baobuibk/SpaceLiinTech_BEE_DAL_OBC_HW/03_BOM/DAL_OBC_V11.xlsx

Line # | Name | Description | Designator | Quantity | Footprint | Manufacturer 1 | Manufacturer Part Number 1
_LED_REDLED_0603 | _LED_RED | LED RED CLEAR 0603 SMD | D3, D17, D25, DS6, D11, D12, DS4, D2, D10, D19, D20, DS5, DS1, DS2, DS3 | 15 | LED_0603 | Wurth Electronics | 150060YS75000 | 0
0RRES_C_1005x30_L | 0R | RES | R3, R4, R8, R32, R36, R263, R264, R265, R266, R267, R317, R413 | 12 | RES_C_1005x30_L | YAGEO | RC0402JR-070RL | RES 0 OHM JUMPER 1/16W 0402
0.1uF/10VCAP_C_0603x30 | 0.1uF/10V | CAP | C20, C21, C22, C23, C24, C25, C26, C27, C28, C29, C30, C31, C32, C33, C35, C36, C37, C38, C39, C40, C41, C42, C43, C44, C45, C46, C47, C48, C49, C52, C53, C54, C56, C58, C59, C60, C63, C66, C67, C68, C77, C78, C79, C80, C81, C82, C83, C84, C85, C86, C87, C88, C89, C90, C91, C92, C93, C94, C96, C97, C98, C99, C100, C101, C102, C103, C104, C105, C106, C107, C109, C110, C111, C112, C113, C114, C116, C117 | 78 | CAP_C_0603x30 | Murata Electronics | GRM033C71C104ME14D | CAP CER 0.1UF 16V X7S 0201
0.1uF/10VCAP_C_1005X50_L | 0.1uF/10V | CAP, CAP CHIP | C5, C6, C17, C18, C57, C69, C71, C72, C73, C74, C75, C119, C122, C123, C124, C125, C126, C127, C128, C129, C132, C133, C134, C135, C136, C138, C146, C147, C148, C149, C150, C151, C153, C154, C164, C165, C167, C168, C170, C171, C180, C213, C214, C215, C216, C217, C218, C219, C220, C221, C222, C224, C249, C250, C251, C252, C253, C254, C256, C257, C260, C261, C262, C281, C283, C284, C285, C287, C288, C289, C290, C292, C293, C294, C295, C296, C297, C298 | 78 | CAP_C_1005X50_L | Samsung Electro-Mechanics | CL05B104KA5NNNC | CAP CER 0.1UF 25V X7R 0402
1kRES_C_1005x30_L | 1k | RES | R5, R159, R160, R230, R231, R232, R244, R246, R247, R318, R320, R327, R356, R369, R381, R382, R404, R419, R423, R428, R431, R455, R518 | 23 | RES_C_1005x30_L | Panasonic | ERJ-2RKF1001X | RES SMD 1K OHM 1% 1/10W 0402
1M 1%RES_C_1005x30_L | 1M 1% | RES | R35 | 1 | RES_C_1005x30_L | YAGEO | RC0402FR-071ML | 1M 0402
1uF/20VCAP_C_1005X50_L | 1uF/20V | CAP CHIP, CAP | C141, C152, C156, C157, C158, C159, C160, C161, C175, C179, C181, C182, C183, C184, C185, C186, C199, C200, C201, C202, C203, C204, C205, C206, C255, C286, C291, C118, C137, C139, C140, C155, C192, C276, C142, C143, C144, C145, C228, C246, C270 | 41 | CAP_C_1005X50_L | Holy Stone Enterprise Co., Ltd. | C0402B105K025T | CAP CER 1UF 25V X5R 0402
1.6kRES_C_1005x30_L | 1.6k | RES | R304, R344, R438, R313, R446 | 5 | RES_C_1005x30_L | Panasonic | ERJ-2RKF1601X | RES SMD 1.6K OHM 1% 1/10W 0402
2.2nF/10VCAP_C_1005X50_L | 2.2nF/10V | CAP | C229, C230, C247, C248, C271, C272, C195, C196, C277, C278 | 10 | CAP_C_1005X50_L | Samsung Electro-Mechanics | CL05B222KB5NNNC | CAP CER 2200PF 50V X7R 0402
3.24kRES_C_1005x30_L | 3.24k | RES | R302, R309, R314, R451, R311, R326, R445 | 7 | RES_C_1005x30_L | Vishay Dale | CRCW04023K24FKED | RES 3.24K OHM 1% 1/16W 0402
4.02kRES_C_1005x30_L | 4.02k | RES | R28 | 1 | RES_C_1005x30_L | Panasonic Industry | ERA-2AEB4021X | RES SMD 4.02KOHM 0.1% 1/16W 0402
4.7kRES_C_1005x30_L | 4.7k | RES | R1, R2, R107, R124, R207, R208, R209, R210, R218, R219, R220, R221, R233, R234, R238, R239, R240, R241, R248, R249, R250, R251, R252, R253, R256, R257, R258, R261, R279, R280, R351, R352, R9, R157, R245, R388, R473, R474, R475, R476, R480, R481, R510, R511 | 44 | RES_C_1005x30_L | Vishay Dale | CRCW04024K70FKED | RES 4.7K OHM 1% 1/16W 0402
4.7nF/50VCAP_C_1608X80 | 4.7nF/50V | CAP | C166 | 1 | CAP_C_1608X80 | Samsung Electro-Mechanics | CL10B472KB8NNNC | CAP CER 4700PF 50V X7R 0603
4.7uF/10VCAP_C_1005X50_L | 4.7uF/10V | CAP | C1, C3, C4, C7, C9, C11, C14, C15, C16, C19, C34, C50, C51, C61, C64, C76, C95, C108, C115, C120, C121, C130, C131, C162, C163, C169, C173, C174, C187, C188, C197, C198, C207, C208, C211, C212, C13, C223, C263, C264, C265, C266 | 42 | CAP_C_1005X50_L | Murata Electronics | GRM155R61A475MEAAD | CAP CER 4.7UF 10V X5R 0402
10kRES_C_1005x30_L | 10k | RES | R6, R7, R10, R11, R14, R16, R20, R38, R60, R79, R80, R113, R114, R117, R134, R136, R144, R145, R153, R154, R155, R161, R162, R163, R164, R165, R166, R167, R168, R169, R170, R171, R172, R225, R226, R229, R254, R255, R290, R291, R310, R316, R319, R321, R337, R342, R345, R346, R347, R349, R350, R357, R406, R408, R409, R416, R417, R420, R424, R429, R432, R443, R452, R504, R505, R506, R507, R421, R425, R426, R464, R479, R484, R487, R488, R491, R494, R497, R500, R508, R509, R516 | 82 | RES_C_1005x30_L | Panasonic | ERJ-2RKF1002X | RES SMD 10K OHM 1% 1/10W 0402
16.9kRES_C_0603x30 | 16.9k | RES | R24, R27 | 2 | RES_C_0603x30 | Panasonic Electronic Components | ERJ-1GNF1692C | RES SMD 16.9K OHM 1% 1/20W 0201
 | 16.5k | RES | R216, R217, R283 | 3 | RES_C_1005x30_L | Panasonic Industry | ERJ-2RKF1652X | RES SMD 16.5K OHM 1% 1/10W 0402
18pF/10VCAP_C_1005X50_L | 18pF/10V | CAP | C55, C62, C65, C70, C238, C240, C242 | 7 | CAP_C_1005X50_L | KEMET | CBR04C180F5GAC | CAP CER 18PF 50V C0G/NP0 0402
20kRES_C_1005x30_L | 20k | RES | R25, R26 | 2 | RES_C_1005x30_L | YAGEO | RC0402FR-0720KL | RES 20K OHM 1% 1/16W 0402
22RRES_C_1005x30_L | 22R | RES | R37, R39, R40, R41, R42, R43, R44, R45, R46, R47, R48, R49, R50, R51, R52, R53, R55, R56, R58, R59, R61, R62, R63, R64, R65, R66, R67, R68, R69, R70, R71, R72, R73, R74, R75, R76, R77, R78, R82, R85, R86, R87, R92, R95, R96, R97, R98, R99, R100, R101, R102, R104, R106, R109, R110, R111, R112, R116, R118, R120, R121, R122, R125, R126, R127, R129, R130, R131, R132, R135, R137, R138, R139, R140, R141, R142, R143, R146, R147, R148, R149, R150, R151, R173, R174, R175, R176, R177, R178, R179, R180, R181, R182, R183, R184, R185, R186, R187, R188, R189, R190, R191, R192, R193, R194, R195, R196, R197, R198, R199, R200, R201, R202, R203, R204, R205, R206, R213, R214, R215, R223, R227, R243, R268, R269, R270, R271, R272, R273, R274, R275, R276, R284, R285, R286, R287, R292, R293, R294, R295, R296, R297, R315, R329, R330, R331, R332, R333, R334, R335, R336, R353, R354, R355, R362, R363, R364, R365, R370, R371, R372, R373, R374, R375, R376, R377, R378, R379, R380, R383, R386, R387, R389, R390, R391, R392, R393, R394, R395, R396, R397, R398, R399, R400, R402, R447, R448, R449, R450, R501, R502, R503, R517, R259, R262, R384, R385, R411, R412, R477, R478, R482, R483, R489, R490, R492, R493, R495, R496, R498, R499, R514, R515 | 213 | RES_C_1005x30_L | Panasonic | RG1005R-220-D-T10 | RES SMD 22 OHM 0.5% 1/16W 0402
22uF/10VCAP_C_1608X80 | 22uF/10V | CAP | C2, C8, C10, C12, C237, C239, C241, C258, C259, C231, C234, C299, C300 | 13 | CAP_C_1608X80 | Murata | GRT188R61A226ME13D | CAP CER 22UF 10V X5R 0603
36kRES_C_1005x30_L | 36k | RES | R301, R436 | 2 | RES_C_1005x30_L | YAGEO | RC0402JR-0736KL | RES 36K OHM 5% 1/16W 0402
47kRES_C_1005x30_L | 47k | RES | R299, R300, R340, R341, R343, R434, R435, R307, R308, R338, R358, R403, R407, R441, R442 | 15 | RES_C_1005x30_L | Panasonic Industry | ERA-2APB473X | RES SMD 47K OHM 0.1% 1/16W 0402
47uF/6.3VCAP_C_1608X80 | 47uF/6.3V | CAP | C172, C177, C178 | 3 | CAP_C_1608X80 | Murata Electronics | GRM188R60J476ME15D | CAP CER 47UF 6.3V X5R 0603
47uF/10VCAP_C_3225X80 | 47uF/10V | CAP CHIP High Value | C189, C190, C191, C273, C274, C275, C225, C226, C227, C232, C233, C235, C236, C267, C268, C269 | 16 | CAP_C_3225X80 | Cal-Chip Electronics, Inc. | GMC32X6S476K10NT | CAP1210 X6S 47UF 10% 10V
47uF/25VCAP_C_3225X80 | 47uF/25V | CAP High Value | C243, C244, C245 | 3 | CAP_C_3225X80 | Taiyo Yuden | TMK325ABJ476MM-T | CAP CER 47UF 25V X5R 1210
60RRES_C_1005x30_L | 60R | RES | R222, R224 | 2 | RES_C_1005x30_L | YAGEO | RC0402FR-0760R4L | RES 60.4 OHM 1% 1/16W 0402
100kRES_C_1005x30_L | 100k | RES | R84, R88, R91, R322, R325, R366, R367, R368, R401, R453 | 10 | RES_C_1005x30_L | Panasonic | ERJ-2RKF1003X | RES 100K OHM 1% 1/10W 0402
100RRES_C_1005x30_L | 100R | RES | R454 | 1 | RES_C_1005x30_L | Vishay Dale | CRCW0402100RFKEDHP | RES SMD 100 OHM 1% 1/5W 0402
100uF/6.3VCAP_C_2012X110 | 100uF/6.3V | CAP | C176, C193, C194, C209, C210 | 5 | CAP_C_2012X110 | Murata Electronics | GRM21BR60J107ME15K | CAP CER 100UF 6.3V X5R 0805
120RRES_C_1005x30_L | 120R | RES | R228 | 1 | RES_C_1005x30_L | Panasonic | ERA-2AEB121X | RES SMD 120 OHM 0.1% 1/16W 0402
120RRES_C_1005x30_L | 120R | RES | R418, R422, R427, R430 | 4 | RES_C_1005x30_L | Panasonic | ERA-2AEB121X | RES SMD 120 OHM 0.1% 1/16W 0402
133kRES_C_1005x30_L | 133k | RES | R303, R312, R437, R444 | 4 | RES_C_1005x30_L | Panasonic Industry | ERJ-U02F1333X | RES 133K OHM 1% 1/10W 0402
150kRES_C_1005x30_L | 150k | RES | R324 | 1 | RES_C_1005x30_L | TE Connectivity Passive Product | CPF0402B150KE1
187kRES_C_1005x30_L | 187k | RES | R323 | 1 | RES_C_1005x30_L | RMCF0402FT187K | RMCF0402FT187K | RES 187K OHM 1% 1/16W 0402
200RRES_C_0603X30 | 200R | RES | R19, R22, R23 | 3 | RES_C_0603X30 | Yageo Group | AC0201FR-07200RL | RES SMD 200 OHM 1% 1/20W 0201
240RRES_C_0603X30 | 240R | RES | R156, R158 | 2 | RES_C_0603X30 | Stackpole Electronics | RMCF0201FT240R | RES 240 OHM 1% 1/20W 0201
316kRES_C_1005x30_L | 316k | RES | R328 | 1 | RES_C_1005x30_L | RC0402FR-13316KL | RC0402FR-13316KL | RES 316K OHM 1% 1/16W 0402
402kRES_C_1005x30_L | 402k | RES | R242 | 1 | RES_C_1005x30_L | RC0402FR-07402KL | RC0402FR-07402KL | RES 402K OHM 1% 1/16W 0402
470kRES_C_1005x30_L | 470k | RES | R298, R306, R339, R433, R440 | 5 | RES_C_1005x30_L | TE Connectivity Passive Product | CRGCQ0402F470K | RES 470K OHM 1% 1/16W 0402
600 Ohms @ 100 MHzIND_C_1608X60 | 600 Ohms @ 100 MHz | FERRITE BEAD 600 OHM 0603 1LN | FB1 | 1 | IND_C_1608X60 | Murata Electronics | BLM18PG121SN1D | FERRITE BEAD 120 OHM 0603 1LN
3035BAT_3035 | 3035 | Battery Clip; THM; 20mm Cell; PhosBronze/Nickel | Keystone Electronics 3035 | BT1 | 1 | BAT_3035 | Keystone Electronics | 3035
047346000147346-0001_MOL | 0473460001 | No Description Available | J3 | 1 | 47346-0001_MOL | Molex | 0473460001
0532610471MOLEX_0532610471 | 0532610471 |  | J4, J10 | 2 | MOLEX_0532610471 | Molex | 0532610471
0532610671MOLEX_0532610671 | 0532610671 |  | J5, J6, J14, J15 | 4 | MOLEX_0532610671 | Molex | 0532610671
0532611171MOLEX_0532611171 | 0532611171 |  | J8, J12, J16, J17 | 4 | MOLEX_0532611171 | Molex | 0532611171
5040500891MOLEX_5040500891 | 5040500891 |  | J18 | 1 | MOLEX_5040500891 | Molex | 5040500891
5090500991MOLEX_5040500991 | 5090500991 |  | J7 | 1 | MOLEX_5040500991 | Molex | 5090500991
BME688IC_BME688 | BME688 | Gas sensor measuring relative humidity, barometric pressure, ambient temperature and gas (VOC) | U9 | 1 | IC_BME688 |  | BME688
BSS138NH6327XTSA2SOT-23-3 | BSS138NH6327XTSA2 | Transistor MOS | Q1 | 1 | SOT-23-3 | Infineon | BSS138NH6327XTSA2
CAT93C46BHU4I-GT3CAT93C46BHU4I-GT3 | CAT93C46BHU4I-GT3 | EEPROM Memory IC 1Kb (128 x 8, 64 x 16) SPI 4 MHz 8-UDFN-EP (2x3) | U17 | 1 | CAT93C46BHU4I-GT3 | CAT93C46BHU4I-GT3 | CAT93C46BHU4I-GT3
Crystal 2 PinsCRYSTAL_NX2012SA | Crystal 2 Pins | Crystal | Y1 | 1 | CRYSTAL_NX2012SA | NDK | NX2012SA-32.768K-STD-MUB-1
Crystal 4 PinsCRYSTAL_ABM8G | Crystal 4 Pins | Crystal | Y3 | 1 | CRYSTAL_ABM8G | Abracon | ABM8G-24.000MHZ-18-D2Y-T
DFE252012P-1R5M=P2IND_C_1008 | DFE252012P-1R5M=P2 | Inductor | L1, L2, L3, L4, L5, L6, L7 | 7 | IND_C_1008 | Murata | DFE252012P-1R5M=P2
DMG301NU-7SOT95P240X120-3N | DMG301NU-7 |  | Q2, Q3, Q4, Q5, Q8, Q9, Q10, Q11, Q12 | 9 | SOT95P240X120-3N | Diodes Incorporated | DMG301NU-7
ESQ-126-14-G-DSAMTEC_ESQ-126-14-G-D | ESQ-126-14-G-D | CONN SOCKET 52POS 0.1 GOLD PCB | H1, H2 | 2 | SAMTEC_ESQ-126-14-G-D | Samtec Inc. | ESQ-126-14-G-D
FSUSB74MPXQFN50P300X300X80-17N | FSUSB74MPX | USB Switch IC 1 Channel 16-MLP (3x3) | U32 | 1 | QFN50P300X300X80-17N | onsemi | FSUSB74MPX
IP4220CZ6SOT95P280X145-6N | IP4220CZ6 |  | U7, U8 | 2 | SOT95P280X145-6N | Nexperia | IP4220CZ6F
IS43TR16512BL-125KBLITWBGA96_ISI | IS43TR16512BL-125KBLI | DDR3L | U4 | 1 | TWBGA96_ISI | ISSI, Integrated Silicon Solution Inc | IS43TR16512BL-125KBLI
KRL1632E-M-R010-F-T5RES_C_1206_SHUNT | KRL1632E-M-R010-F-T5 | Shunt | R12, R15, R17, R18, R81, R83, R103, R105 | 8 | RES_C_1206_SHUNT | Susumu | KRL1632E-M-R010-F-T5
LM1117MP-3.3/NOPBVREG_LM1117MP-3.3/NOPB | LM1117MP-3.3/NOPB | 800-mA 15-V linear voltage regulator | VR1, VR2 | 2 | VREG_LM1117MP-3.3/NOPB | Texas Instruments | LM1117MP-3.3/NOPB
LTC2865HMSE#TRPBFMSOP-12_MSE_LIT | LTC2865HMSE#TRPBF | Â±60V Fault Protected 3V to 5.5V RS485/RS422 Transceivers | U23 | 1 | MSOP-12_MSE_LIT | Analog Devices Inc. | LTC2865HMSE#TRPBF
LTC3569EUDC#TRPBFQFN20_UDC_3X4_ADI | LTC3569EUDC#TRPBF | Triple Buck Regulator with 1.2A and Two 600mA Outputs and Individual Programmable References | IC1 | 1 | QFN20_UDC_3X4_ADI | Analog Devices Inc. | LTC3569EUDC#TRPBF
MAX3485CSA+T21-0041-3-M_90-0096-8L_MXM | MAX3485CSA+T | Low-Power, Slew-Rate-Limited RS-485/RS-422 Transceivers, IC TRANSCEIVER HALF 1/1 8SOIC | U28 | 1 | 21-0041-3-M_90-0096-8L_MXM | Analog Devices Inc./Maxim Integrated | MAX3485CSA+T
MCP16502 QFN-32QFN-32_5X5_EP3.7X3.7 | MCP16502 QFN-32 |  | U1 | 1 | QFN-32_5X5_EP3.7X3.7 | Microchip | MCP16502TAB-E/S8B
MIC2026-1YMSOIC127P602X173-8N | MIC2026-1YM | Power Switch/Driver 1:2 N-Channel 1.25A 8-SOIC | U10, U20, U40 | 3 | SOIC127P602X173-8N | Microchip Technology | MIC2026-1YM
MMBT2222ASOT95P240X120-3N | MMBT2222A |  | Q6, Q7 | 2 | SOT95P240X120-3N | Diotec Semiconductor | MMBT2222A
MMBT2907SOT95P240X120-3N | MMBT2907 |  | Q16 | 1 | SOT95P240X120-3N | Shenzhen Slkormicro Semicon Co., Ltd. | MMBT2907
Molex_1051620001Molex_1051620001 | Molex_1051620001 | 9 (8 + 1) Position Card Connector Secure Digital - microSDâ„¢ Surface Mount, Right Angle Gold | J1 | 1 | Molex_1051620001 | Molex | 1051620001
MTFC16GAKAEDQ-AIT TRBGA_100_C_100P_10X17_1400X1800X150 | MTFC16GAKAEDQ-AIT TR |  | U5 | 1 | BGA_100_C_100P_10X17_1400X1800X150 | Micron Technology Inc. | MTFC16GAKAEDQ-AIT TR
OPA2340UASOIC127P602X173-8N | OPA2340UA |  | U41, U42 | 2 | SOIC127P602X173-8N | Texas Instruments | OPA2340UA
PAC1934 UQFN-16UQFN-16_4X4_EP2.6X2.6 | PAC1934 UQFN-16 |  | U2, U6 | 2 | UQFN-16_4X4_EP2.6X2.6 | Microchip | PAC1934T-I/JQ
PCA9508DP,118TSOP8 | PCA9508DP,118 |  | U38, U39, U43 | 3 | TSOP8 | NXP USA Inc. | PCA9508DP,118
PI3WVR626XEBEXPI3WVR626XEBEX_DIO | PI3WVR626XEBEX | PI3WVR626XEBEX | U37 | 1 | PI3WVR626XEBEX_DIO | Diodes Incorporated | PI3WVR626XEBEX
RV-3129-C3-32.768KHZ-OPTION-A-TB-QAIC_RV-3129-C3-32.768KHZ-OPTION-A-TB-QA | RV-3129-C3-32.768KHZ-OPTION-A-TB-QA | Real-Time Clock Module with I2C-Bus | U15 | 1 | IC_RV-3129-C3-32.768KHZ-OPTION-A-TB-QA | Micro Crystal AG | RV-3129-C3-32.768KHZ-OPTION-A-TB-QA
S25FL128LAGMFI010SOIC8_S25FL_CYP | S25FL128LAGMFI010 | Description | U18 | 1 | SOIC8_S25FL_CYP | Infineon Technologies | S25FL128LAGMFI010
SAMA7G54TFBGA-343_14x14 - 2.5mm | SAMA7G54 | SAMA7G54 MPU 1000MHz Cortex-A7 TFBGA-343 | U3 | 1 | TFBGA-343_14x14 - 2.5mm | Microchip | SAMA7G54-V/4HB
SIT8924BA-11-33E-100.000000CRYSTAL_ABM8G | SIT8924BA-11-33E-100.000000 | Oscillator MEMS 100MHz ±20ppm (Stability) 15pF HCMOS/LVCMOS 55% 2.5V/2.8V/3V/3.3V Medical 4-Pin QFN SMD T/R | X1 | 1 | CRYSTAL_ABM8G | SiTime | SIT8924BA-11-33E-100.000000
SN65C3232PWRSOP65P640X120-16N | SN65C3232PWR | 2/2 Transceiver Full RS232 16-TSSOP 1GHz | U35 | 1 | SOP65P640X120-16N | Texas Instruments | SN65C3232PWR
SN65HVD230DRSOIC127P602X173-8N | SN65HVD230DR | 3.3 V CAN Transceiver with Standby Mode | U21, U22 | 2 | SOIC127P602X173-8N | Texas Instruments | SN65HVD230DR
SN74AXCH8T245PWRSOP65P640X120-24N | SN74AXCH8T245PWR | 8-Bit Dual-Supply Bus Transceiver | U26, U27, U31 | 3 | SOP65P640X120-24N | Texas Instruments | SN74AXCH8T245PWR
SN74LV4052APWRSOP65P640X120-16N | SN74LV4052APWR | 5-V, 4:1, 2-channel analog multiplexer | U19 | 1 | SOP65P640X120-16N | Texas Instruments | SN74LV4052APWR
SN3257QPWRQ1SOIC_PRQ1_TEX | SN3257QPWRQ1 | Automotive 5-V, 2:1 (SPDT), 4-channel switch with 1.8-V logic and powered-off protection 16-TSSOP -40 to 125 | U13, U14 | 2 | SOIC_PRQ1_TEX | Texas Instruments | SN3257QPWRQ1
SS54DO-214AC_SMA | SS54 | DIODE SCHOTTKY | D1, D9, D15, D16, D18 | 5 | DO-214AC_SMA | EVVO | SS54
TC1047AVNBTRSOT-23-3 | TC1047AVNBTR | SENSOR ANALOG -40C-125C SOT23-3 | U12 | 1 | SOT-23-3 | Microchip Technology | TC1047AVNBTR
TLV75518PDBVRSOT25 | TLV75518PDBVR |  | U44 | 1 | SOT25 | Texas Instruments | TLV75518PDBVR
TPL5010DDCRTPL5010DDCR | TPL5010DDCR | OSC PROG TIMER TSOT23-6 | U16 | 1 | TPL5010DDCR | Texas Instruments | TPL5010DDCR
TPS259470ARPWRVQFN-HR-10 | TPS259470ARPWR |  | U24, U25, U33 | 3 | VQFN-HR-10 | Texas Instruments | TPS259470ARPWR
TPS259470ARPWRVQFN-HR-10 | TPS259470ARPWR |  | U30, U34 | 2 | VQFN-HR-10 | Texas Instruments | TPS259470ARPWR
USBLC6-2SC6SOT95P280X145-6N | USBLC6-2SC6 | 17V Clamp 5A (8/20Âµs) Ipp Tvs Diode Surface Mount SOT-23-6 | D6, D7, D8, D13, D14 | 5 | SOT95P280X145-6N | Shenzhen Slkormicro Semicon Co., Ltd. | USBLC6-2SC6
XC7A35T-1FTG256CFTG256 | XC7A35T-1FTG256C | Artix-7 FPGA, 170 User I/Os, 0 GTP, 256-Ball BGA, Speed Grade 1, Commercial Grade, Pb-Free | U11 | 1 | FTG256 | AMD | XC7A35T-1FTG256C
DNP list | DNP list
DNP/0RRES_C_1608X60 | DNP/0R |  | JP6, JP13, JP14 | 3 | RES_C_1608X60
DNP/0RJUMPER_1-2_1608X60 | DNP/0R |  | JP7 | 1 | JUMPER_1-2_1608X60
DNP/0RJUMPER_1608 | DNP/0R |  | JP8, JP9, JP12 | 3 | JUMPER_1608
DNP/0RRES_C_1005x30_L | DNP/0R | RES | R30, R33, R34 | 3 | RES_C_1005x30_L
DNP/0RRES_C_1005x30_L | DNP/0R | RES | R288, R289, R414, R415 | 4 | RES_C_1005x30_L
DNP/0RRES_C_1005X40 | DNP/0R | RES | R485, R486 | 2 | RES_C_1005X40
DNP/1M 1%RES_C_1005x30_L | DNP/1M 1% | RES | R31 | 1 | RES_C_1005x30_L
DNP/4.7kRES_C_1005x30_L | DNP/4.7k | RES | R54, R57, R211, R212, R235, R260, R277, R278, R281, R282 | 10 | RES_C_1005x30_L
DNP/4.7kRES_C_1005x30_L | DNP/4.7k | RES | R359, R360, R361 | 3 | RES_C_1005x30_L
DNP/4.7kRES_C_1005X40 | DNP/4.7k | RES | R410, R512, R513 | 3 | RES_C_1005X40
DNP/10kRES_C_1005x30_L | DNP/10k | RES | R13, R21, R89, R90, R93, R94, R108, R115, R119, R123, R128, R133, R152, R305, R348, R405, R439, R456, R457, R458 | 20 | RES_C_1005x30_L
DNP/22RRES_C_1005x30_L | DNP/22R | RES | R29 | 1 | RES_C_1005x30_L
DNP/120RRES_C_1005x30_L | DNP/120R | RES | R236, R237 | 2 | RES_C_1005x30_L
DNP/AS3004204-0108X0PSAYSOIC127P790X216-8 | DNP/AS3004204-0108X0PSAY |  | U29 | 1 | SOIC127P790X216-8
DNP/DSC10xx DFN-4DFN-4_2.5x2 | DNP/DSC10xx DFN-4 |  | Y2 | 1 | DFN-4_2.5x2
DNP/DSC60xx DFN-4_LGA-4DFN-4_2x1.6 | DNP/DSC60xx DFN-4_LGA-4 |  | Y4 | 1 | DFN-4_2x1.6
JUMPER_1608 |  |  | JP1, JP2, JP3, JP4, JP5, JP10, JP11 | 7 | JUMPER_1608
Header 4x1Header_254P_4x1 | Header 4x1 |  | J9, J11, J20 | 3 | Header_254P_4x1
Header 8x1Header_254P_8x1 | Header 8x1 |  | J2 | 1 | Header_254P_8x1
Header 8x1PAD JTAG 1.27 | Header 8x1 |  | J13 | 1 | PAD JTAG 1.27
hole_spaceHEX-M3_NoVia | hole_space |  | Hole1, Hole2, Hole3, Hole4 | 4 | HEX-M3_NoVia
JUMPERJUMPER_1608 | JUMPER |  | SB1, SB2, SB3, SB4, SB6 | 5 | JUMPER_1608
