baobuibk/SpaceLiinTech_BEE_DAL_OBC_HW/02_Sche_PDF/DAL_OBC_V110.pdf

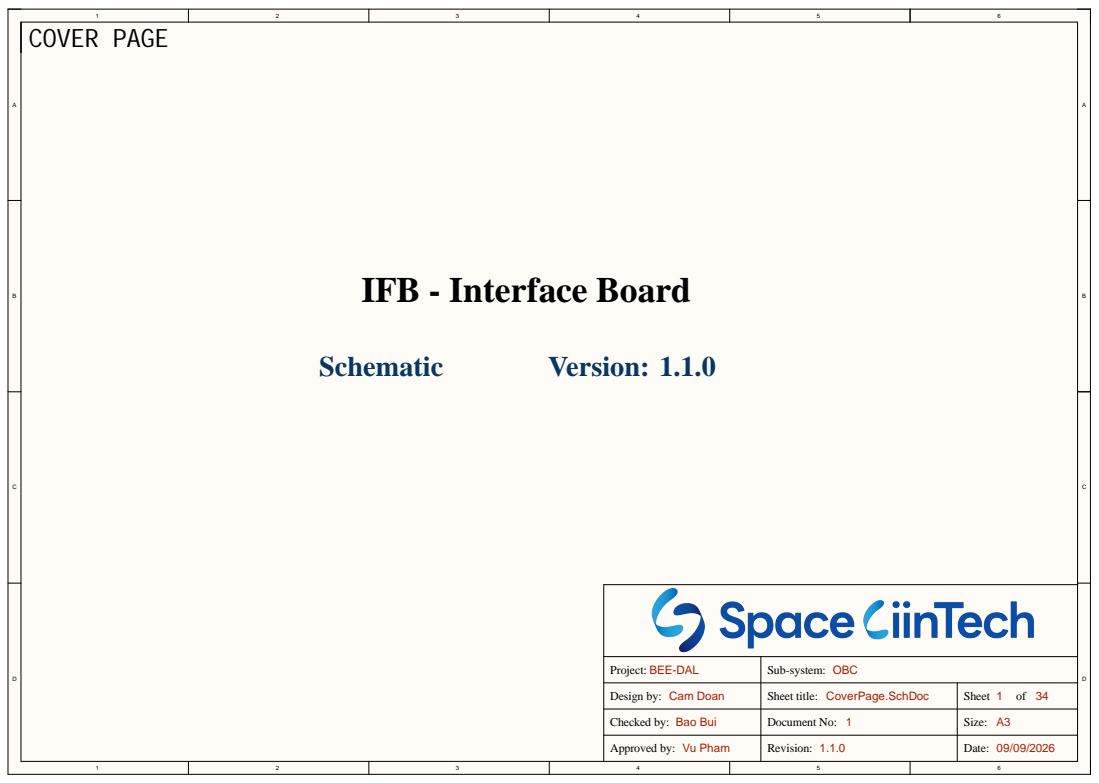
[picture p25: page 1]

Project: BEE-DAL | Sub-system: OBC

Design by: Cam Doan | Sheet title: CoverPage.SchDoc | Sheet 1 of 34

Checked by: Bao Bui | Document No: 1 | Size: A3

Approved by: Vu Pham | Revision: 1.1.0 | Date: 09/09/2026

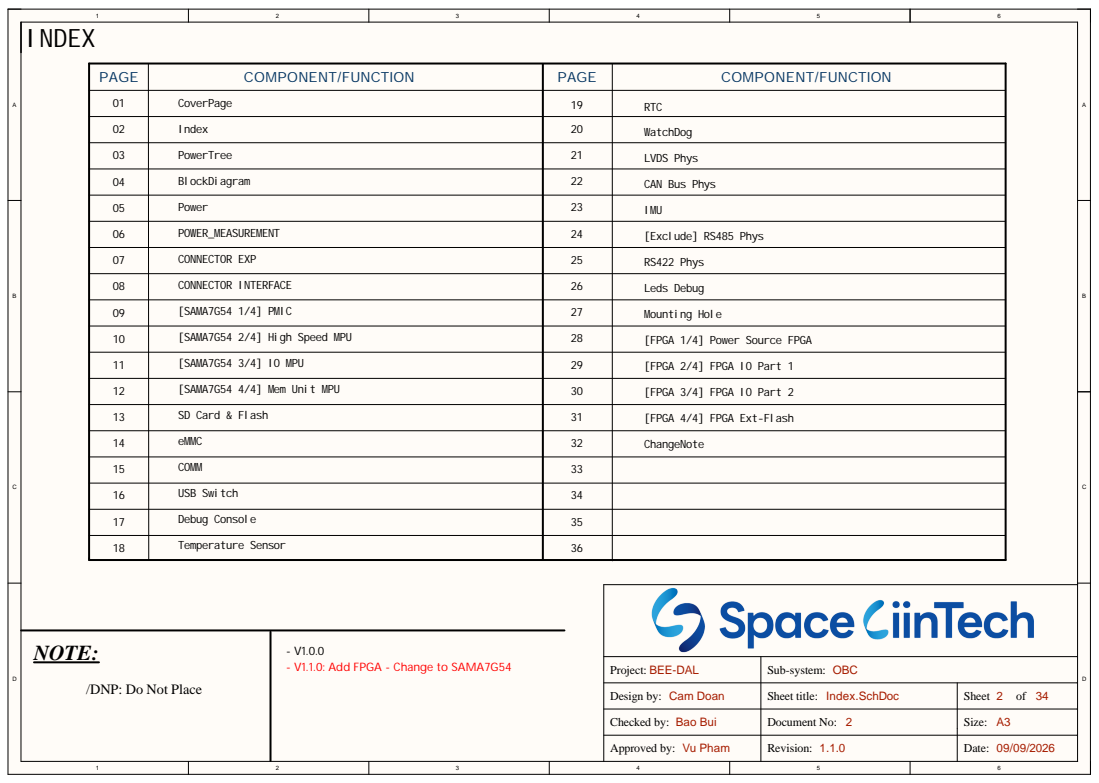
[picture p26: page 2]

PAGE | COMPONENT/FUNCTION | PAGE | COMPONENT/FUNCTION

01 | CoverPage | 19 | RTC

02 | Index | 20 | WatchDog

03 | PowerTree | 21 | LVDS Phys

04 | BlockDiagram | 22 | CAN Bus Phys

05 | Power | 23 | IMU

06 | POWER_MEASUREMENT | 24 | [Exclude] RS485 Phys

07 | CONNECTOR EXP | 25 | RS422 Phys

08 | CONNECTOR INTERFACE | 26 | Leds Debug

09 | [SAMA7G54 1/4] PMIC | 27 | Mounting Hole

10 | [SAMA7G54 2/4] High Speed MPU | 28 | [FPGA 1/4] Power Source FPGA

11 | [SAMA7G54 3/4] IO MPU | 29 | [FPGA 2/4] FPGA IO Part 1

12 | [SAMA7G54 4/4] Mem Unit MPU | 30 | [FPGA 3/4] FPGA IO Part 2

13 | SD Card & Flash | 31 | [FPGA 4/4] FPGA Ext-Flash

14 | eMMC | 32 | ChangeNote

15 | COMM | 33

16 | USB Switch | 34

17 | Debug Console | 35

18 | Temperature Sensor | 36

- V1.1.0: Add FPGA - Change to SAMA7G54

Project: BEE-DAL | Sub-system: OBC

/DNP: Do Not Place

Design by: Cam Doan | Sheet title: Index.SchDoc | Sheet 2 of 34

Checked by: Bao Bui | Document No: 2 | Size: A3

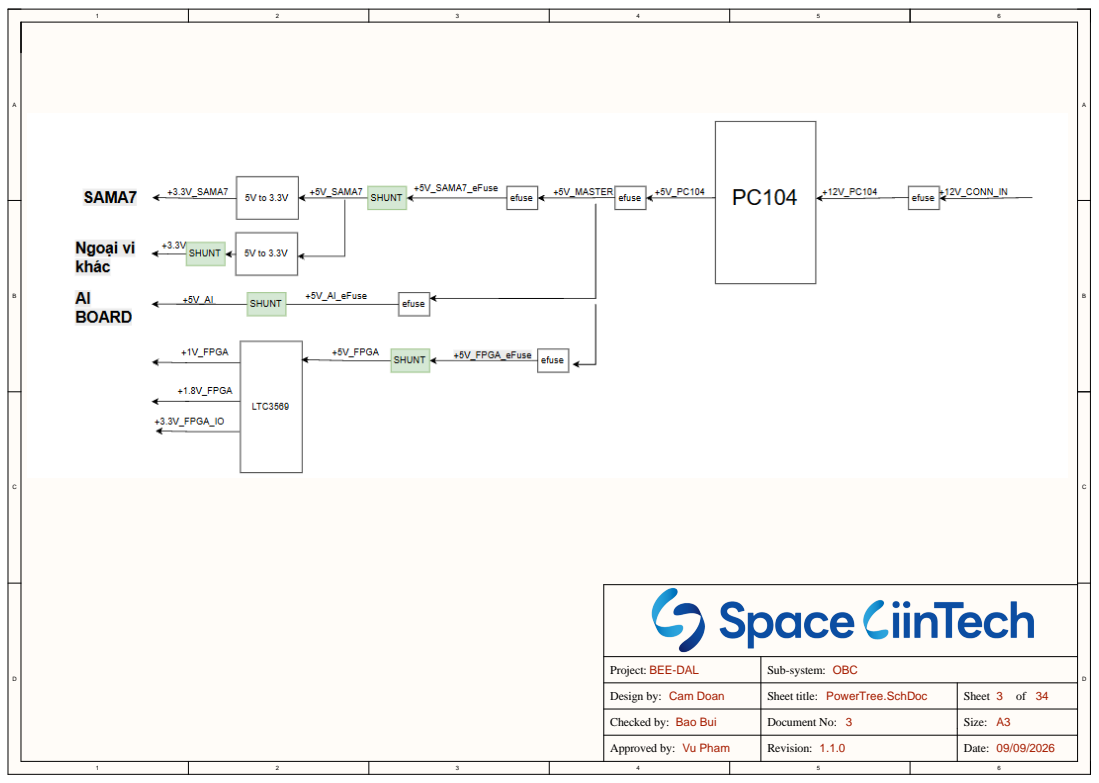
[picture p27: page 3]

Project: BEE-DAL | Sub-system: OBC

Design by: Cam Doan | Sheet title: PowerTree.SchDoc | Sheet 3 of 34

Checked by: Bao Bui | Document No: 3 | Size: A3

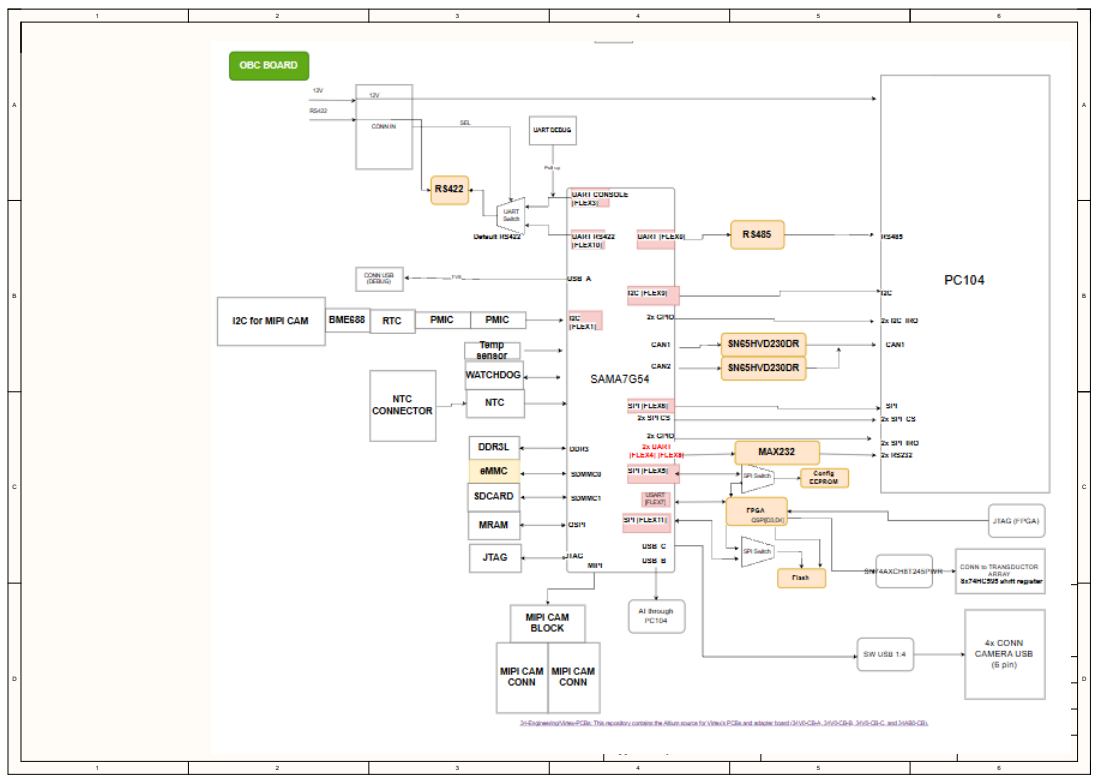
[picture p28: page 4]

Project: BEE-DAL | Sub-system: OBC

Design by: Cam Doan | Sheet title: BlockDiagram.SchDoc | Sheet 4 of 34

Checked by: Bao Bui | Document No: 4 | Size: A3

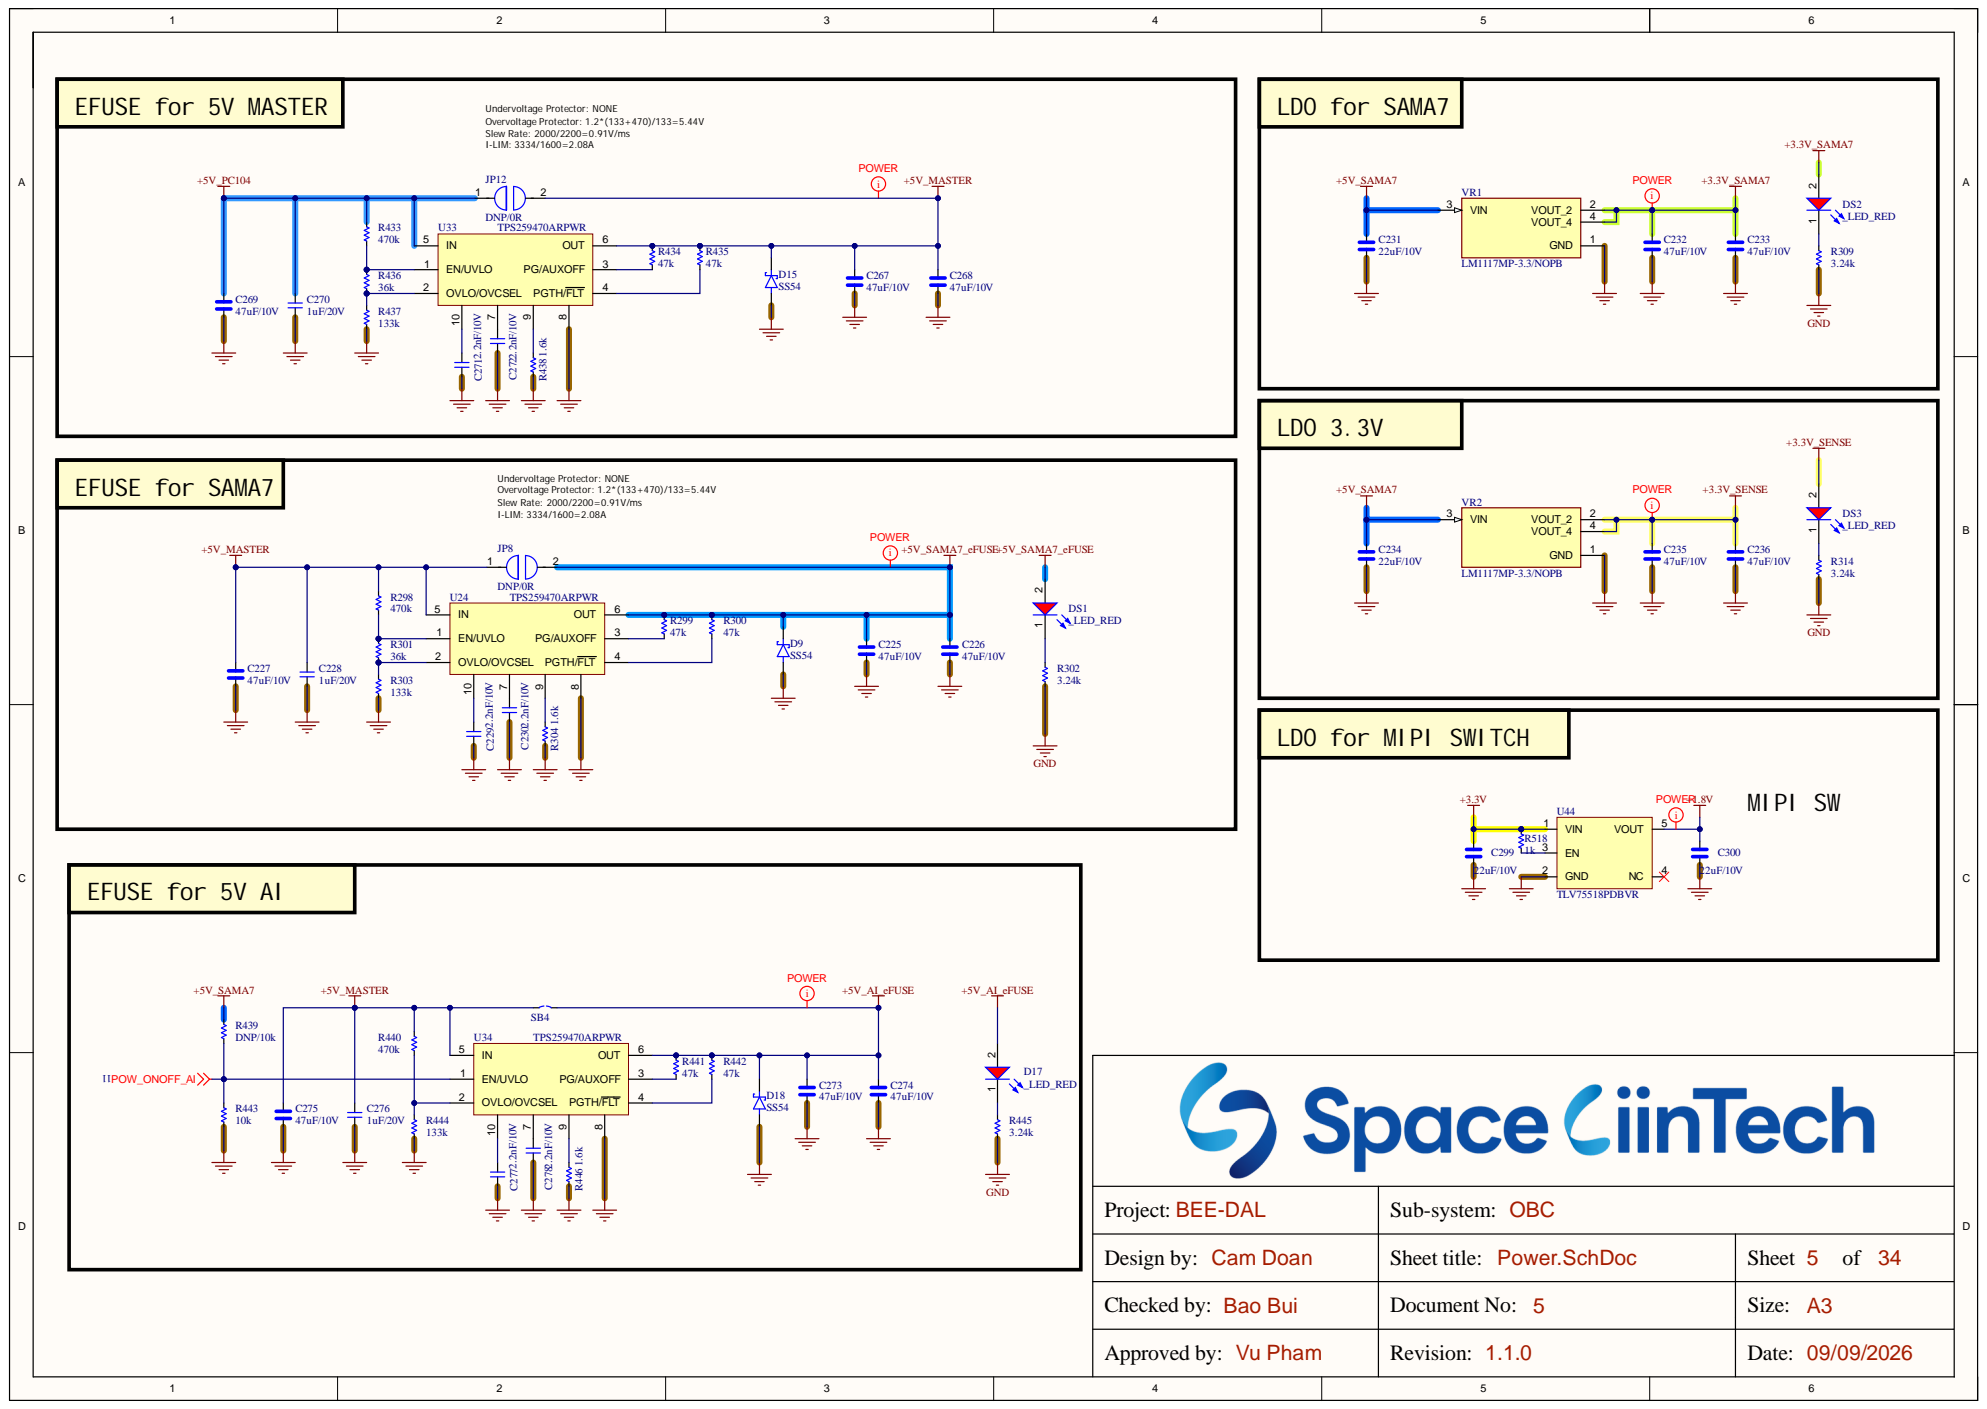
[picture p29: page 5]

LDO for MIPI SWITCH

Projec t : BEE-DAL | Sub-syste m : OBC

Design by: Cam Do a n | Sheet title: Powe r.Sc hDo c | Shee t 5 of 3 4

Checked by: Ba o Bu i | Document No: 5 | Size : A3

V u Ph a m | Revisio n : 1.1 . | Date : 9/0

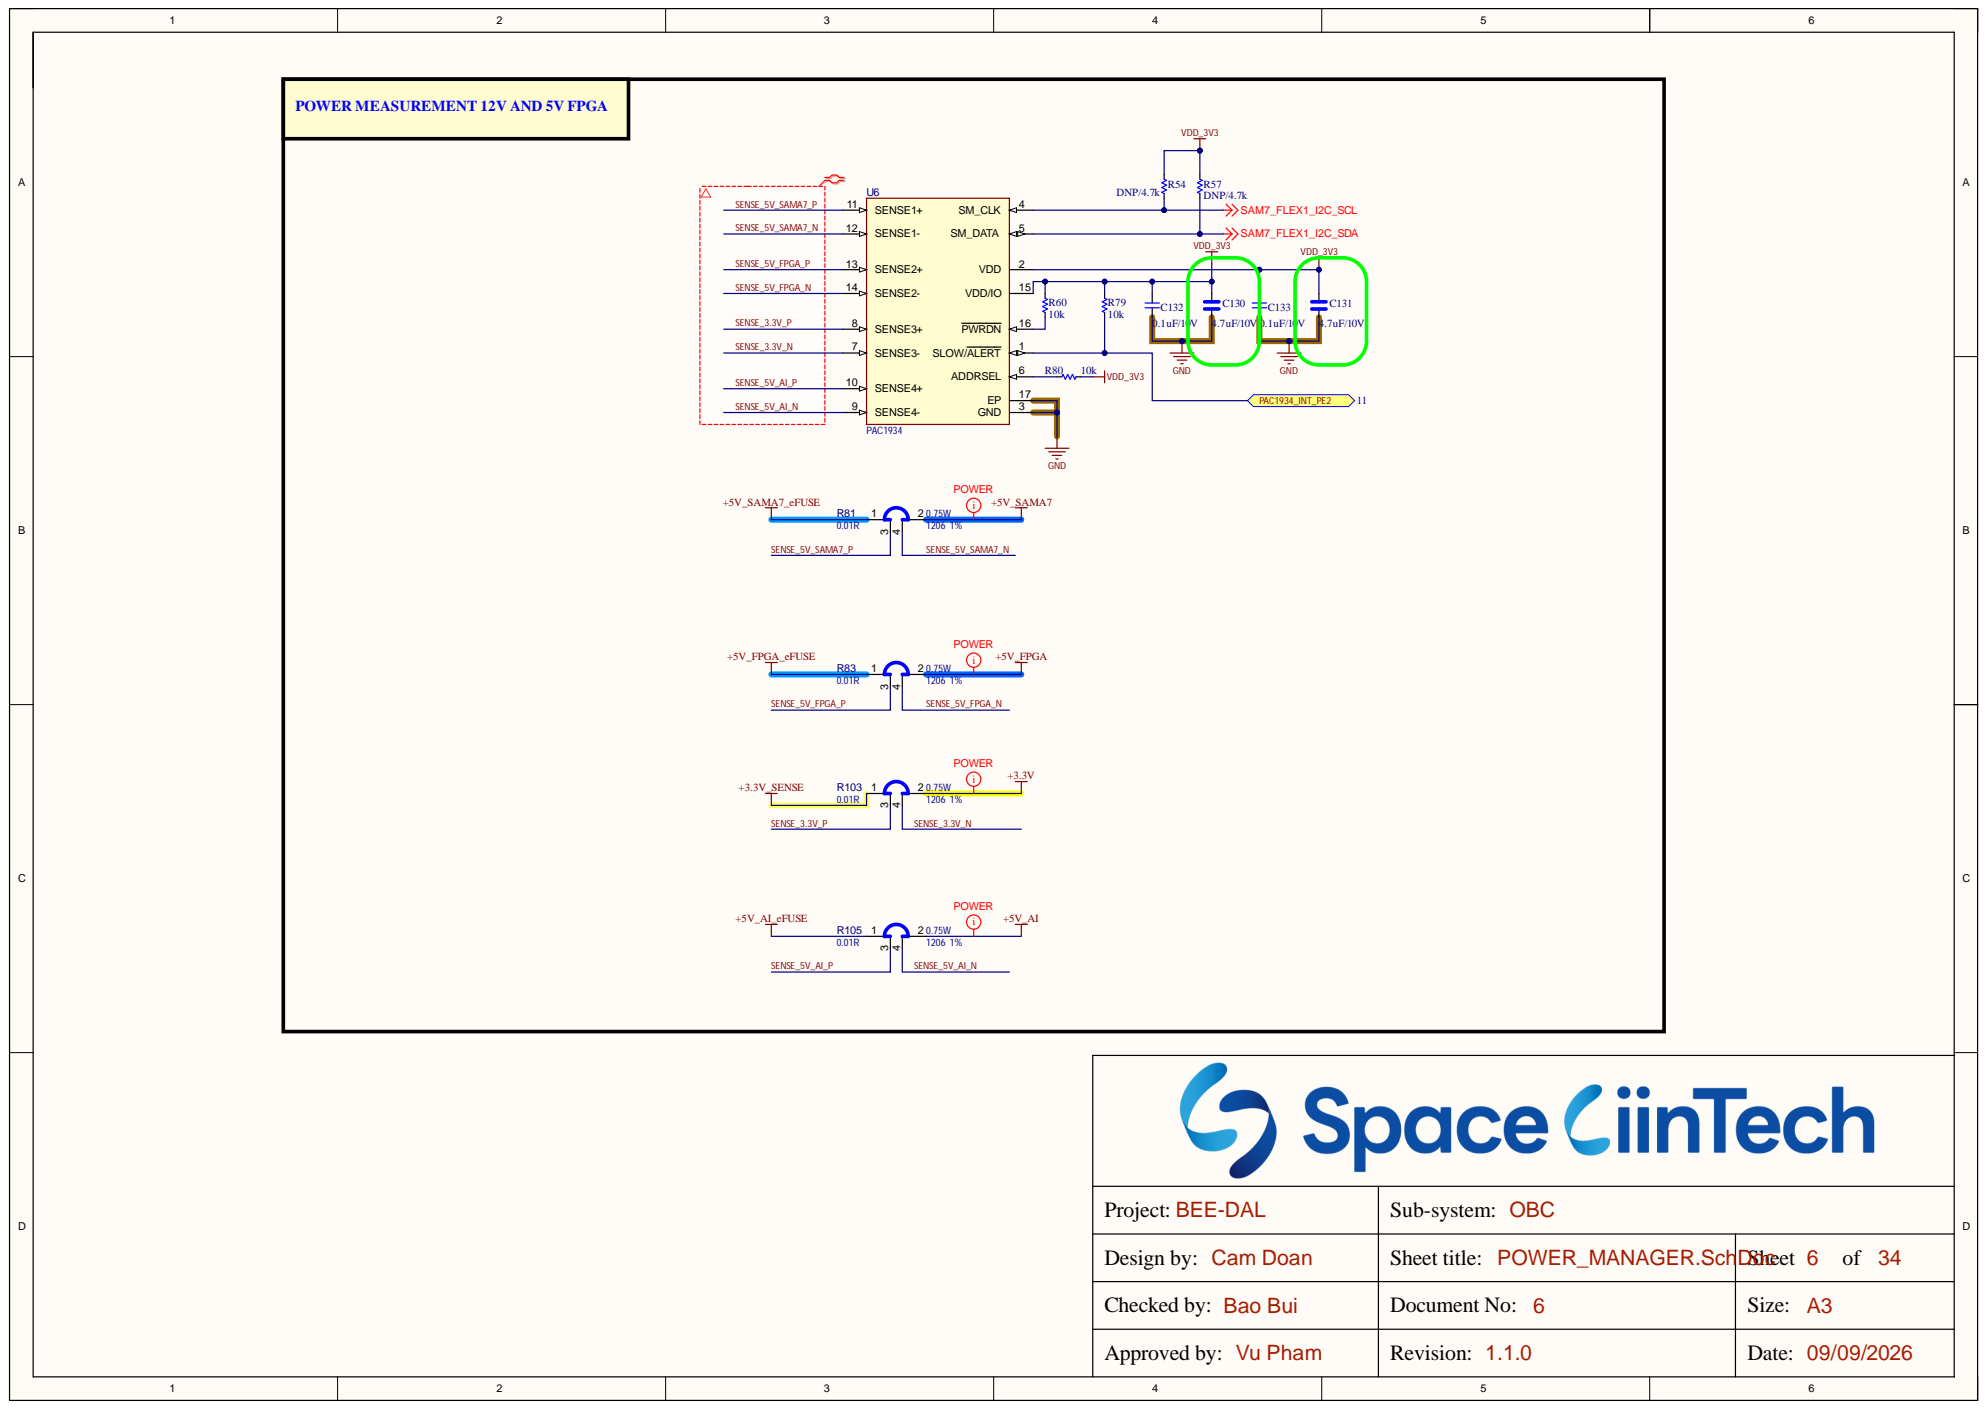
[picture p30: page 6]

POWER MEASUREMENT 12V AND 5V FPGA

SENSE_3.3V_P | SENSE_3.3V_N

Project: BEE-DAL | Sub-system: OBC

Design by: Cam Doan | Sheet title: POWER_MANAGER.SchDoc | Sheet 6 of 34

Checked by: Bao Bui | Document No: 6 | Size: A3

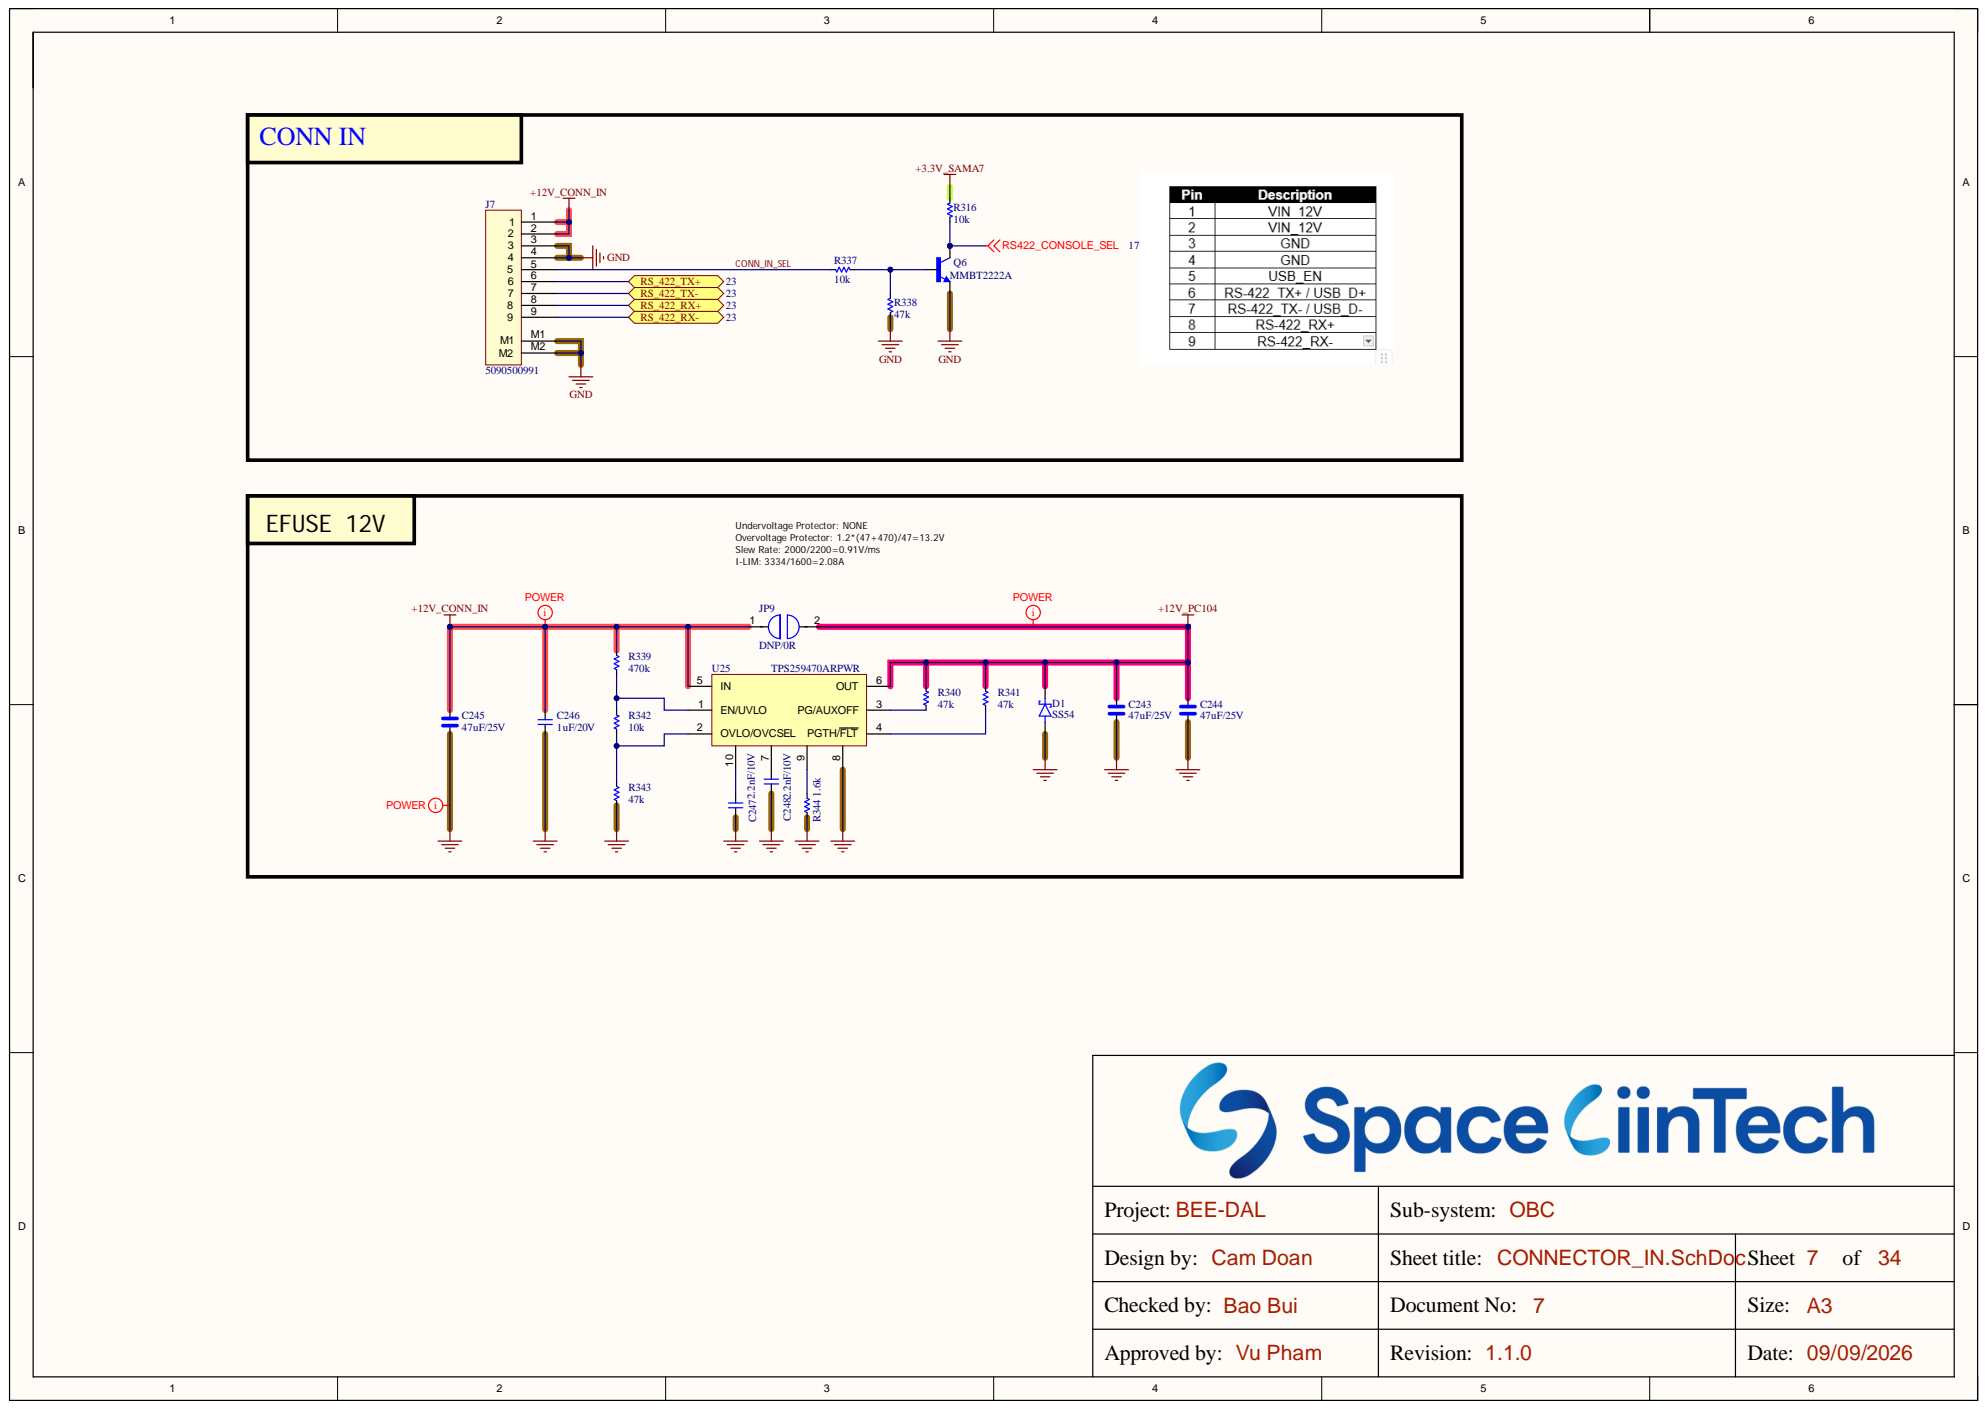
[picture p31: page 7]

Project: BEE-DAL | Sub-system: OBC

Design by: Cam Doan | Sheet title: CONNECTOR_IN.SchDoc | Sheet 7 of 34

Checked by: Bao Bui | Document No: 7 | Size: A3

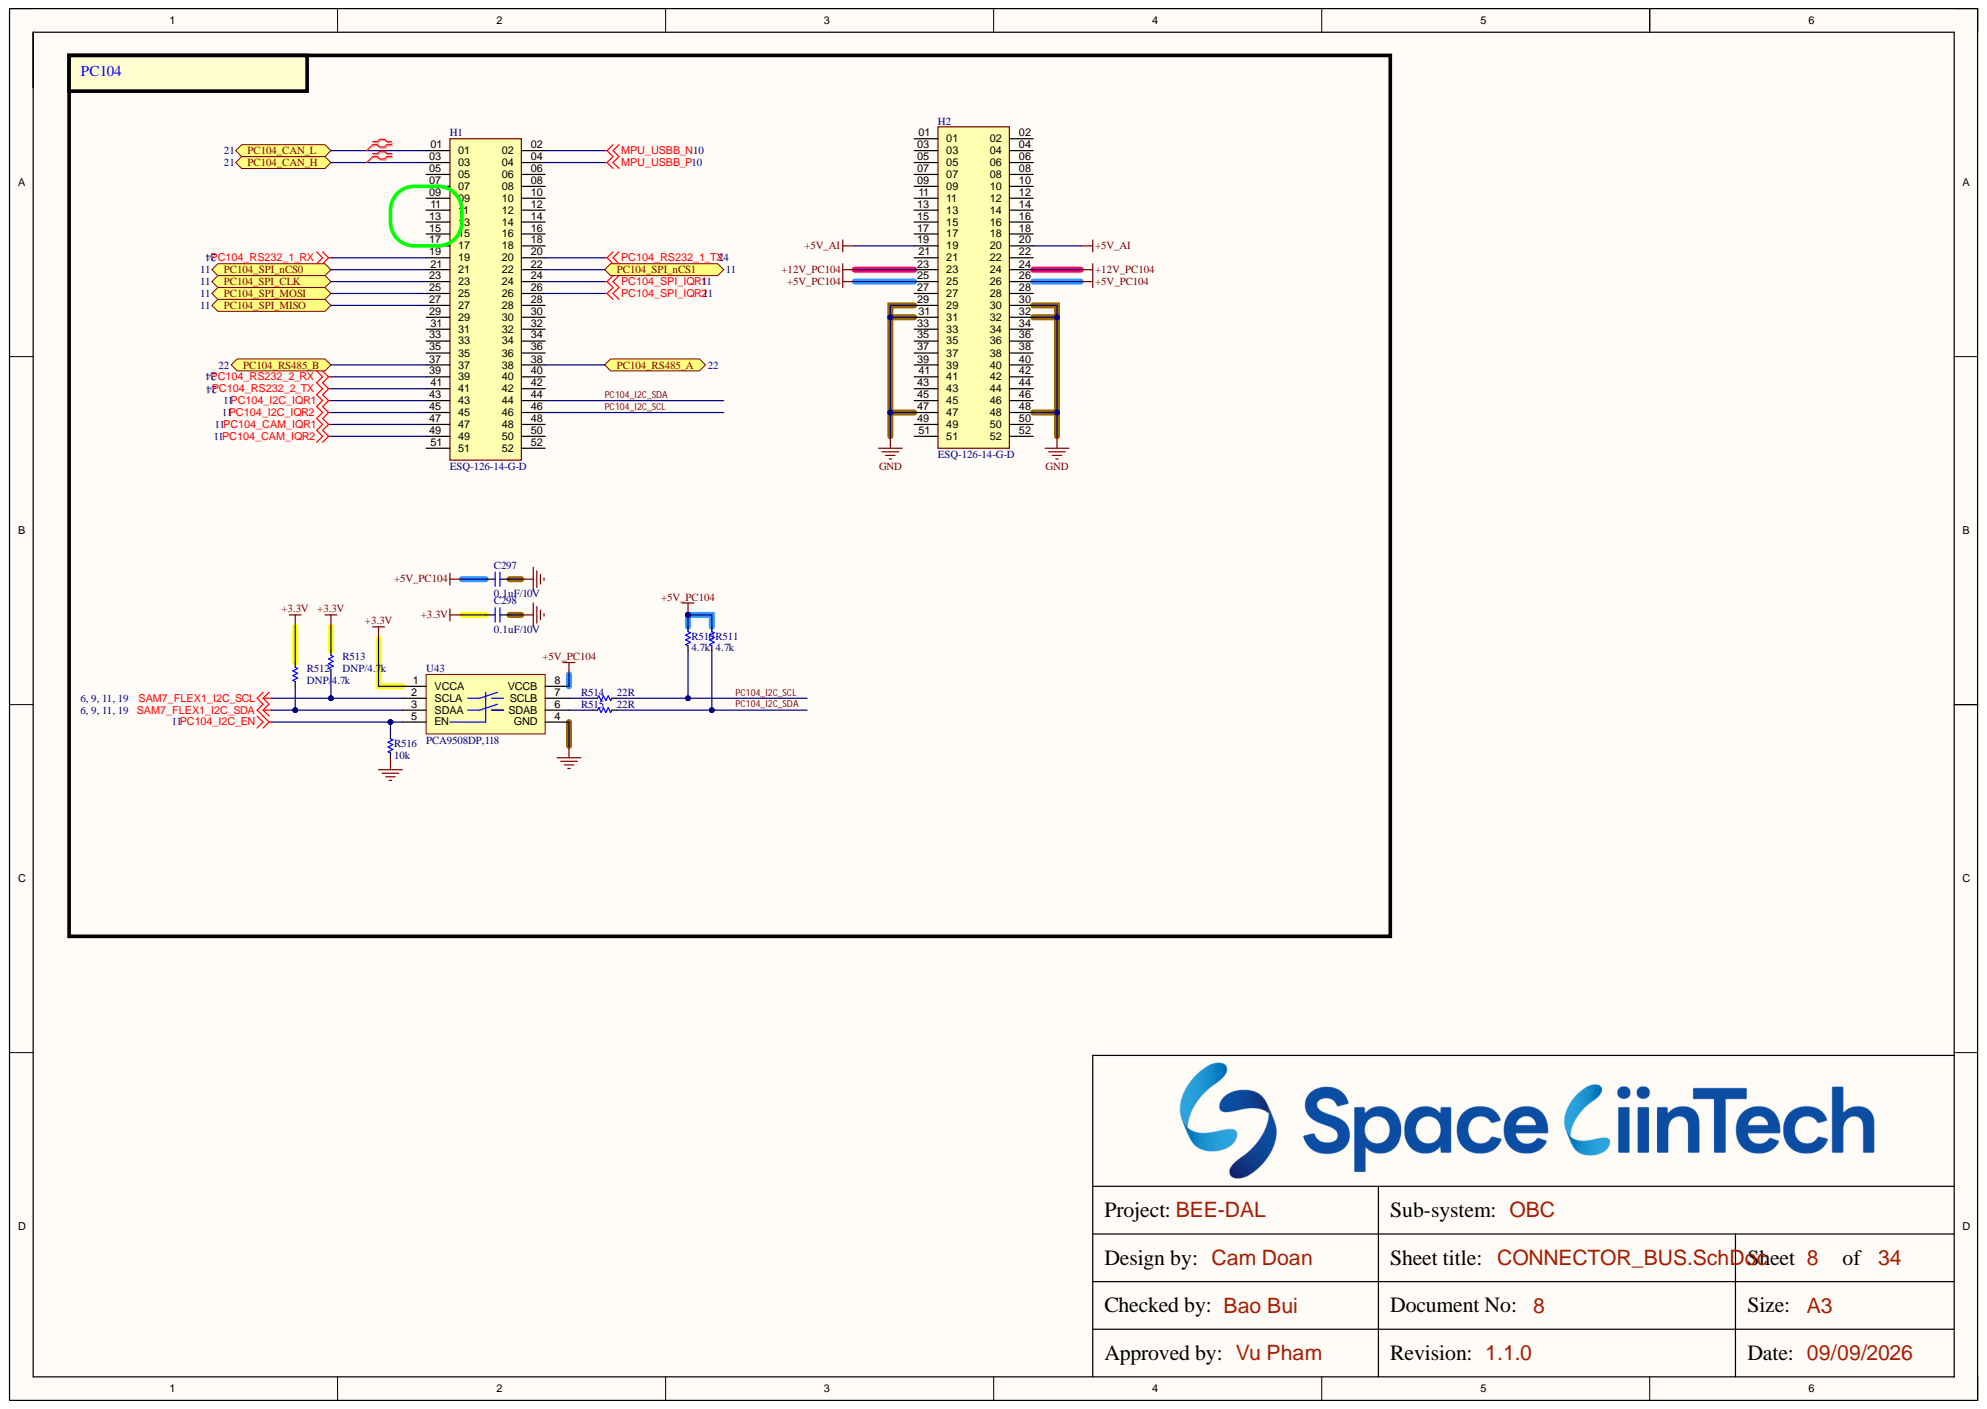
[picture p32: page 8]

Project: BEE-DAL | Sub-system: OBC

Design by: Cam Doan | Sheet title: CONNECTOR_BUS.SchDoc | Sheet 8 of 34

Checked by: Bao Bui | Document No: 8 | Size: A3

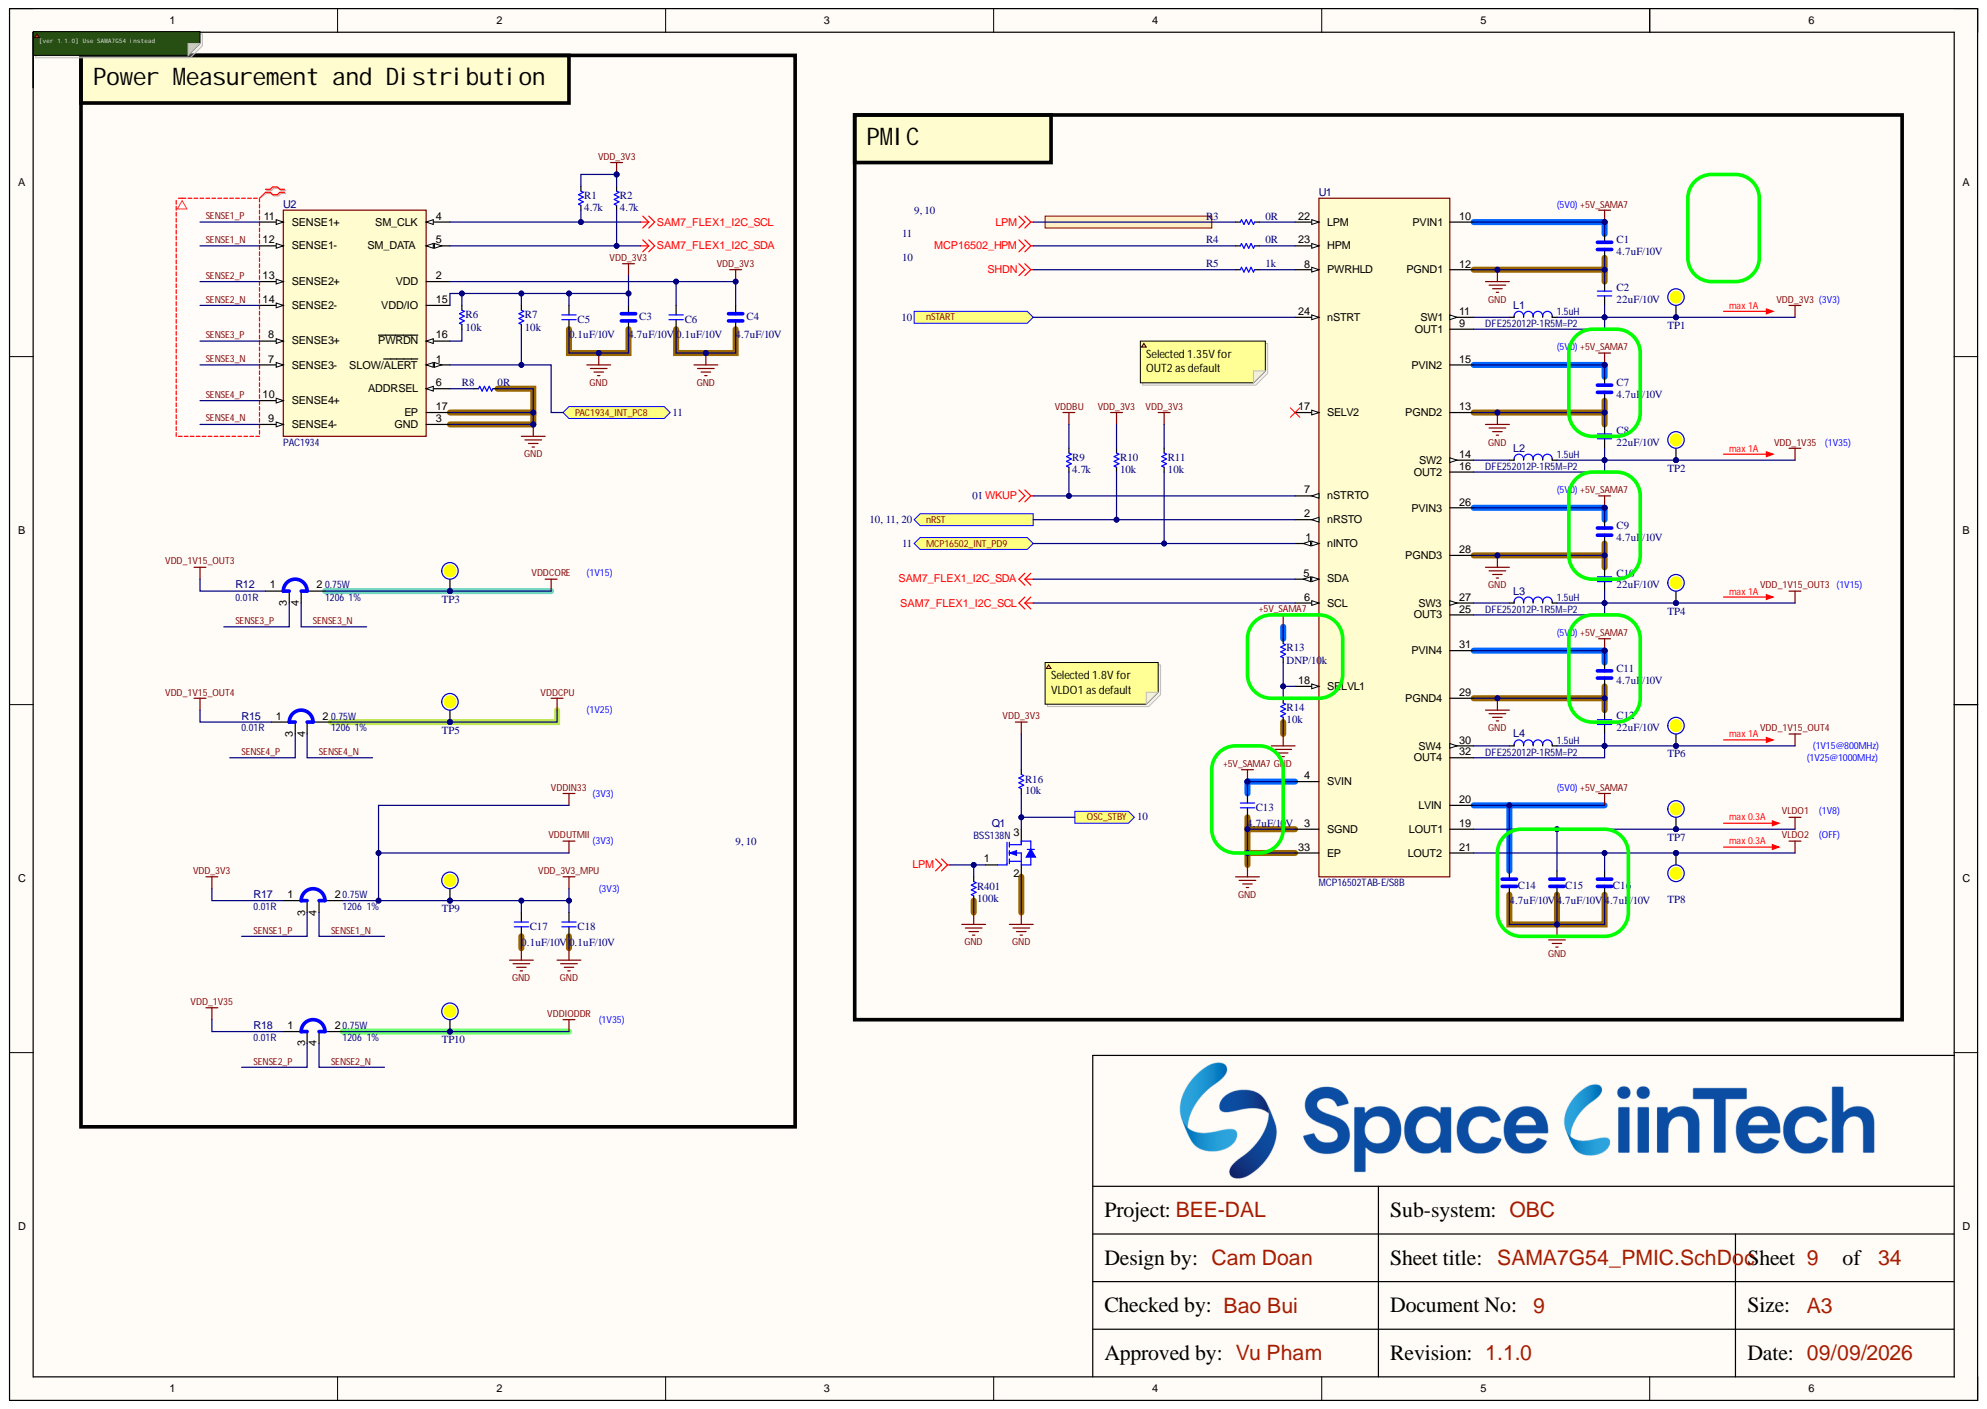
[picture p33: page 9]

Power Measurement and Distribution

max 1A max 1A max 1A max 0.3A max 0.3A max 1A

Projec t : BEE-DAL | Sub-syste m : OBC

Design by: Cam Do a n | Sheet title: SAMA7G5 4 _PMIC.Sc hDo | c Shee t 9 of 3 4

Checked by: Ba o Bu i | Document No: 9 | Size : A3

V u Ph a m | Revisio n : 1.1 . | Date : 9/0

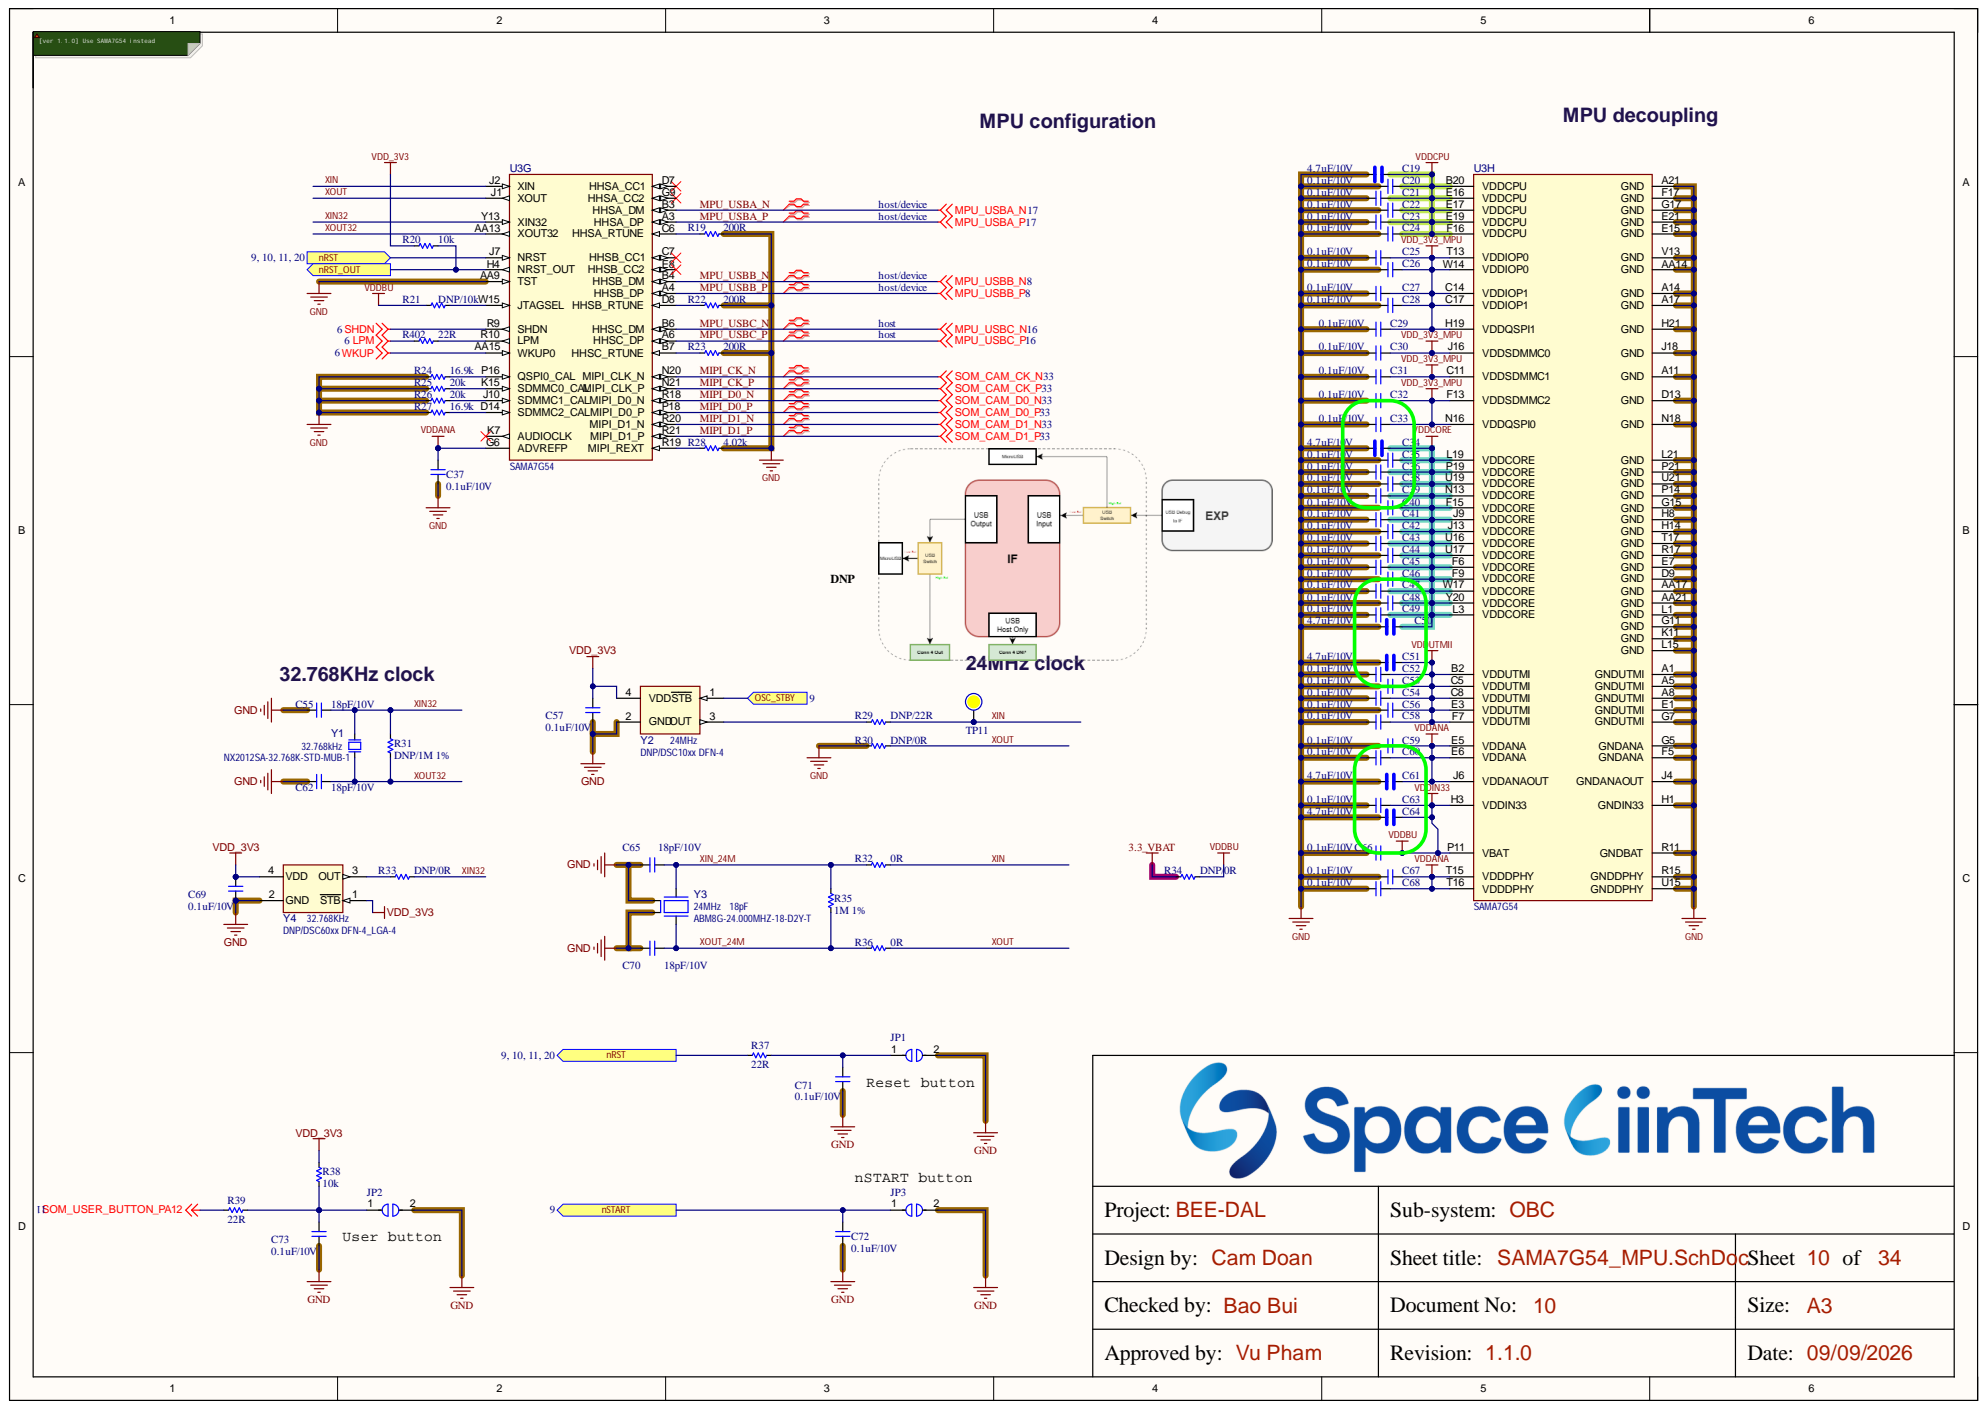
[picture p34: page 10]

0.1uF/ 1 0V | C38 | | 1
0.1uF/ 1 0V | C39 | | 4
0.1uF/ 1 0V | C40 | | 5
0.1uF/ 1 0V | C41 | | H 8
0.1uF/ 1 0V | C42 | | 4
0.1uF/ 1 0V | C43 | | T17 7 GND
0.1uF/ 1 0V | C44
0.1uF/ 1 0V | C45
0.1uF/ 1 0V | C46 | | D 9
0.1uF/ 1 0V | C47 | | 7
0.1uF/ 1 0V | C48 | | 1
0.1uF/ 1 0V | C49
4.7uF/ 1 0V | C50 | MII | 1

0.1uF/ 1 0V | C52
0.1uF/ 1 0V | C53 | C 5

Projec t : BEE-DAL | Sub-syste m : OBC

t o n | D GND | D GND

Design by: Cam Do a n | Sheet title: SAMA7G5 4 _MPU.Sc hDo | c Shee t 1 0 of 3 4

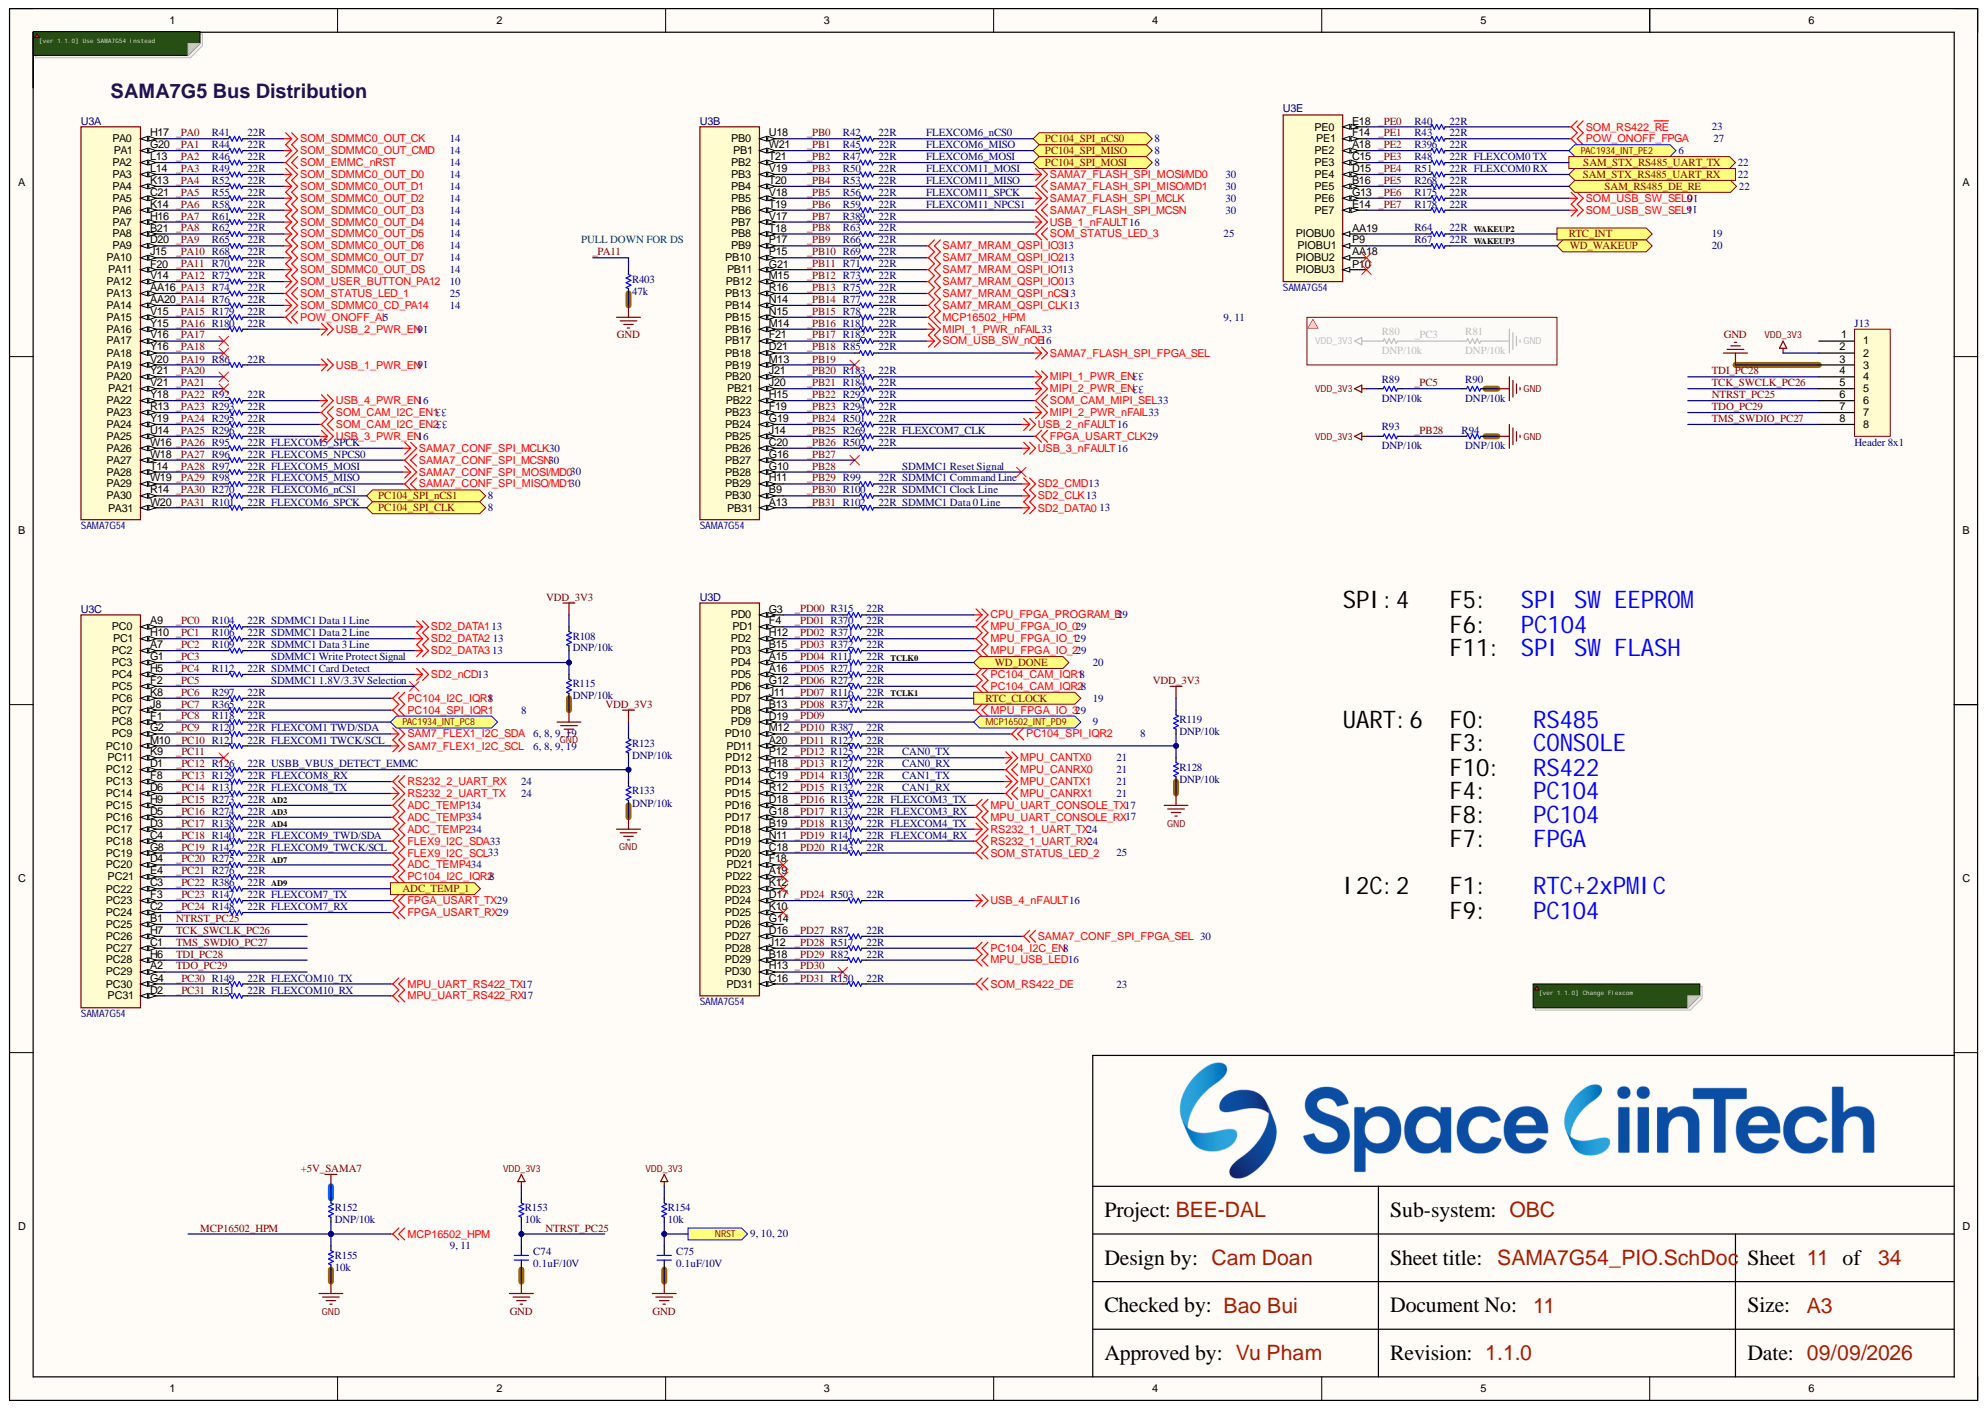
[picture p35: page 11]

PULL DOWN FOR DS

Projec t : BEE-DAL | Sub-syste m : OBC

Design by: Cam Do a n | Sheet title: SAMA7G5 4 _PIO.Sc hDo c | Shee t 1 1 of 3 4

Checked by: Ba o Bu i | Document No: 1 1 | Size : A3

V u Ph a m | Revisio n : 1.1 . | Date : 9/0

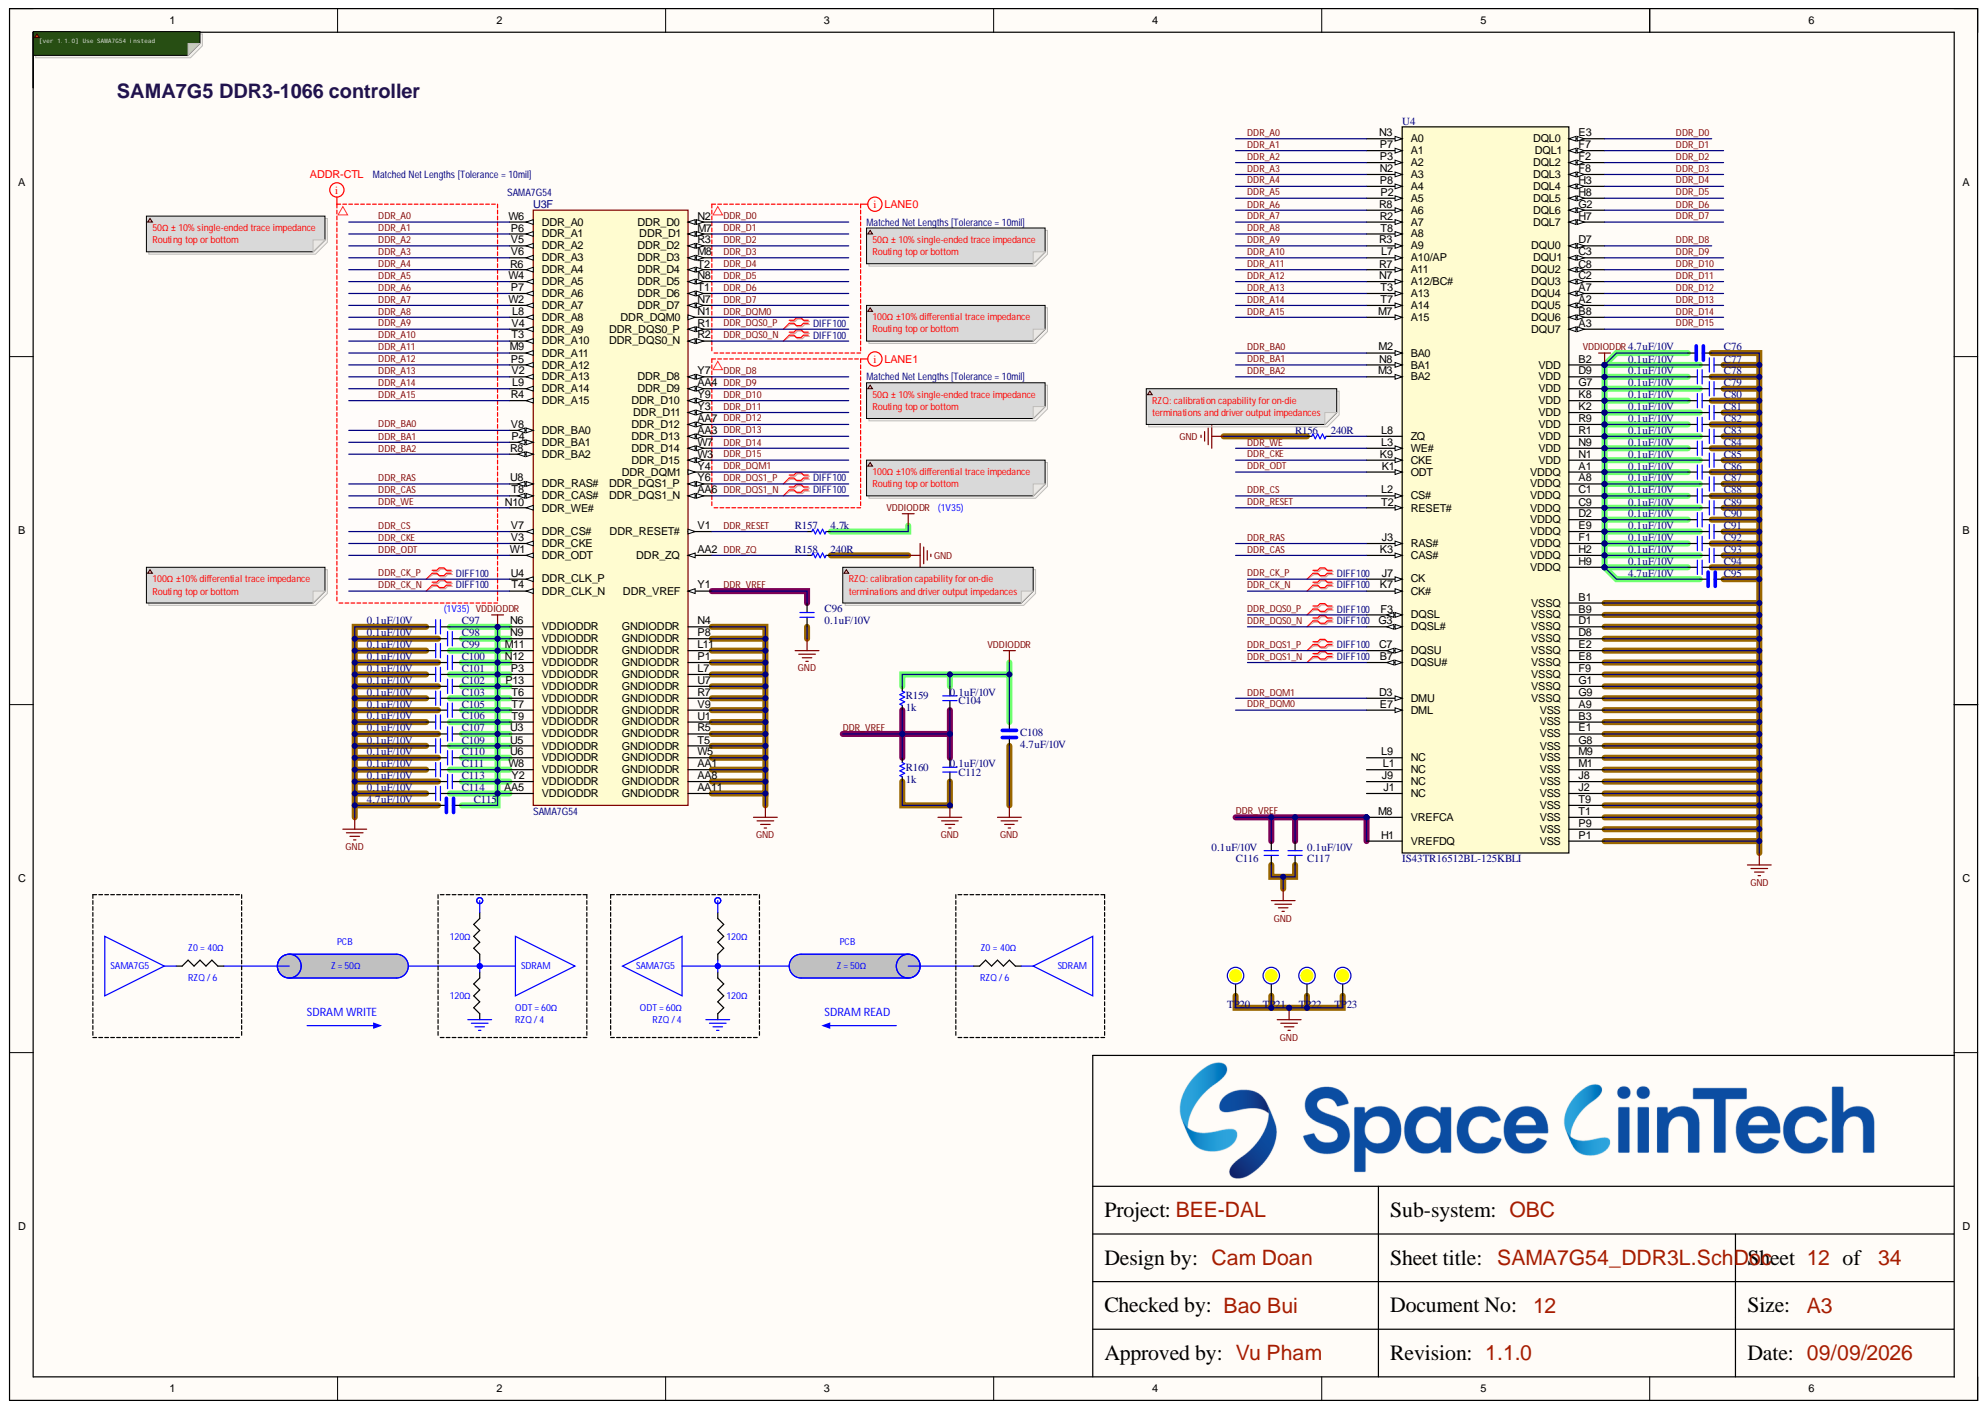
[picture p36: page 12]

Matched Net Lengths [Tolerance = 1

Projec t : BEE-DAL | Sub-syste m : OBC

Design by: Cam Do a n | Sheet title: SAMA7G5 4 _DDR3 L.Sc hDo | Shee c t 1 2 of 3 4

Checked by: Ba o Bu i | Document No: 1 2 | Size : A3

V u Ph a m | Revisio n : 1.1 . | Date : 9/0

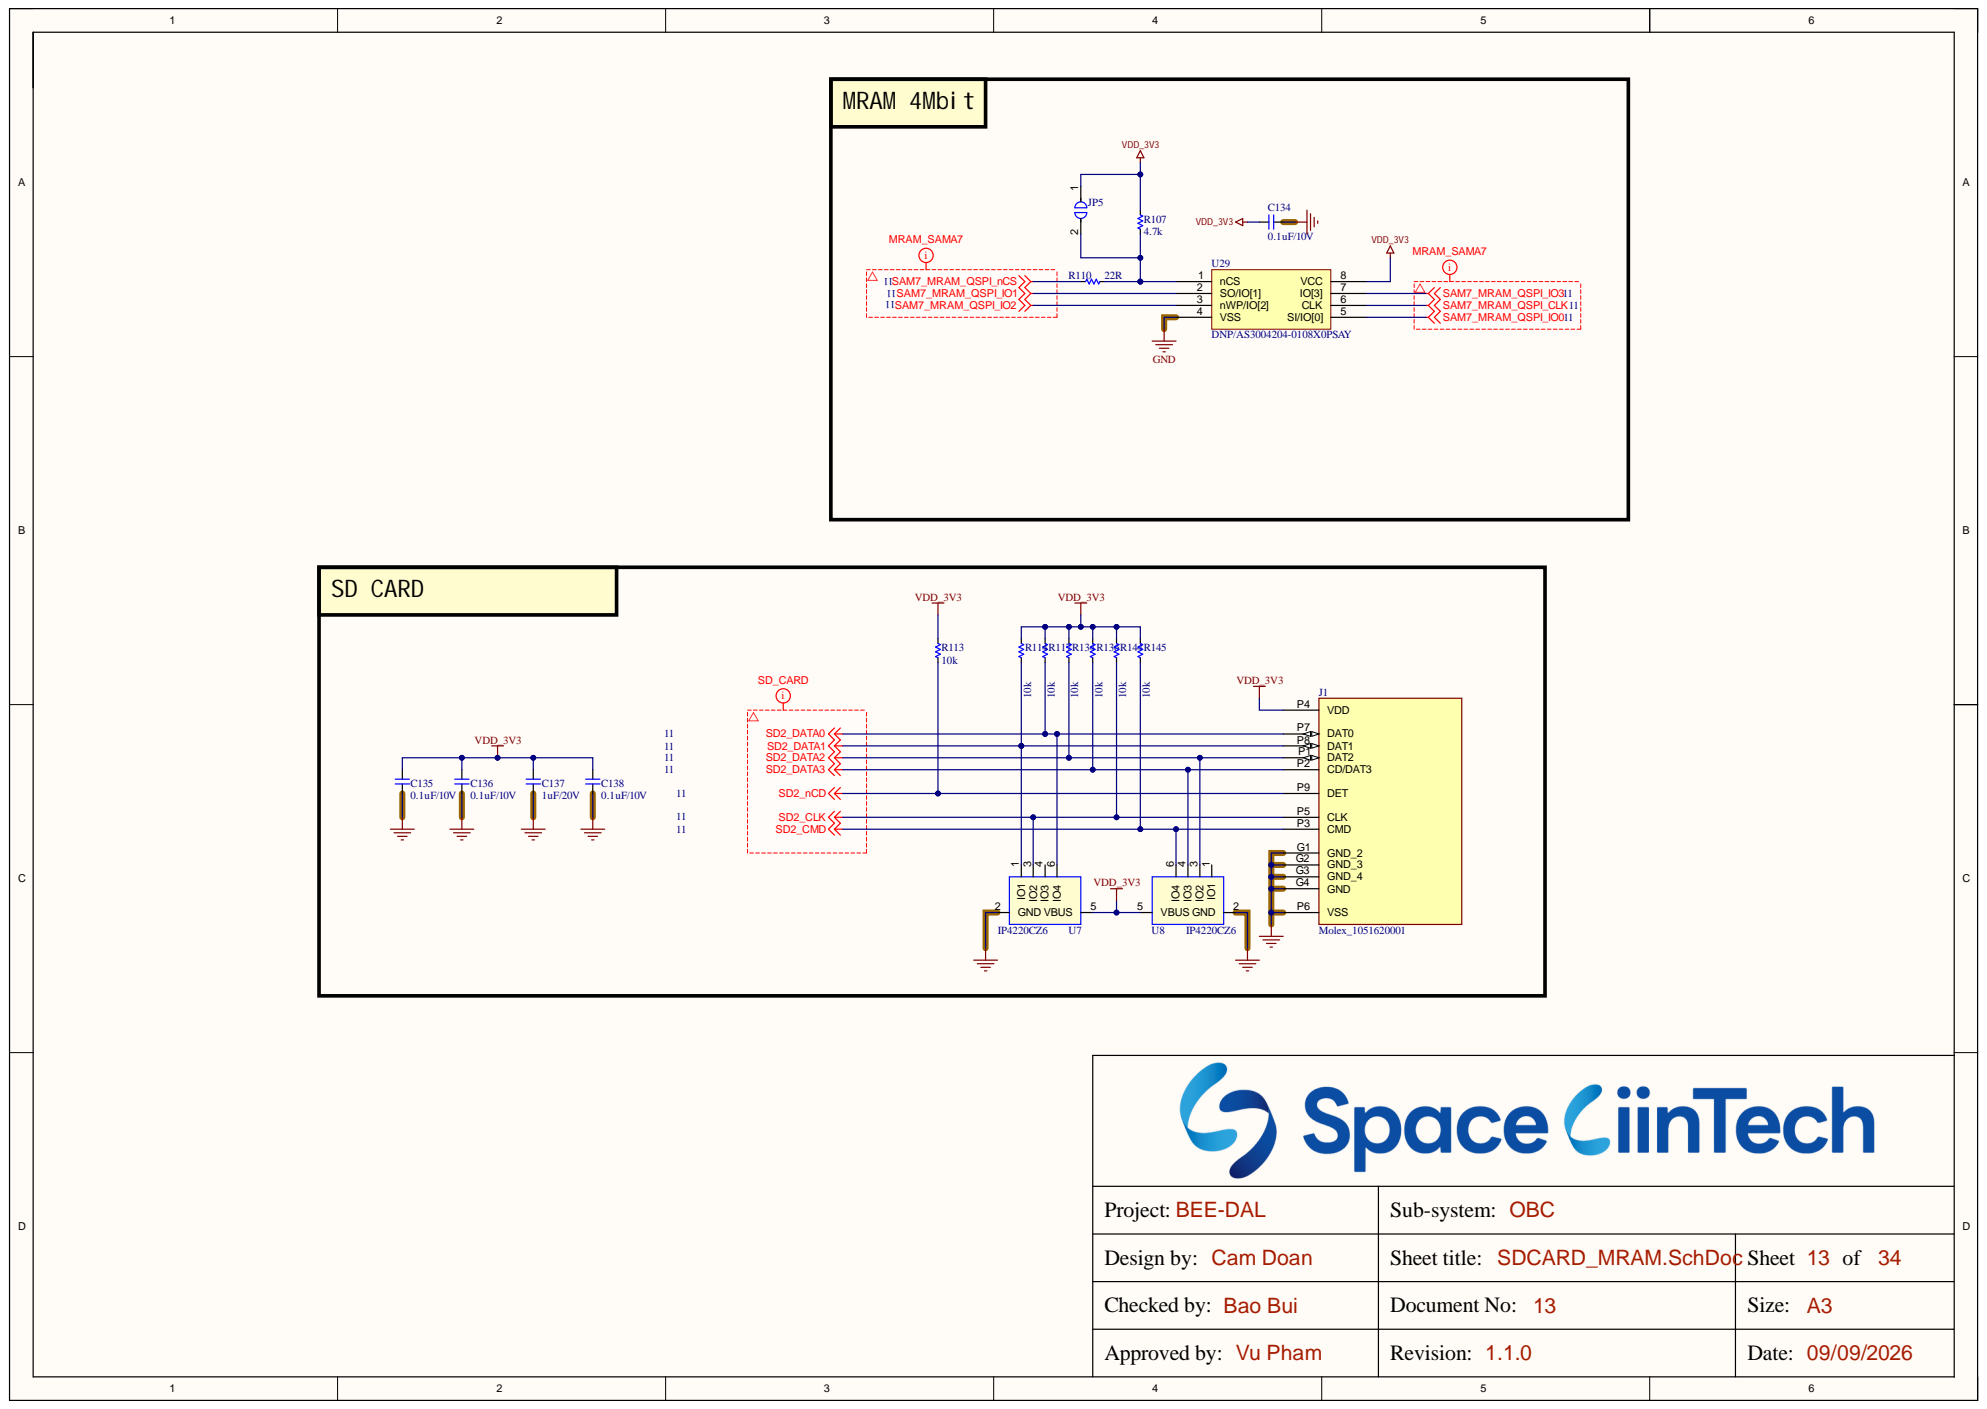
[picture p37: page 13]

DAT1 P8
DAT2 P1
CD/DAT3 P2

DET P9

CLK P5
CMD P3

GND_2 G1

Project: BEE-DAL | Sub-system: OBC

Design by: Cam Doan | Sheet title: SDCARD_MRAM.SchDoc | Sheet 13 of 34

Checked by: Bao Bui | Document No: 13 | Size: A3

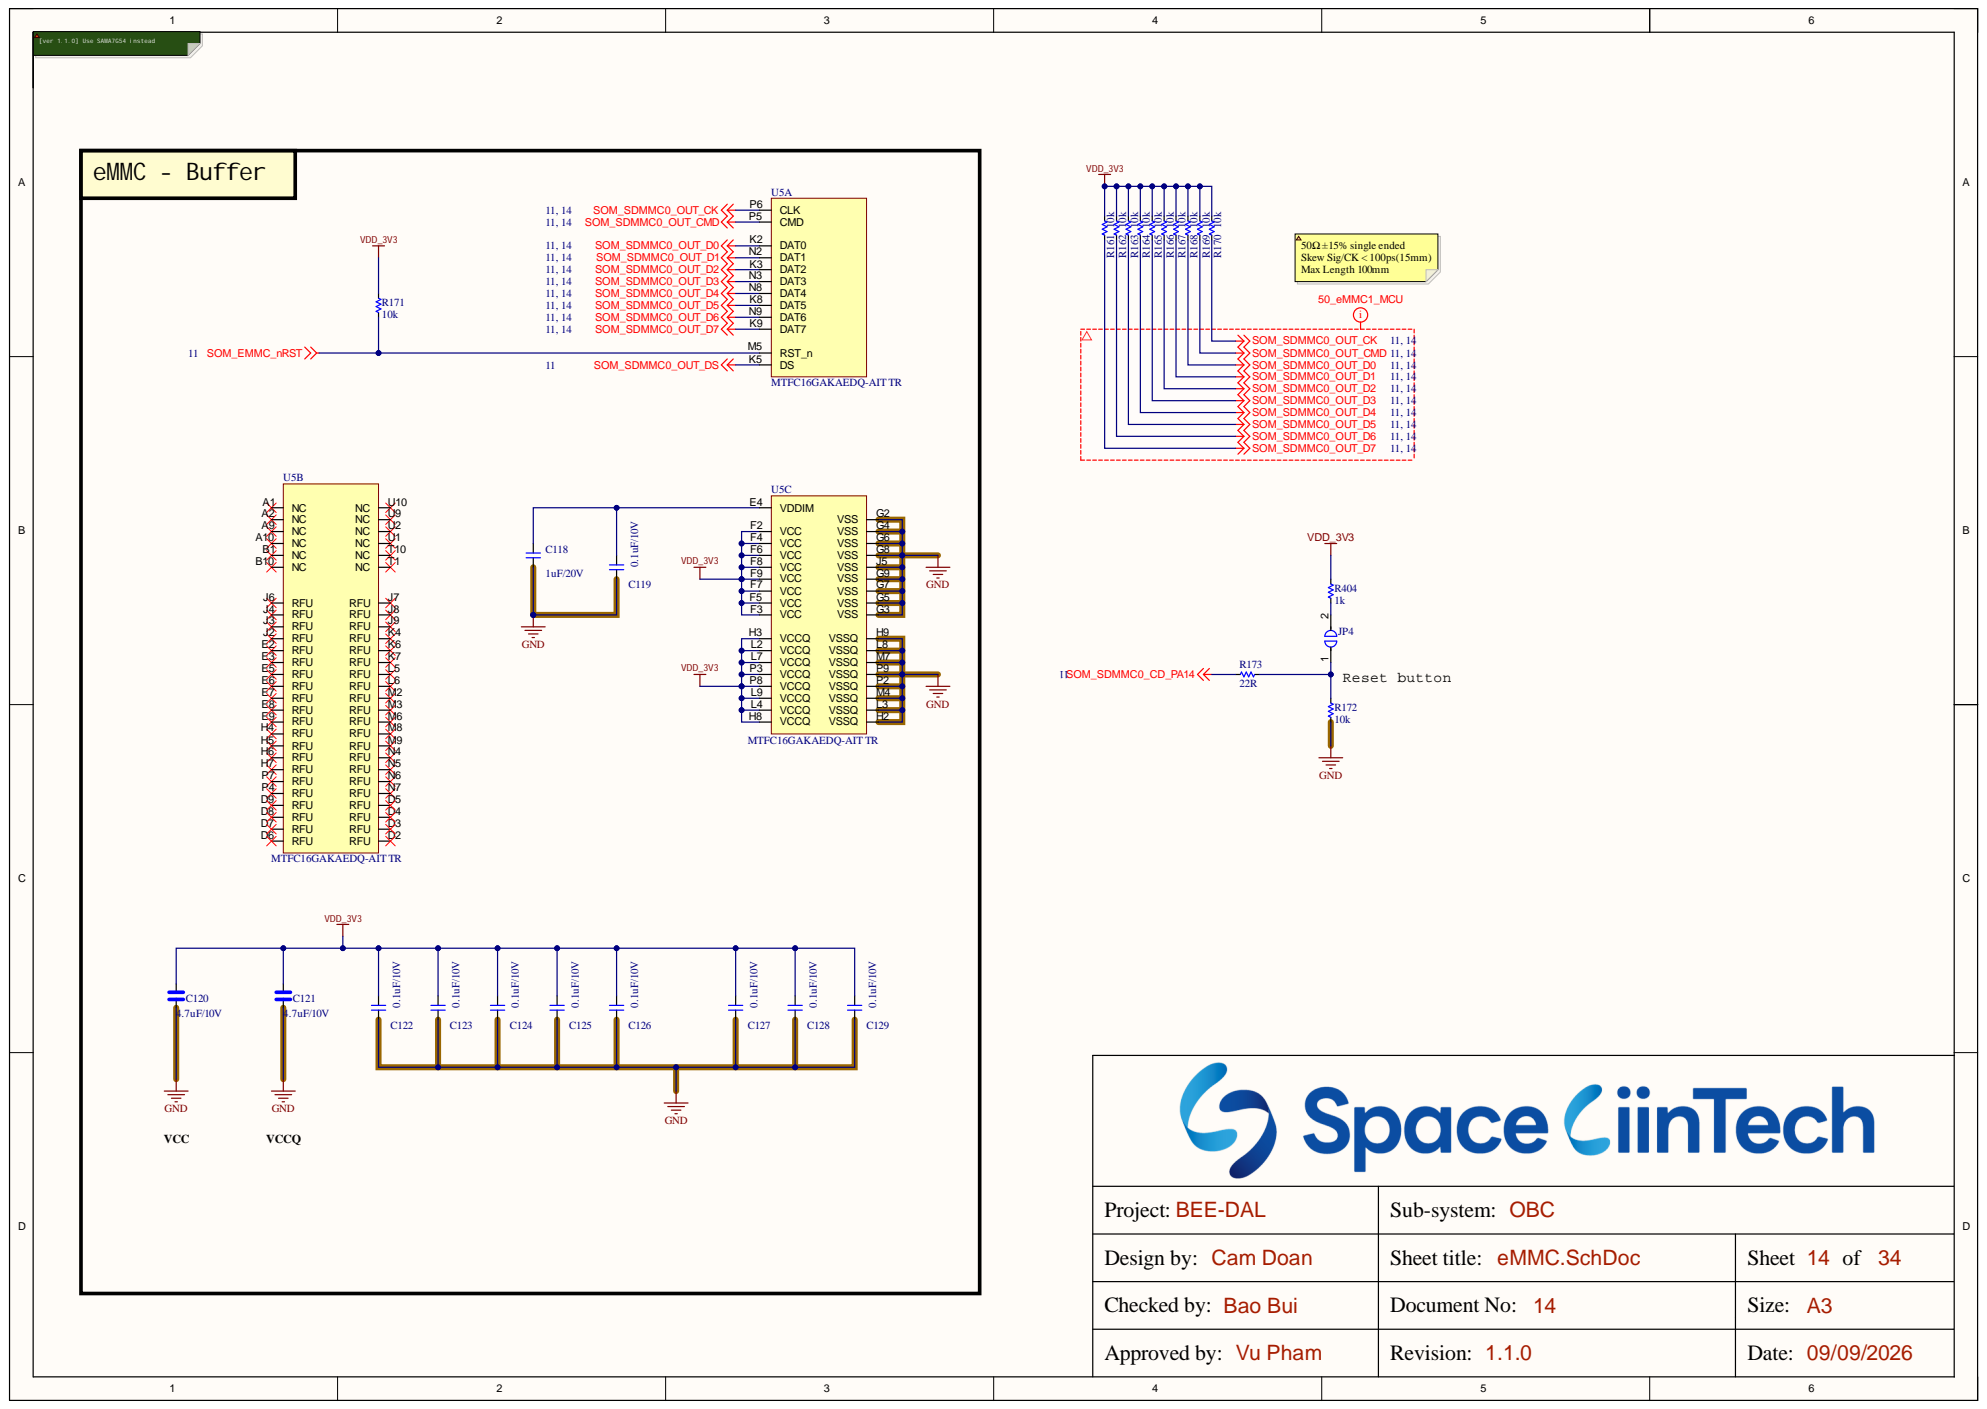
[picture p38: page 14]

Project: BEE-DAL | Sub-system: OBC

Design by: Cam Doan | Sheet title: eMMC.SchDoc | Sheet 14 of 34

Checked by: Bao Bui | Document No: 14 | Size: A3

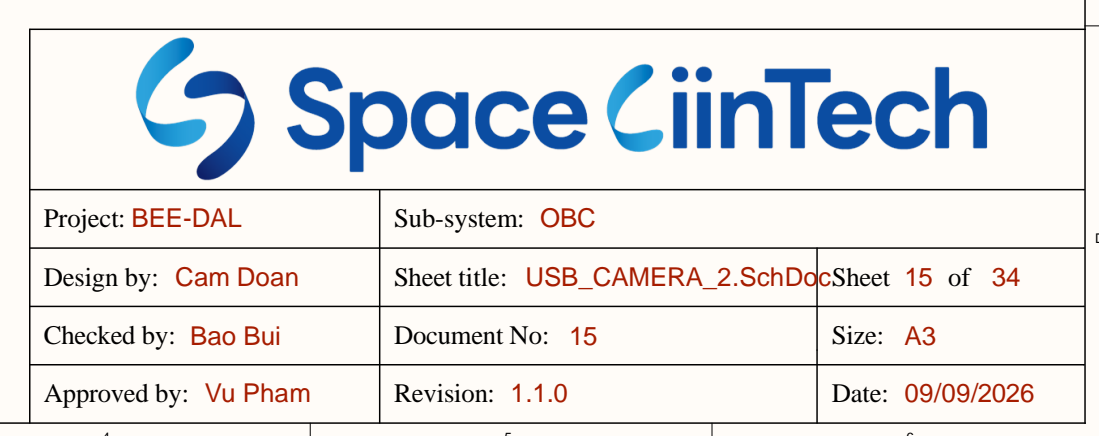
[picture p39: page 15]

Project: BEE-DAL | Sub-system: OBC

Design by: Cam Doan | Sheet title: USB_CAMERA_2.SchDoc | Sheet 15 of 34

Checked by: Bao Bui | Document No: 15 | Size: A3

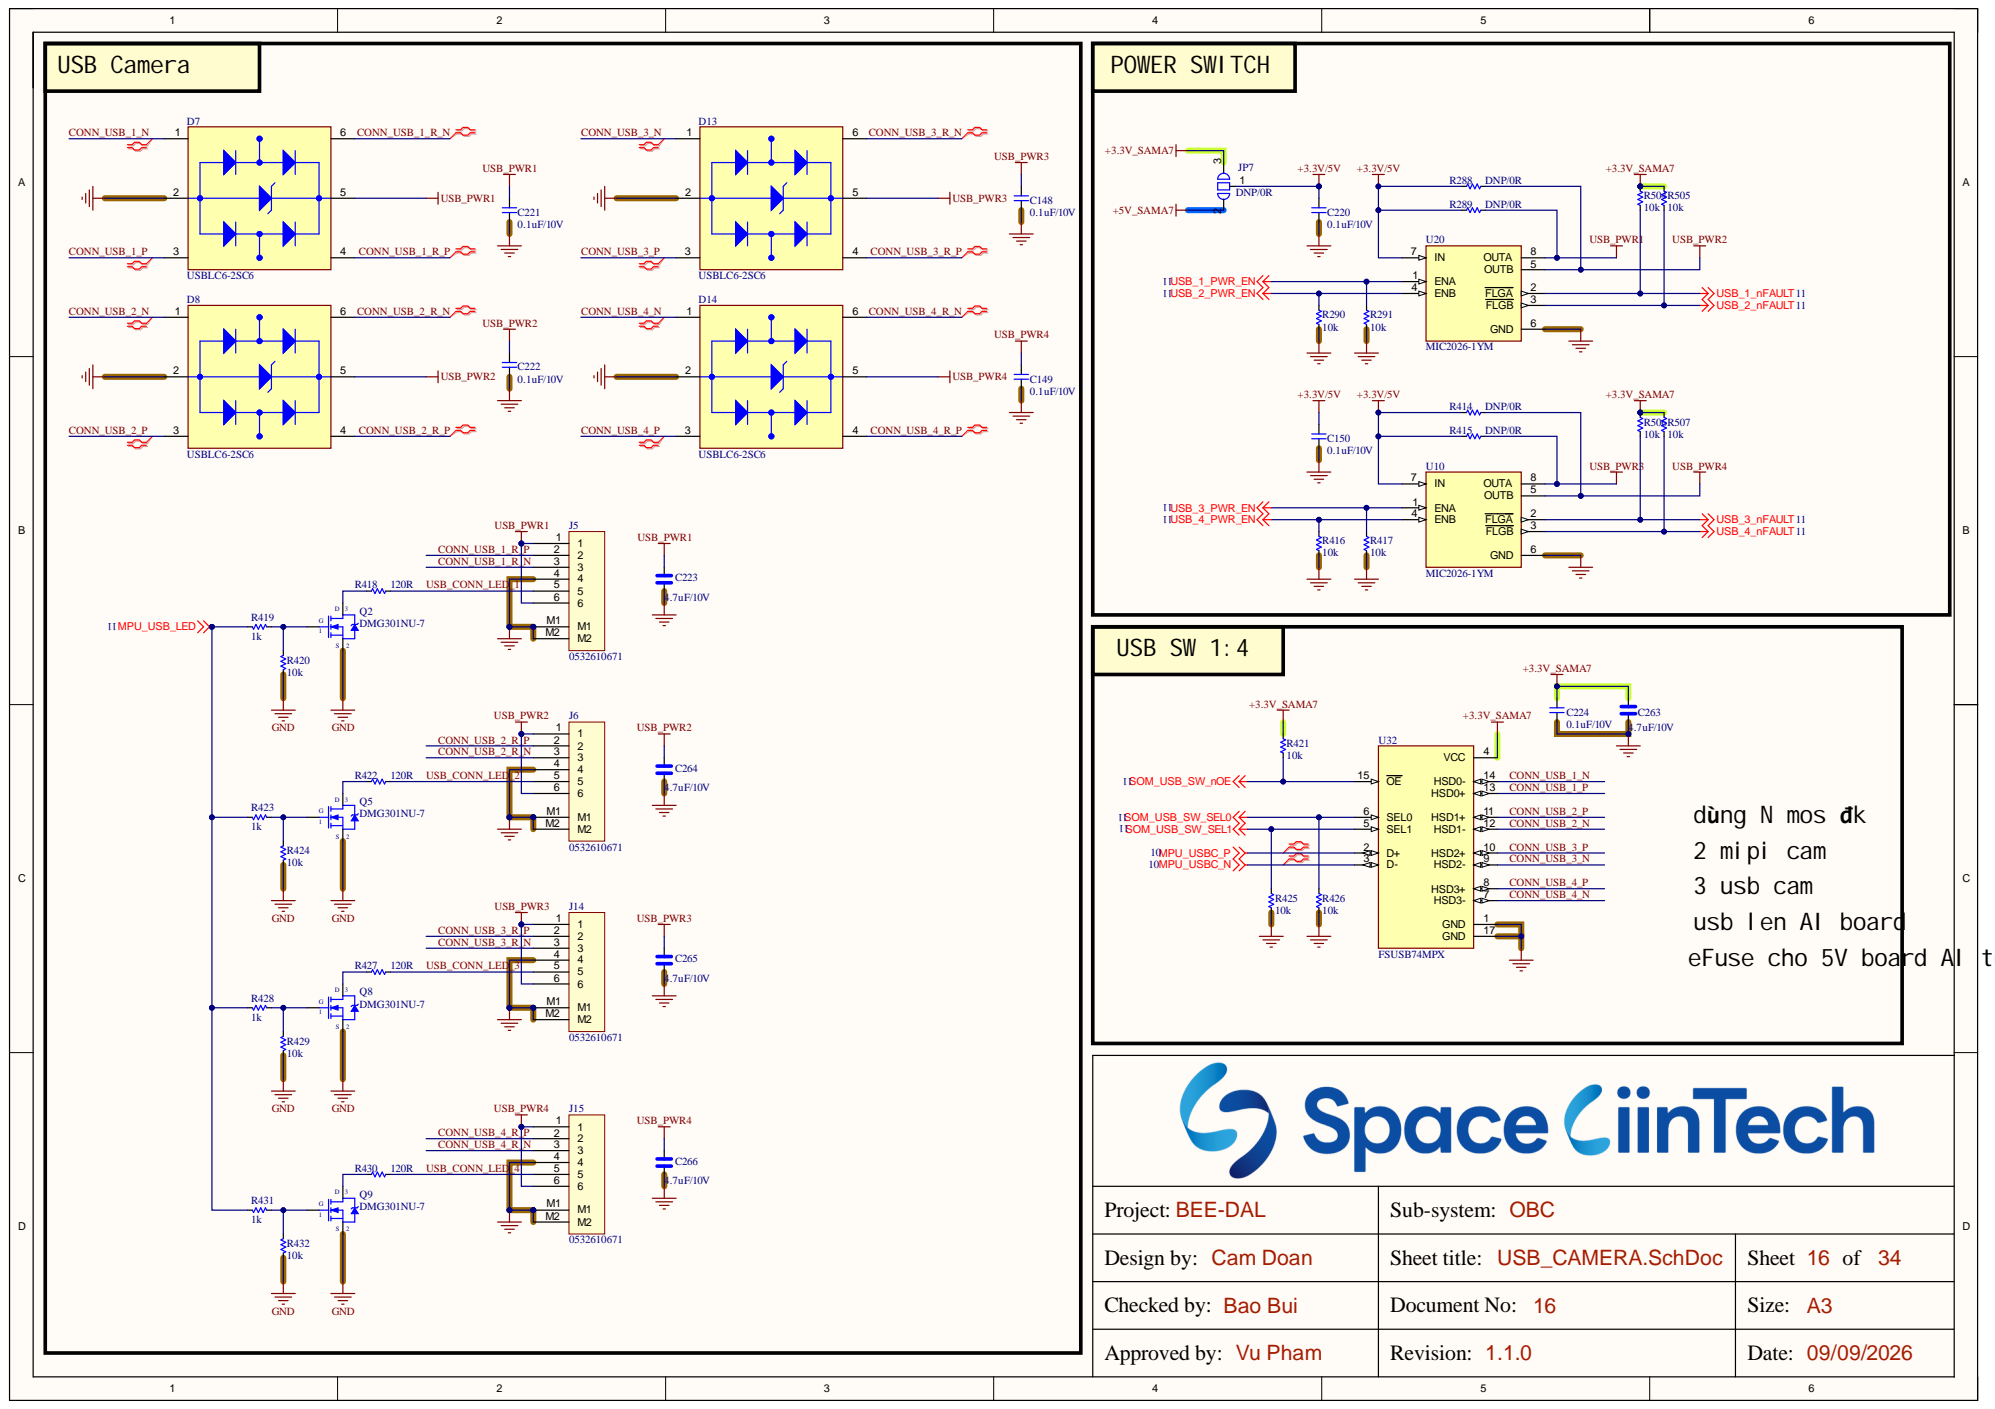
[picture p40: page 16]

3 usb cam
usb len AI board

Design by: Cam Do a n | Sheet title: USB_CAMERA.Sc hDo c | Shee t 1 6 of 3 4

Checked by: Ba o Bu i | Document No: 1 6 | Size : A3

V u Ph a m | Revisio n : 1.1 . | Date : 9/0

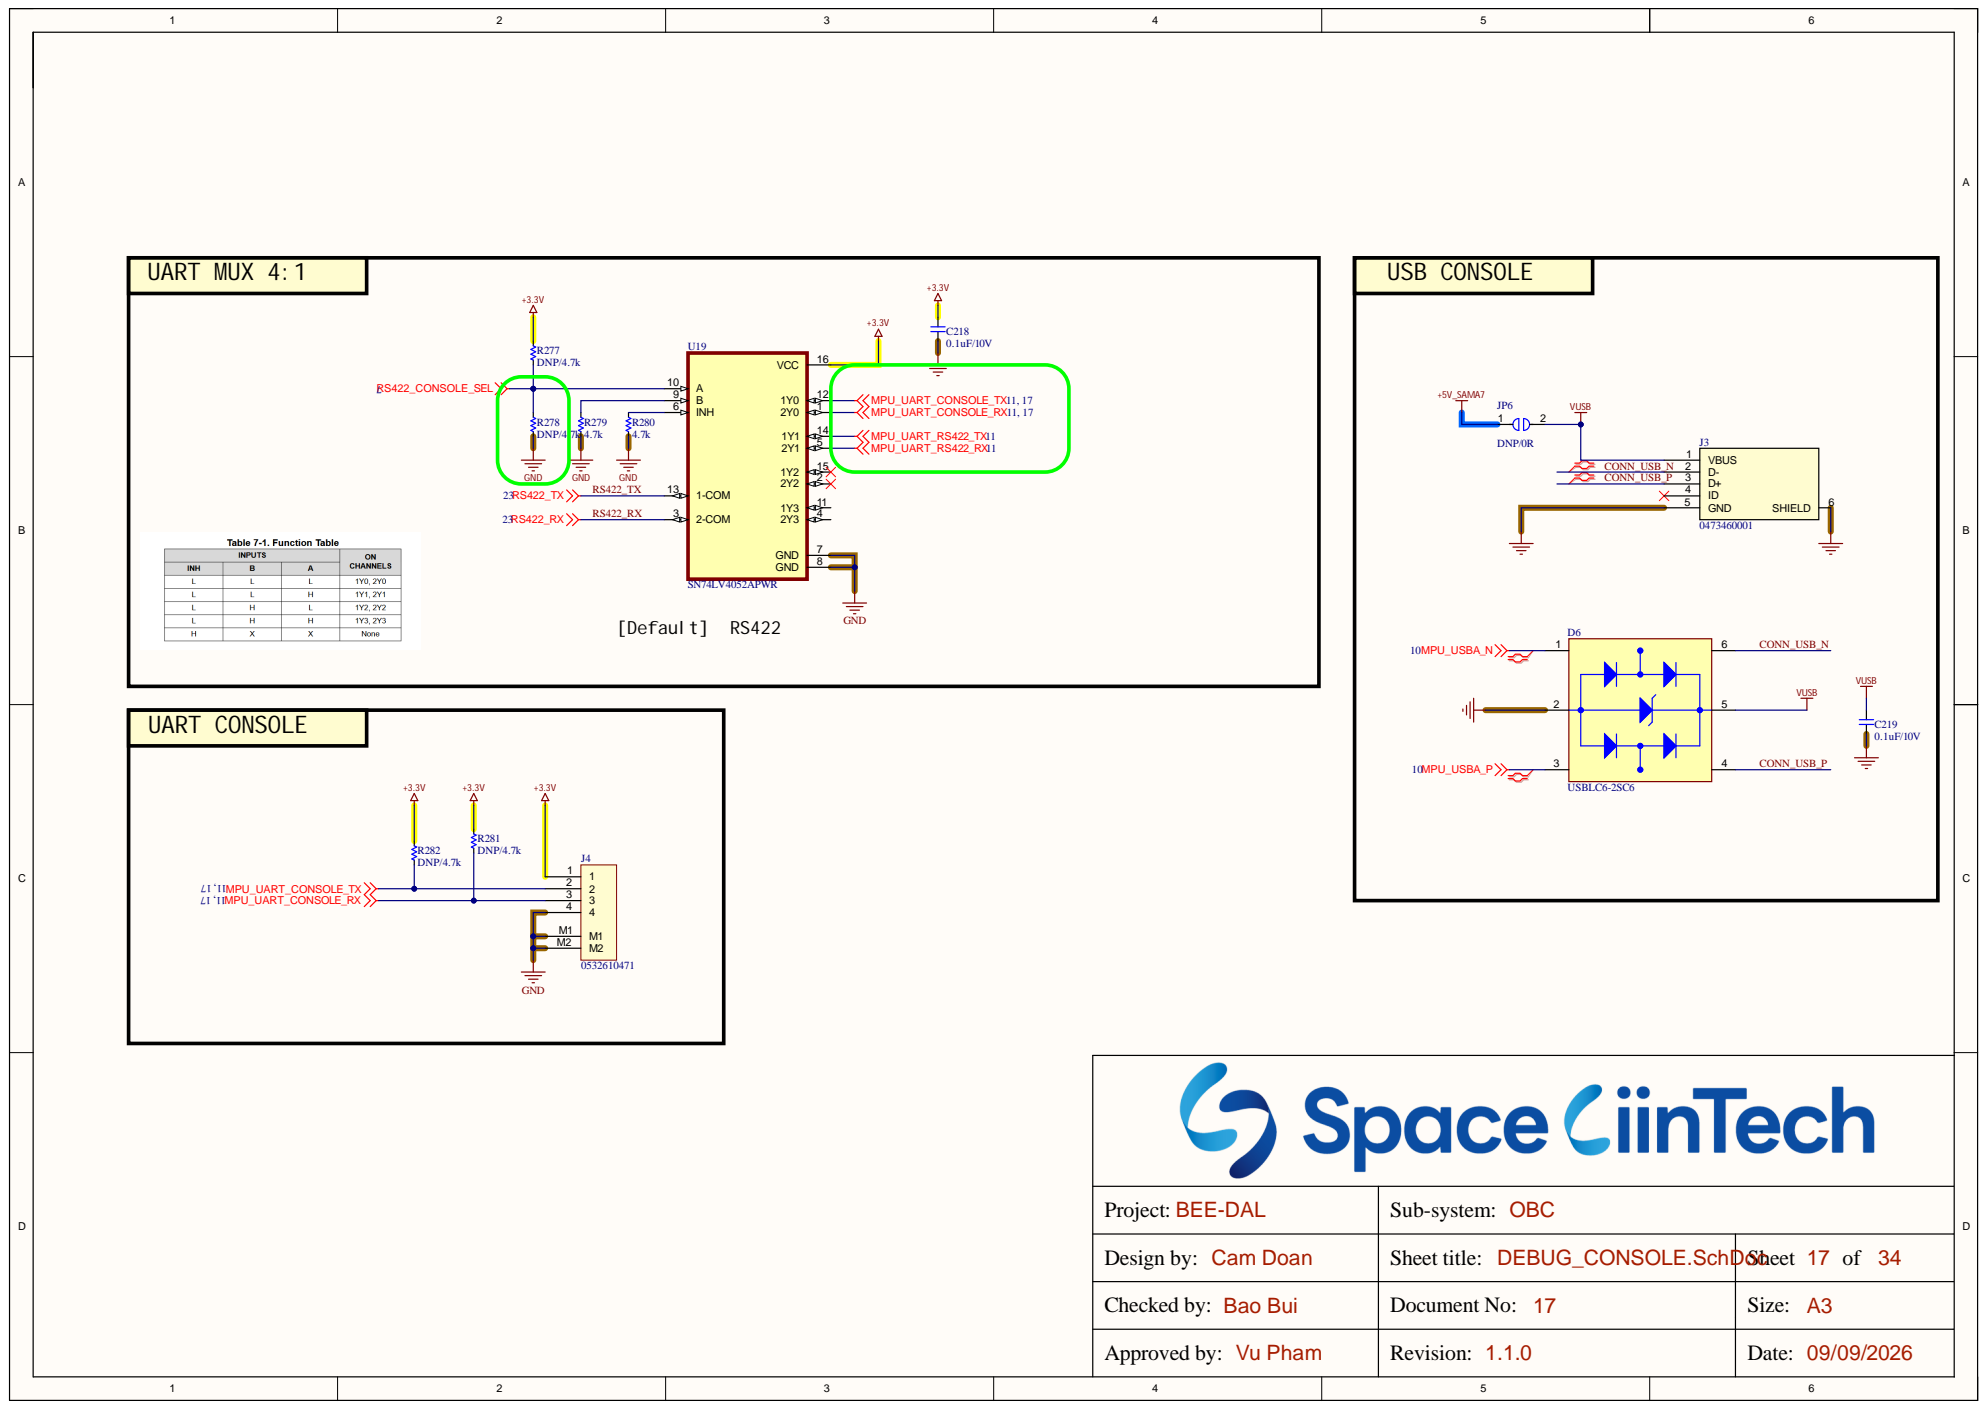
[picture p41: page 17]

M1 M1
M2 M2

Project: BEE-DAL | Sub-system: OBC

Design by: Cam Doan | Sheet title: DEBUG_CONSOLE.SchDoc | Sheet 17 of 34

Checked by: Bao Bui | Document No: 17 | Size: A3

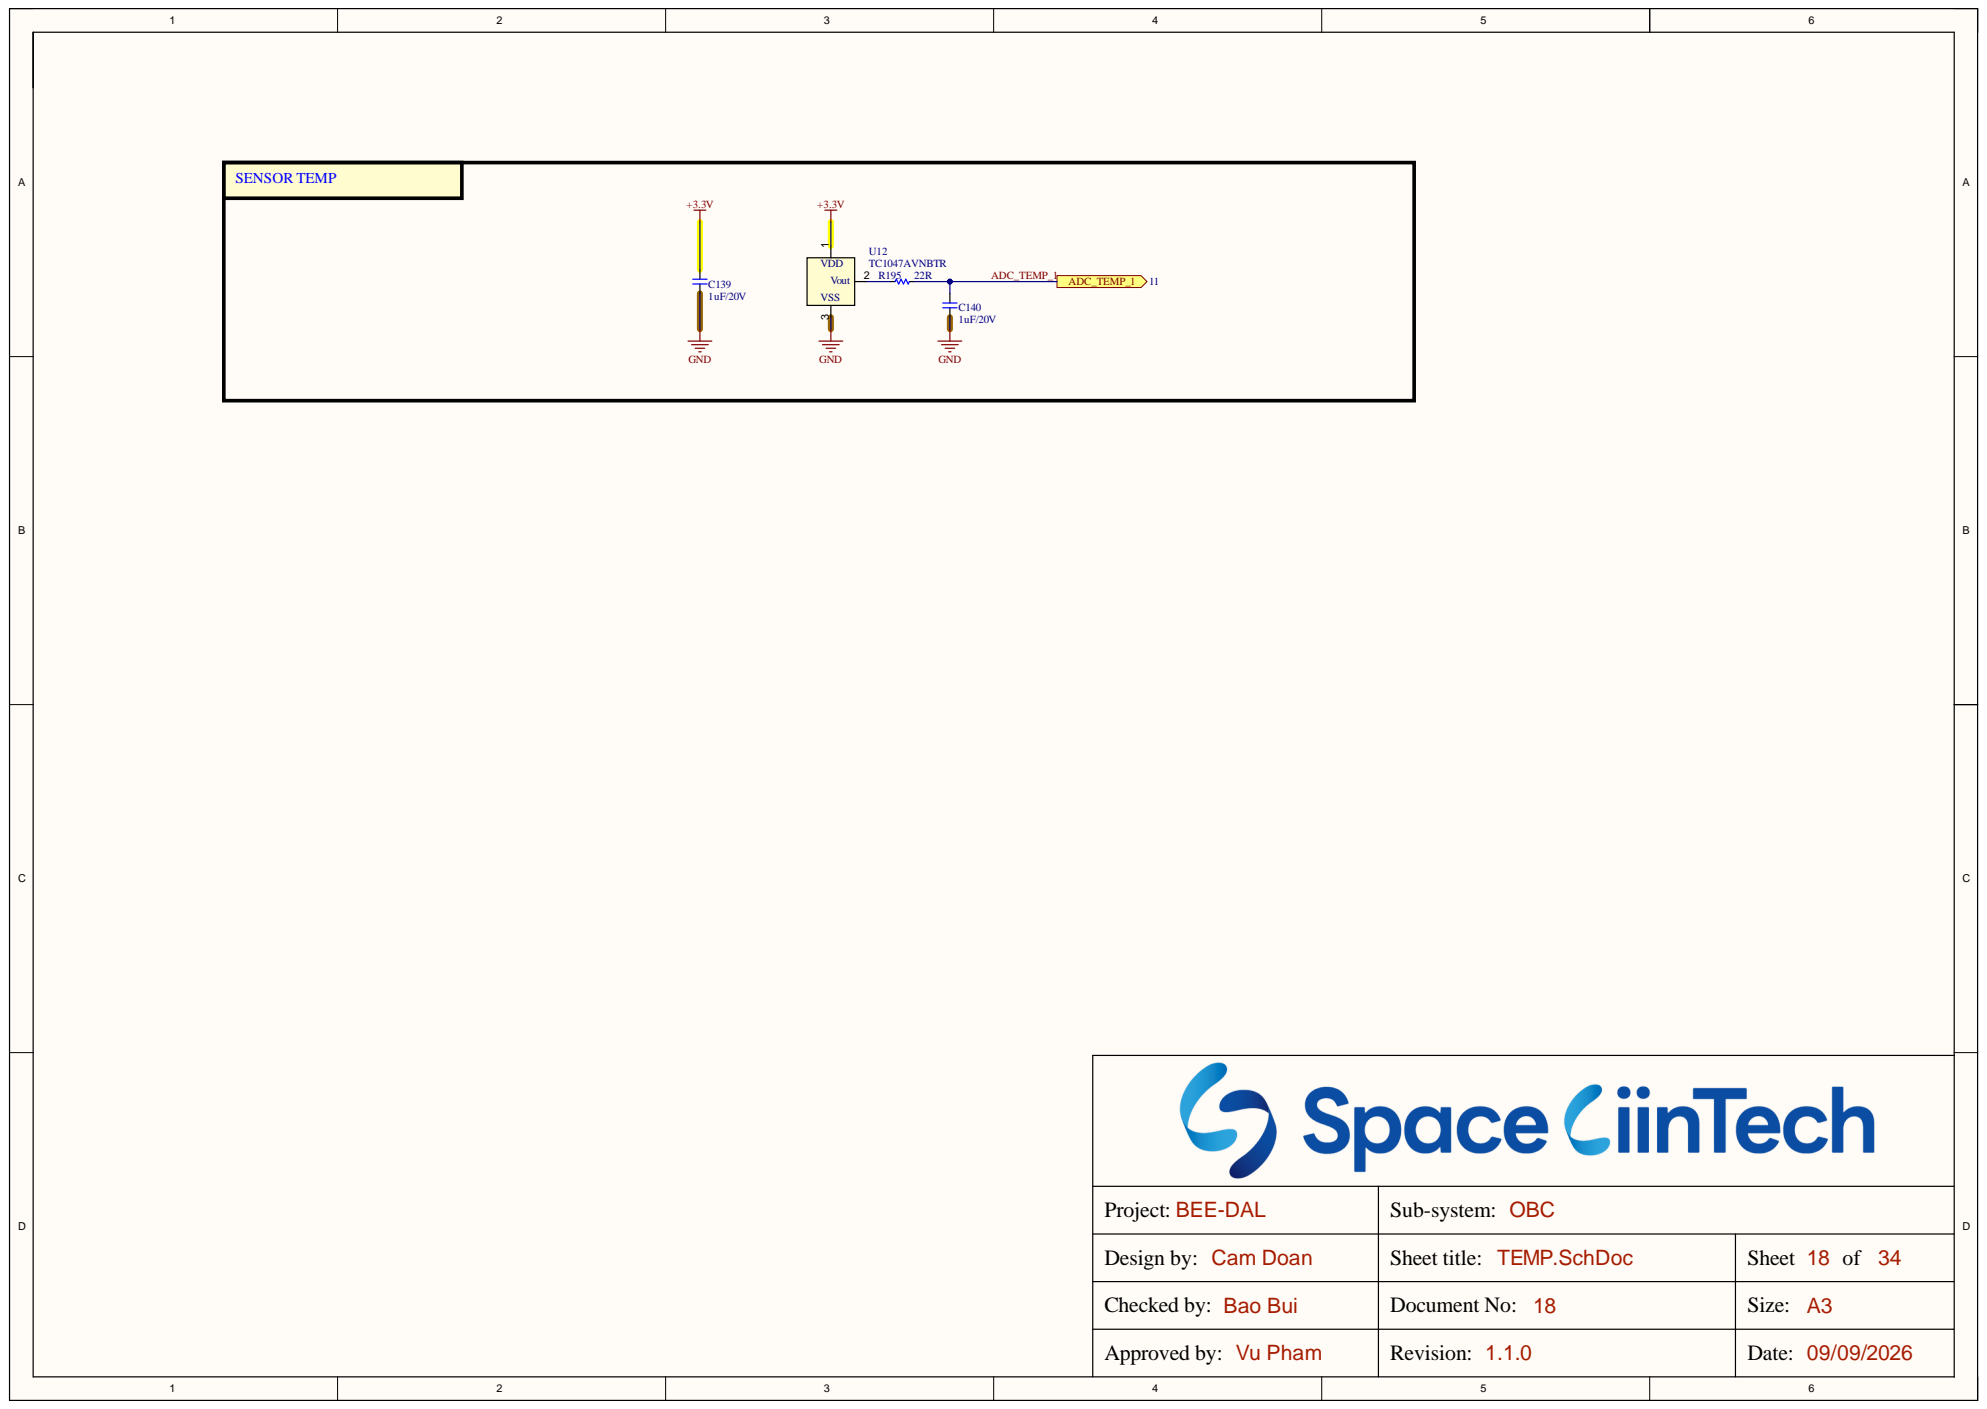
[picture p42: page 18]

Projec t : BEE-DAL | Sub-syste m : OBC

Design by: Cam Do a n | Sheet title: TEMP.Sc hDo c | Shee t 1 8 of 3 4

Checked by: Ba o Bu i | Document No: 1 8 | Size : A3

V u Ph a m | Revisio n : 1.1 . | Date : 9/0

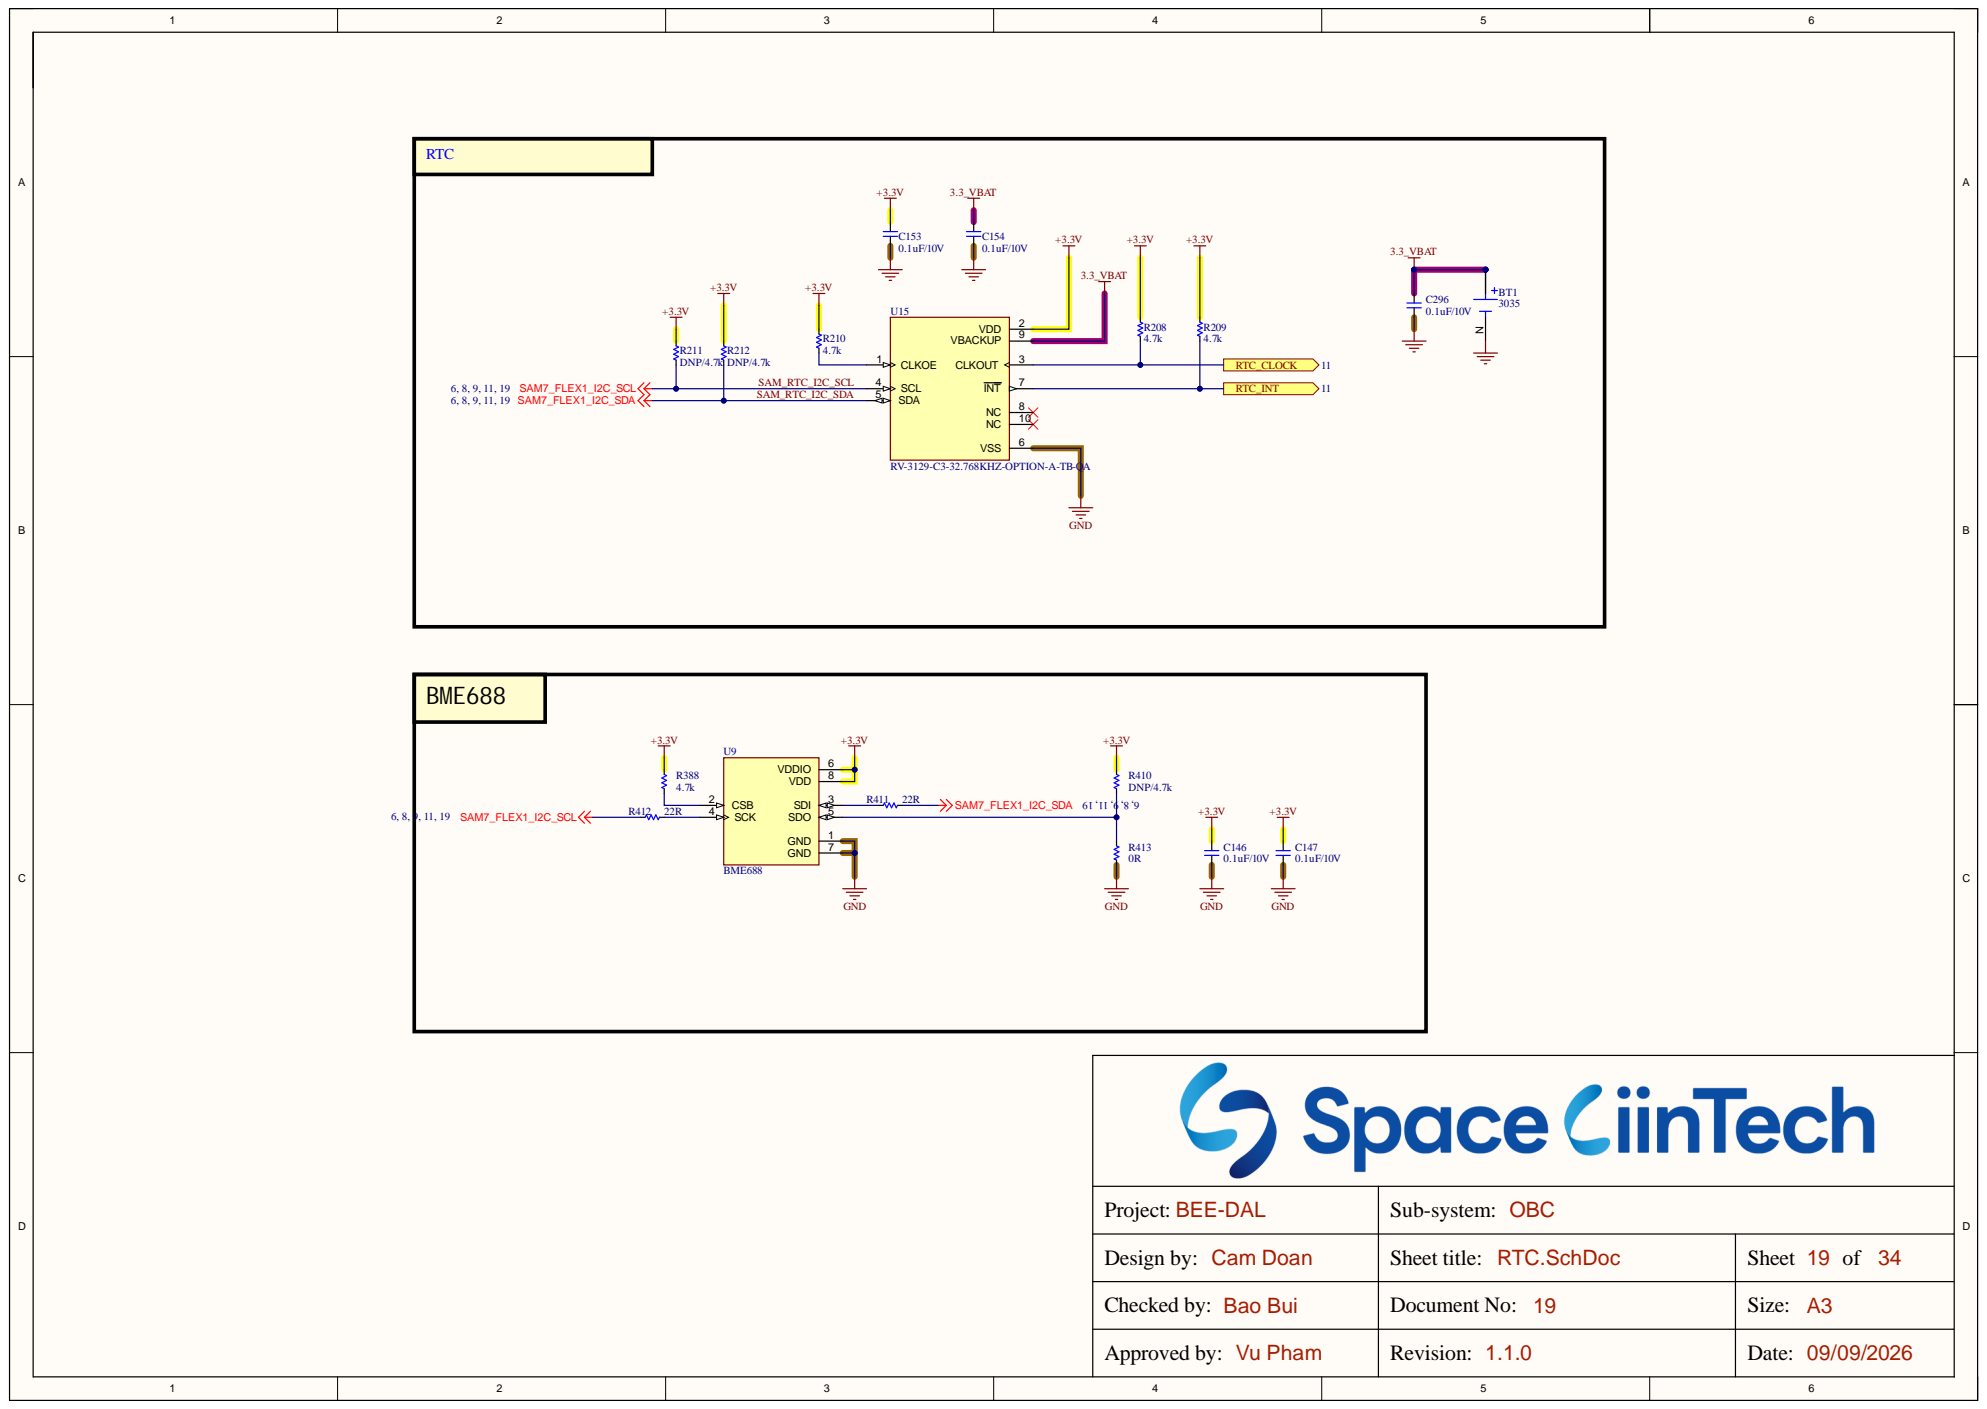
[picture p43: page 19]

RV-3129-C3-32.768KHZ-OPTION-A-TB-QA

Project: BEE-DAL | Sub-system: OBC

Design by: Cam Doan | Sheet title: RTC.SchDoc | Sheet 19 of 34

Checked by: Bao Bui | Document No: 19 | Size: A3

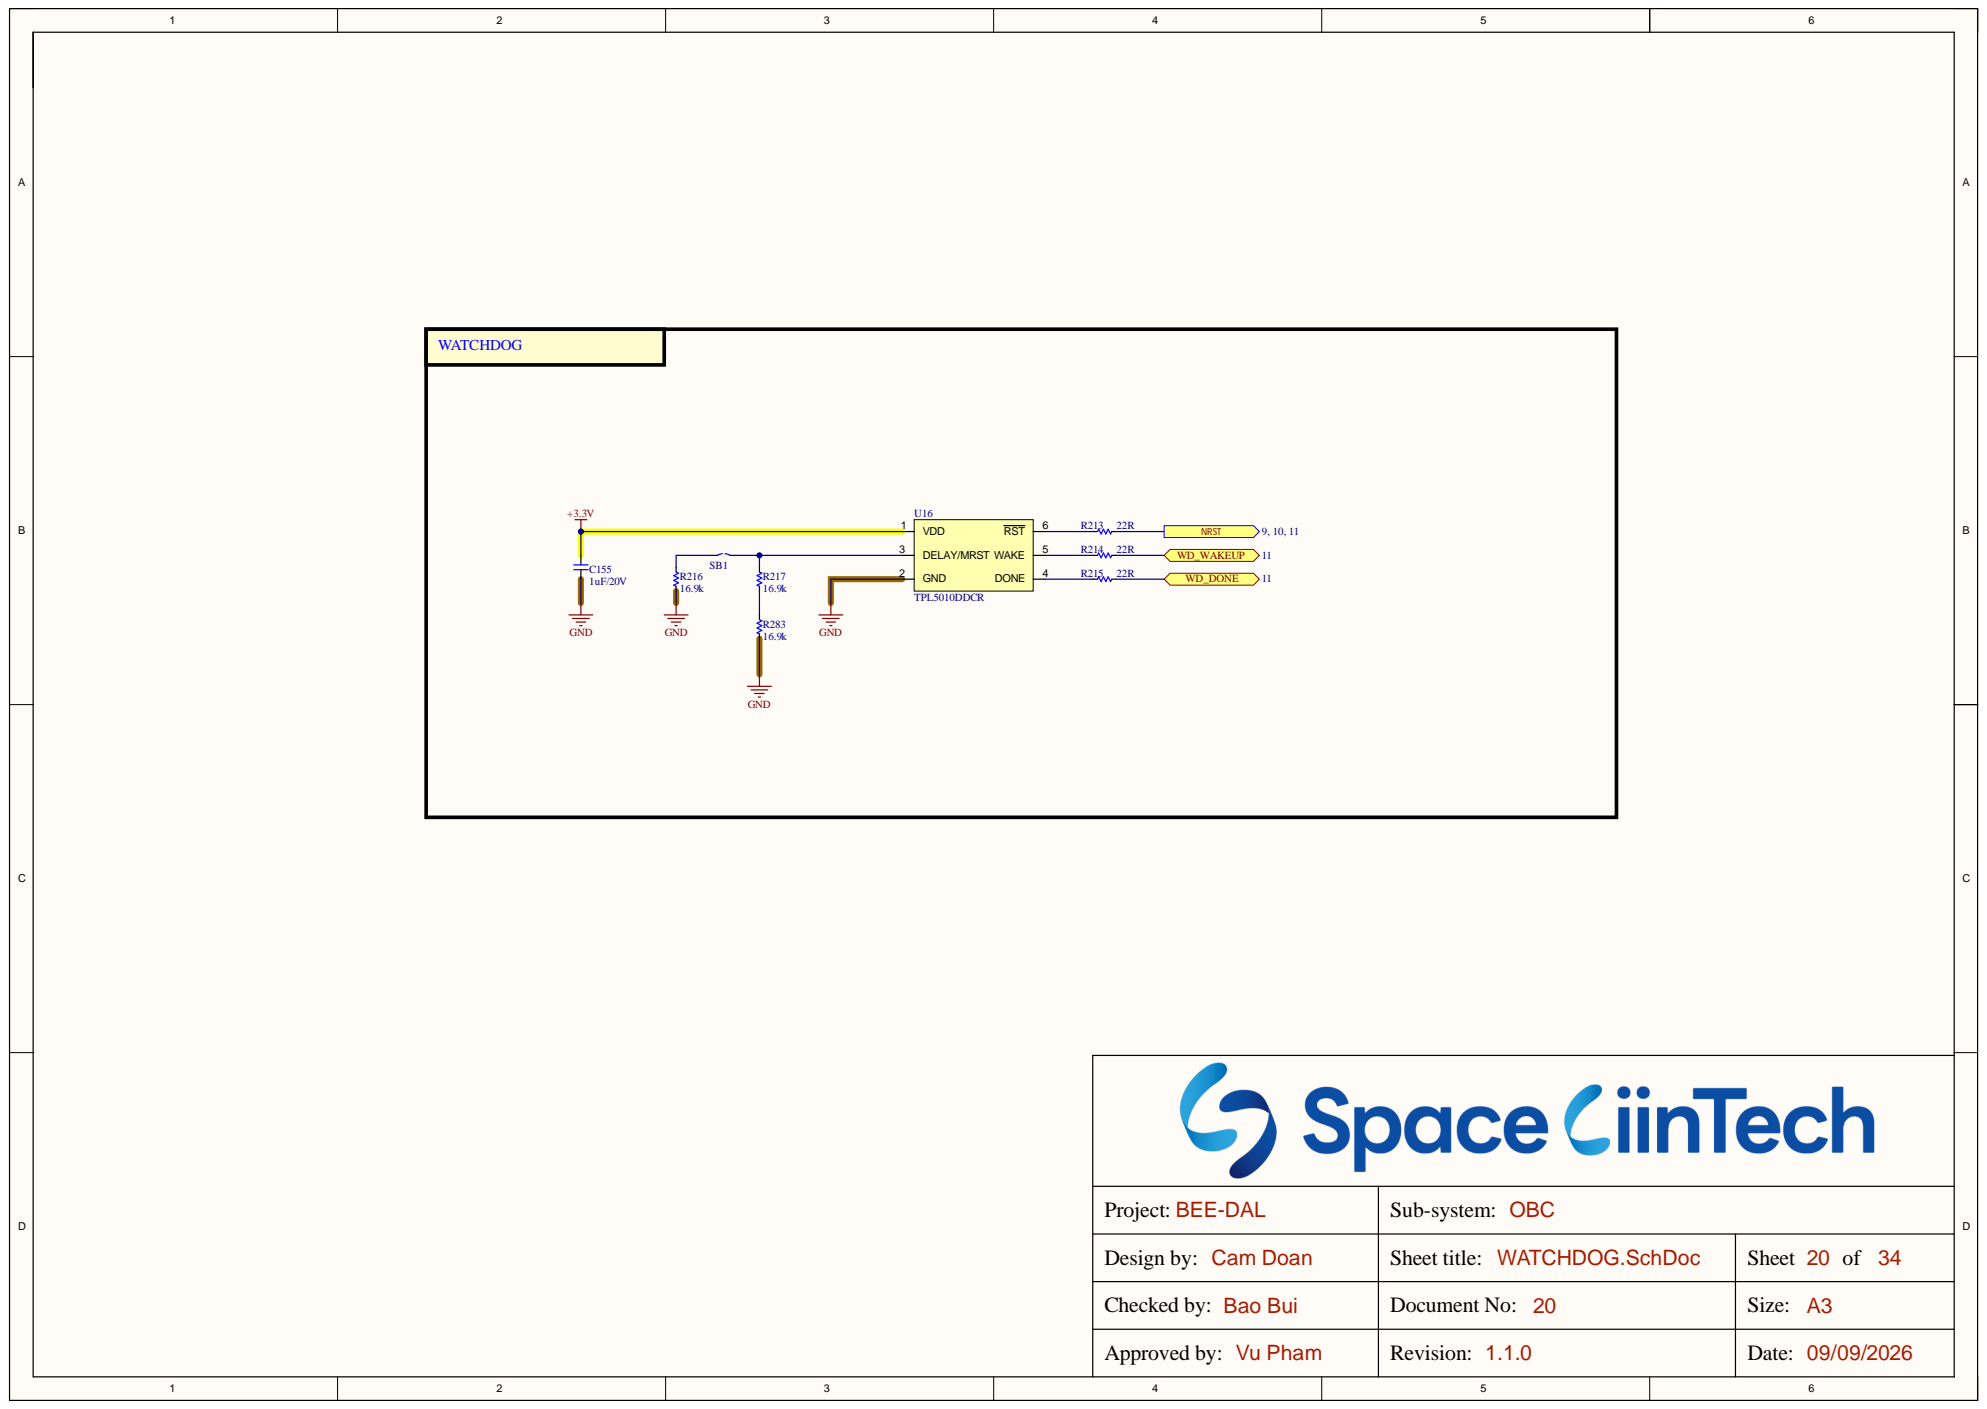
[picture p44: page 20]

Projec t : BEE-DAL | Sub-syste m : OBC

Design by: Cam Do a n | Sheet title: W ATCHDOG.Sc hDo c | Shee t 2 0 of 3 4

Checked by: Ba o Bu i | Document No: 2 0 | Size : A3

V u Ph a m | Revisio n : 1.1 . | Date : 9/0

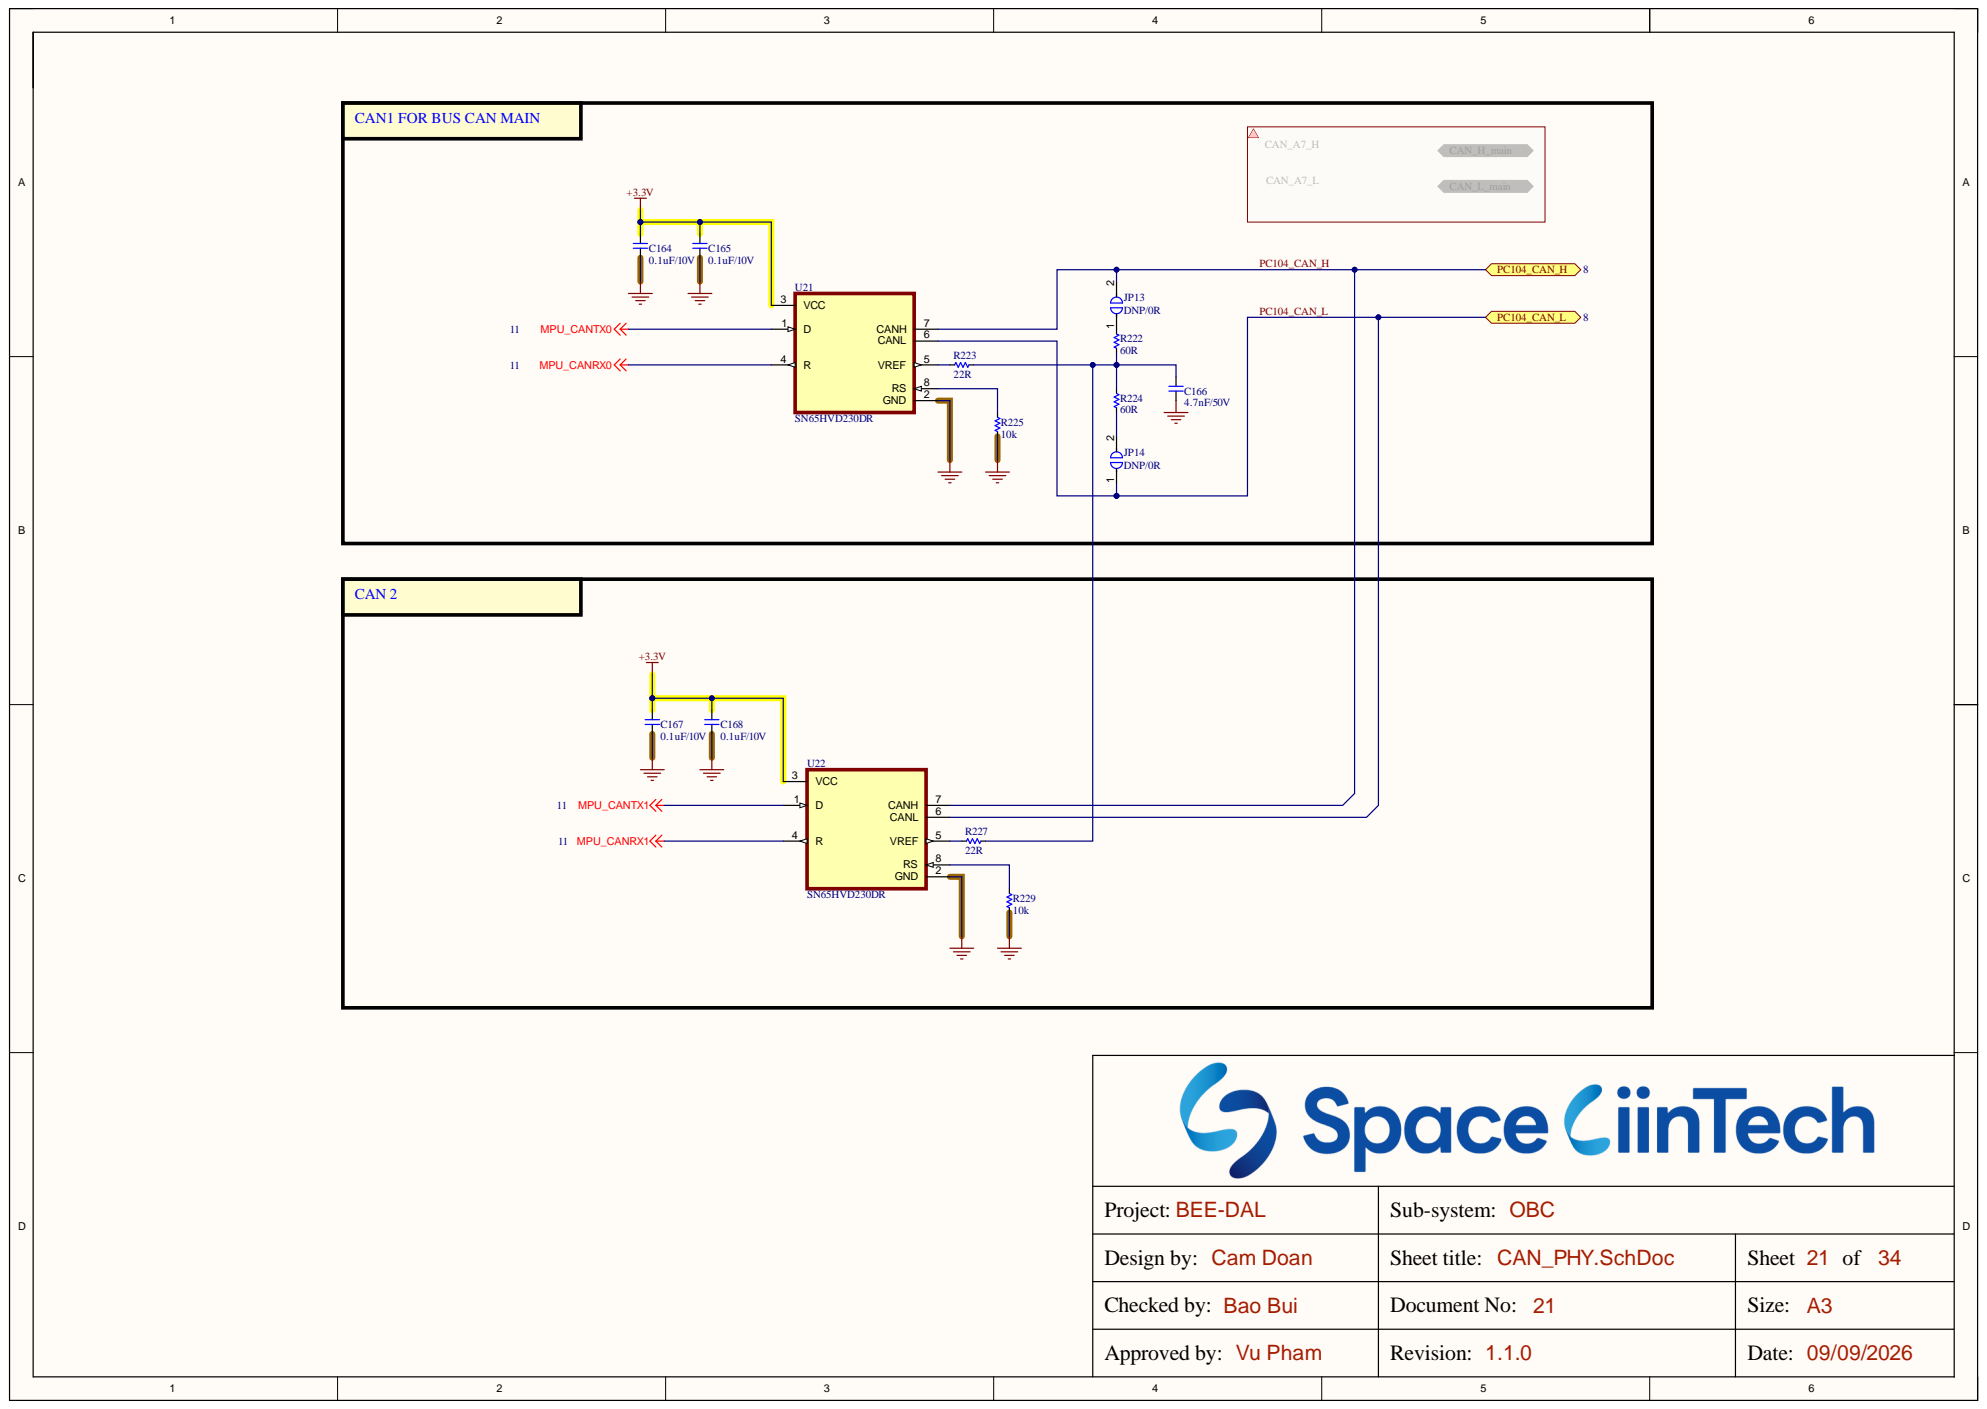
[picture p45: page 21]

CAN1 FOR BUS CAN MAIN

Project: BEE-DAL | Sub-system: OBC

Design by: Cam Doan | Sheet title: CAN_PHY.SchDoc | Sheet 21 of 34

Checked by: Bao Bui | Document No: 21 | Size: A3

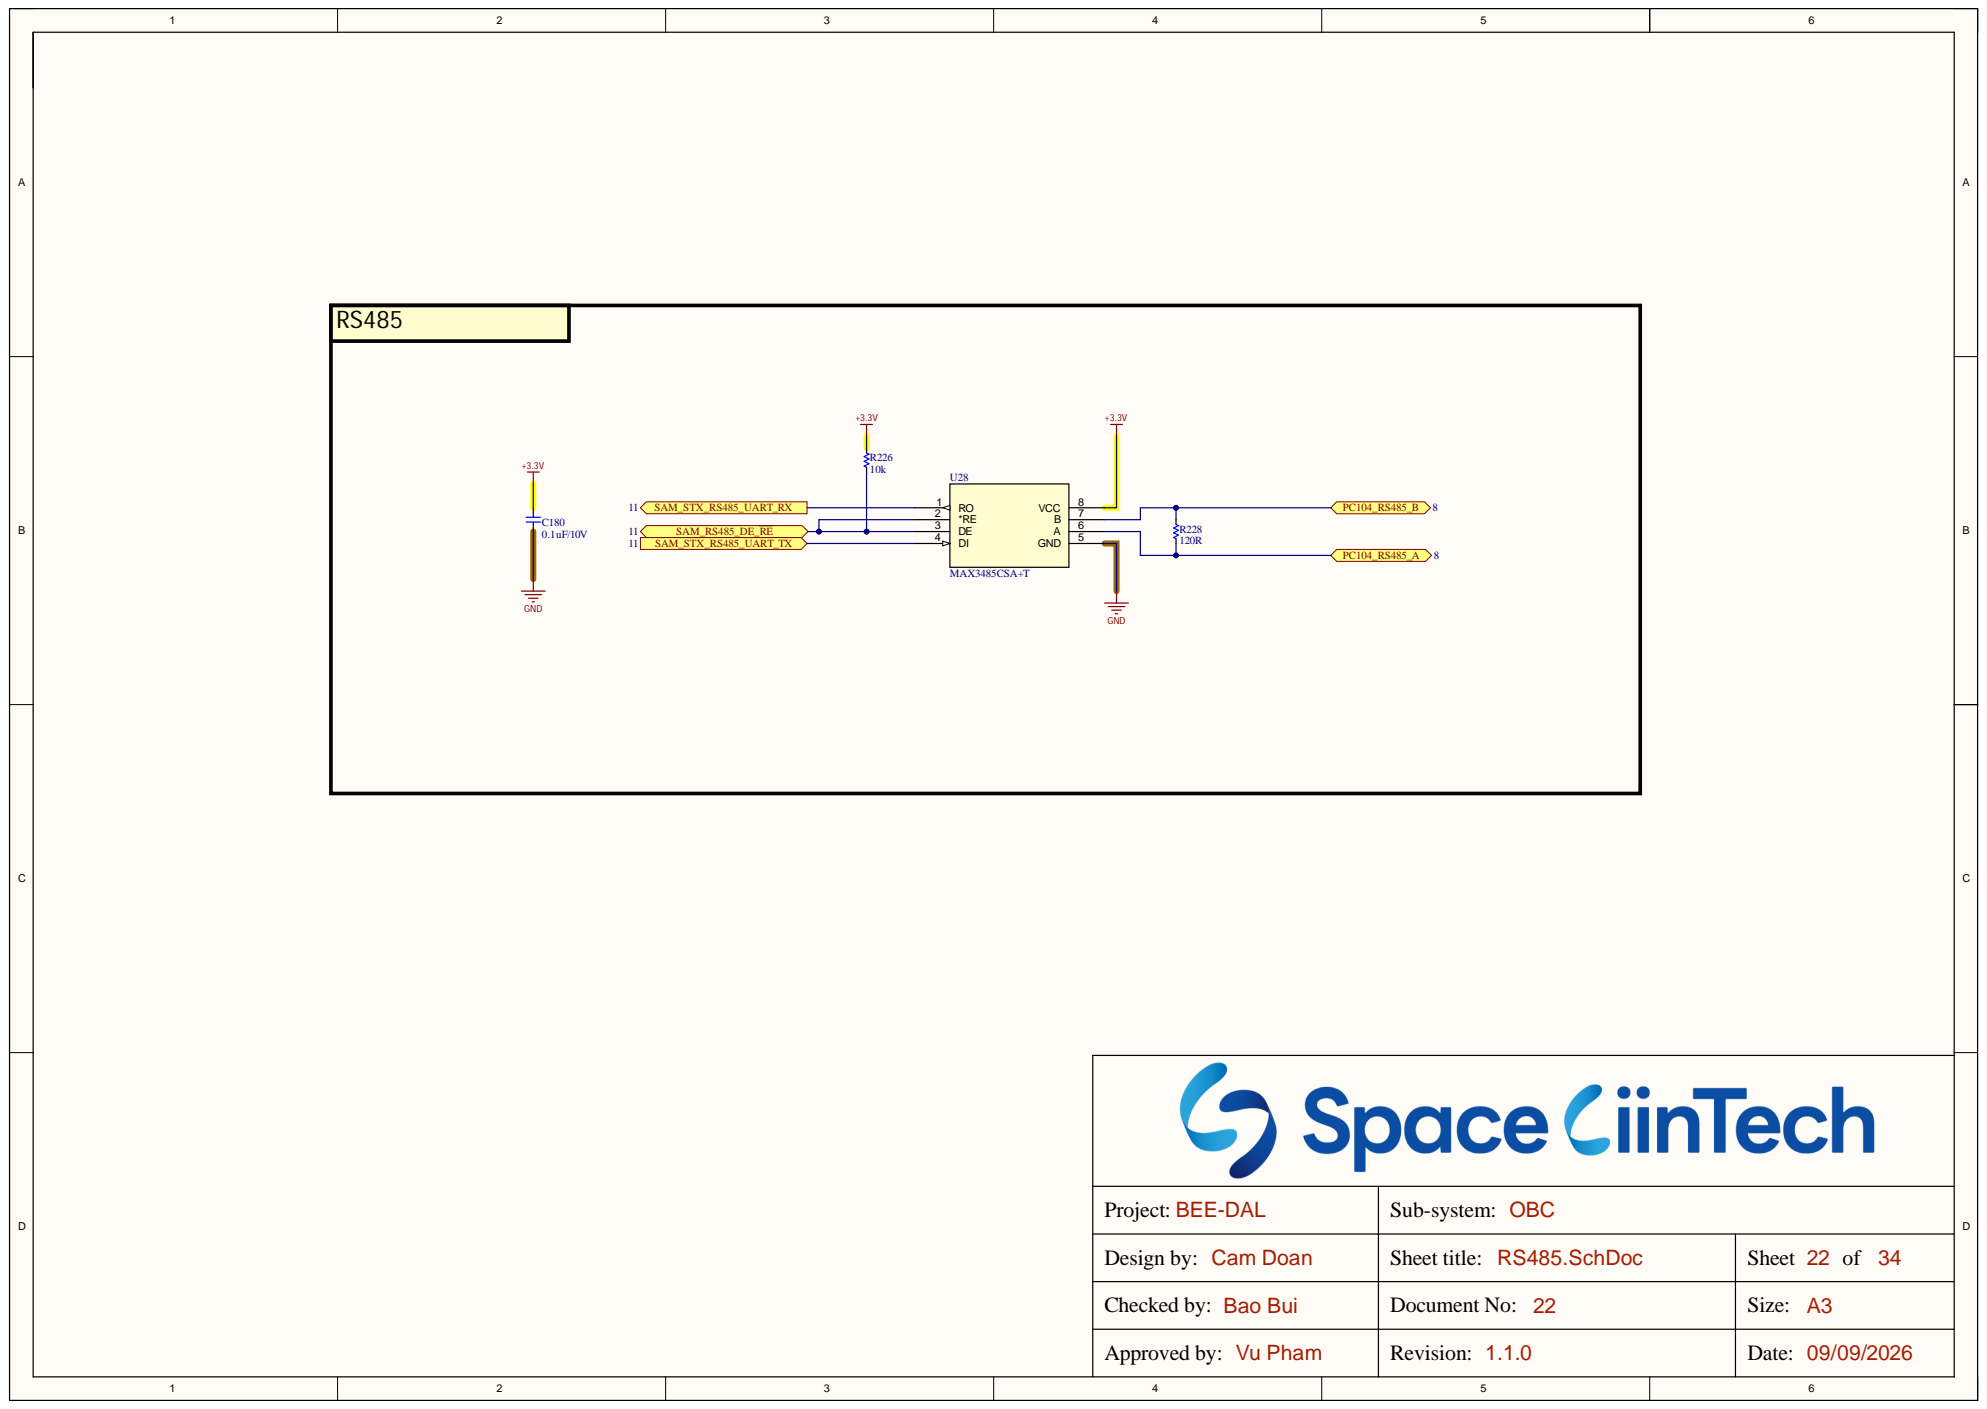
[picture p46: page 22]

Projec t : BEE-DAL | Sub-syste m : OBC

Design by: Cam Do a n | Sheet title: RS4 8 5.Sc hDo c | Shee t 2 2 of 3 4

Checked by: Ba o Bu i | Document No: 2 2 | Size : A3

V u Ph a m | Revisio n : 1.1 . | Date : 9/0

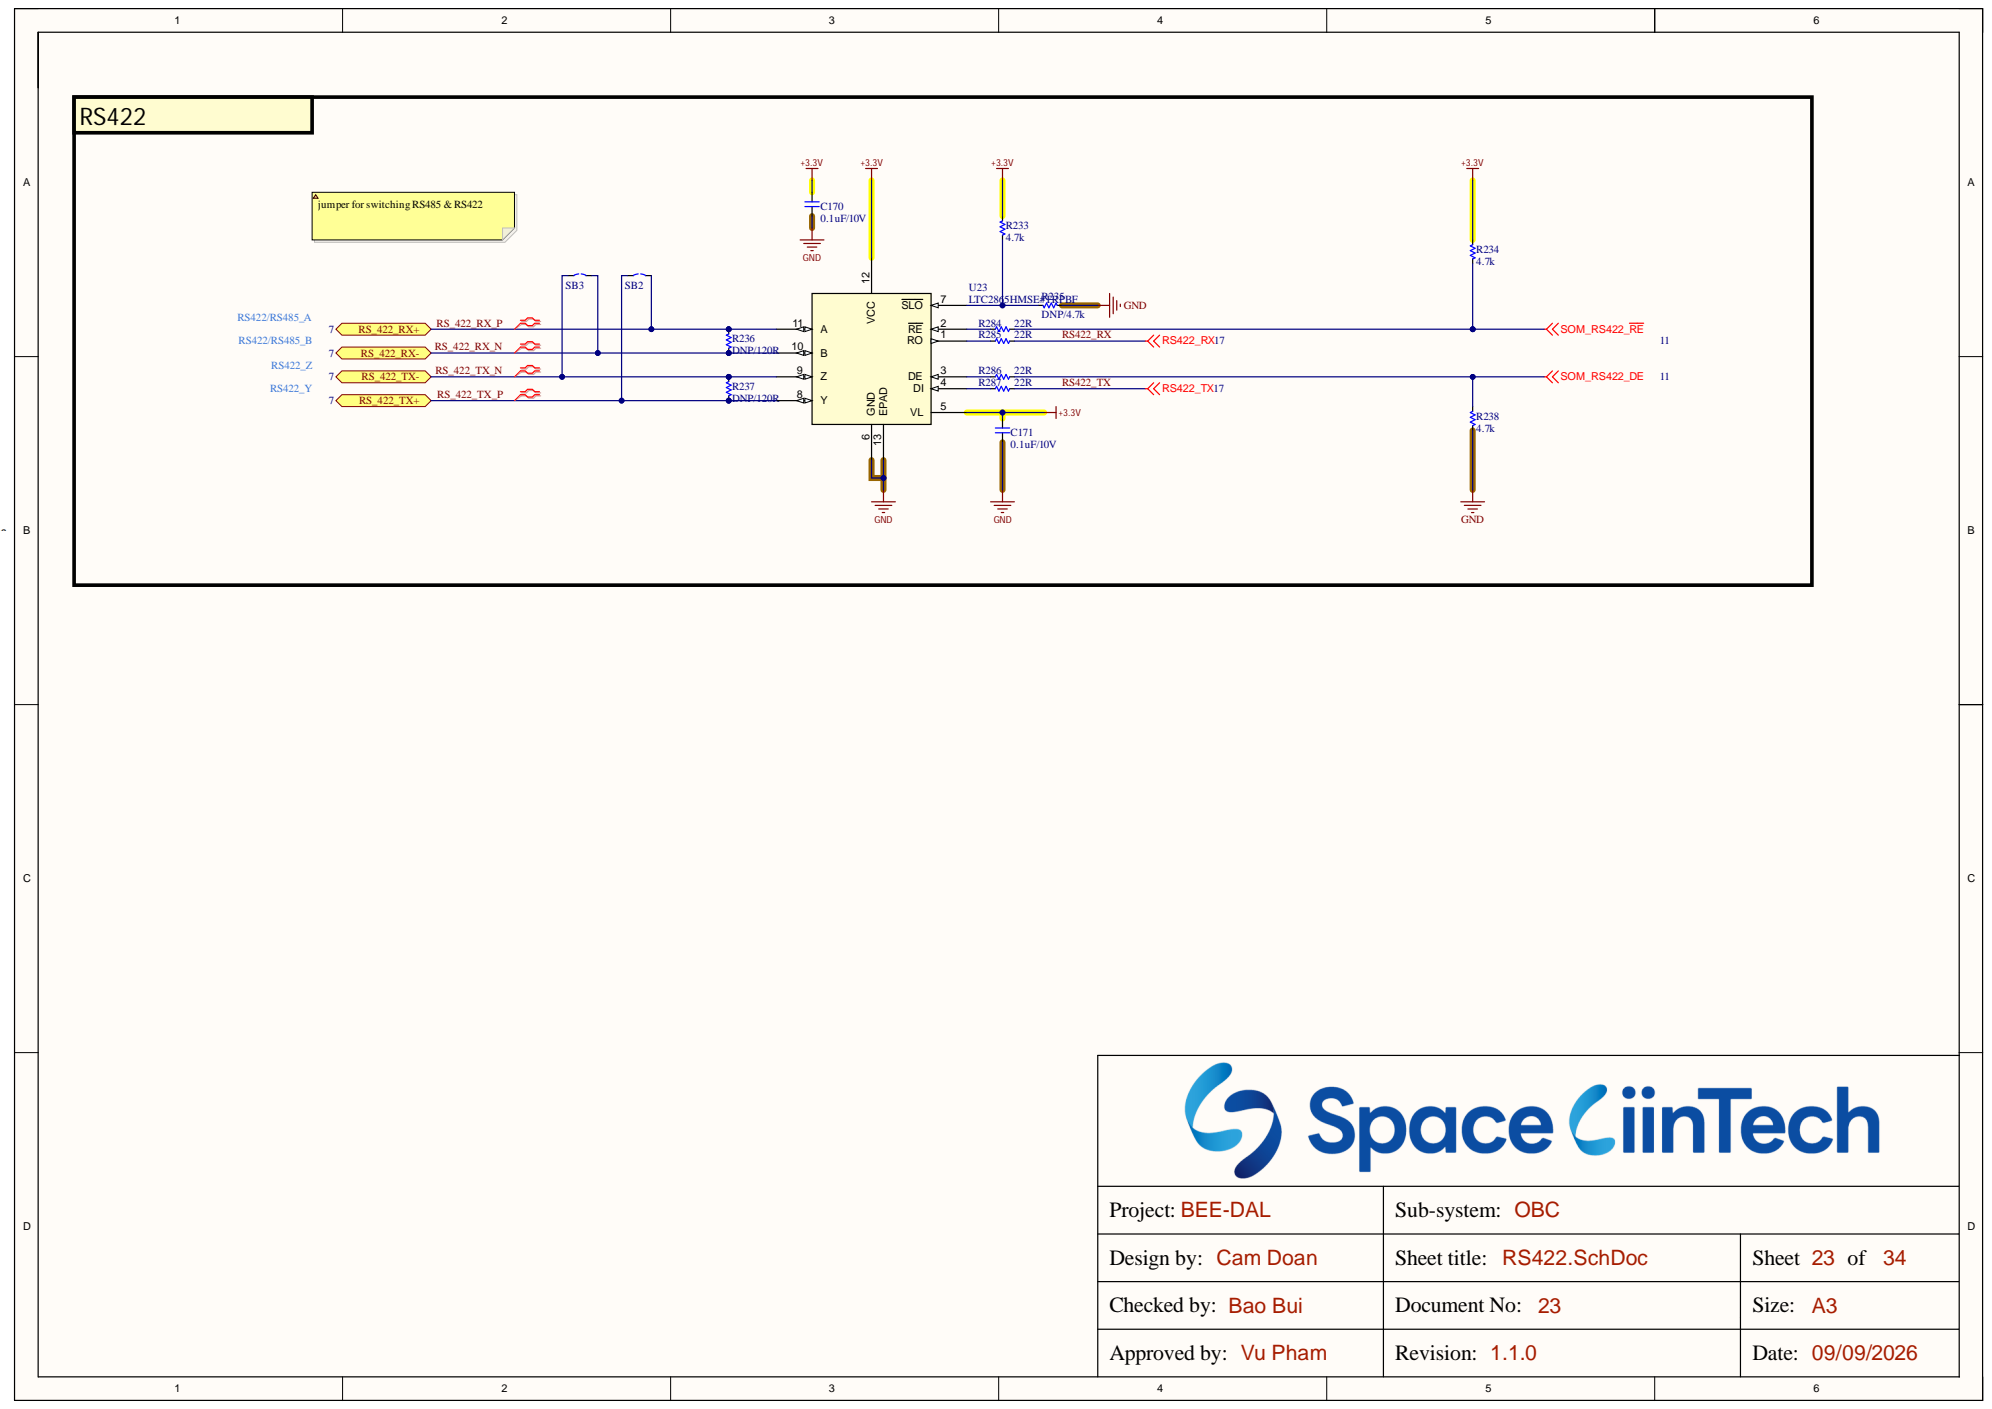
[picture p47: page 23]

Projec t : BEE-DAL | Sub-syste m : OBC

Design by: Cam Do a n | Sheet title: RS4 2 2.Sc hDo c | Shee t 2 3 of 3 4

Checked by: Ba o Bu i | Document No: 2 3 | Size : A3

V u Ph a m | Revisio n : 1.1 . | Date : 9/0

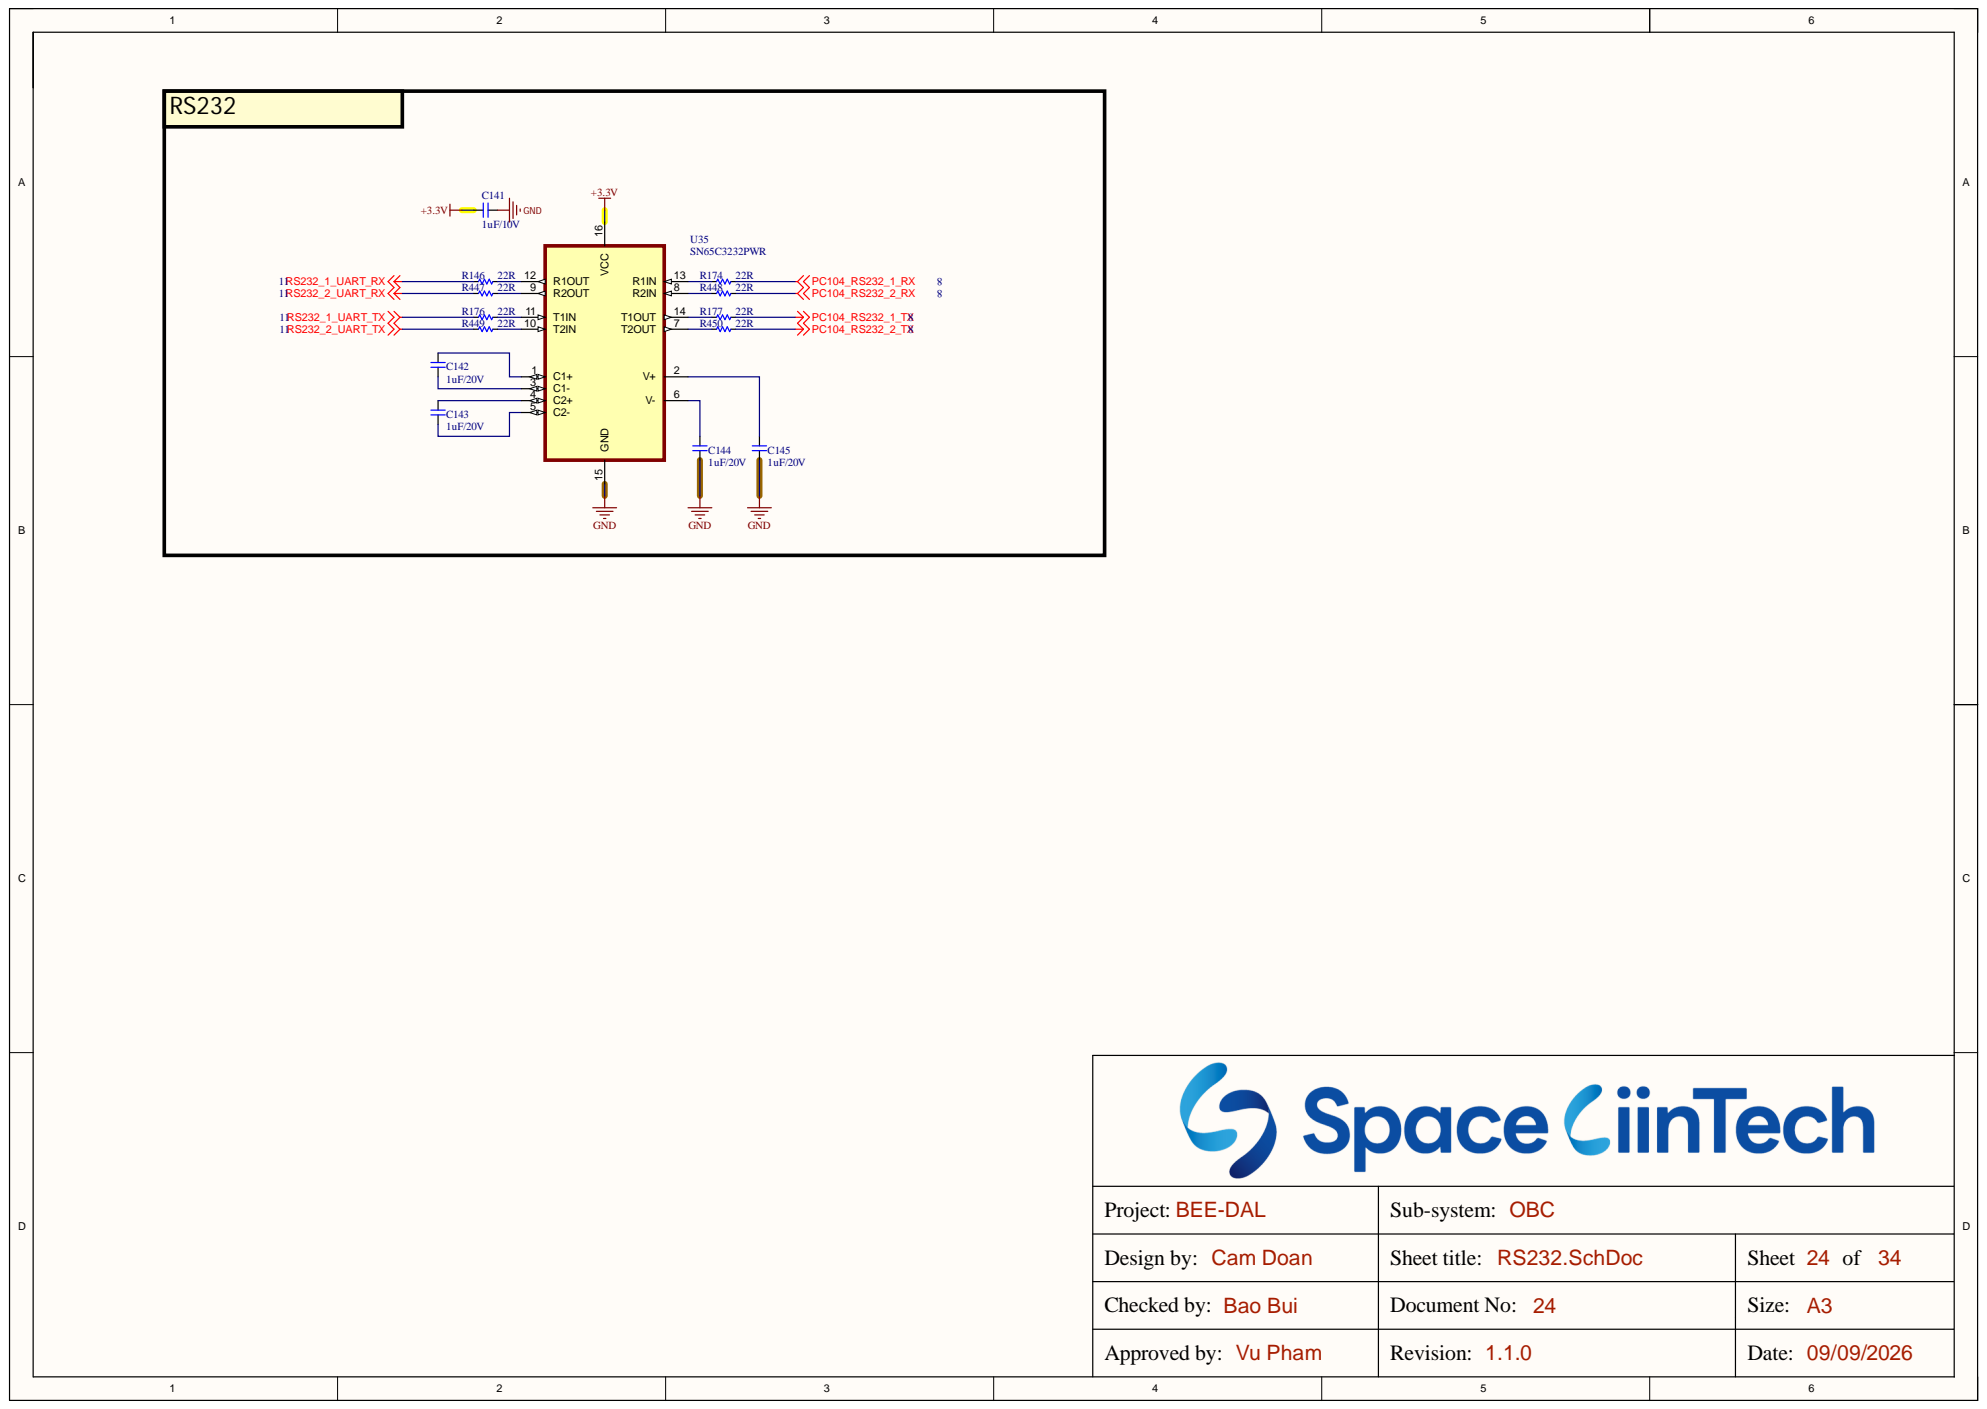
[picture p48: page 24]

Project: BEE-DAL | Sub-system: OBC

Design by: Cam Doan | Sheet title: RS232.SchDoc | Sheet 24 of 34

Checked by: Bao Bui | Document No: 24 | Size: A3

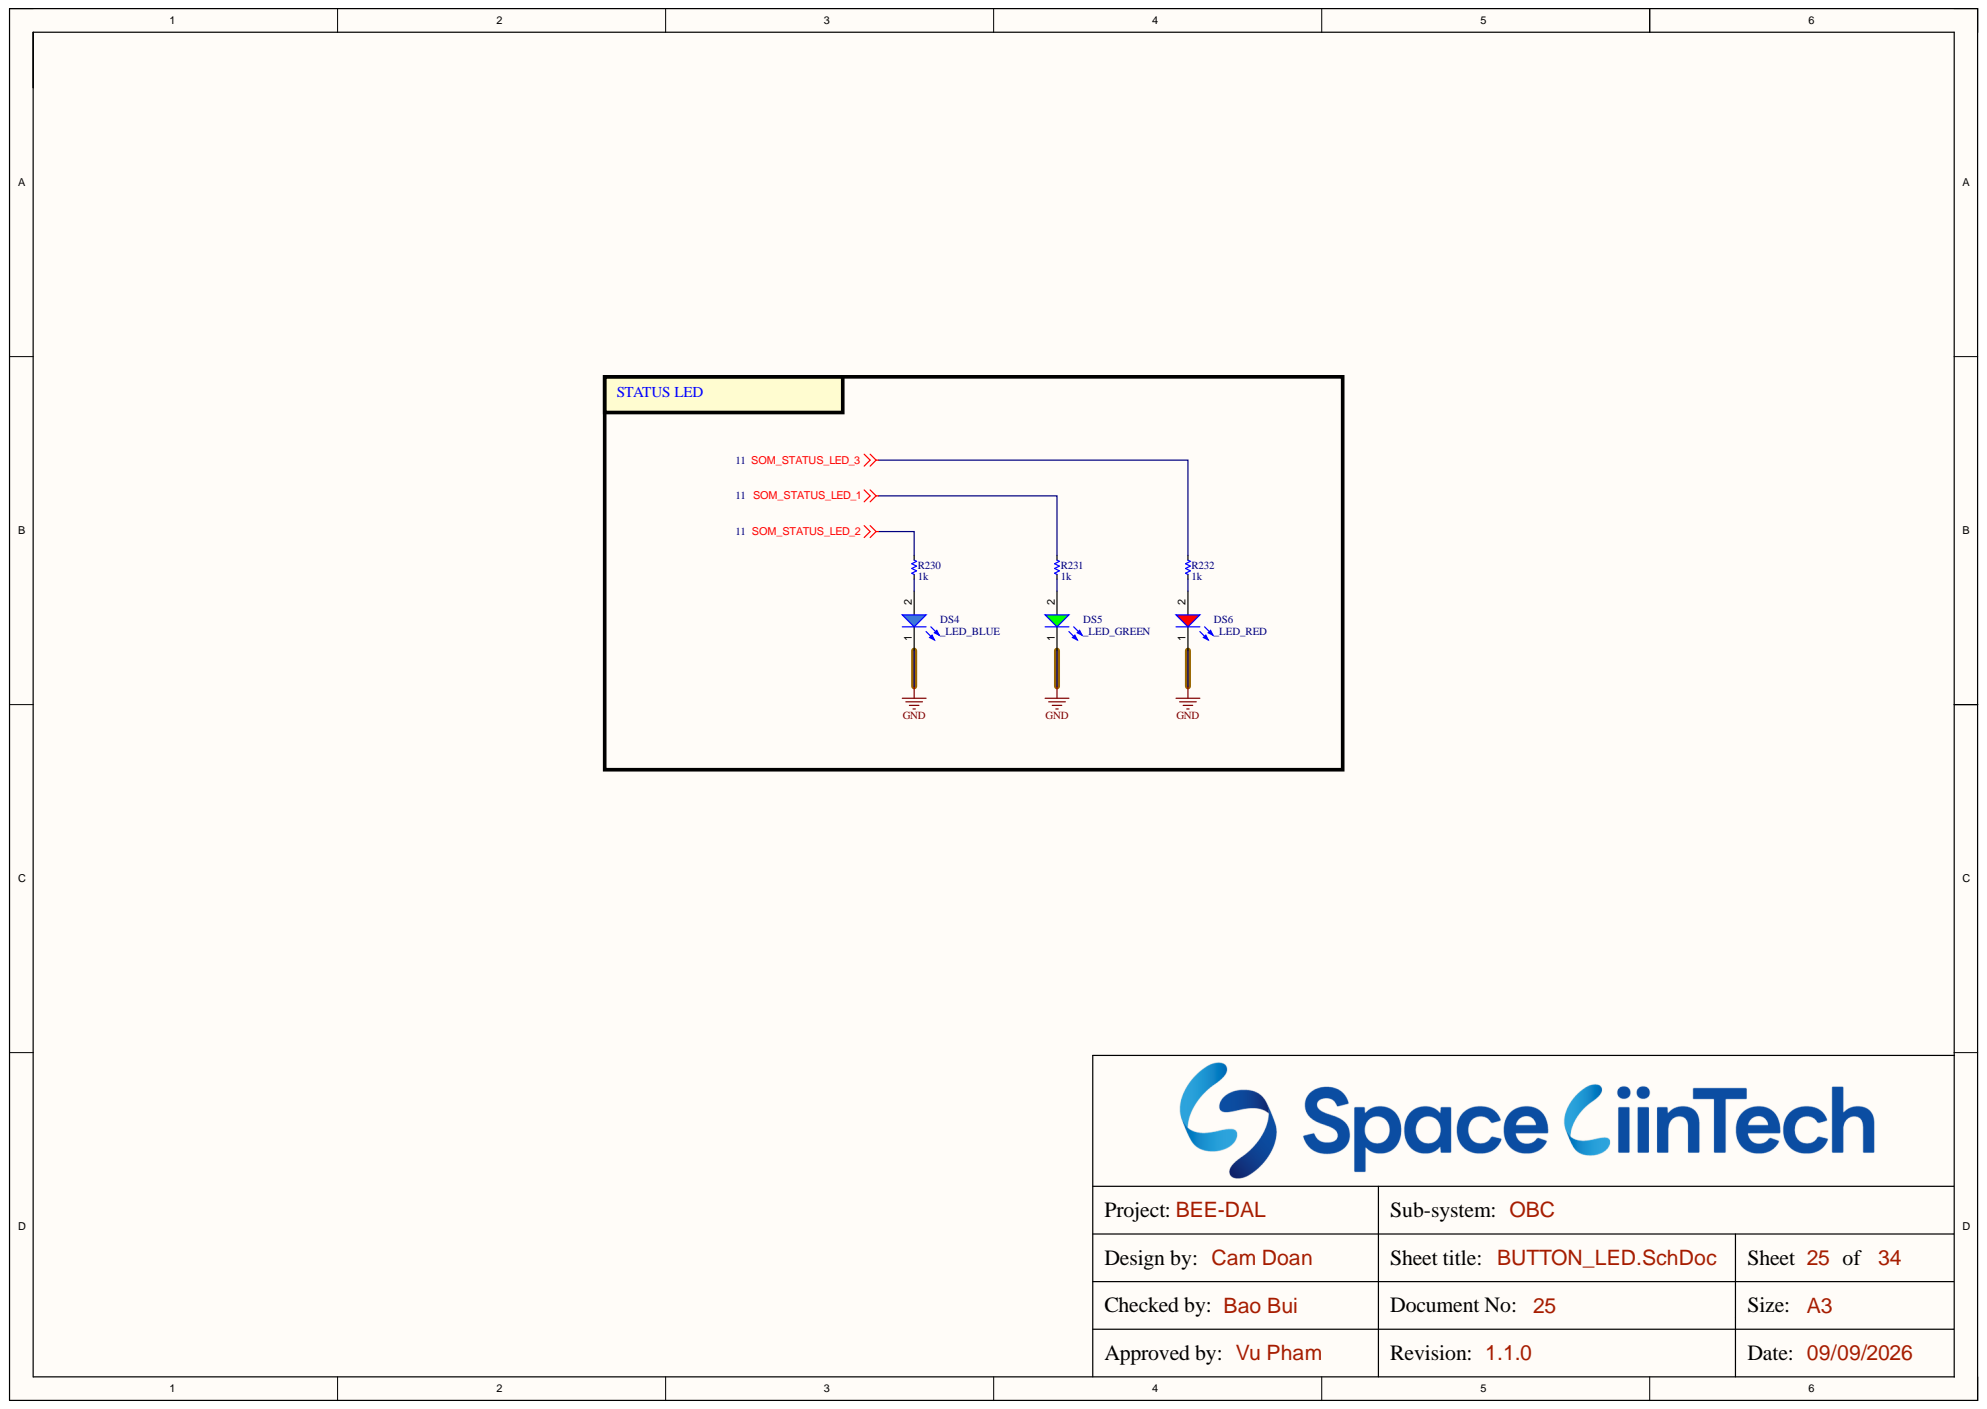
[picture p49: page 25]

Projec t : BEE-DAL | Sub-syste m : OBC

Design by: Cam Do a n | Sheet title: BUT TON_ LED.Sc hDo c | Shee t 2 5 of 3 4

Checked by: Ba o Bu i | Document No: 2 5 | Size : A3

V u Ph a m | Revisio n : 1.1 . | Date : 9/0

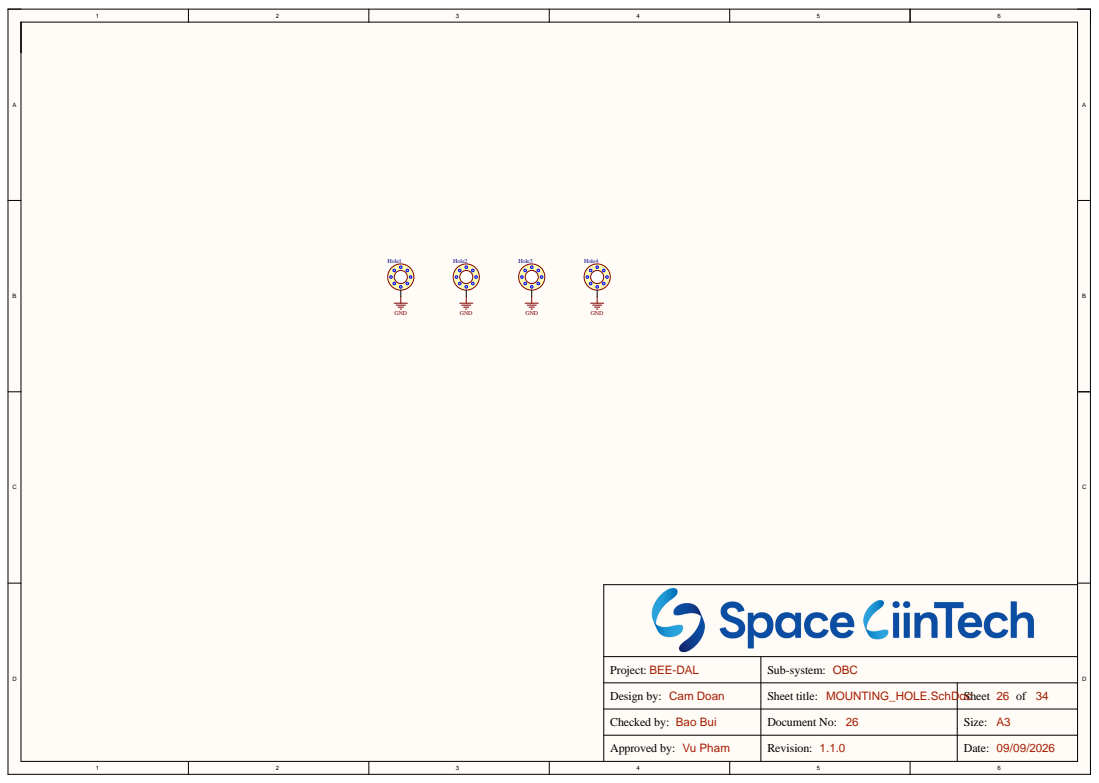
[picture p50: page 26]

Project: BEE-DAL | Sub-system: OBC

Design by: Cam Doan | Sheet title: MOUNTING_HOLE.SchDoc | Sheet 26 of 34

Checked by: Bao Bui | Document No: 26 | Size: A3

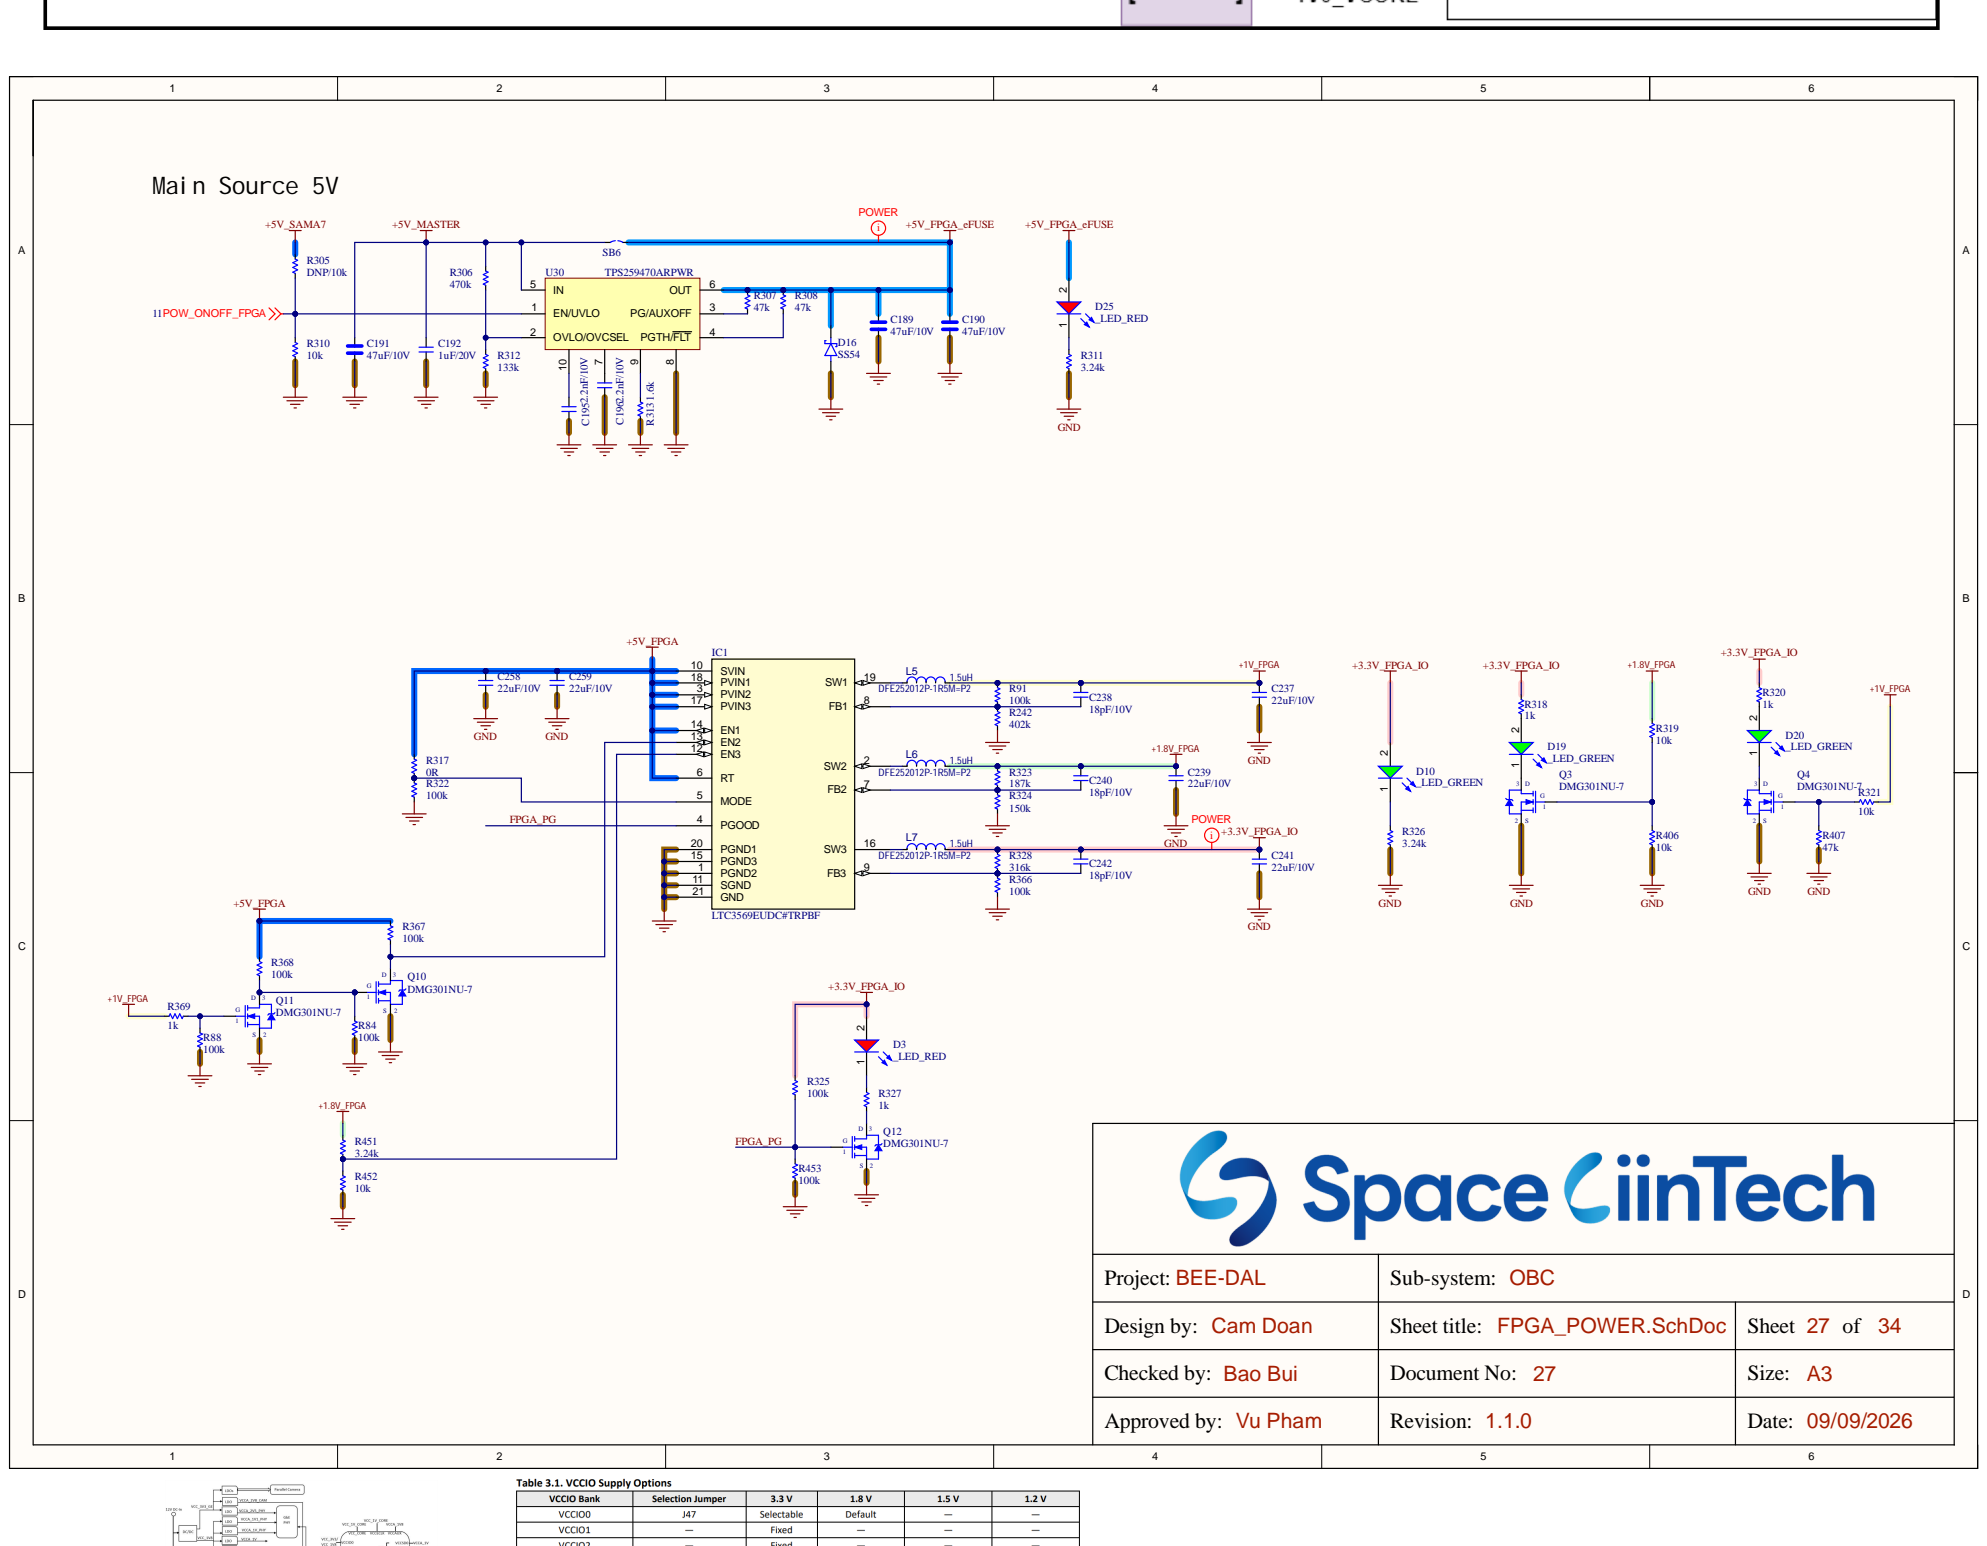
[picture p51: page 27]

1 1

Projec t : BEE-DAL | Sub-syste m : OBC

Design by: Cam Do a n | Sheet title: FPGA_POWER.Sc hDo c | Shee t 2 7 of 3 4

Checked by: Ba o Bu i | Document No: 2 7 | Size : A3

V u Ph a m | Revisio n : 1.1 . | Date : 9/0

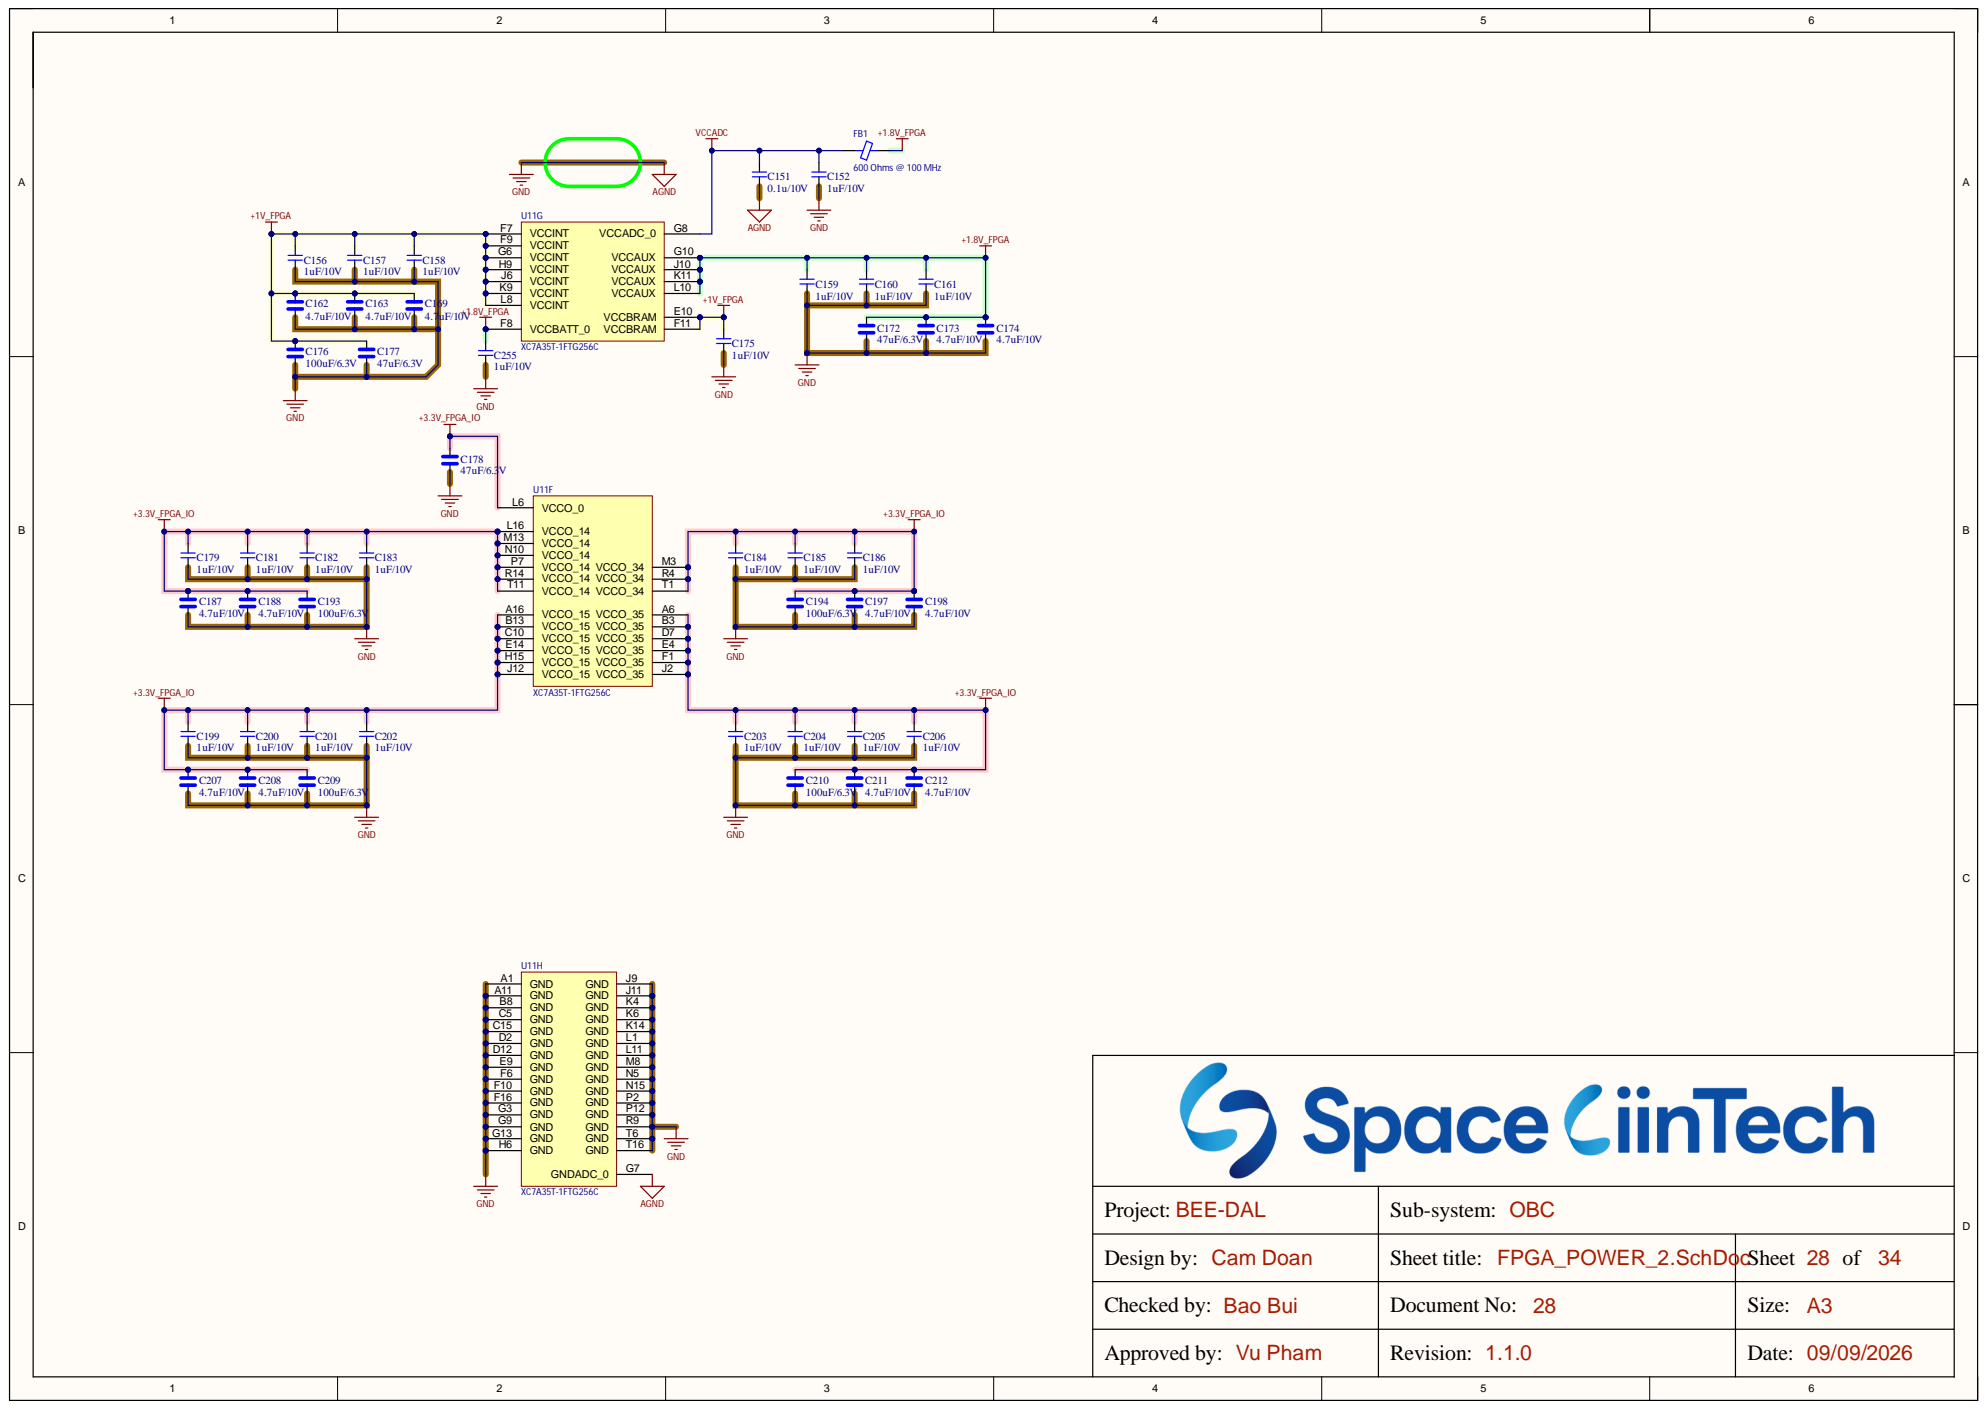
[picture p52: page 28]

Design by: Cam Doan | Sheet title: FPGA_POWER_2.SchDoc | Sheet 28 of 34

Checked by: Bao Bui | Document No: 28 | Size: A3

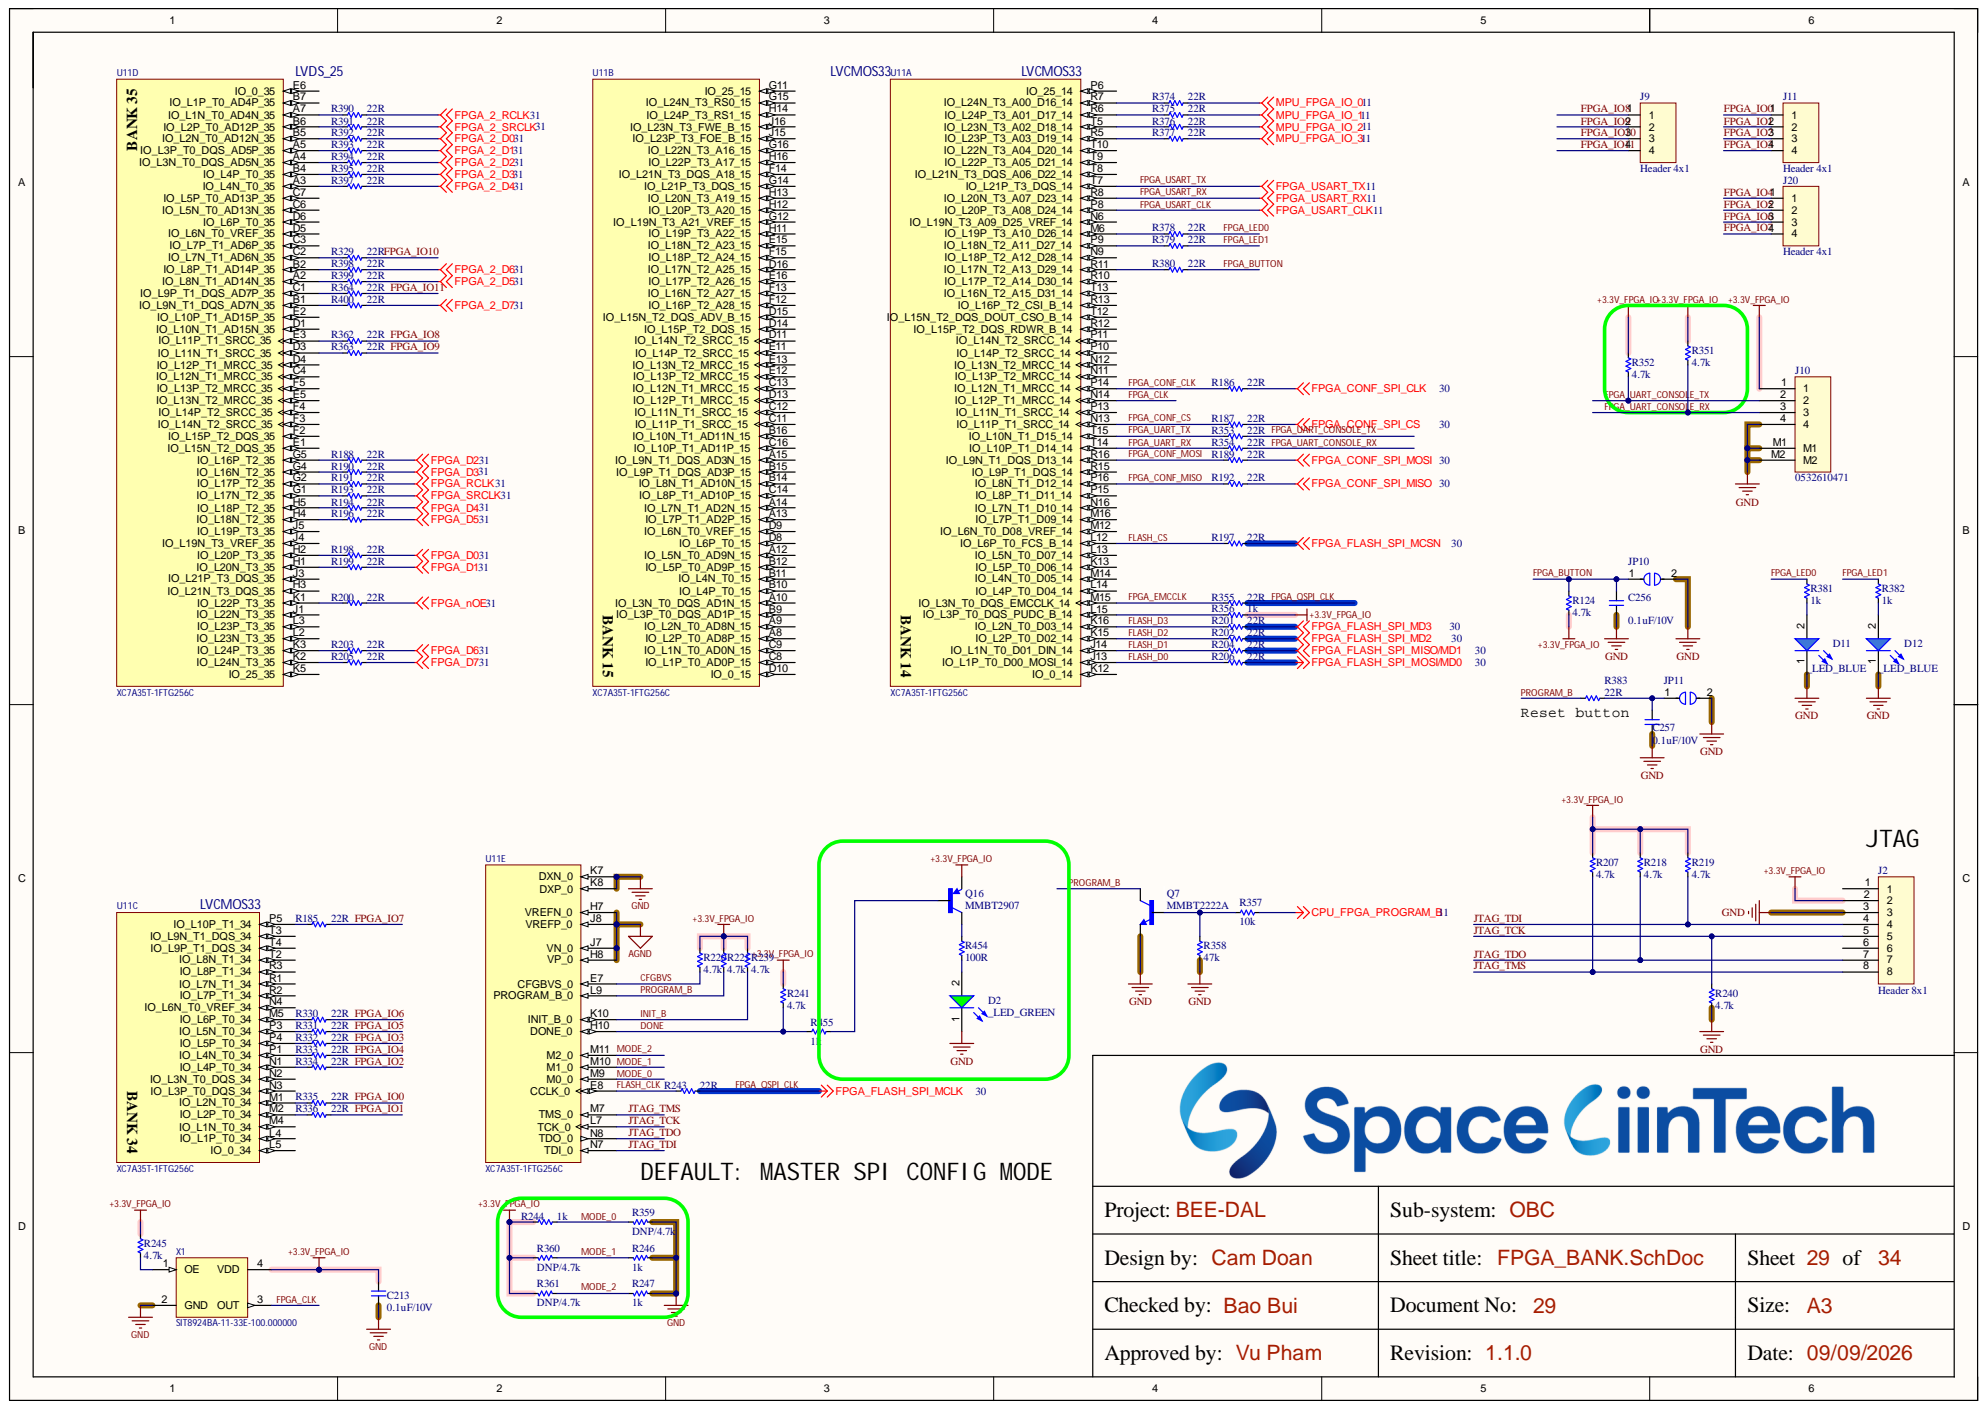
[picture p53: page 29]

Project: BEE-DAL | Sub-system: OBC

Design by: Cam Doan | Sheet title: FPGA_BANK.SchDoc | Sheet 29 of 34

Checked by: Bao Bui | Document No: 29 | Size: A3

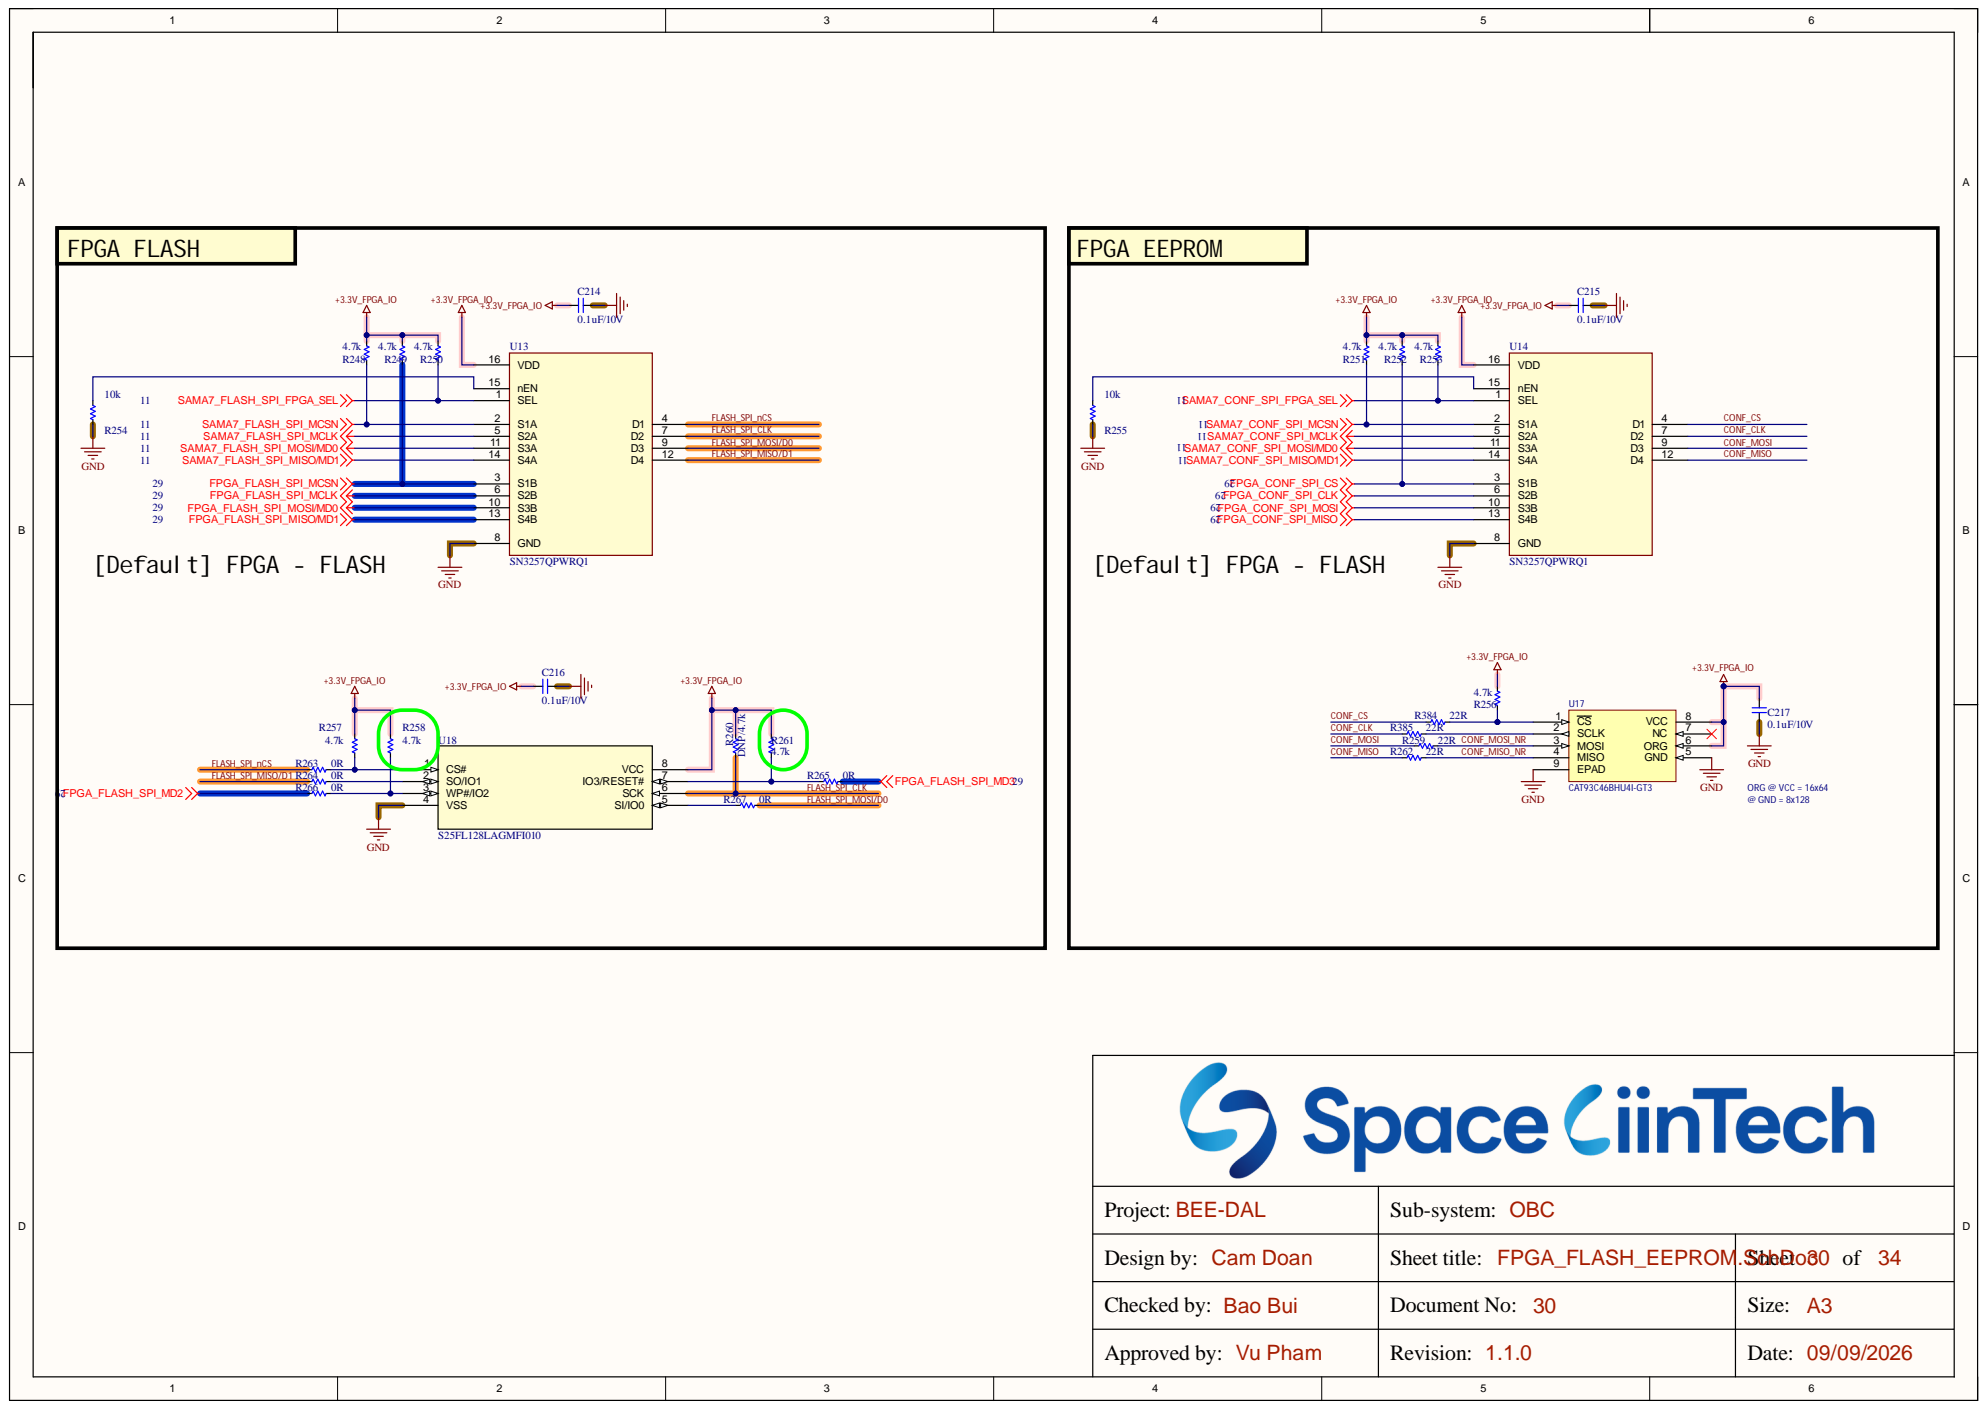
[picture p54: page 30]

Project: BEE-DAL | Sub-system: OBC

Design by: Cam Doan | Sheet title: FPGA_FLASH_EEPROM.SchDoc | Sheet 30 of 34

Checked by: Bao Bui | Document No: 30 | Size: A3

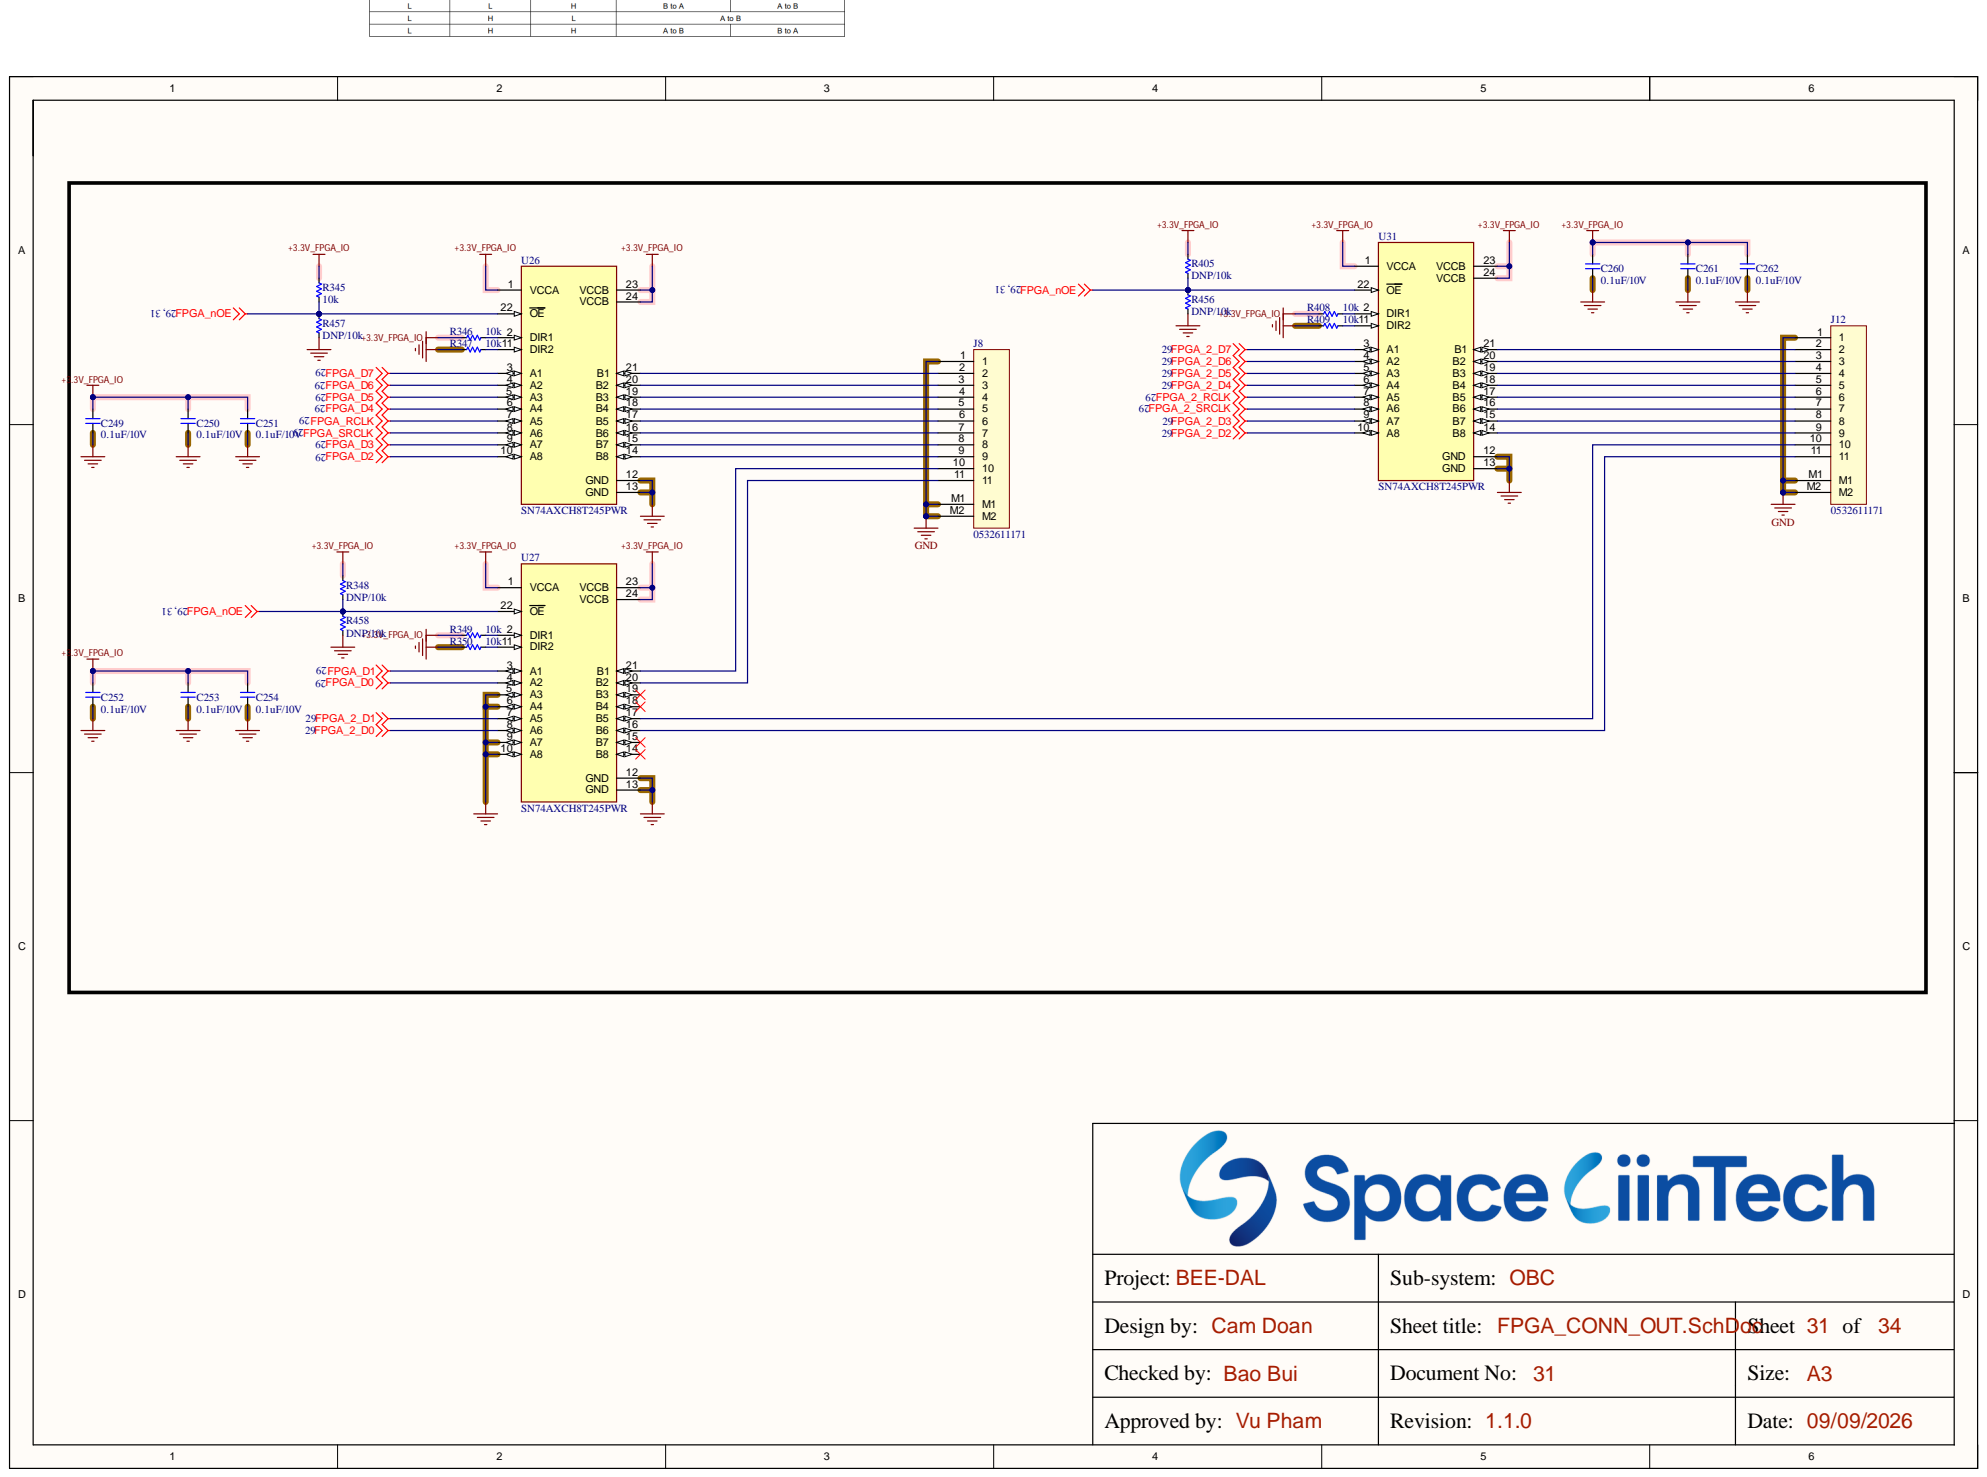
[picture p55: page 31]

Projec t : BEE-DAL | Sub-syste m : OBC

Design by: Cam Do a n | Sheet title: FPGA_CONN_OUT.Sc hDo | Shee c t 3 1 of 3 4

Checked by: Ba o Bu i | Document No: 3 1 | Size : A3

V u Ph a m | Revisio n : 1.1 . | Date : 9/0

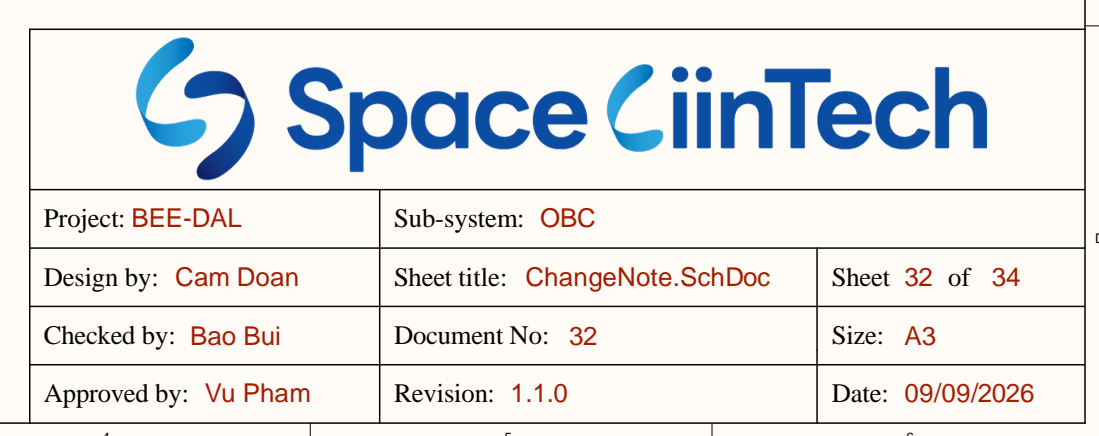
[picture p56: page 32]

Project: BEE-DAL | Sub-system: OBC

Design by: Cam Doan | Sheet title: ChangeNote.SchDoc | Sheet 32 of 34

Checked by: Bao Bui | Document No: 32 | Size: A3

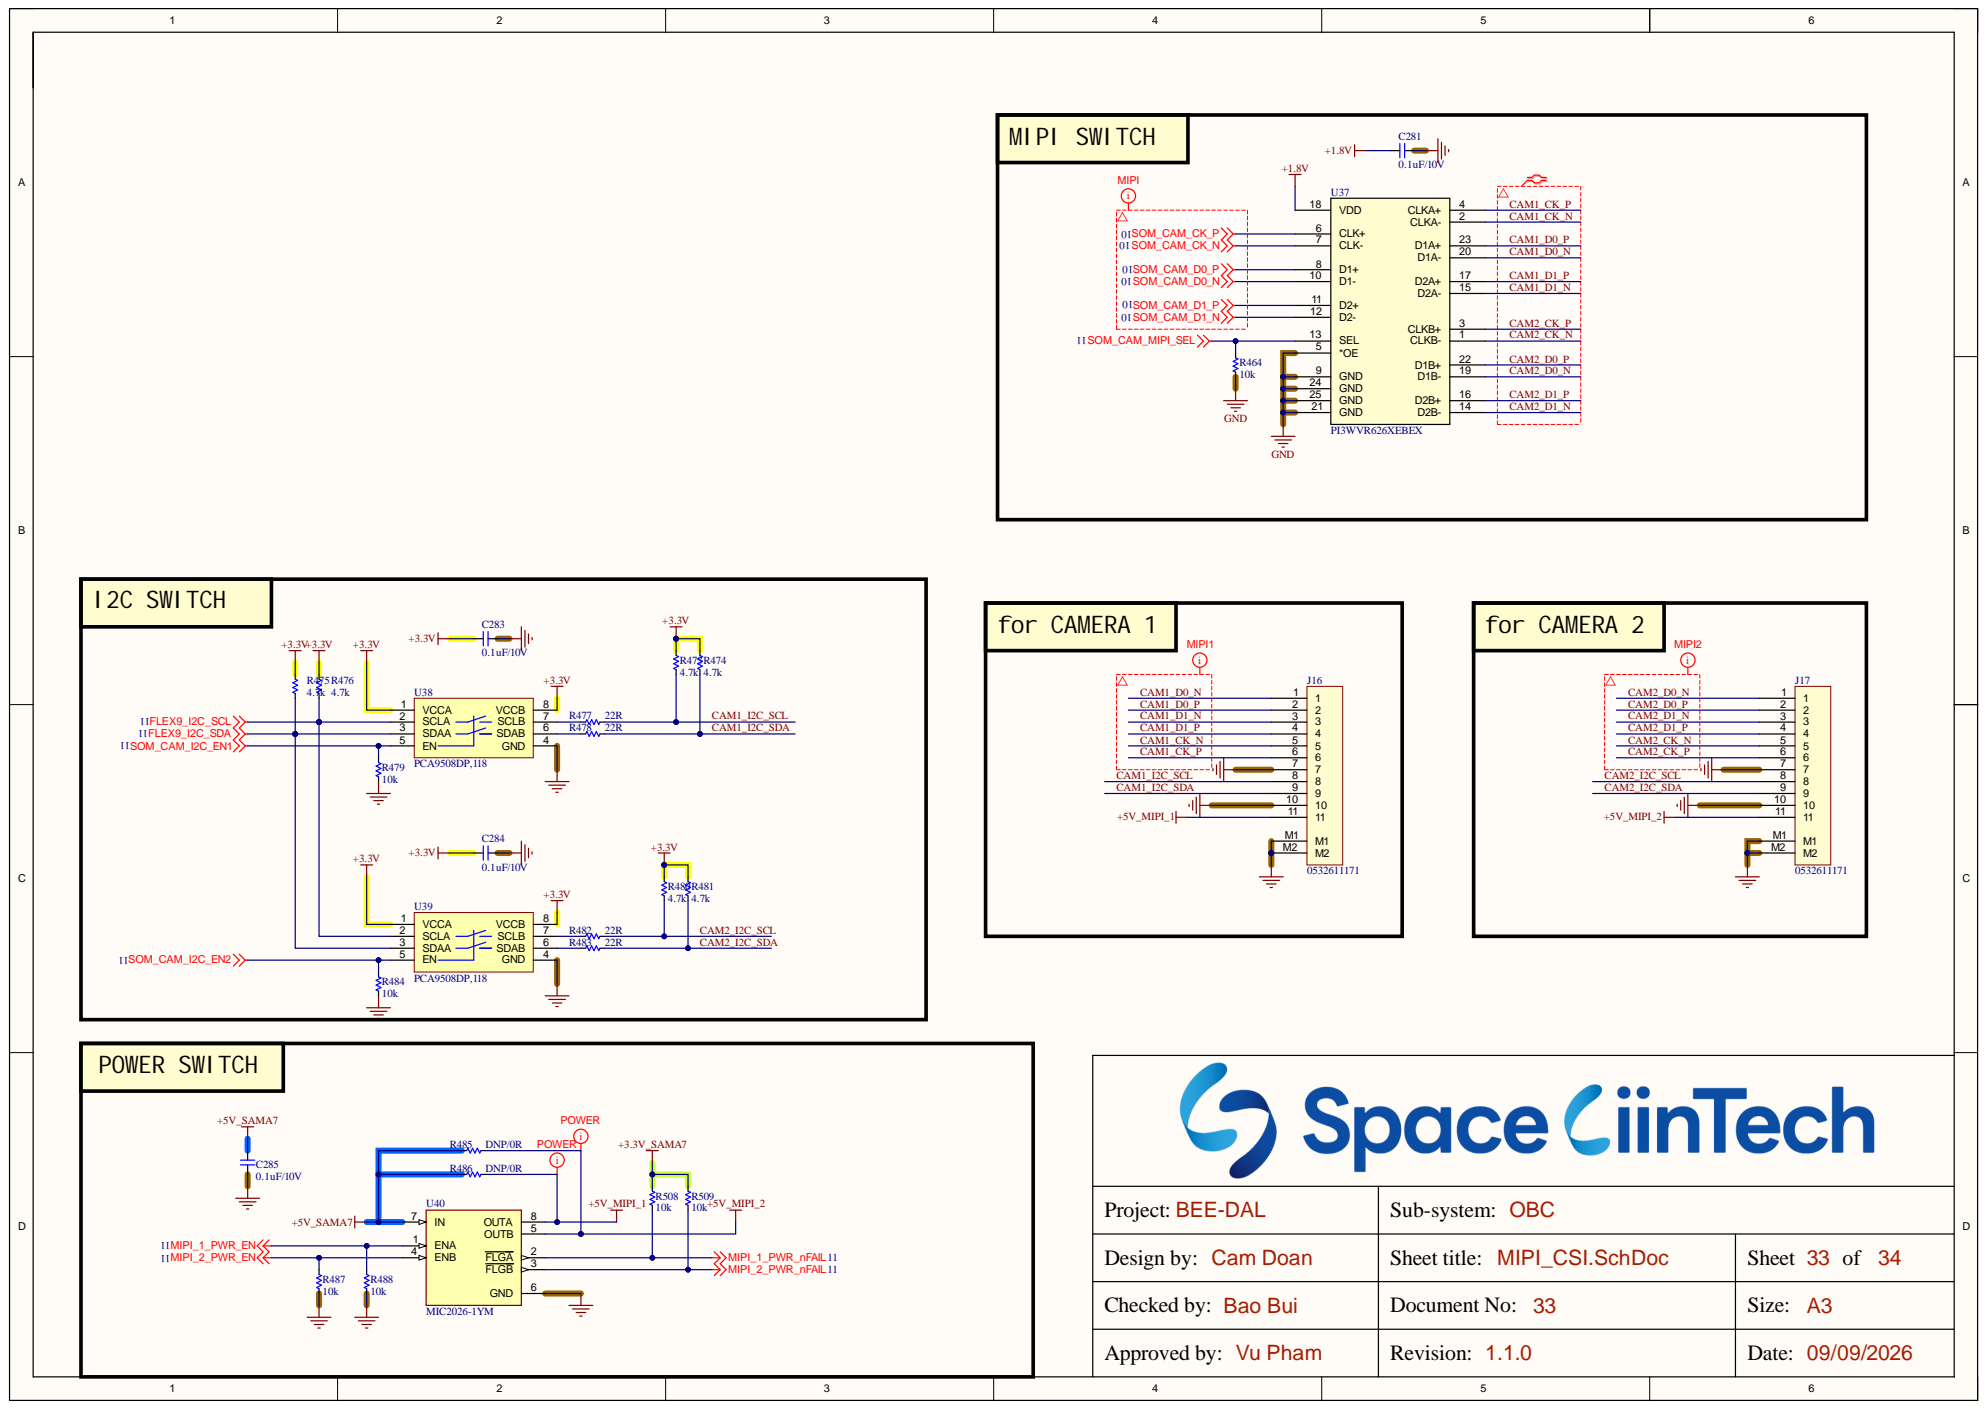
[picture p57: page 33]

Design by: Cam Doan | Sheet title: MIPI_CSI.SchDoc | Sheet 33 of 34

Checked by: Bao Bui | Document No: 33 | Size: A3

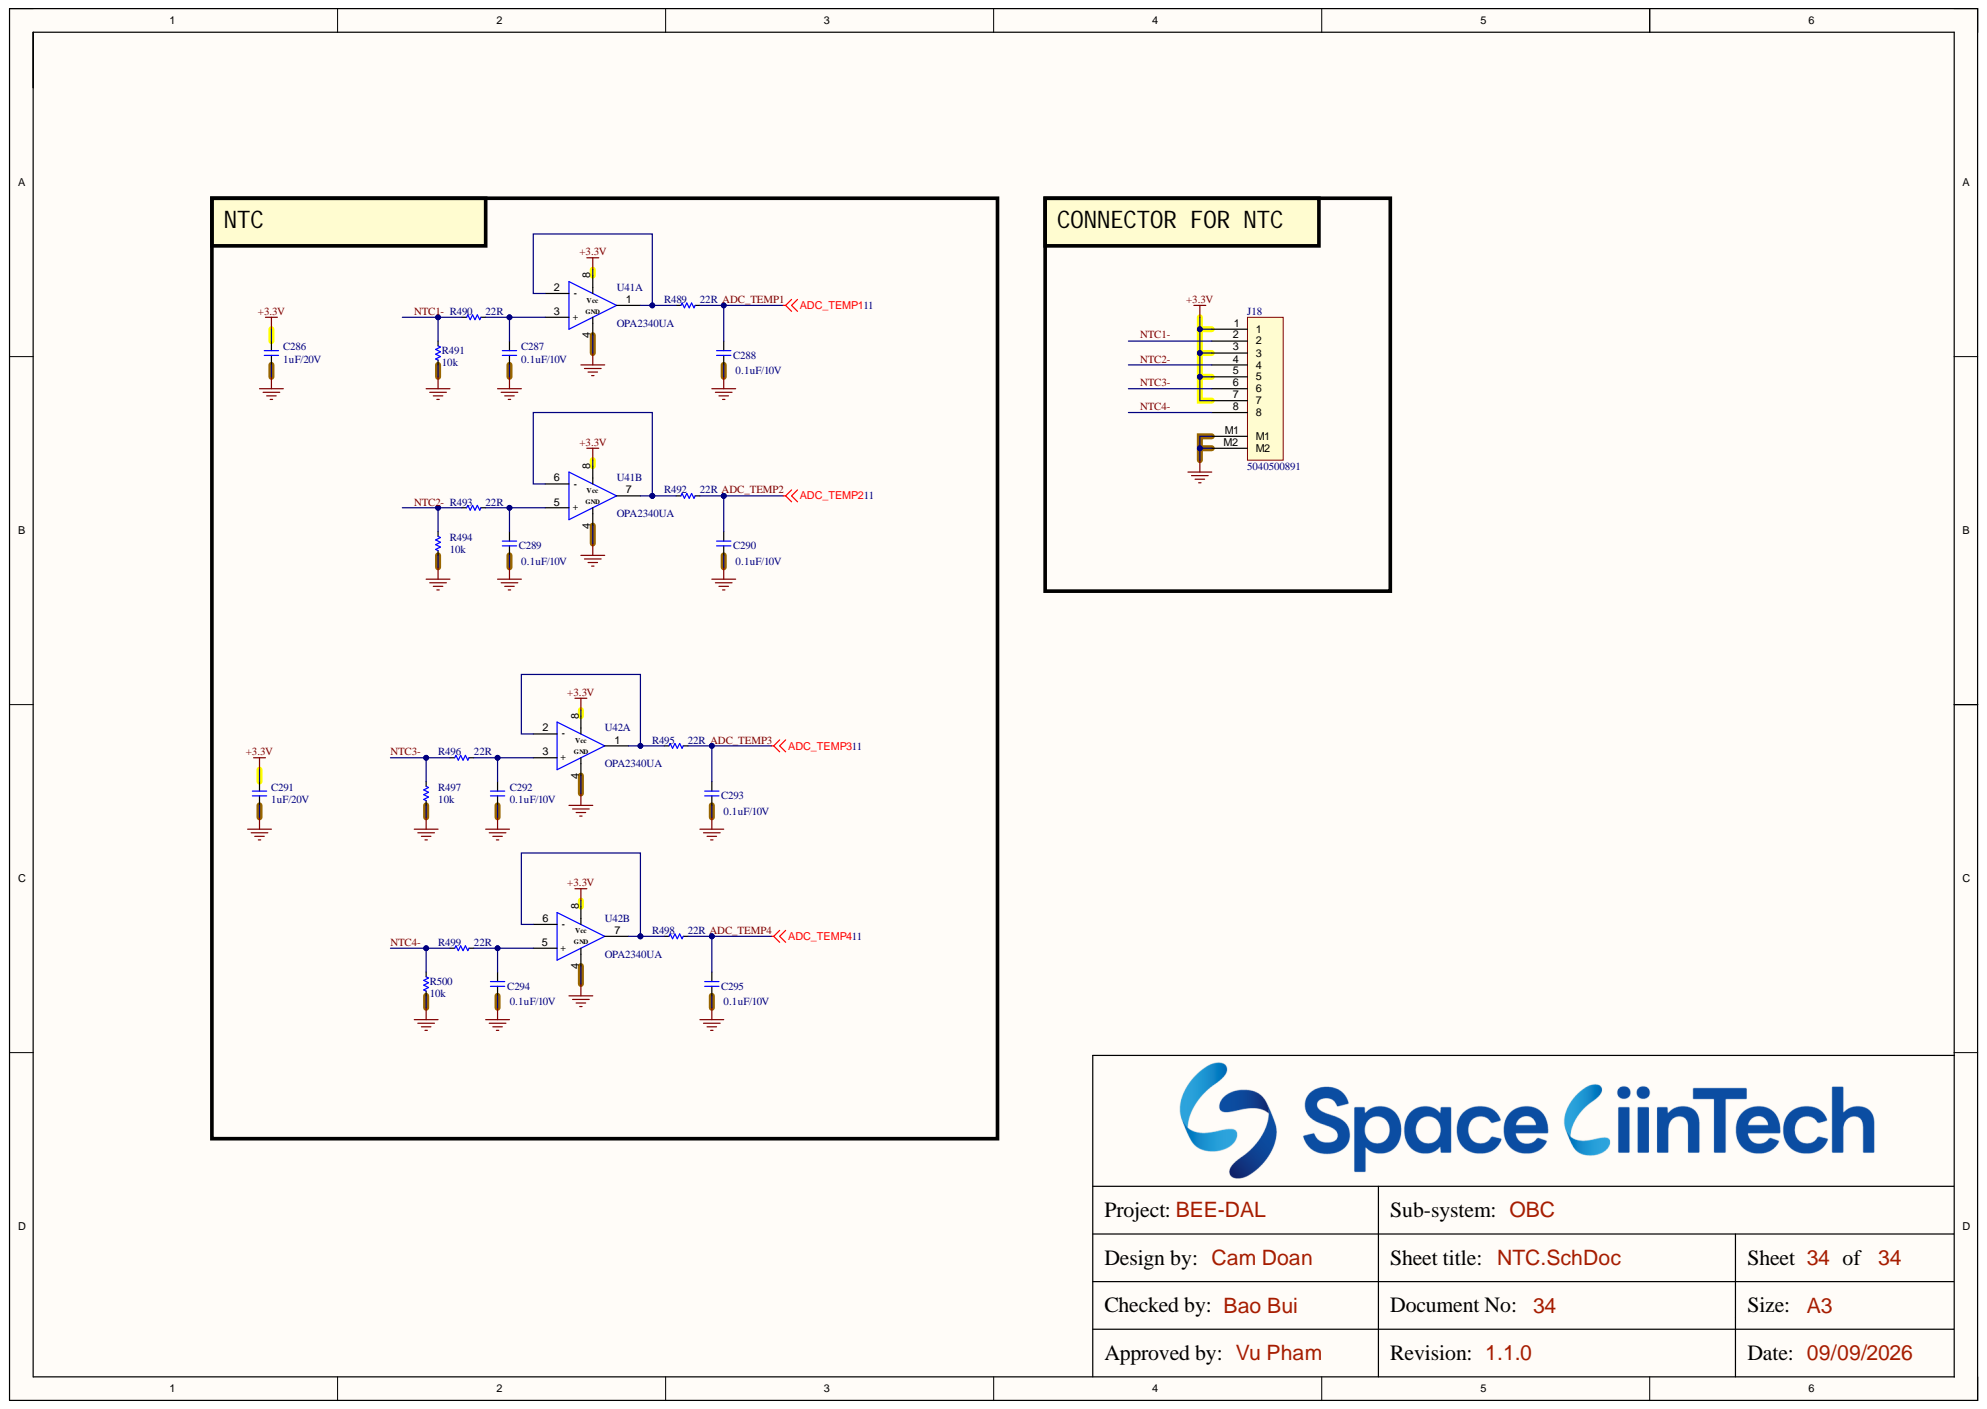
[picture p58: page 34]

Project: BEE-DAL | Sub-system: OBC

Design by: Cam Doan | Sheet title: NTC.SchDoc | Sheet 34 of 34

Checked by: Bao Bui | Document No: 34 | Size: A3

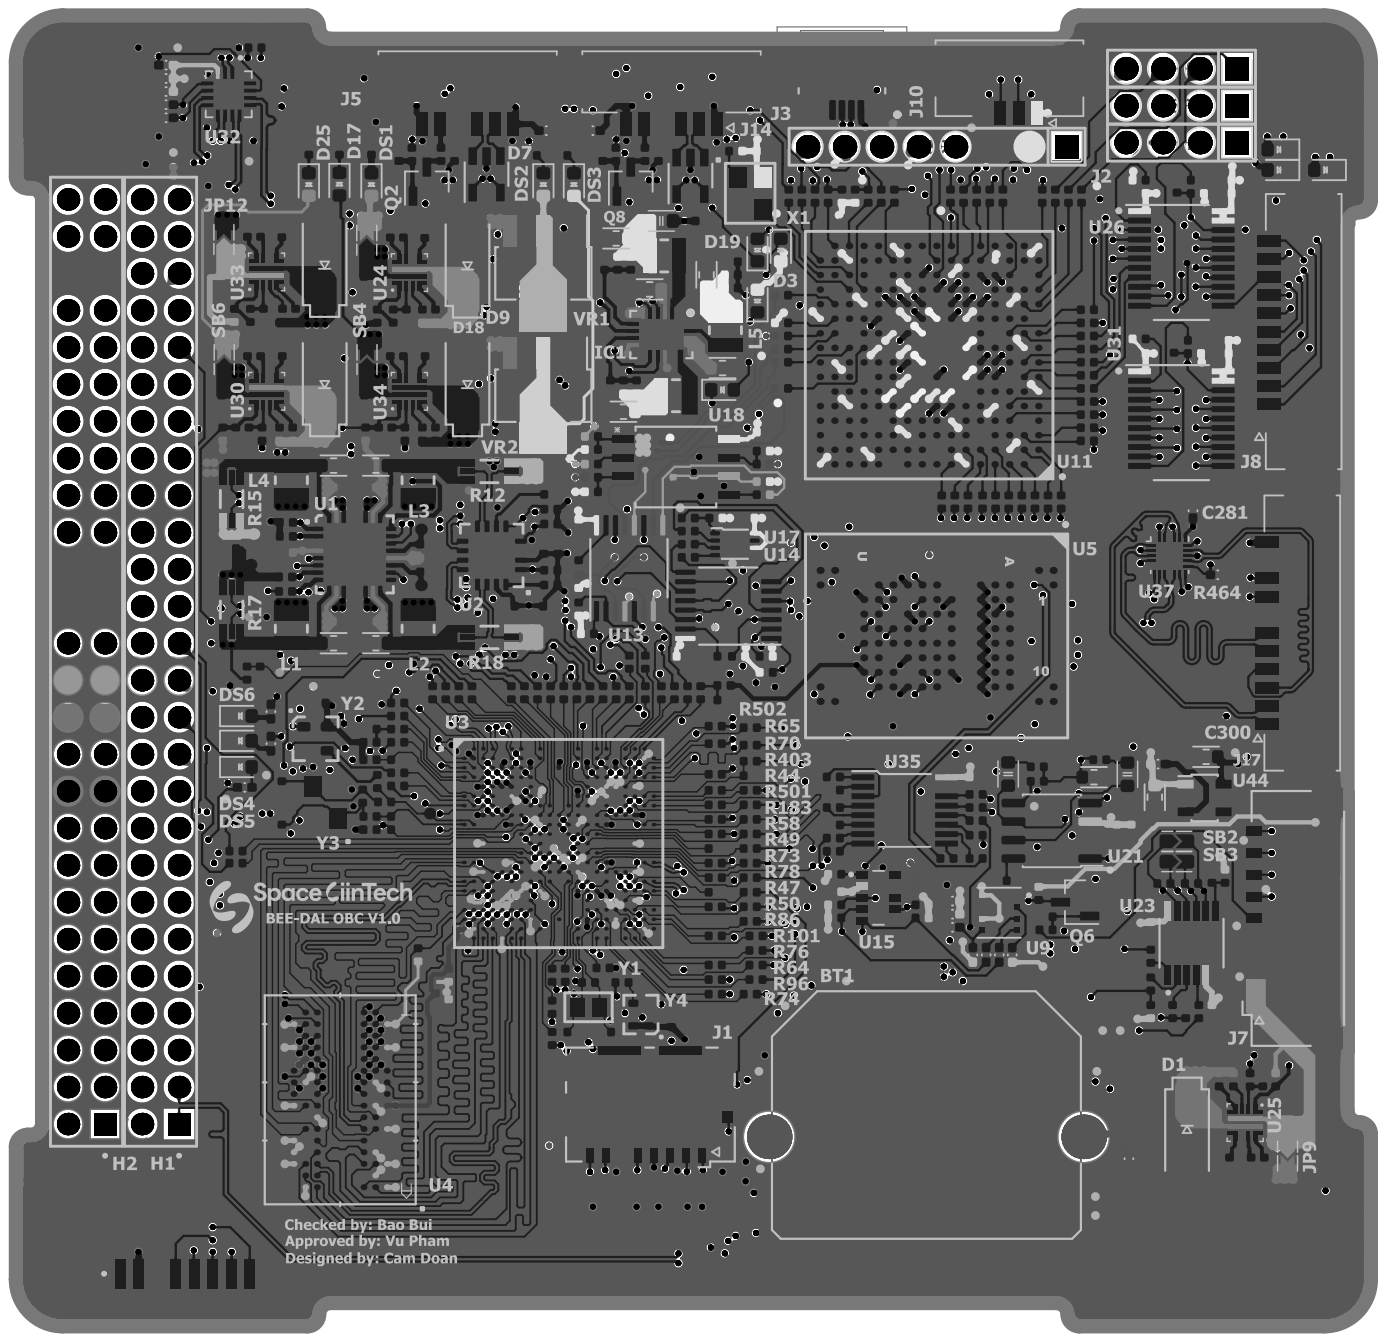
[picture p59: page 35]
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
