baobuibk/SpaceLiinTech_BEE_DAL_OBC_HW/05_SMT/DRAWING DAL OBC V11.pdf

A

B

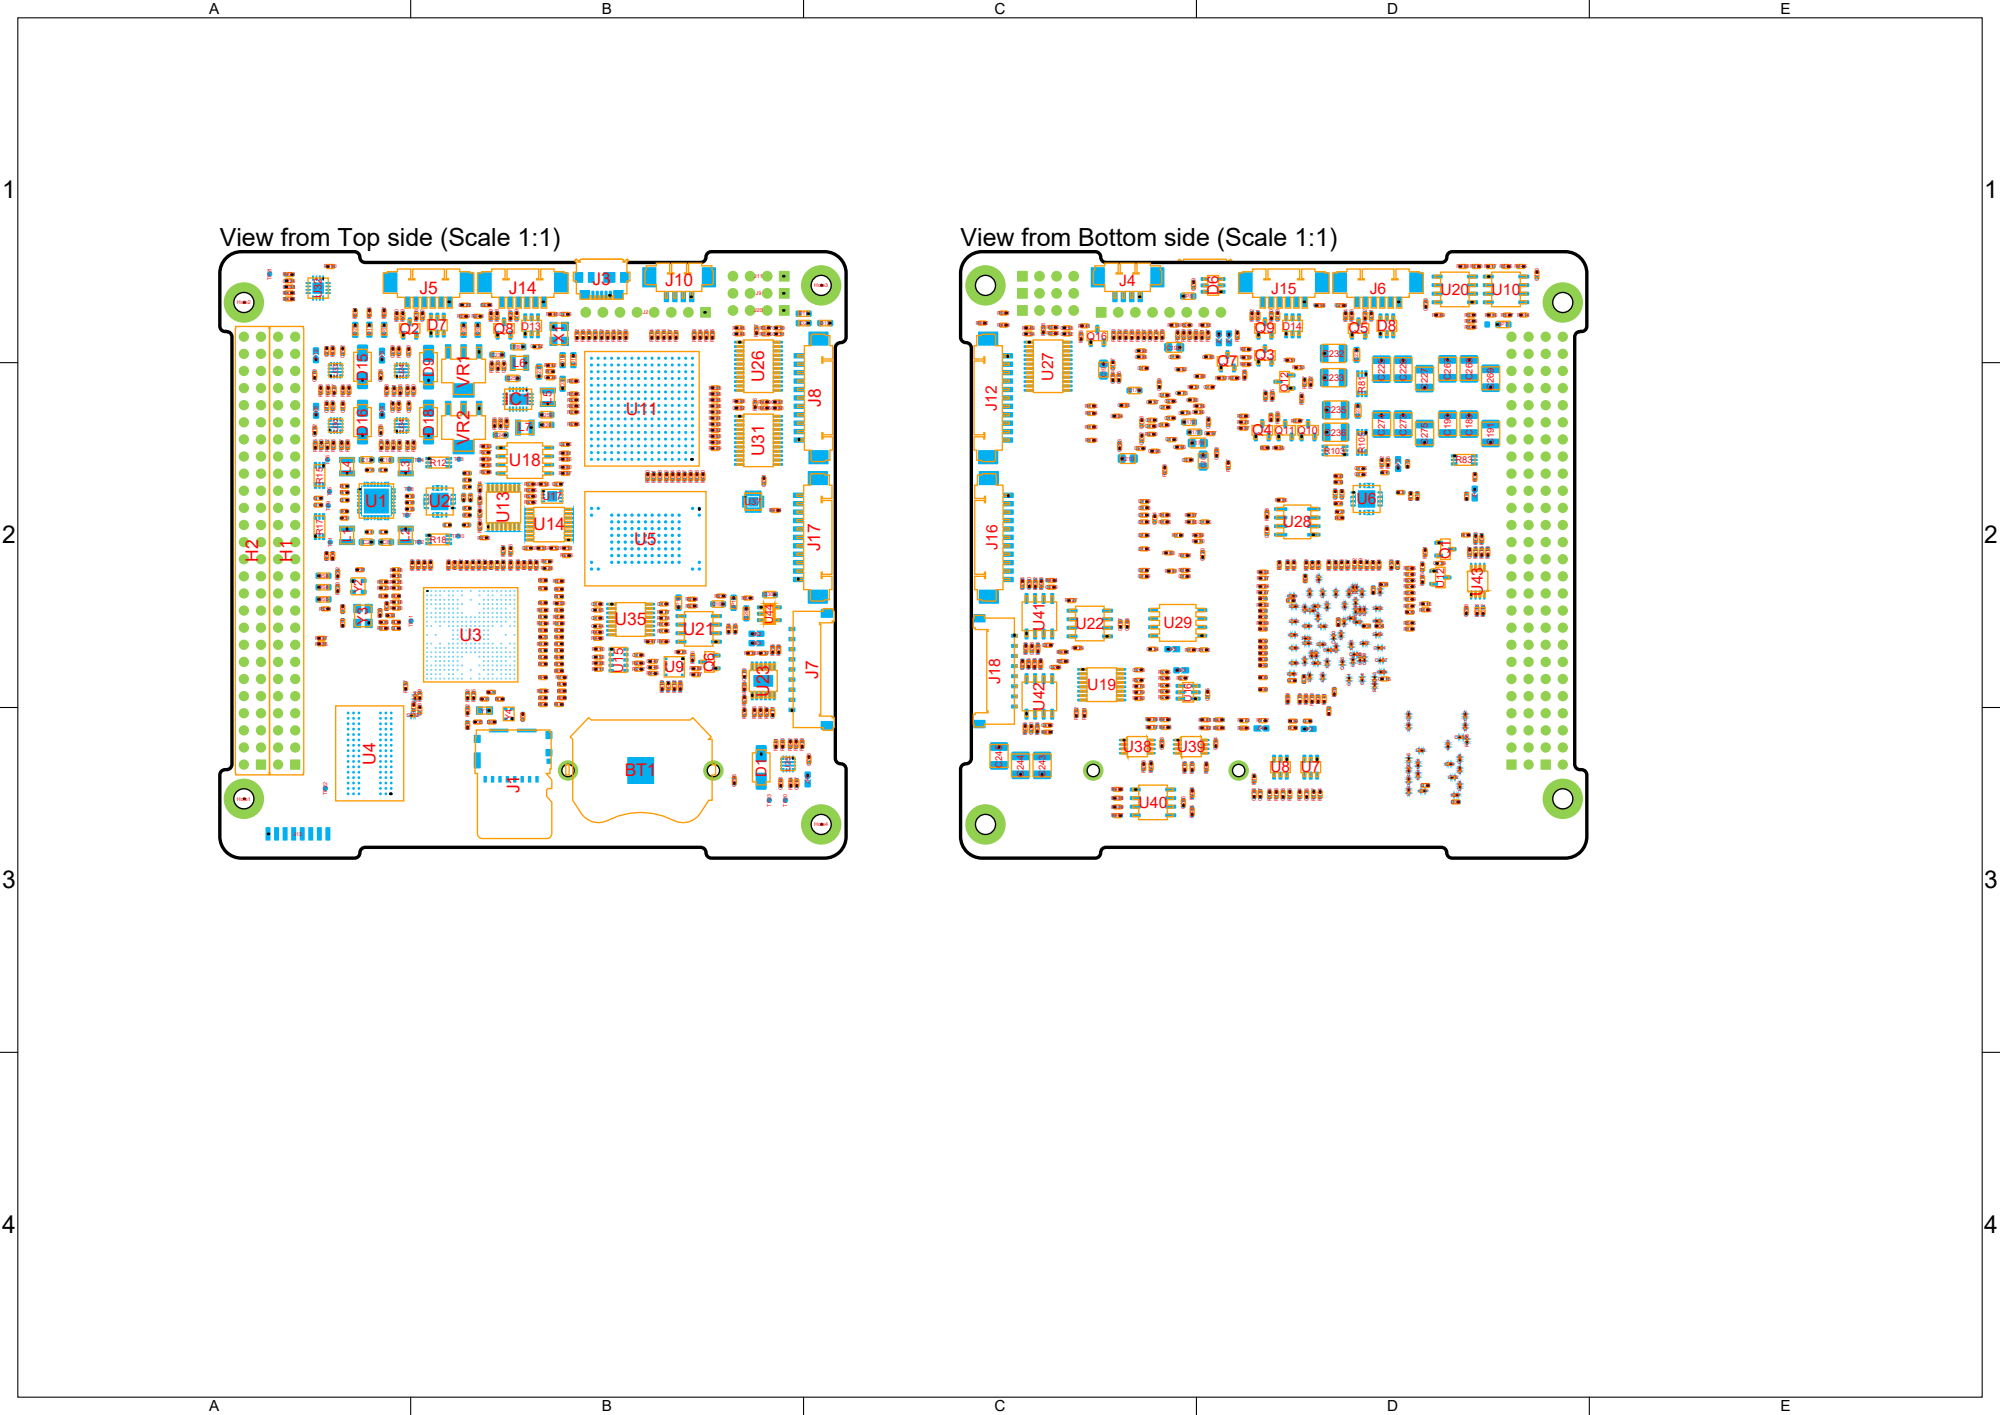
[picture p60: page 1]

View from Top side (Scale 1:1)

View from Bottom side (Scale 1:1)
