baobuibk/SpaceLiinTech_BEE_DAL_OBC_HW/02_Sche_PDF/DAL_OBC_V103.pdf

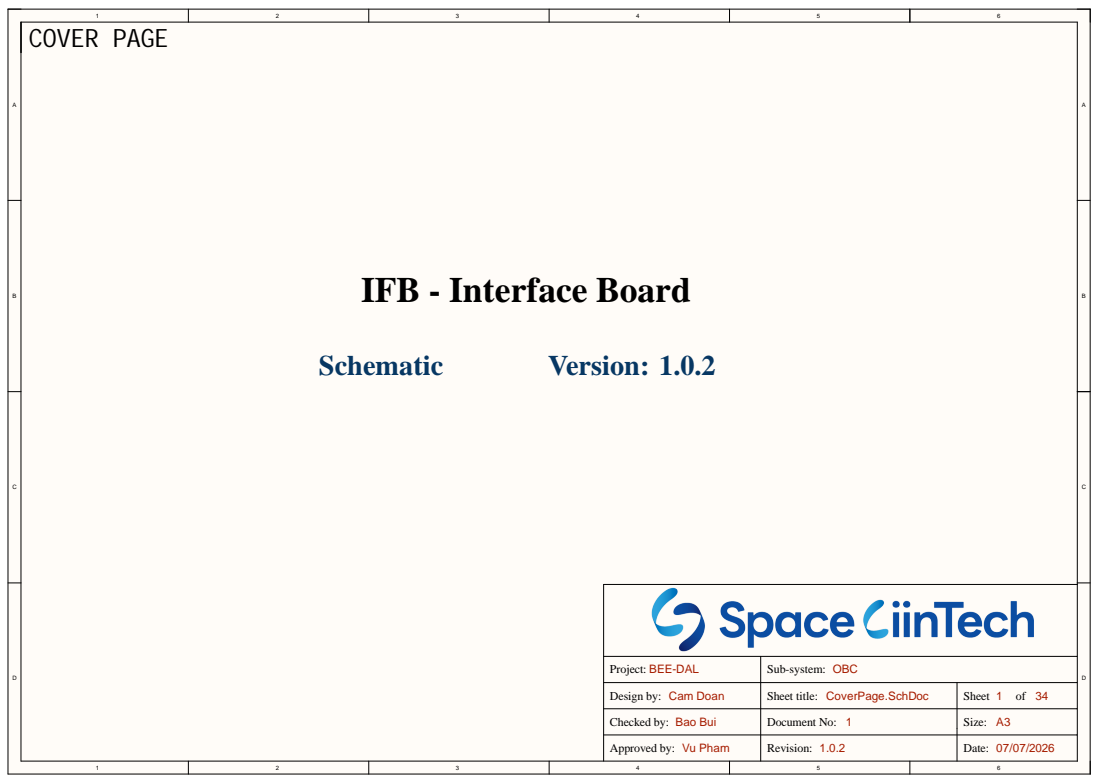
[picture p61: page 1]

BEE-DAL Project: | OBC Sub-system:

Design by: Cam Doan | Sheet title: CoverPage.SchDoc | Sheet 1 of 34

Checked by: Bao Bui | Document No: 1 | Size: A3

Approved by: Vu Pham | Revision: 1.0.2 | Date: 07/07/2026

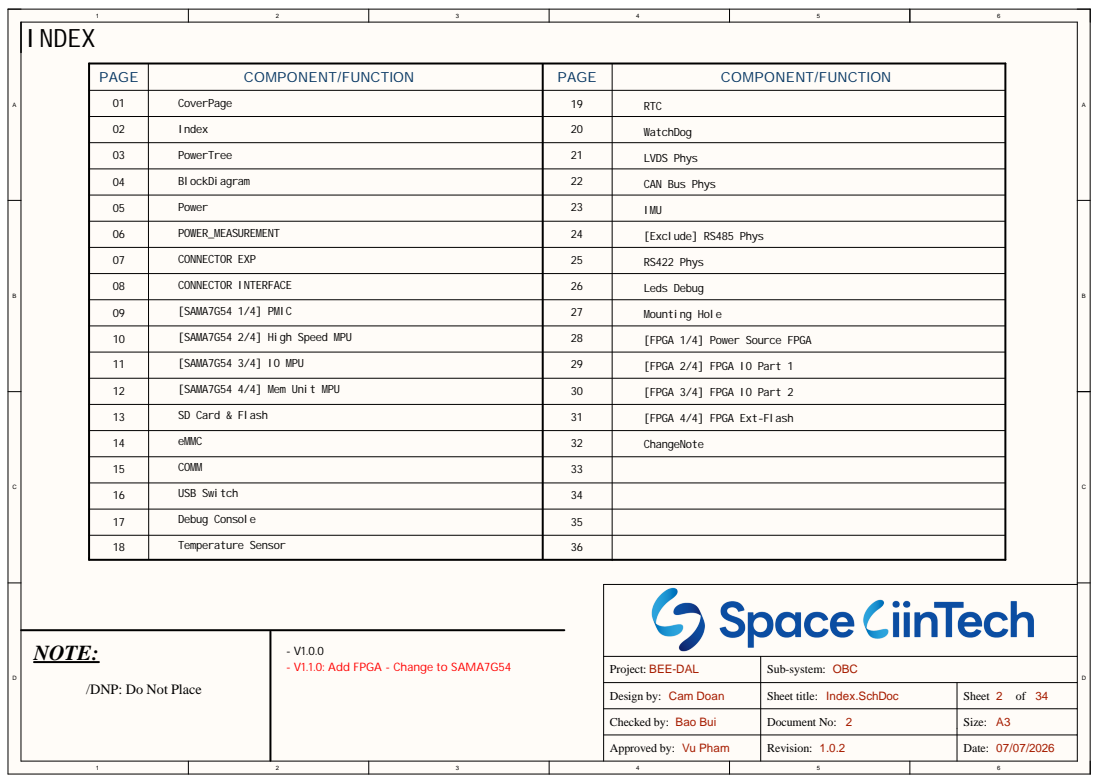
[picture p62: page 2]

PAGE | COMPONENT/FUNCTION | PAGE | COMPONENT/FUNCTION

01 | CoverPage | 19 | RTC

02 | Index | 20 | WatchDog

03 | PowerTree | 21 | LVDS Phys

04 | BlockDiagram | 22 | CAN Bus Phys

05 | Power | 23 | IMU

06 | POWER_MEASUREMENT | 24 | [Exclude] RS485 Phys

07 | CONNECTOR EXP | 25 | RS422 Phys

08 | CONNECTOR INTERFACE | 26 | Leds Debug

09 | [SAMA7G54 1/4] PMIC | 27 | Mounting Hole

10 | [SAMA7G54 2/4] High Speed MPU | 28 | [FPGA 1/4] Power Source FPGA

11 | [SAMA7G54 3/4] IO MPU | 29 | [FPGA 2/4] FPGA IO Part 1

12 | [SAMA7G54 4/4] Mem Unit MPU | 30 | [FPGA 3/4] FPGA IO Part 2

13 | SD Card & Flash | 31 | [FPGA 4/4] FPGA Ext-Flash

14 | eMMC | 32 | ChangeNote

15 | COMM | 33

16 | USB Switch | 34

17 | Debug Console | 35

18 | Temperature Sensor | 36

- V1.1.0: Add FPGA - Change to SAMA7G54

BEE-DAL Project: | OBC Sub-system:

/DNP: Do Not Place

Design by: Cam Doan | Sheet title: Index.SchDoc | Sheet 2 of 34

Checked by: Bao Bui | Document No: 2 | Size: A3

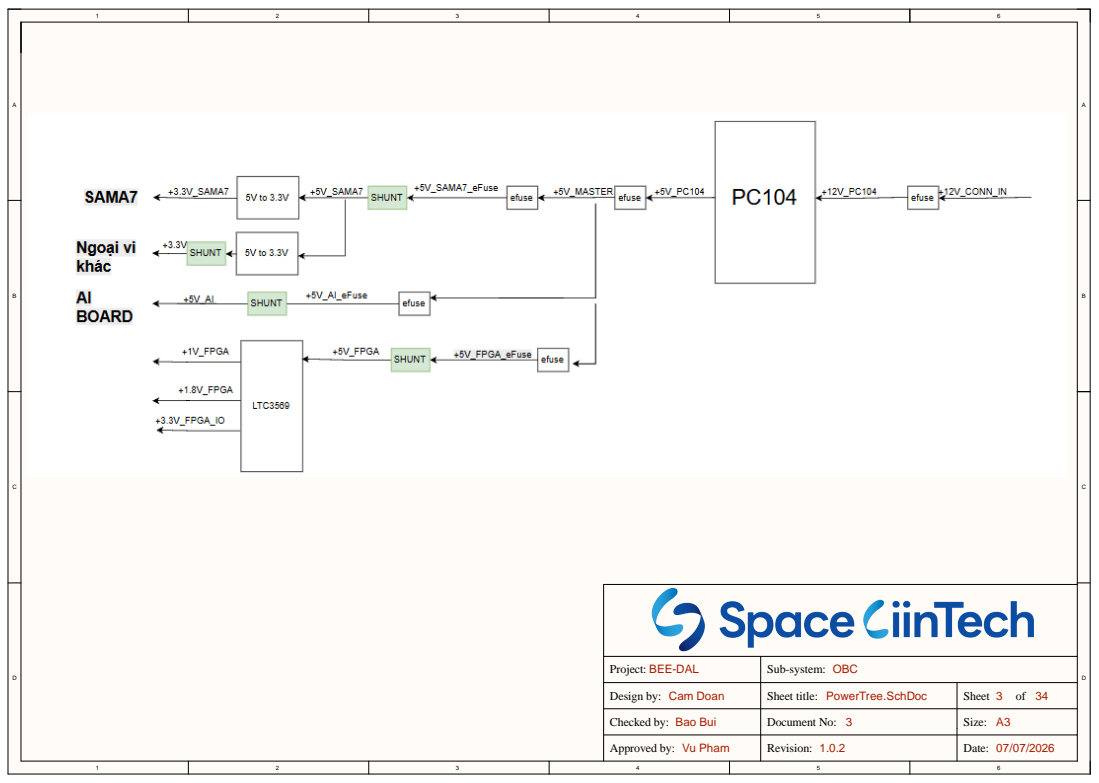
[picture p63: page 3]

BEE-DAL Project: | OBC Sub-system:

Design by: Cam Doan | Sheet title: PowerTree.SchDoc | Sheet 3 of 34

Checked by: Bao Bui | Document No: 3 | Size: A3

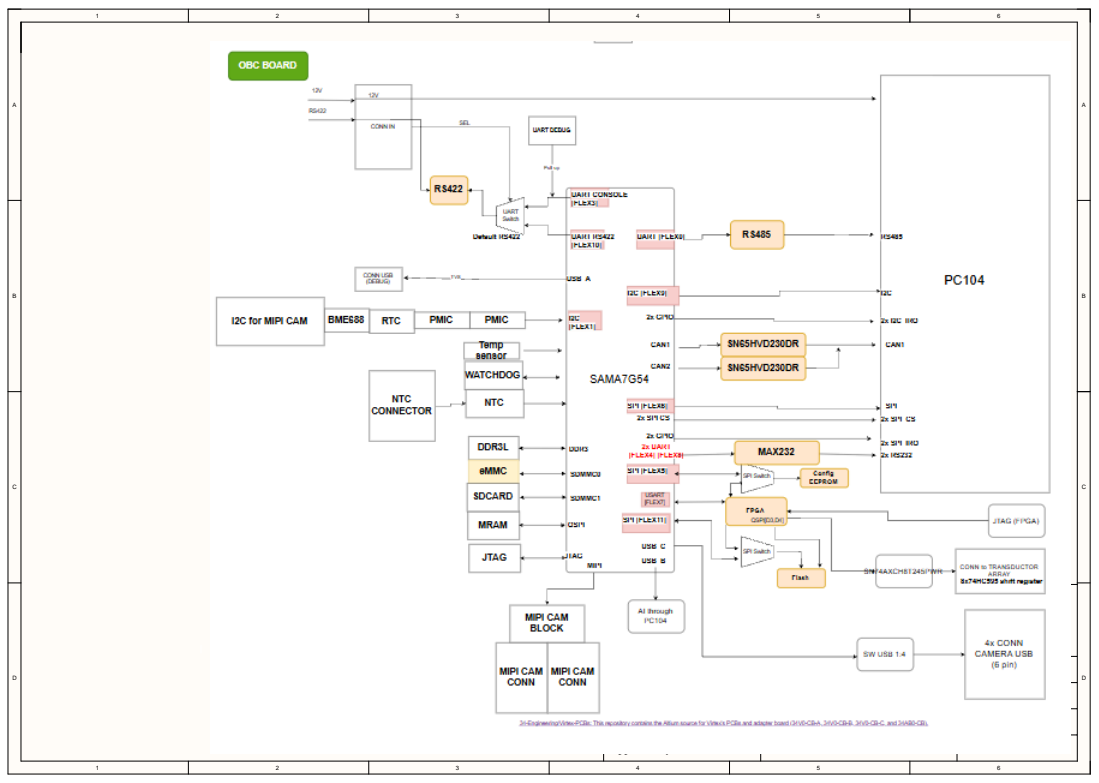
[picture p64: page 4]

BEE-DAL Project: | OBC Sub-system:

Design by: Cam Doan | Sheet title: BlockDiagram.SchDoc | Sheet 4 of 34

Checked by: Bao Bui | Document No: 4 | Size: A3

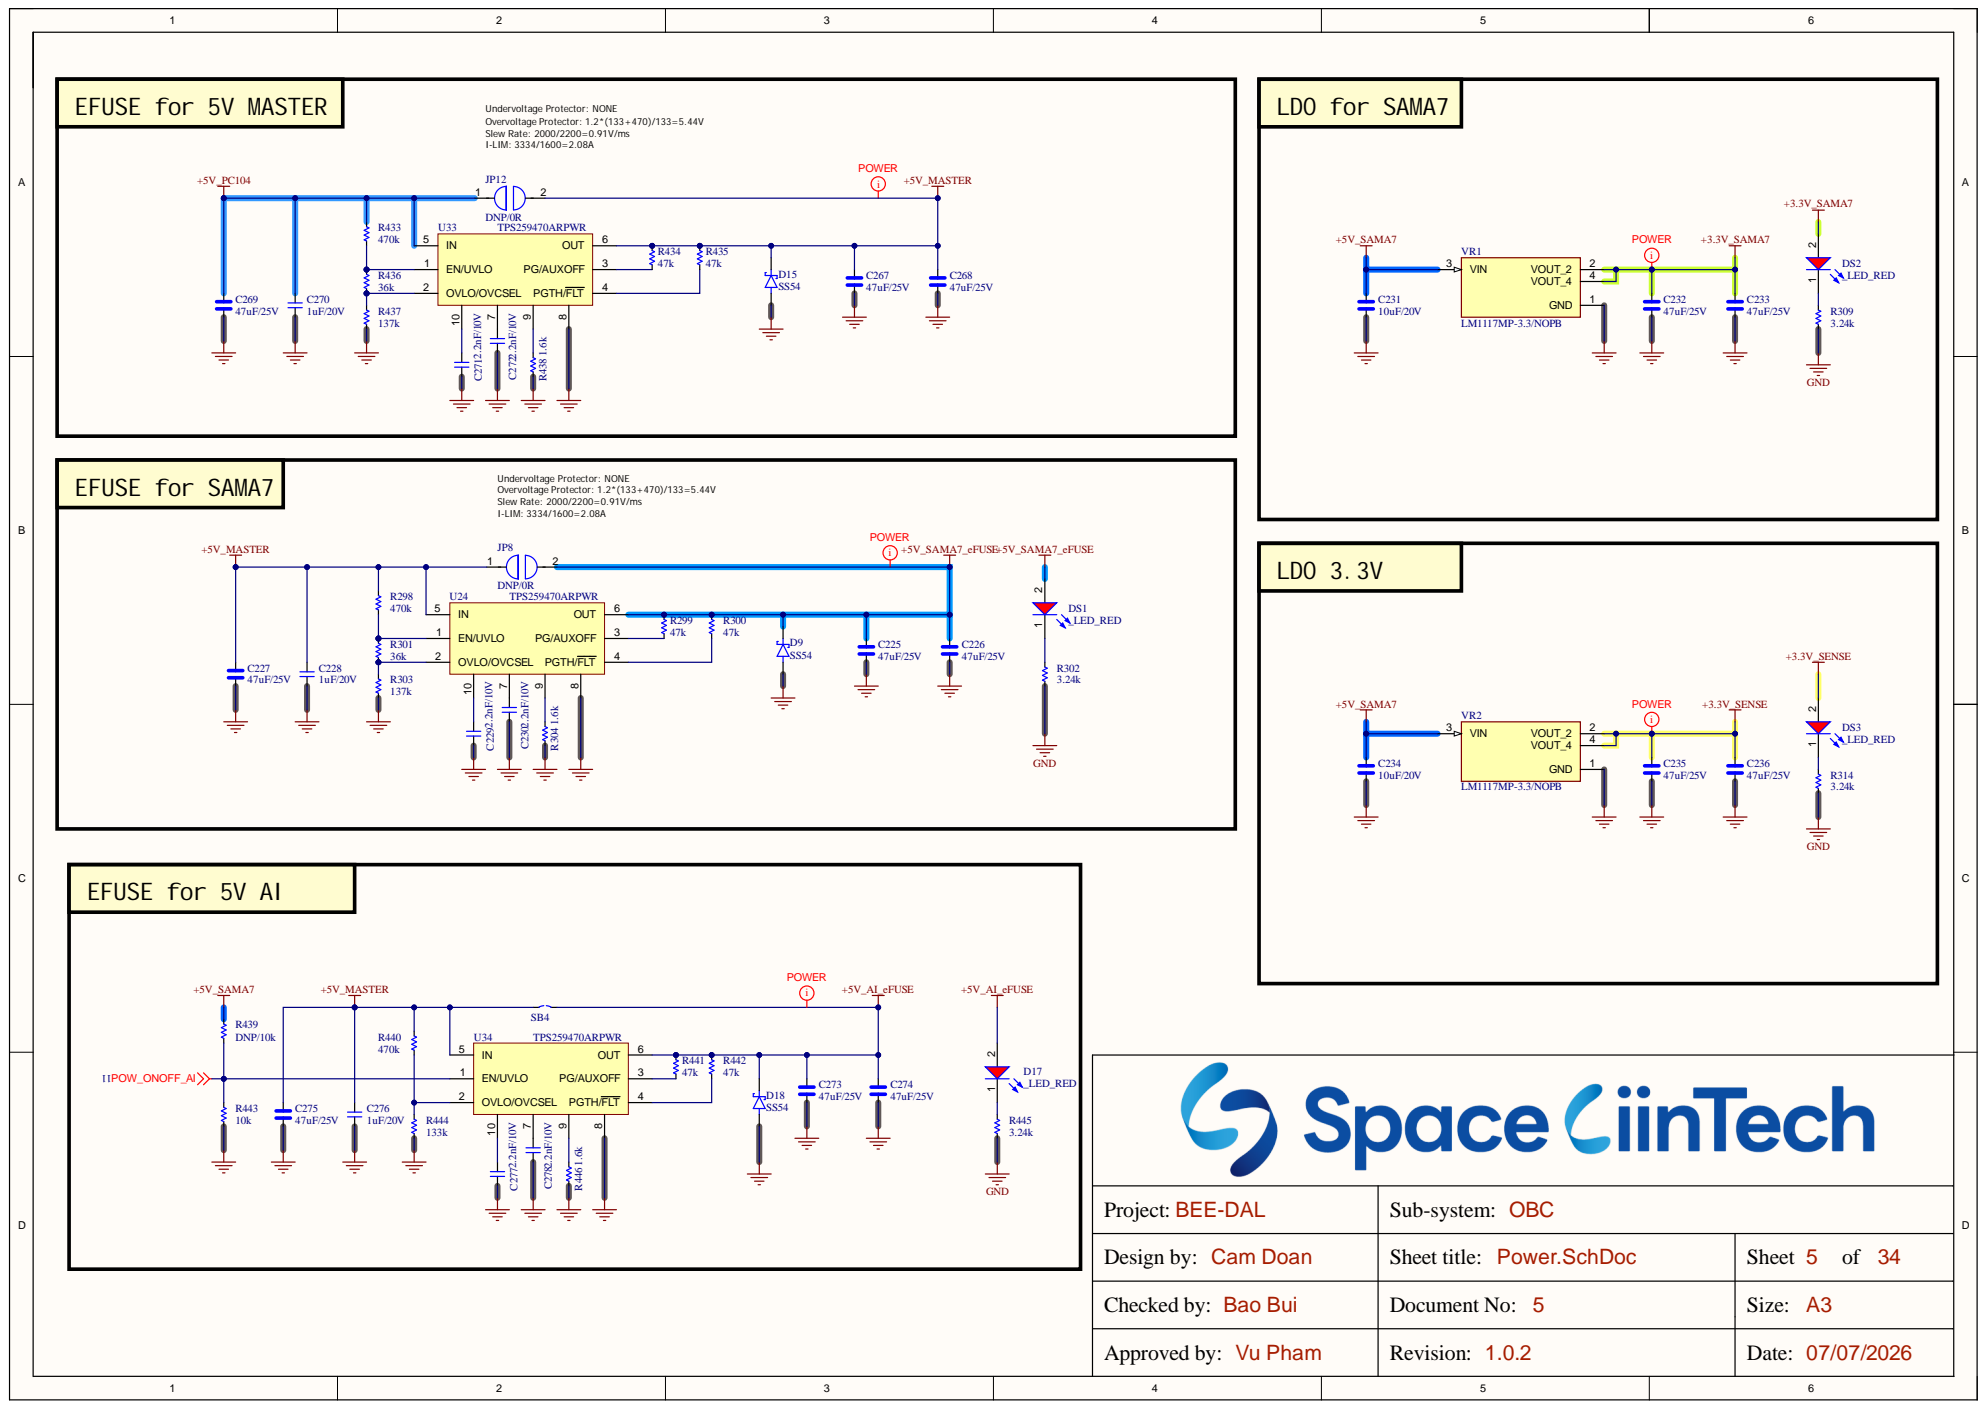
[picture p65: page 5]

BEE-DAL Project: | OBC Sub-system:

Design by: Cam Doan | Sheet title: Power.SchDoc | Sheet 5 of 34

Checked by: Bao Bui | Document No: 5 | Size: A3

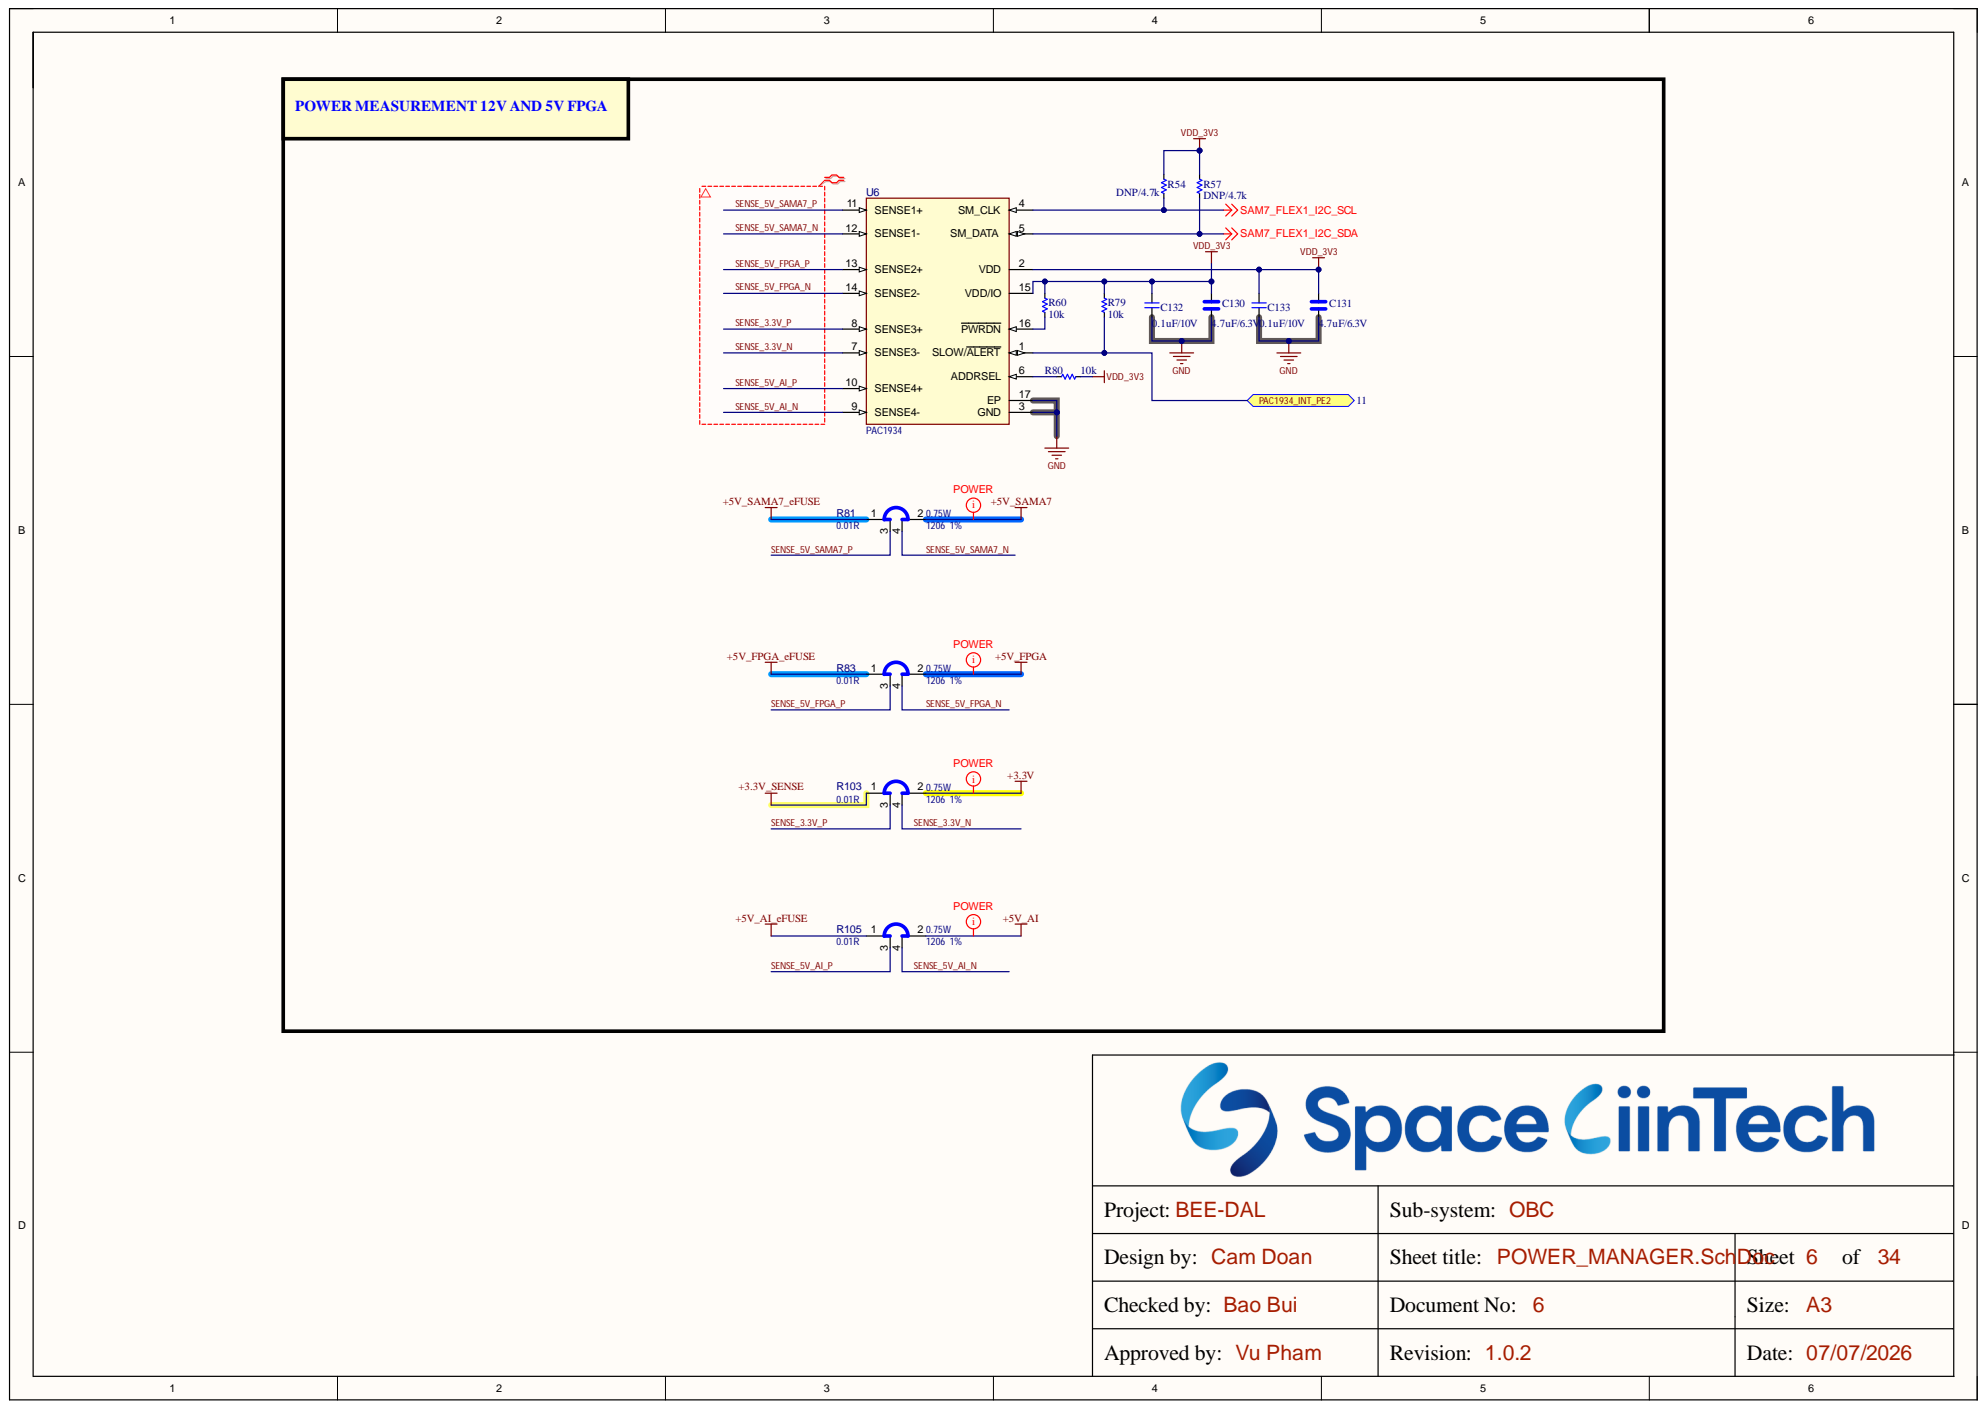
[picture p66: page 6]

POWER MEASUREMENT 12V AND 5V FPGA

BEE-DAL Project: | OBC Sub-system:

Design by: Cam Doan | Sheet title: POWER_MANAGER.SchDoc | Sheet 6 of 34

Checked by: Bao Bui | Document No: 6 | Size: A3

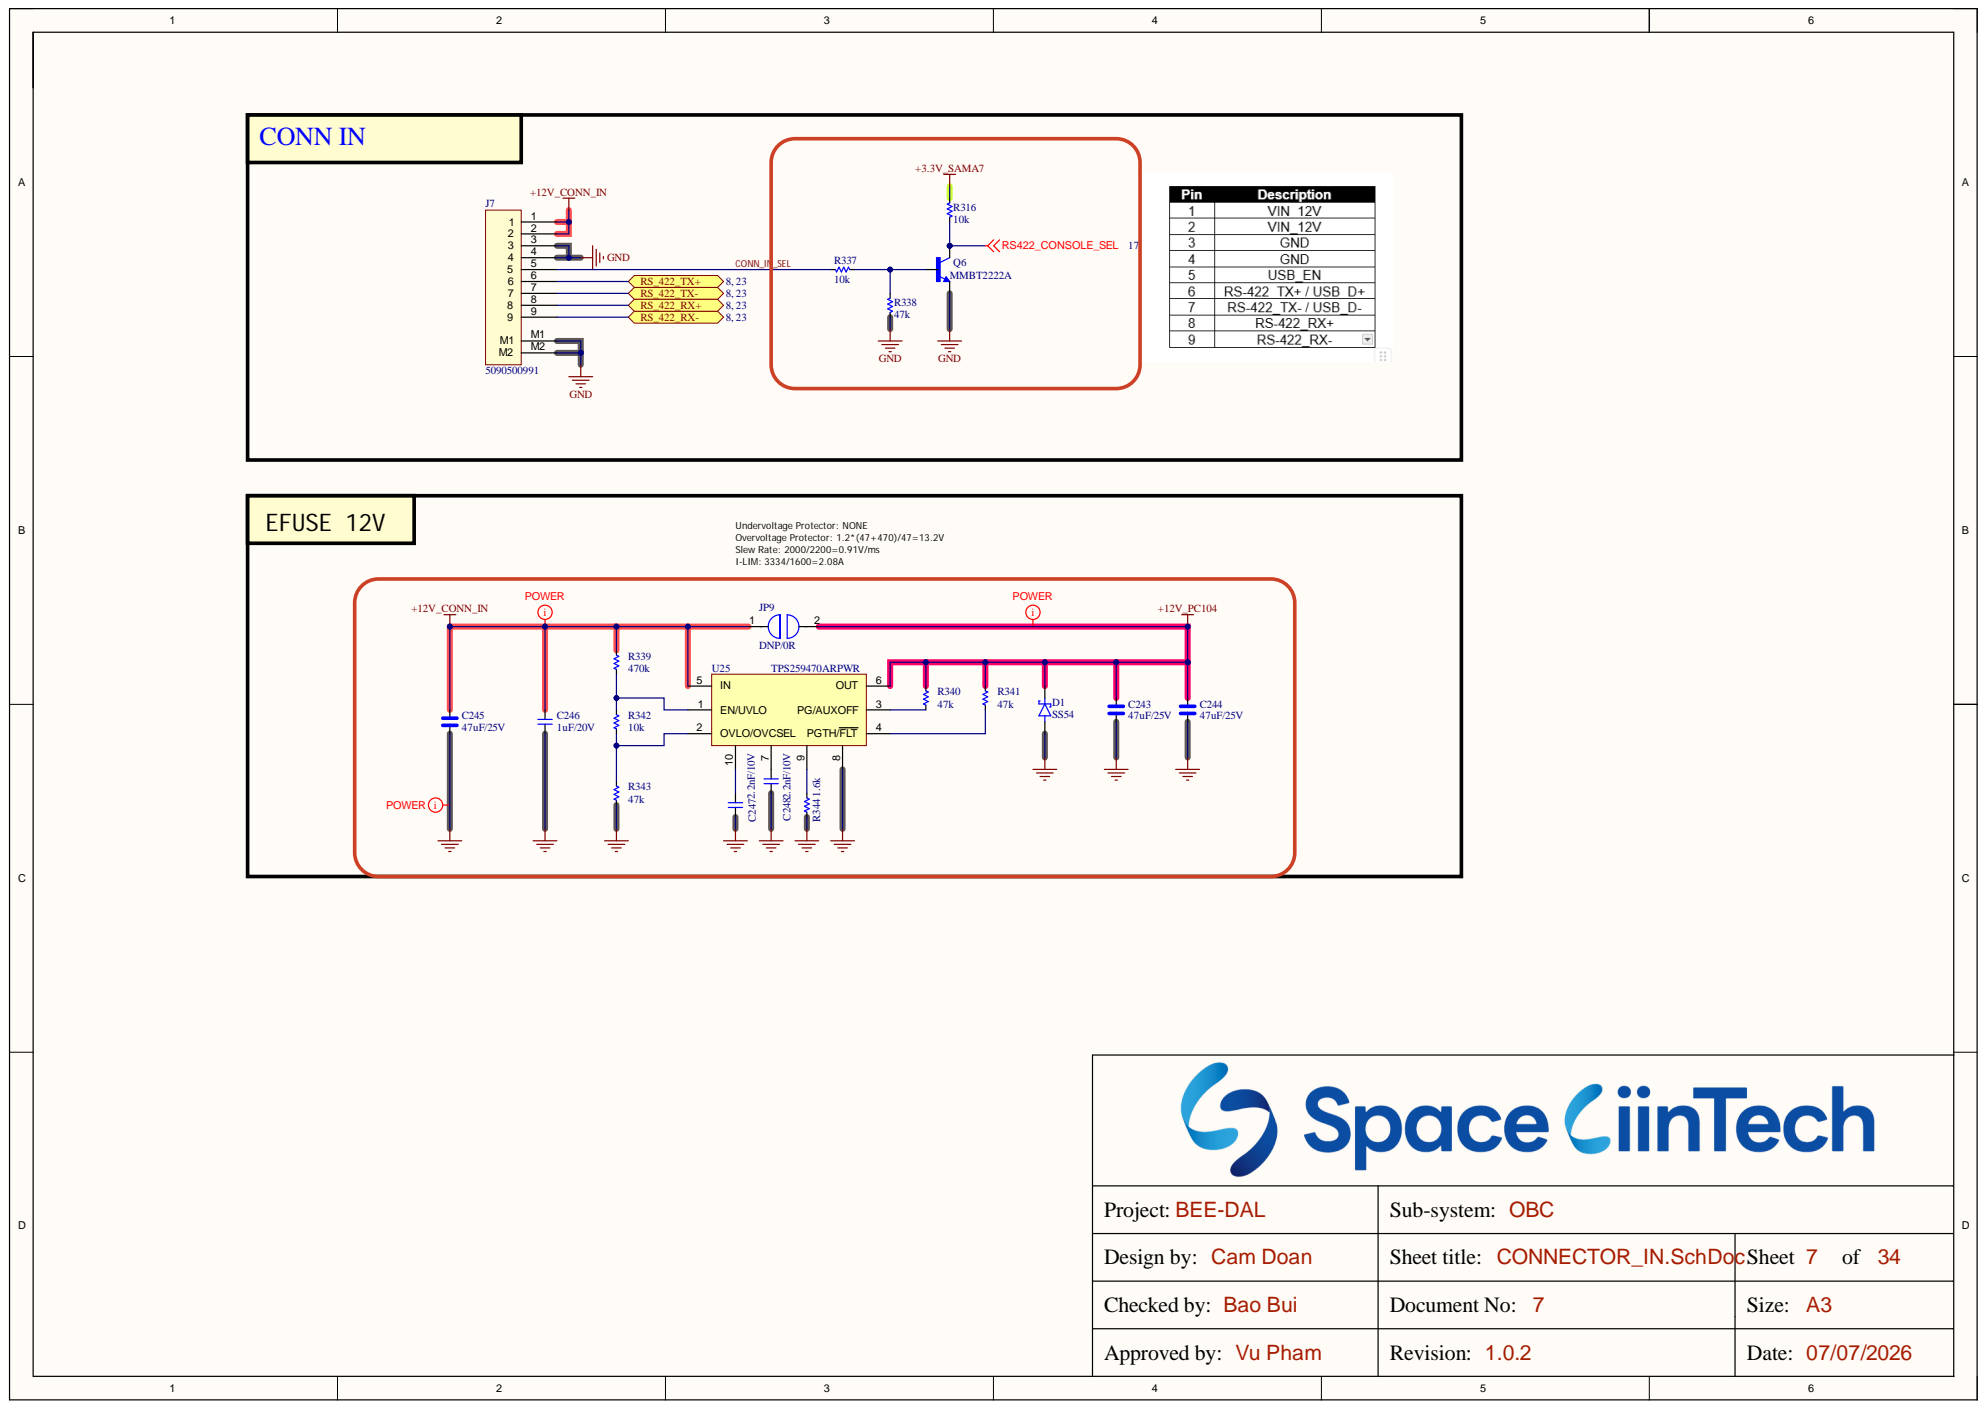
[picture p67: page 7]

BEE-DAL Project: | OBC Sub-system:

Design by: Cam Doan | Sheet title: CONNECTOR_IN.SchDoc | Sheet 7 of 34

Checked by: Bao Bui | Document No: 7 | Size: A3

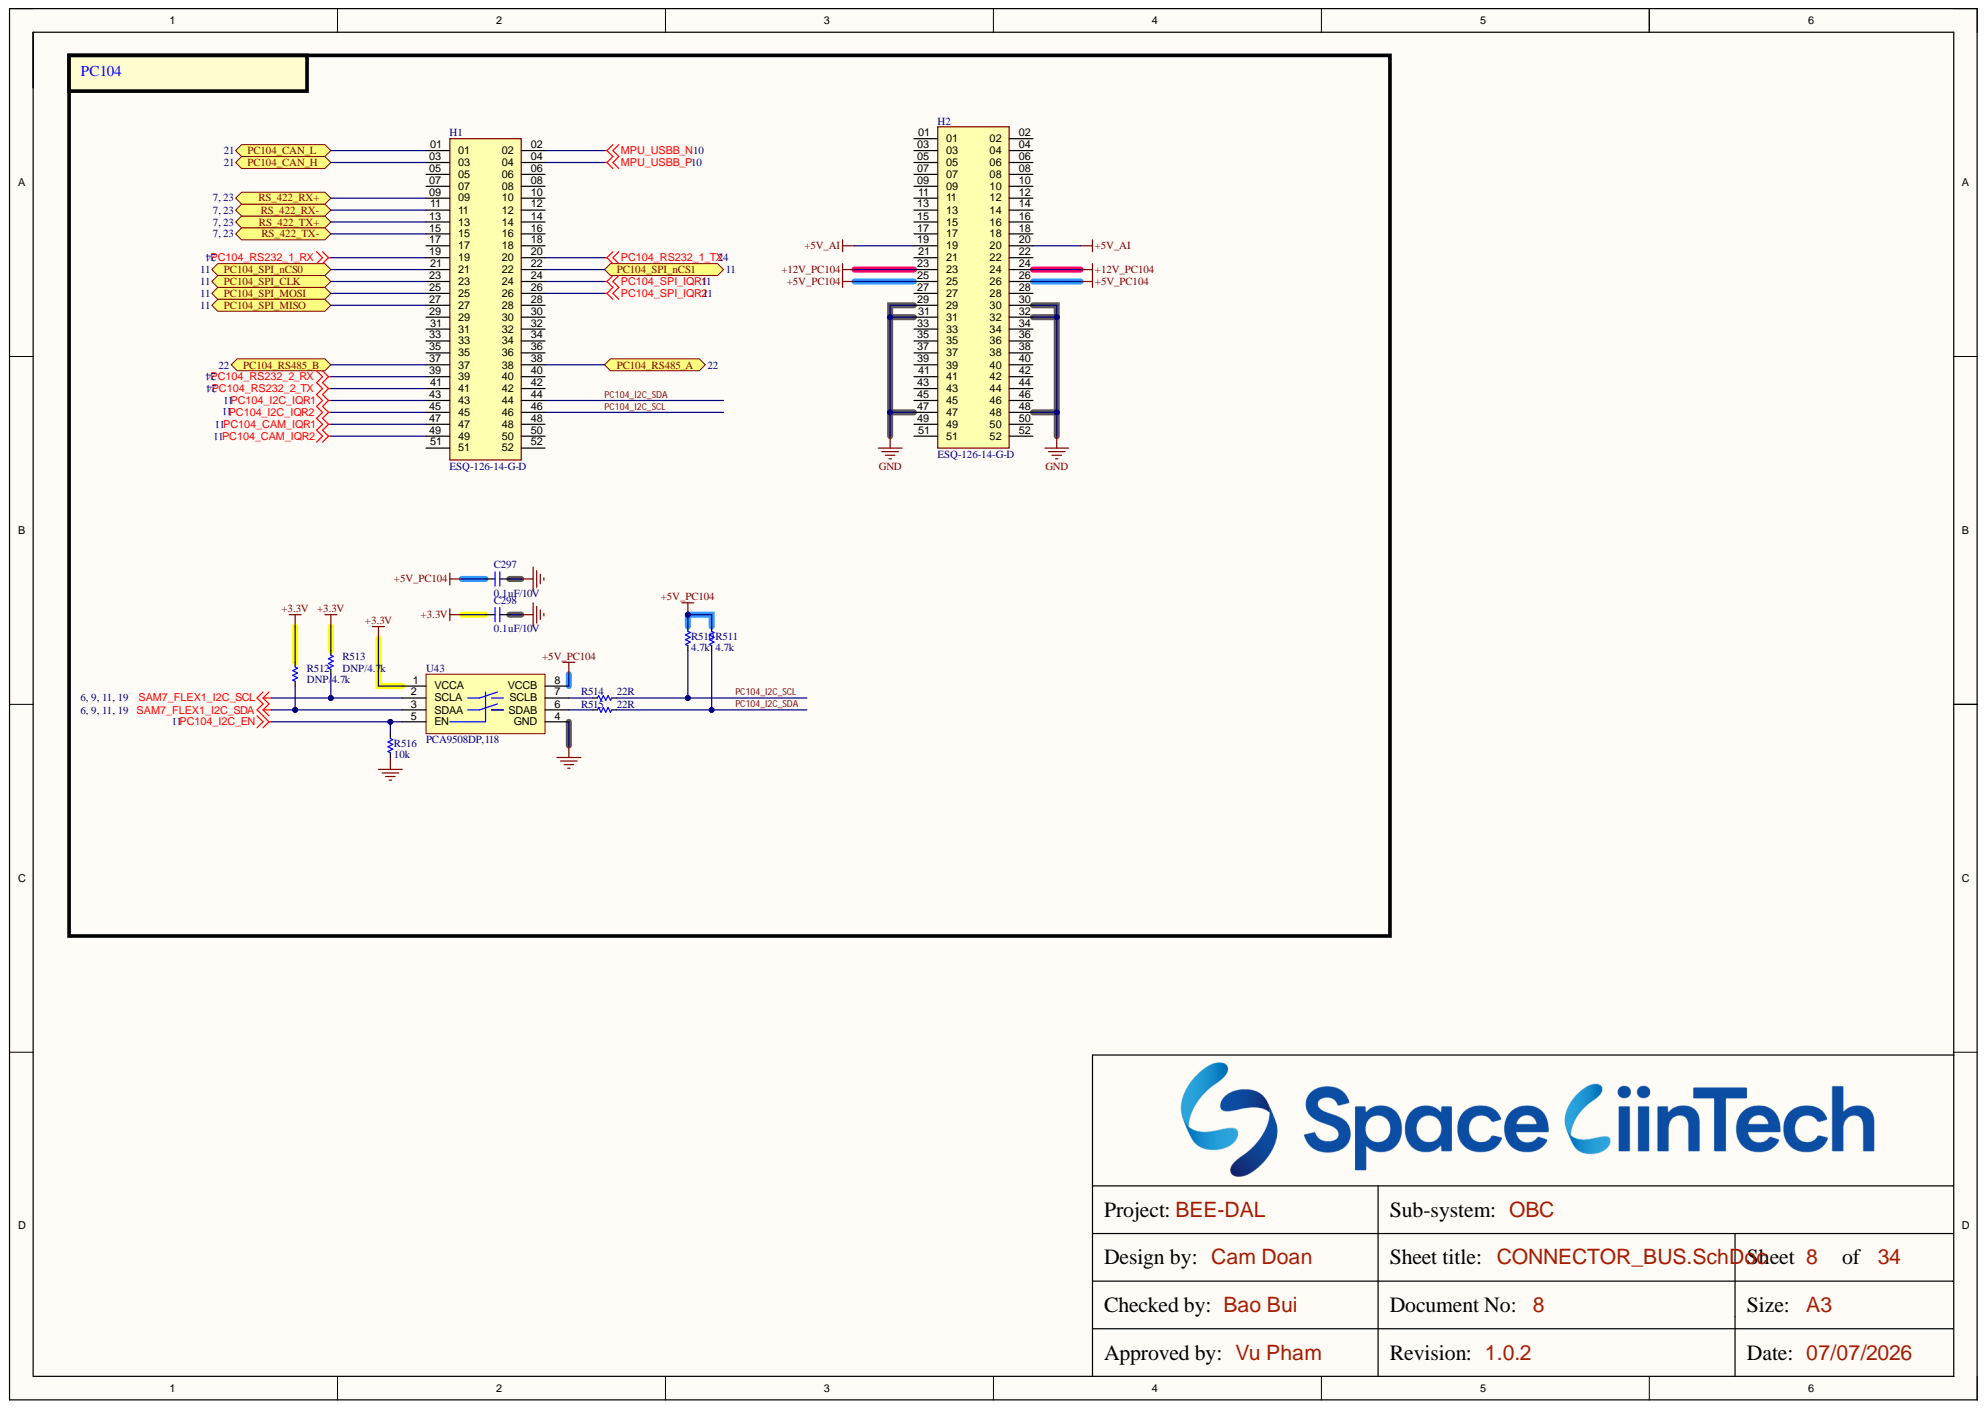
[picture p68: page 8]

BEE-DAL Project: | OBC Sub-system:

Design by: Cam Doan | Sheet title: CONNECTOR_BUS.SchDoc | Sheet 8 of 34

Checked by: Bao Bui | Document No: 8 | Size: A3

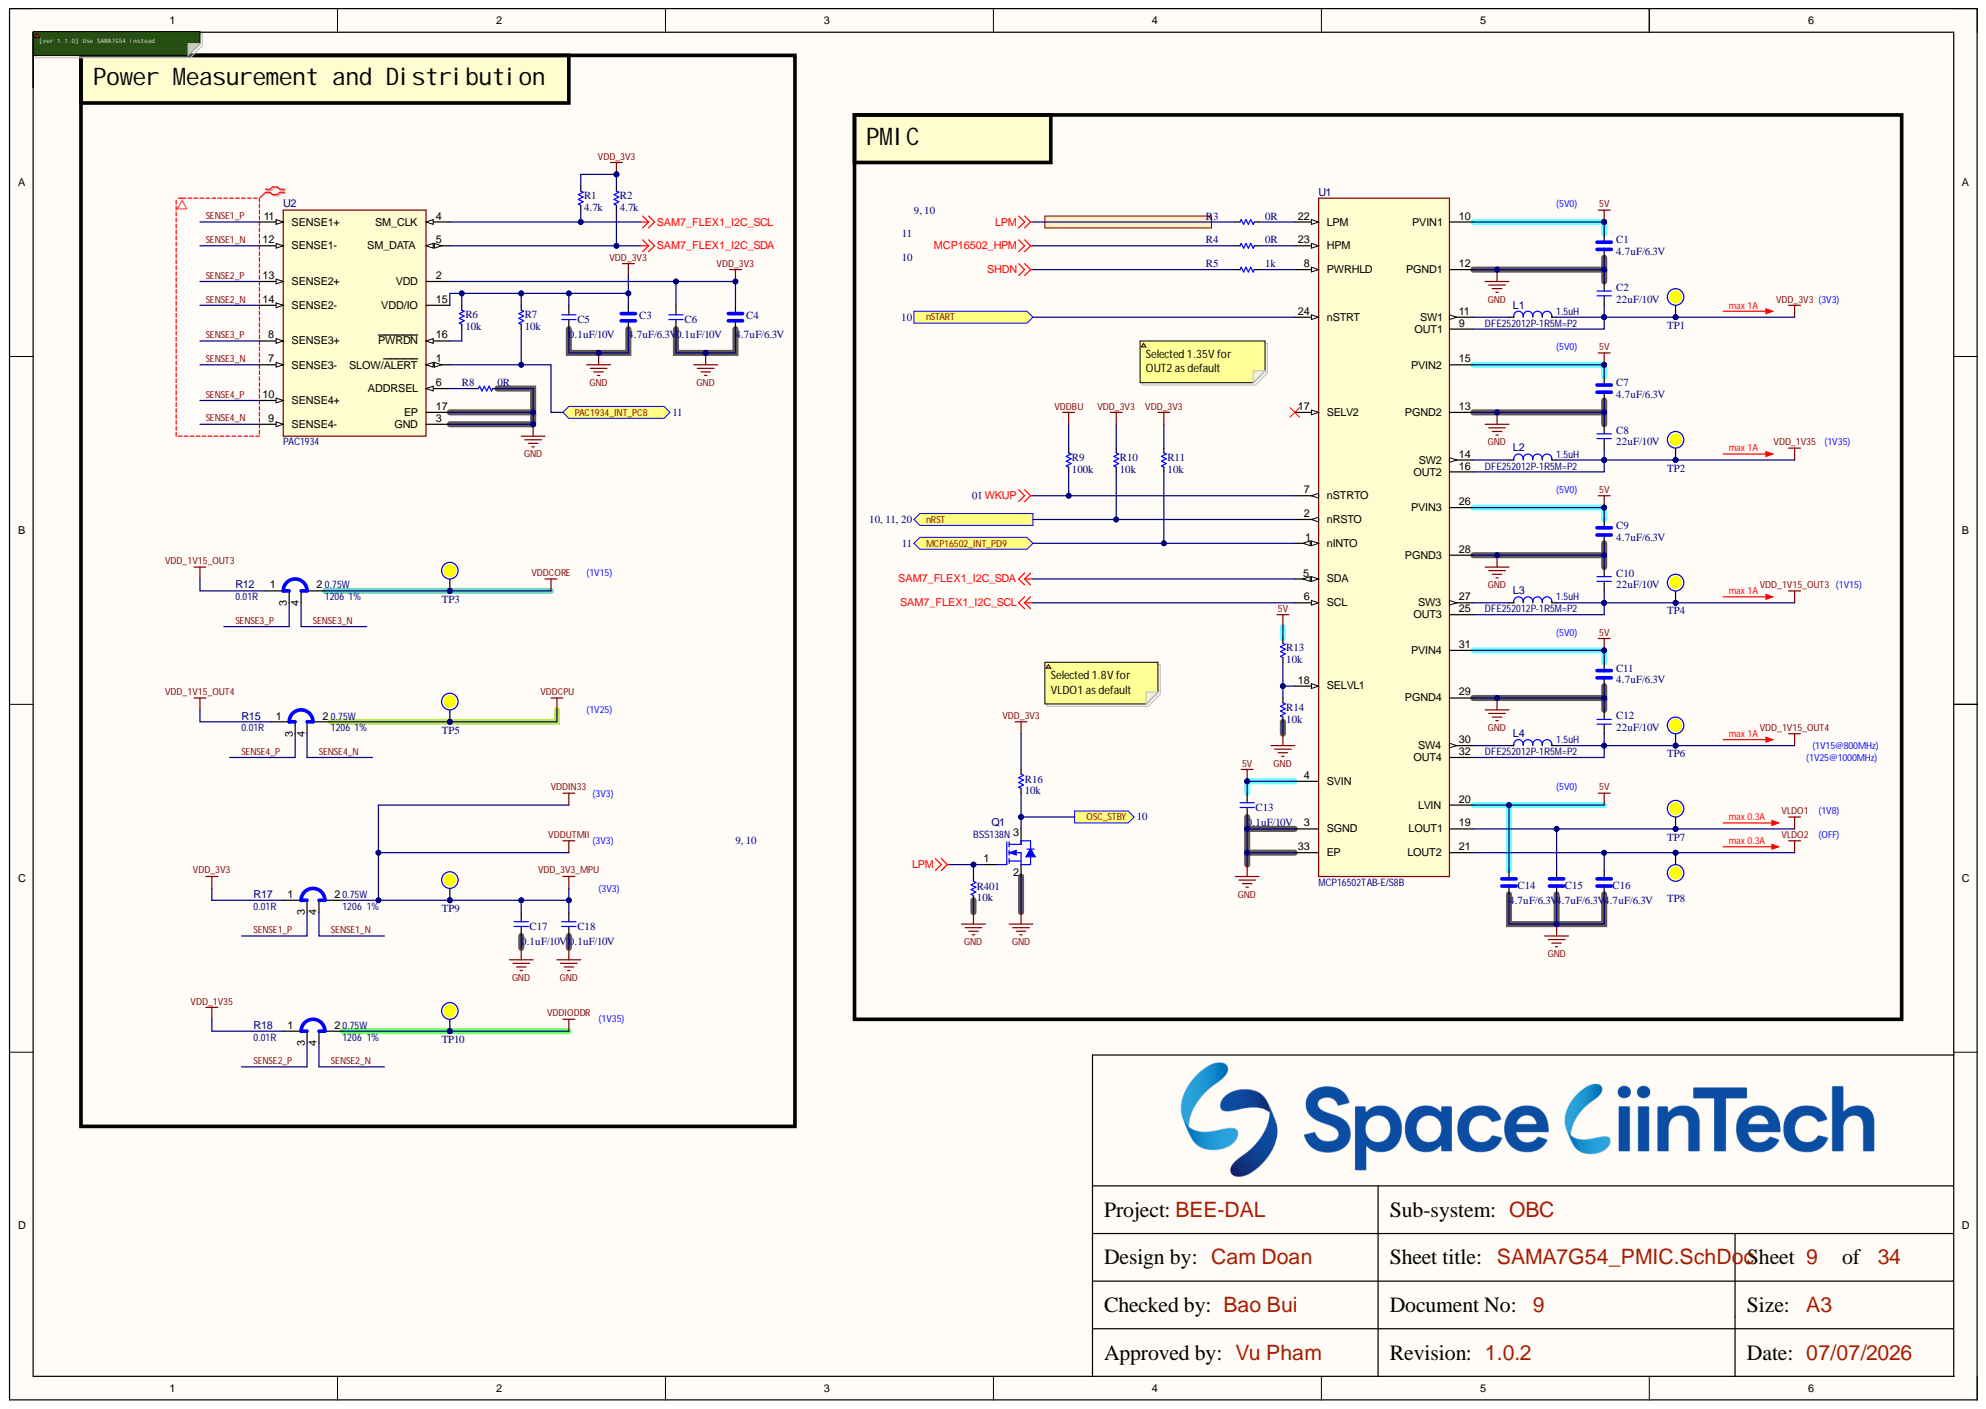
[picture p69: page 9]

Power Measurement and Distribution

max 1A max 1A max 1A max 0.3A max 0.3A max 1A

BEE-DAL Projec t : | OBC Sub-syste m :

Design by: Cam Do a n | Sheet title: SAMA7G5 4 _PMIC.Sc hDo | c Shee t 9 of 3 4

Checked by: Ba o Bu i | Document No: 9 | Size : A3

V u Ph a m | Revisio n : 1.0 . | Date : 7/0

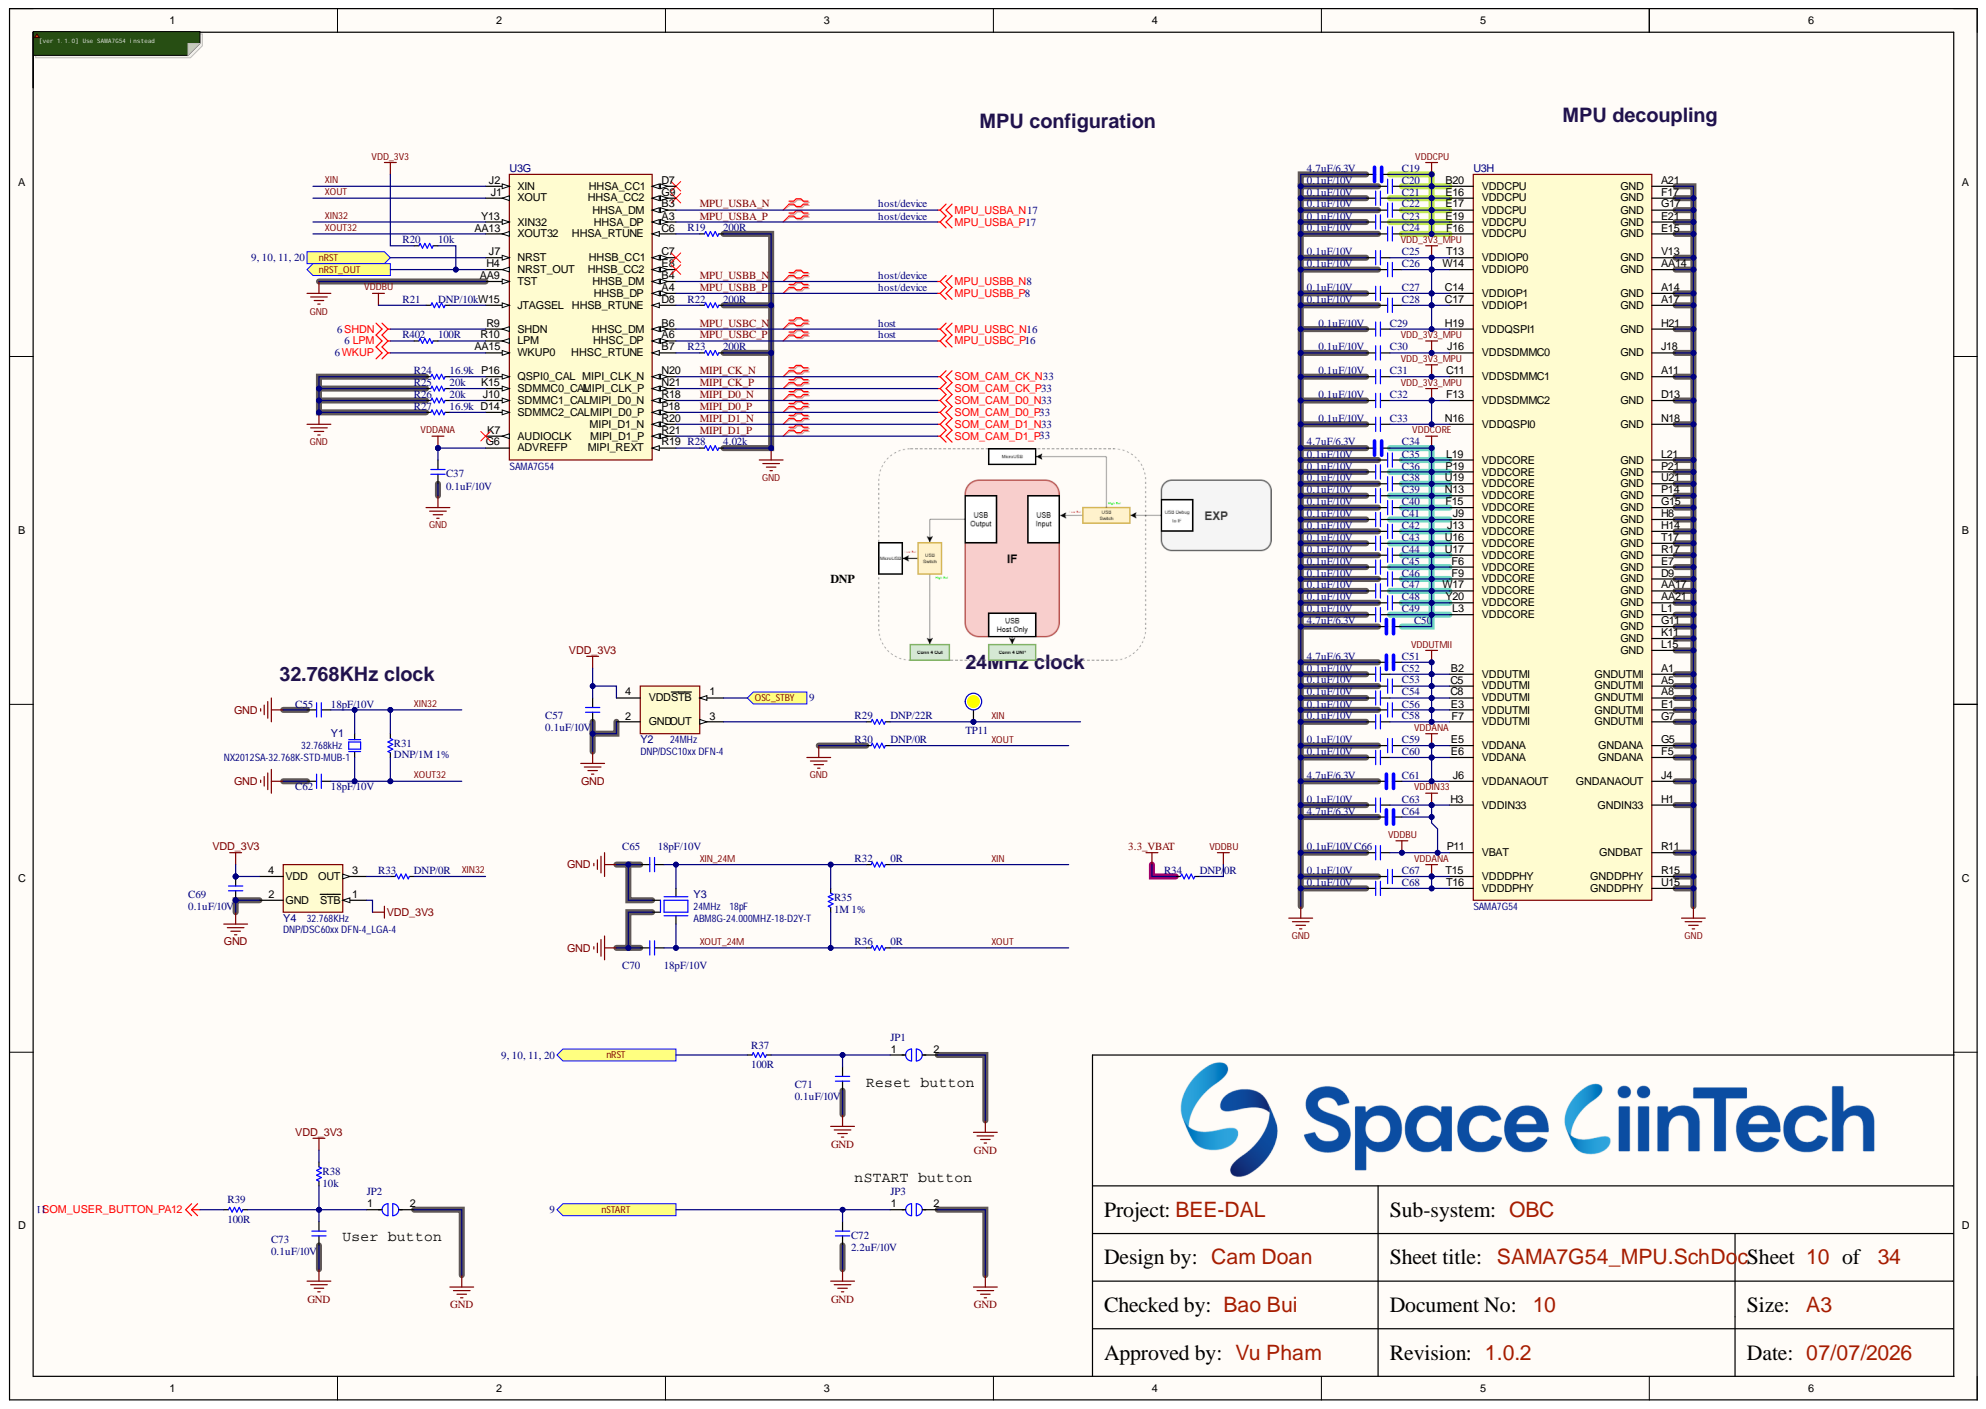
[picture p70: page 10]

0.1uF/ 1 0V | C38 | | 1
0.1uF/ 1 0V | C39 | | 4
0.1uF/ 1 0V | C40 | | 5
0.1uF/ 1 0V | C41 | | H 8
0.1uF/ 1 0V | C42 | | 4
0.1uF/ 1 0V | C43 | | T17 7 GND
0.1uF/ 1 0V | C44
0.1uF/ 1 0V | C45
0.1uF/ 1 0V | C46 | | D 9
0.1uF/ 1 0V | C47 | | 7
0.1uF/ 1 0V | C48 | | 1
0.1uF/ 1 0V | C49
4.7uF/6 . 3 V | C50 | T MII | 1

0.1uF/ 1 0V | C52
0.1uF/ 1 0V | C53 | C 5

BEE-DAL Projec t : | OBC Sub-syste m :

t o n | D GND | D GND

Design by: Cam Do a n | Sheet title: SAMA7G5 4 _MPU.Sc hDo | c Shee t 1 0 of 3 4

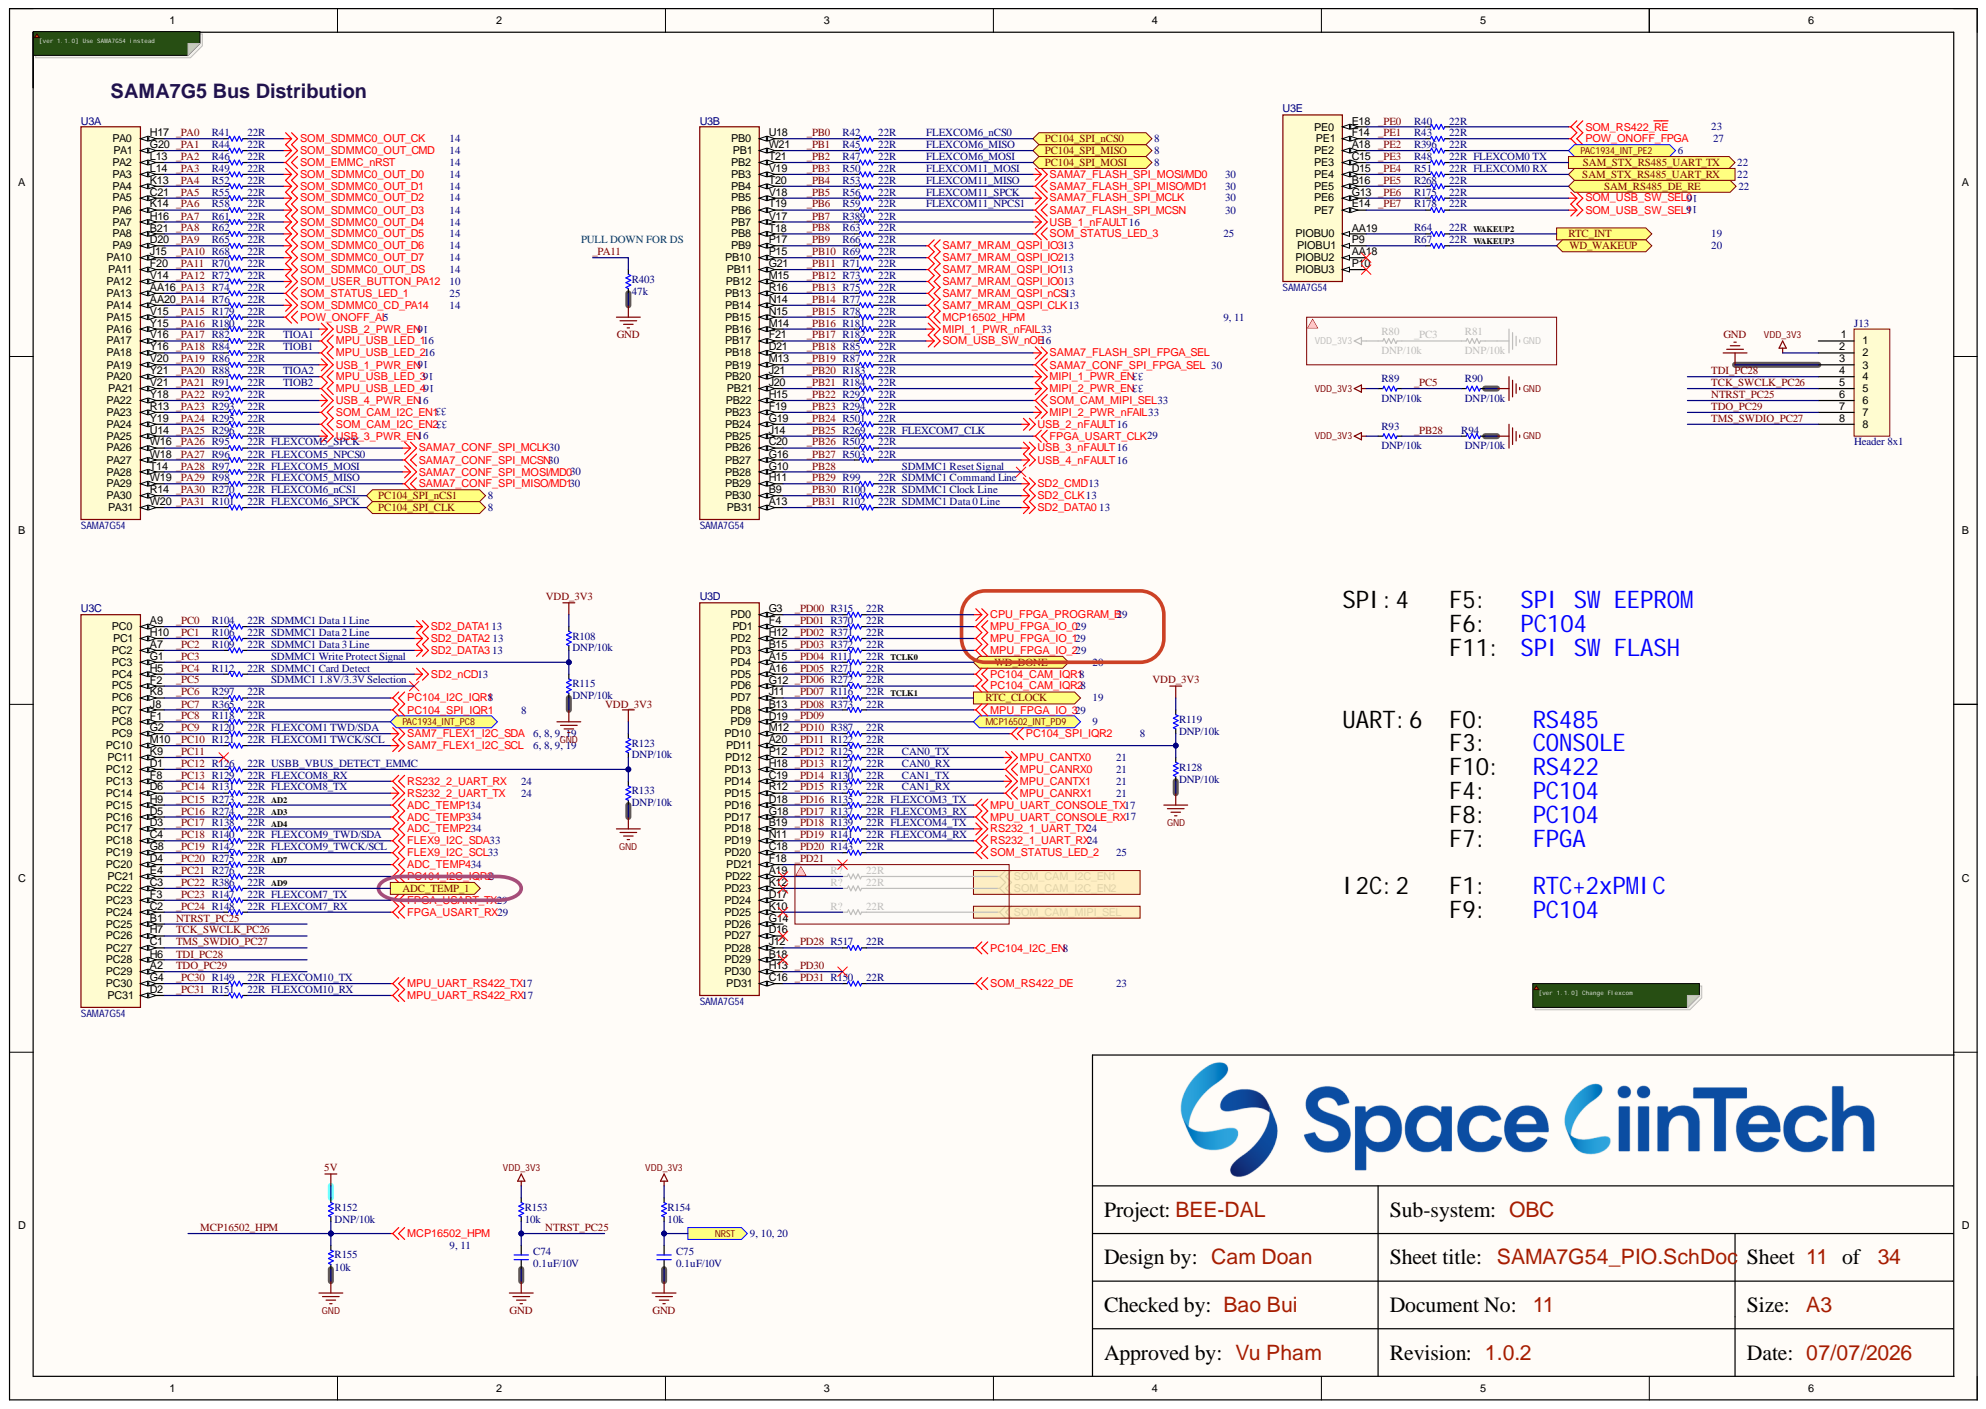
[picture p71: page 11]

PULL DOWN FOR DS

BEE-DAL Projec t : | OBC Sub-syste m :

Design by: Cam Do a n | Sheet title: SAMA7G5 4 _PIO.Sc hDo c | Shee t 1 1 of 3 4

Checked by: Ba o Bu i | Document No: 1 1 | Size : A3

V u Ph a m | Revisio n : 1.0 . | Date : 7/0

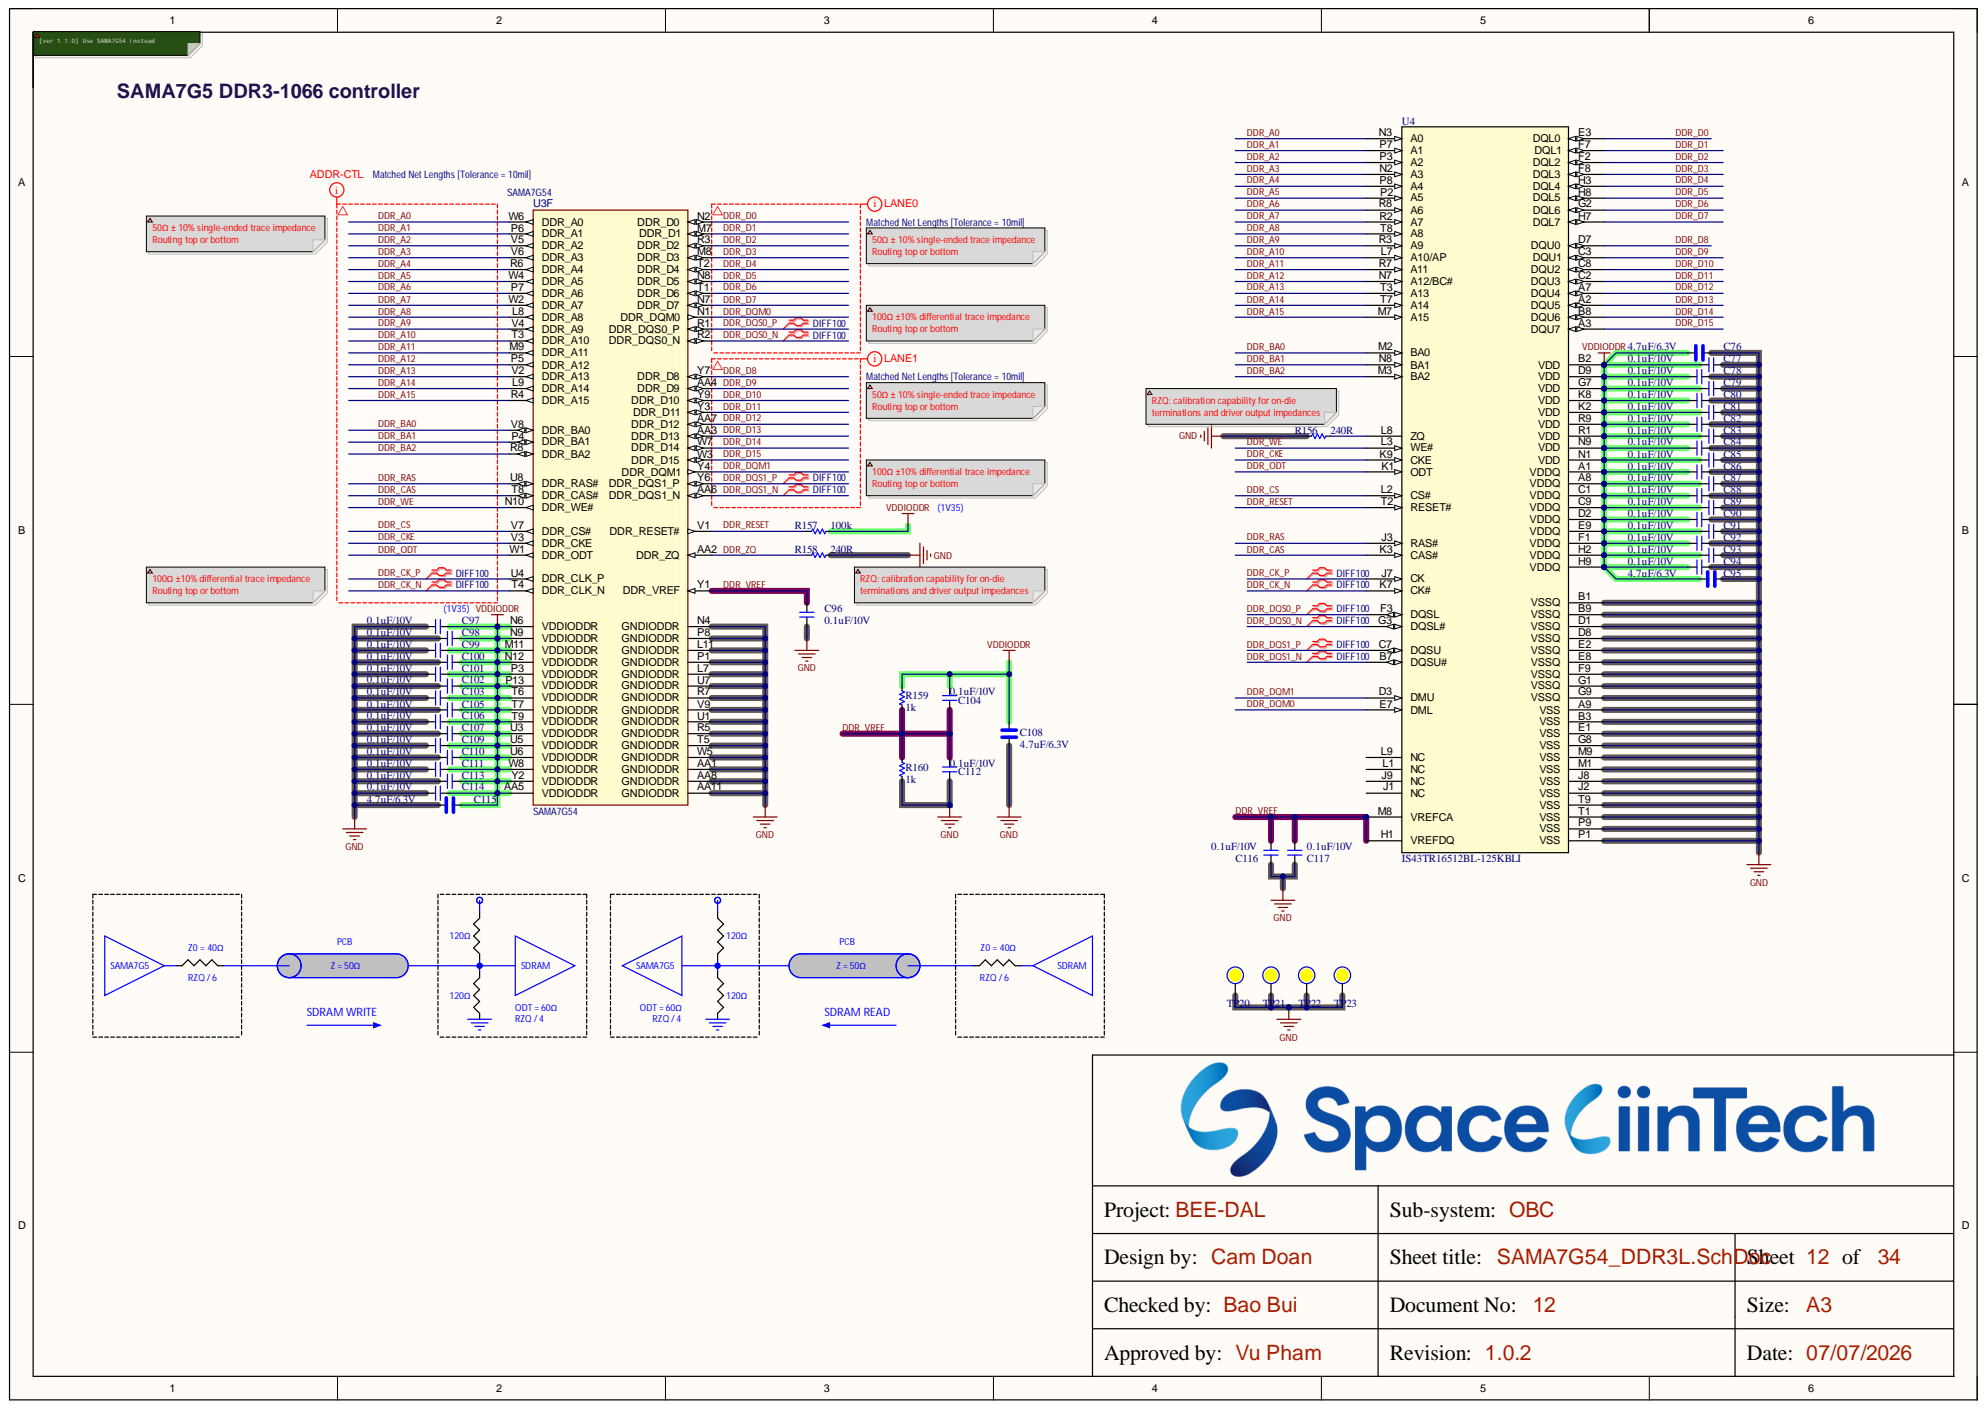
[picture p72: page 12]

BEE-DAL Projec t : | OBC Sub-syste m :

Design by: Cam Do a n | Sheet title: SAMA7G5 4 _DDR3 L.Sc hDo | Shee c t 1 2 of 3 4

Checked by: Ba o Bu i | Document No: 1 2 | Size : A3

V u Ph a m | Revisio n : 1.0 . | Date : 7/0

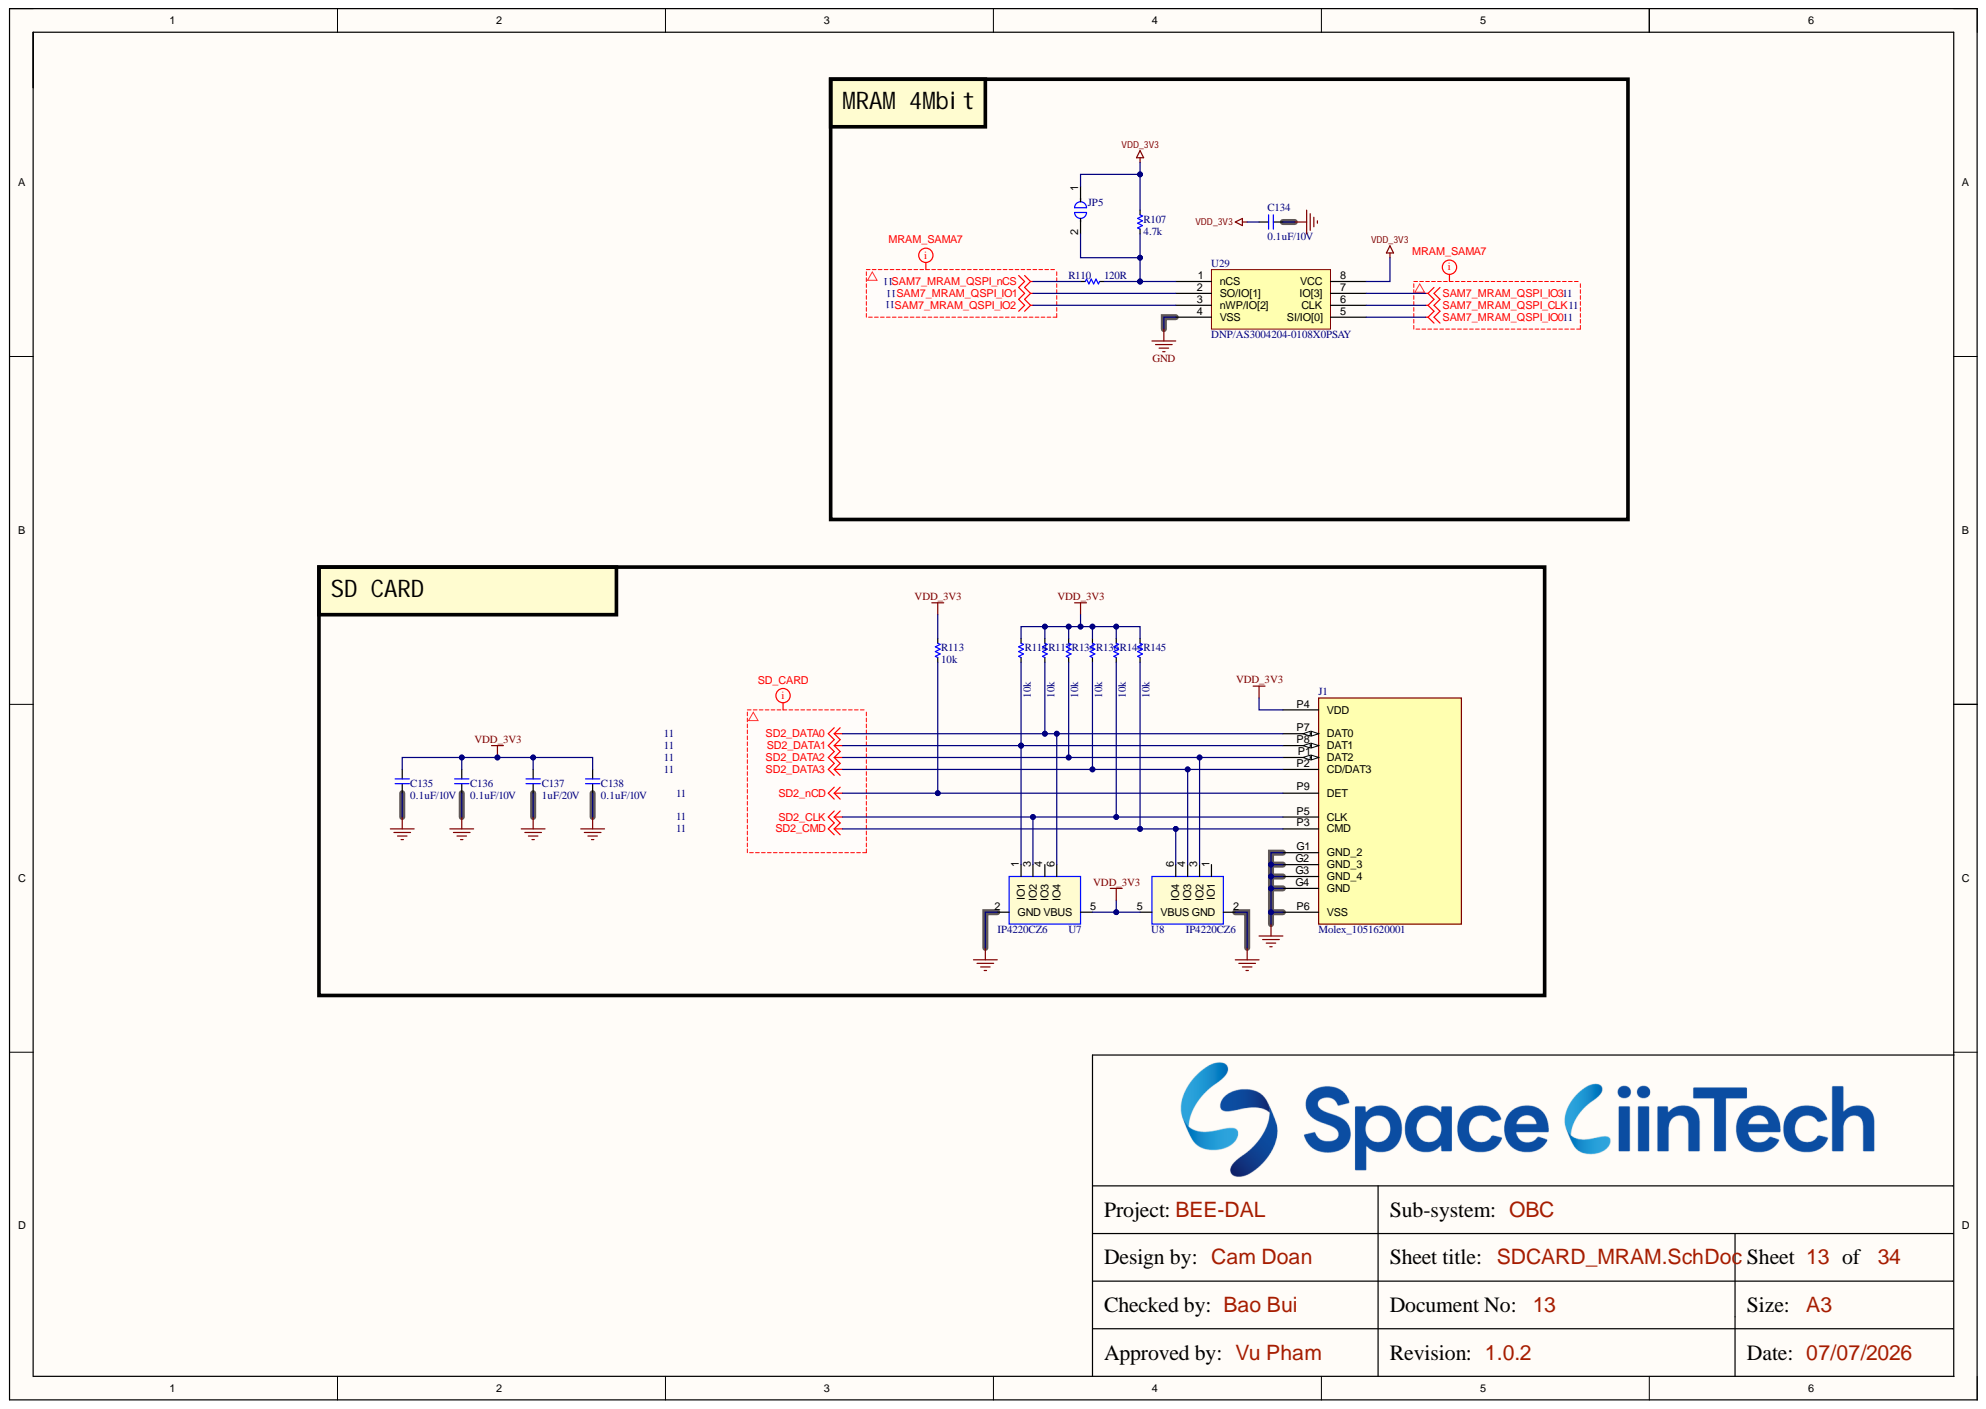
[picture p73: page 13]

DAT1 P8
DAT2 P1
CD/DAT3 P2

DET P9

CLK P5

GND_2 G1

BEE-DAL Project: | OBC Sub-system:

Design by: Cam Doan | Sheet title: SDCARD_MRAM.SchDoc | Sheet 13 of 34

Checked by: Bao Bui | Document No: 13 | Size: A3

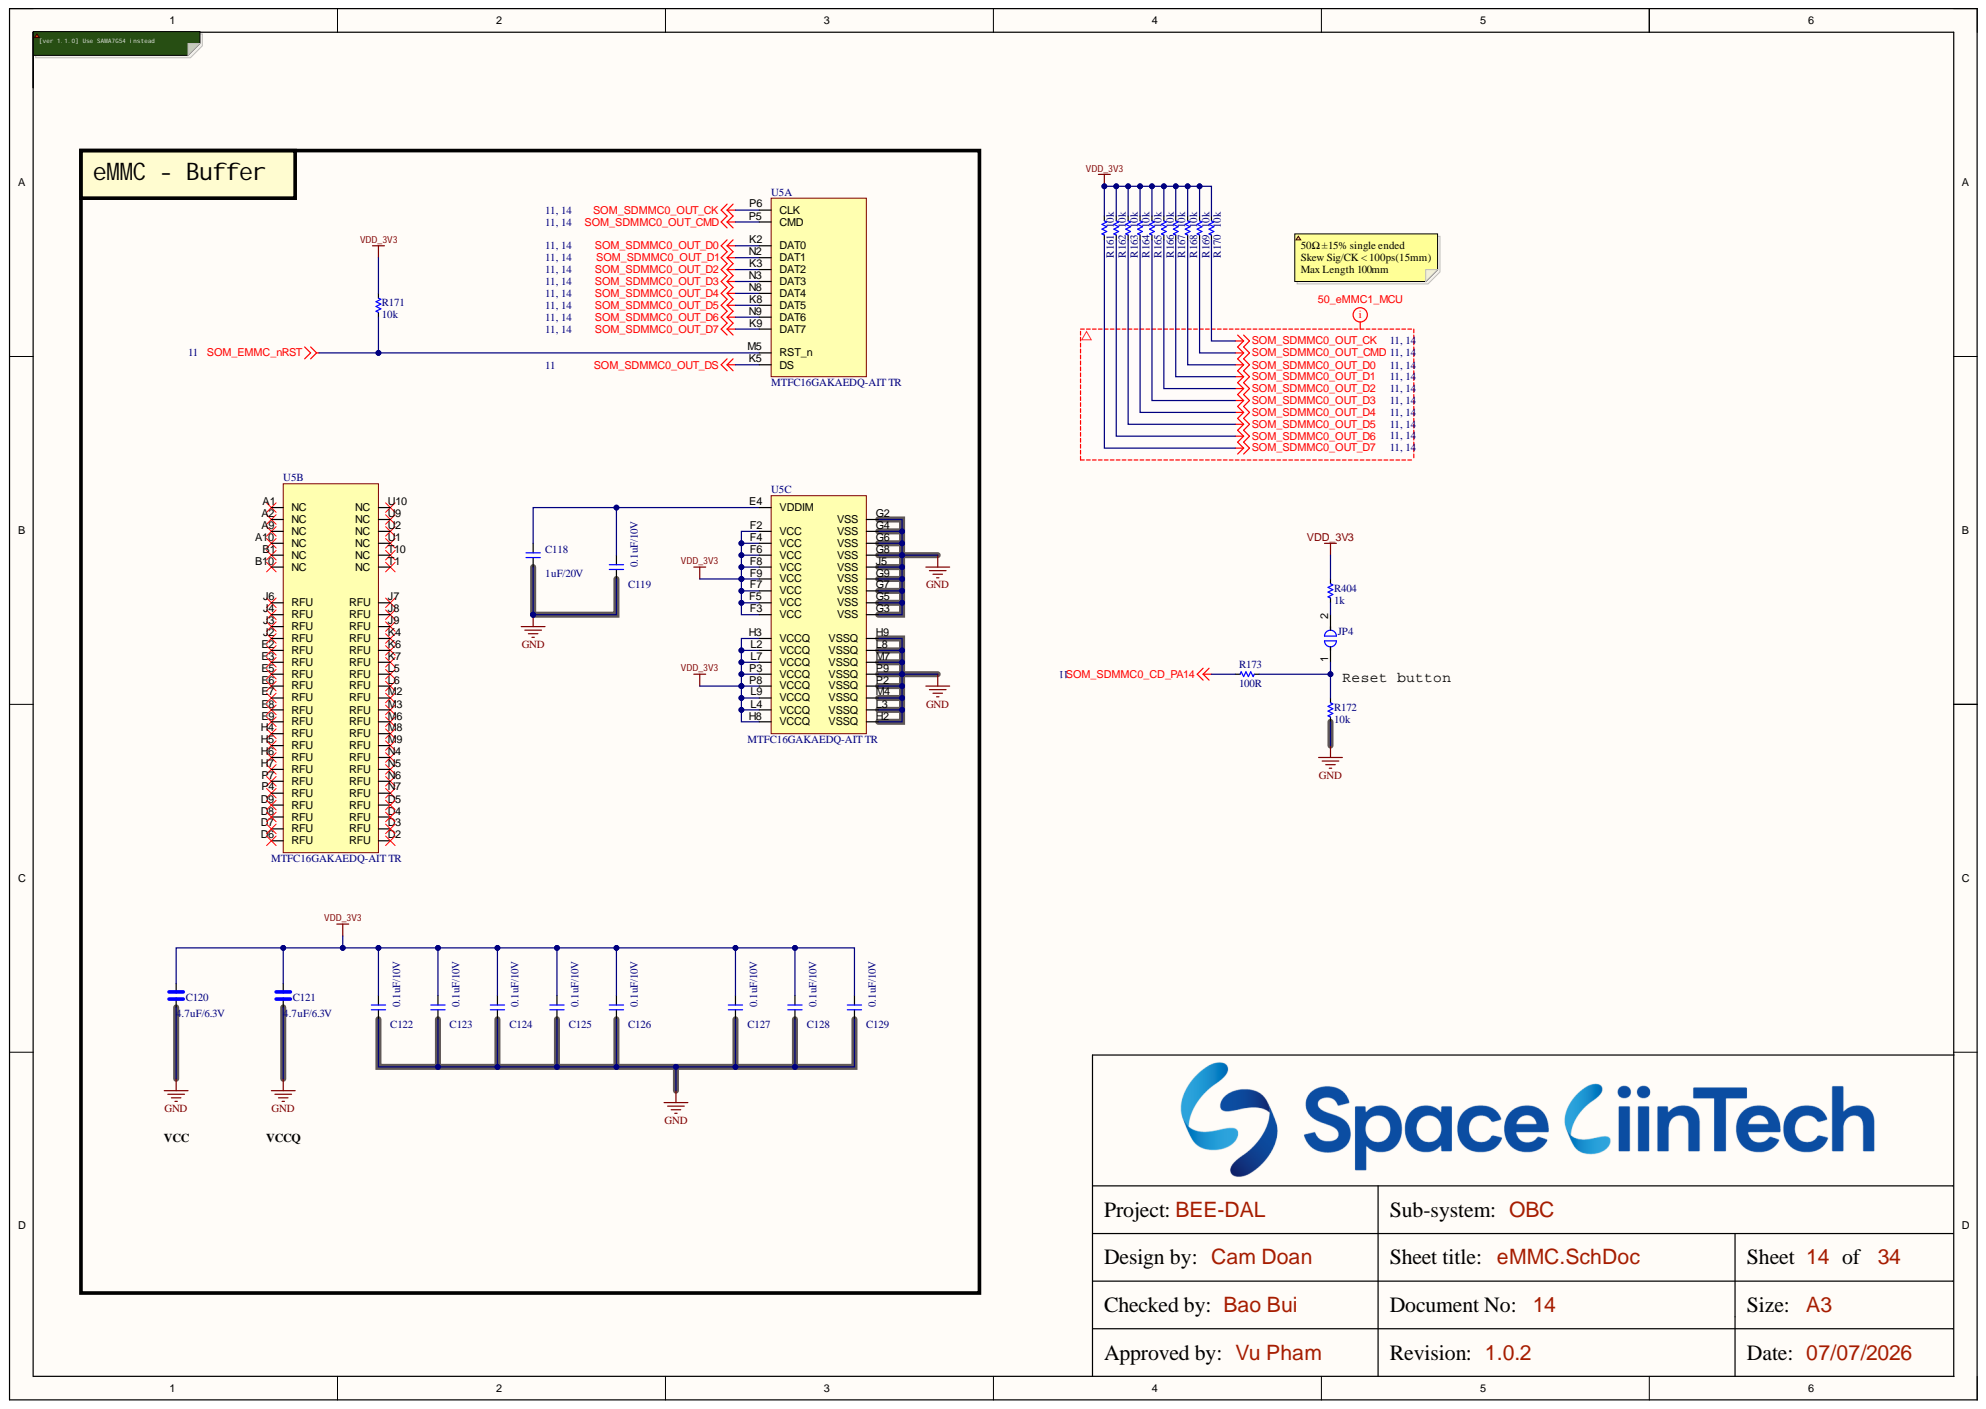
[picture p74: page 14]

BEE-DAL Project: | OBC Sub-system:

Design by: Cam Doan | Sheet title: eMMC.SchDoc | Sheet 14 of 34

Checked by: Bao Bui | Document No: 14 | Size: A3

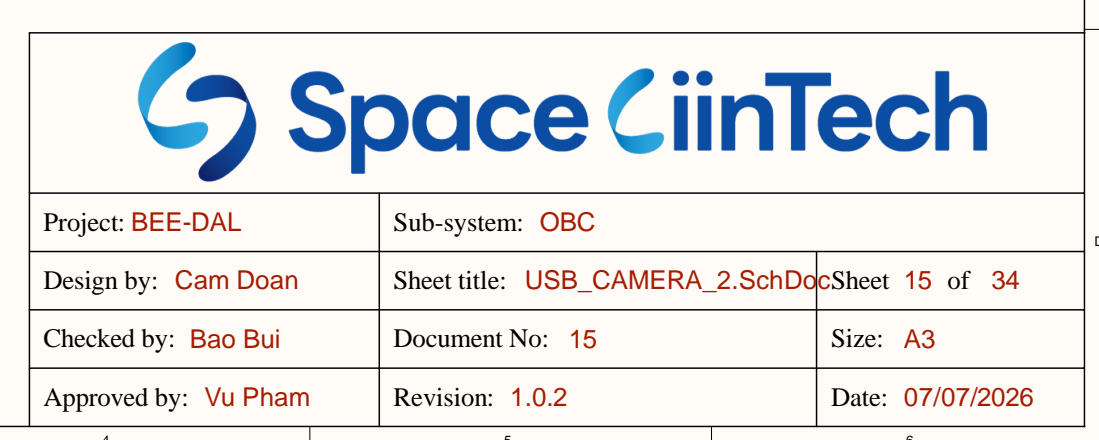
[picture p75: page 15]

BEE-DAL Project: | OBC Sub-system:

Design by: Cam Doan | Sheet title: USB_CAMERA_2.SchDoc | Sheet 15 of 34

Checked by: Bao Bui | Document No: 15 | Size: A3

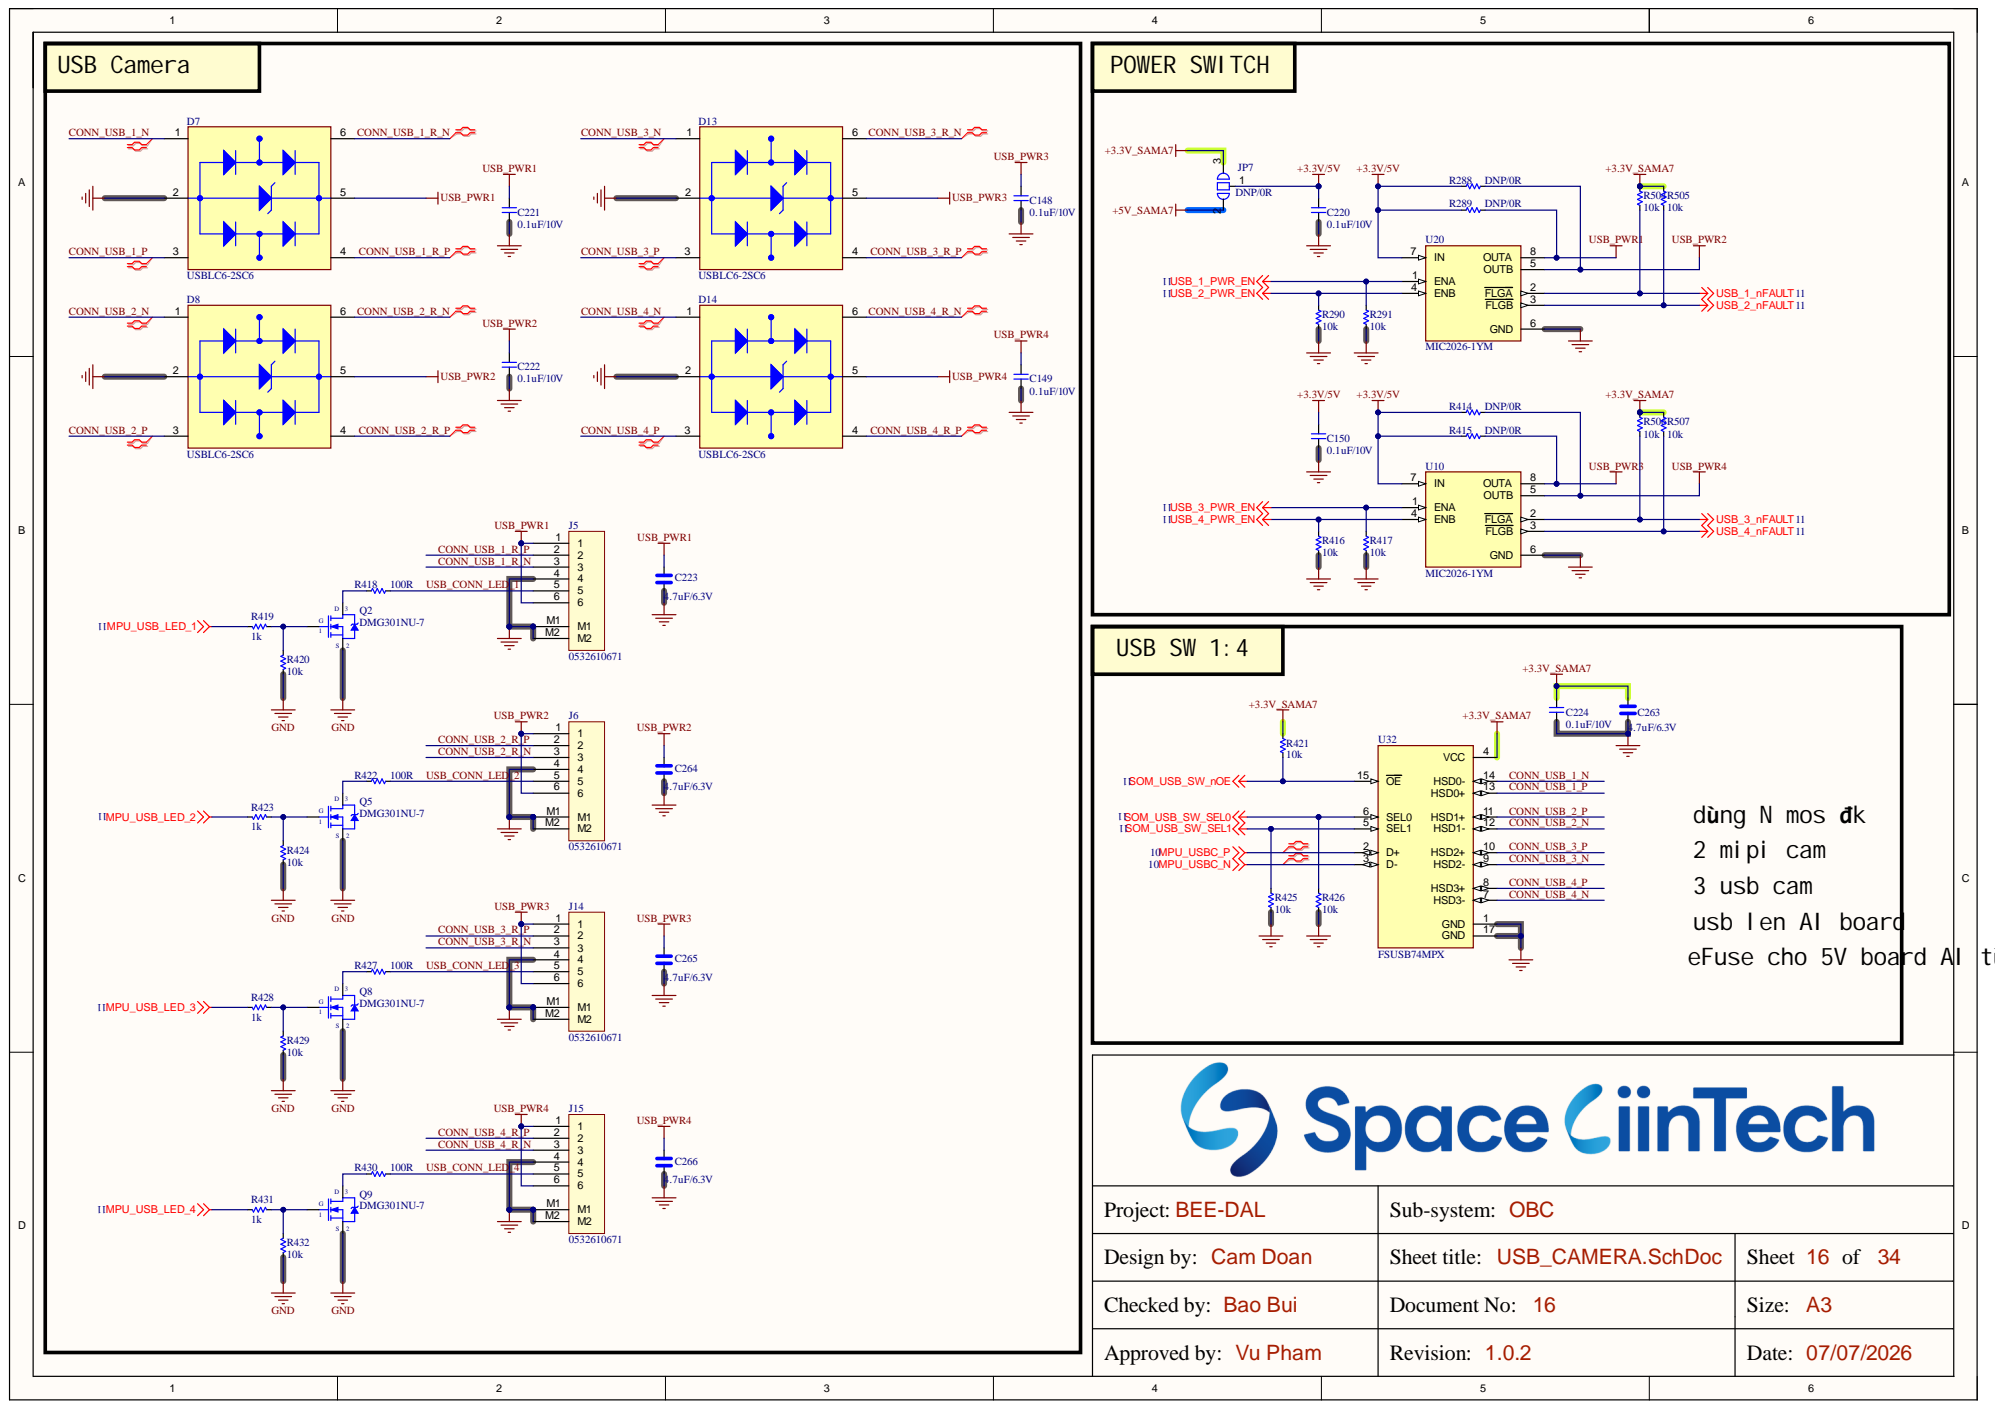
[picture p76: page 16]

3 usb cam
usb len AI board

Design by: Cam Do a n | Sheet title: USB_CAMERA.Sc hDo c | Shee t 1 6 of 3 4

Checked by: Ba o Bu i | Document No: 1 6 | Size : A3

V u Ph a m | Revisio n : 1.0 . | Date : 7/0

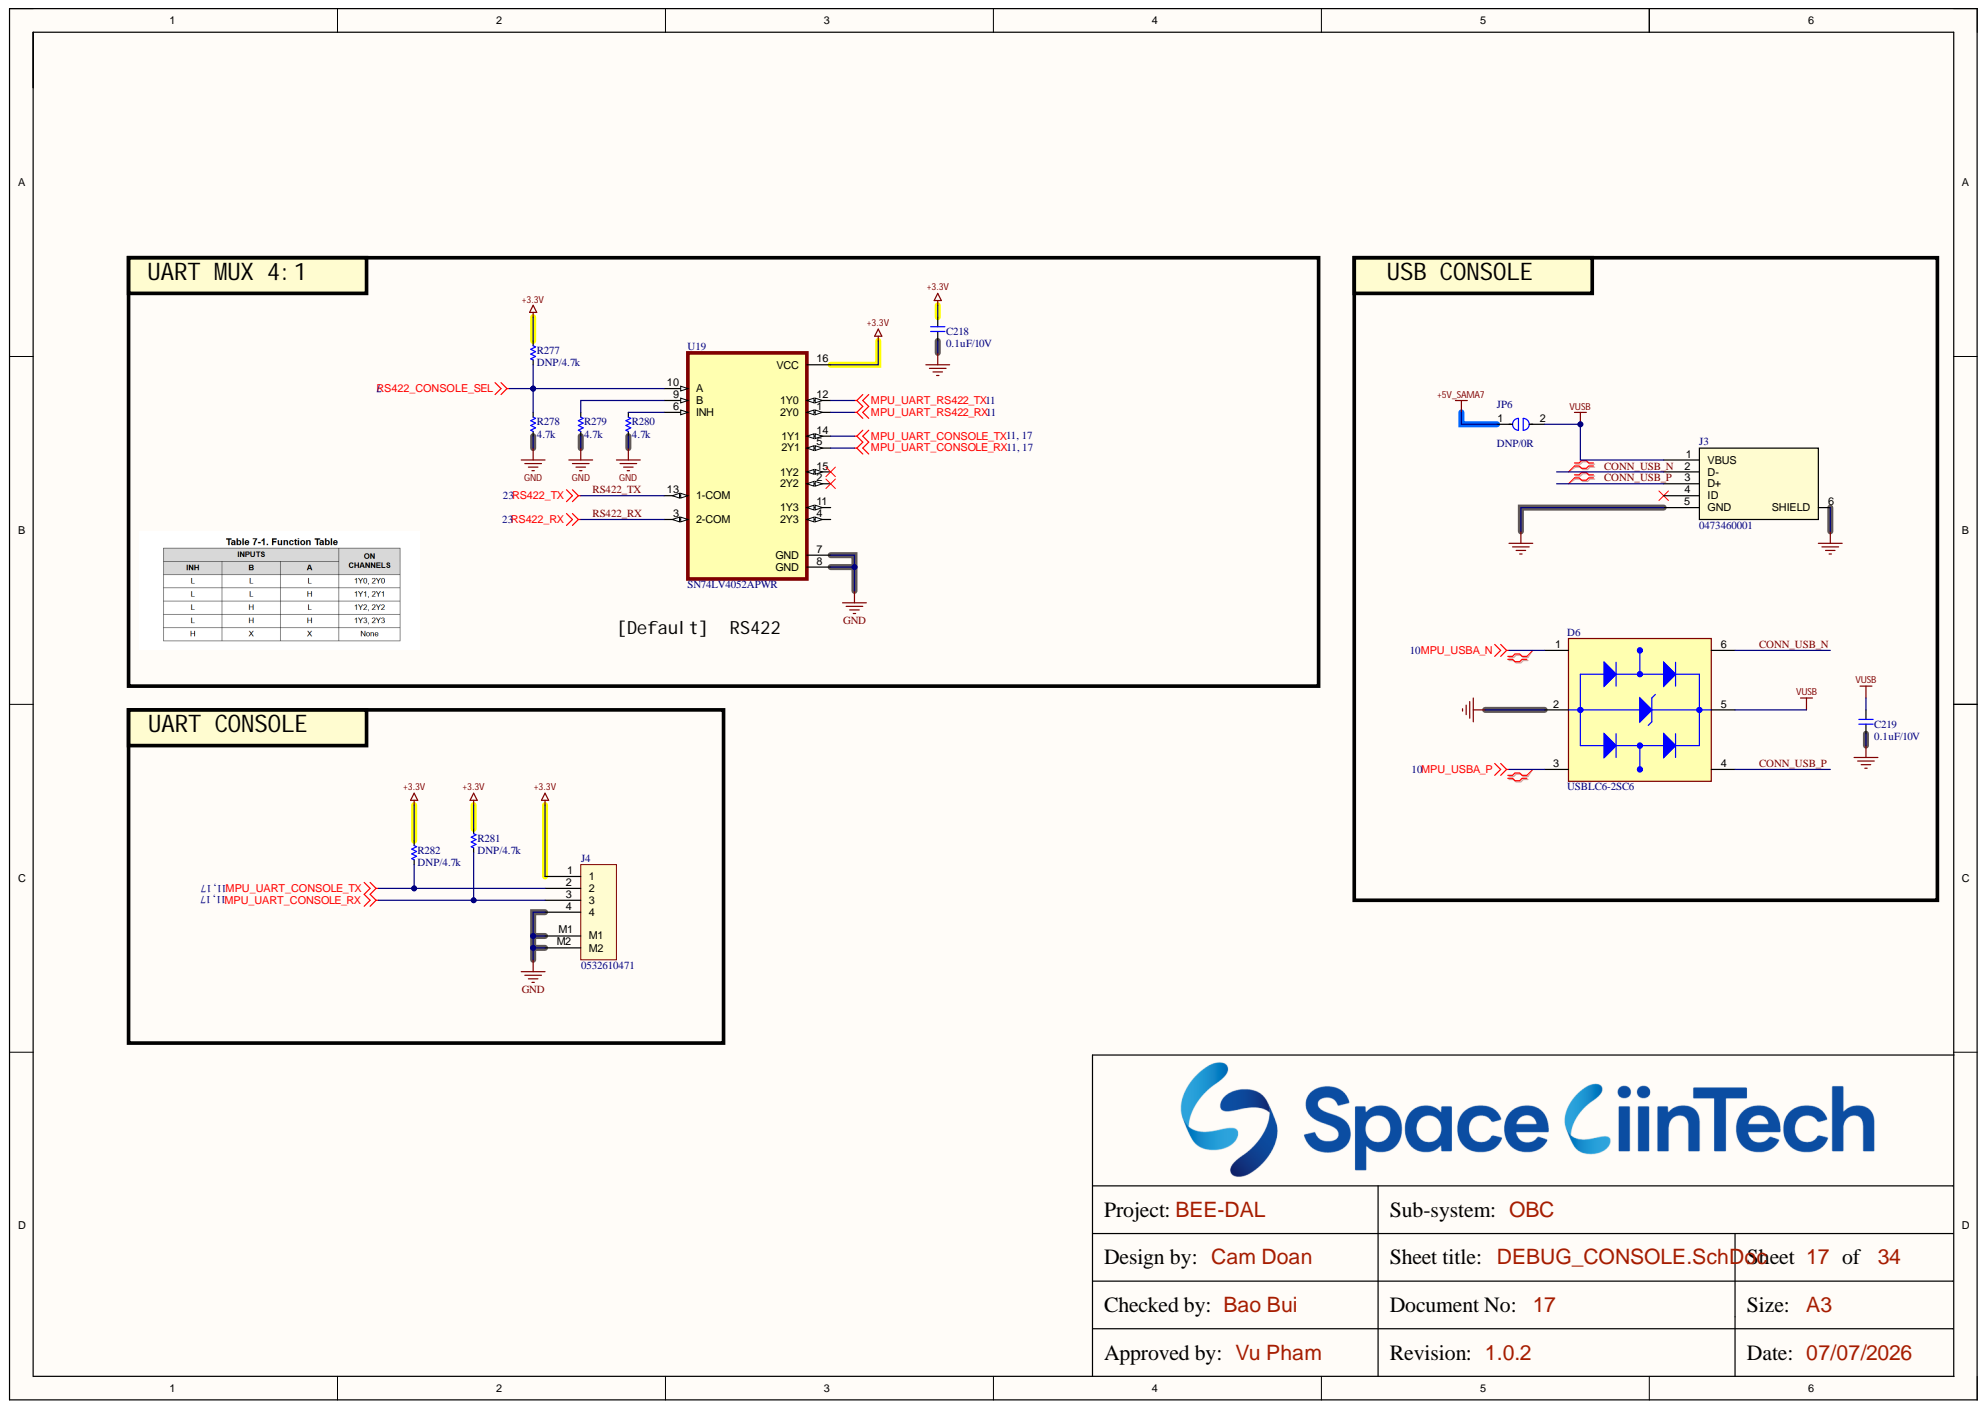
[picture p77: page 17]

BEE-DAL Project: | OBC Sub-system:

Design by: Cam Doan | Sheet title: DEBUG_CONSOLE.SchDoc | Sheet 17 of 34

Checked by: Bao Bui | Document No: 17 | Size: A3

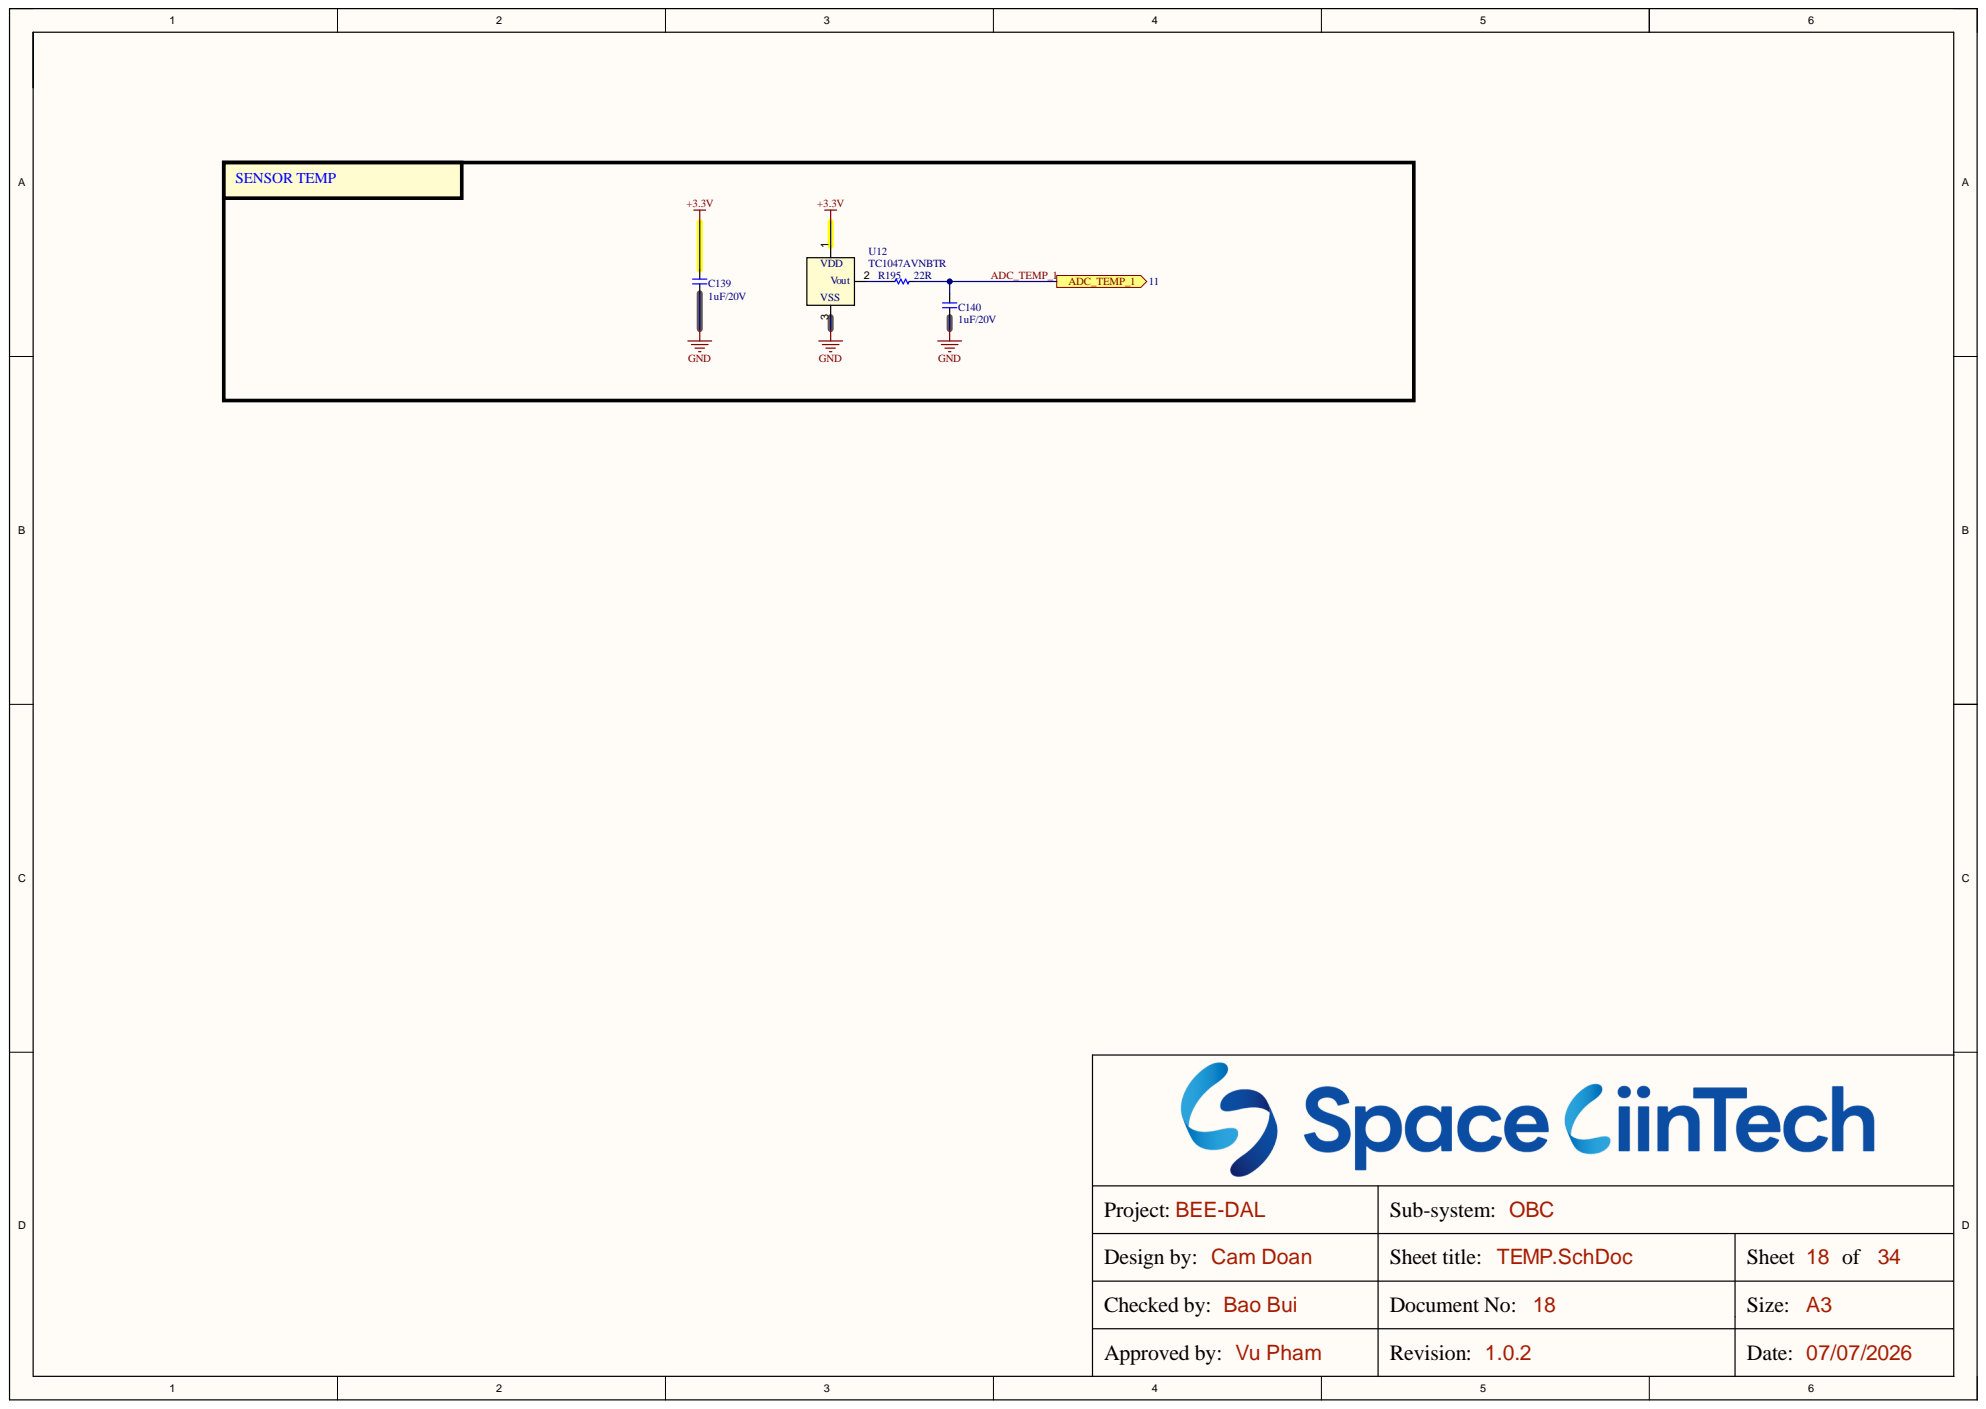
[picture p78: page 18]

BEE-DAL Projec t : | OBC Sub-syste m :

Design by: Cam Do a n | Sheet title: TEMP.Sc hDo c | Shee t 1 8 of 3 4

Checked by: Ba o Bu i | Document No: 1 8 | Size : A3

V u Ph a m | Revisio n : 1.0 . | Date : 7/0

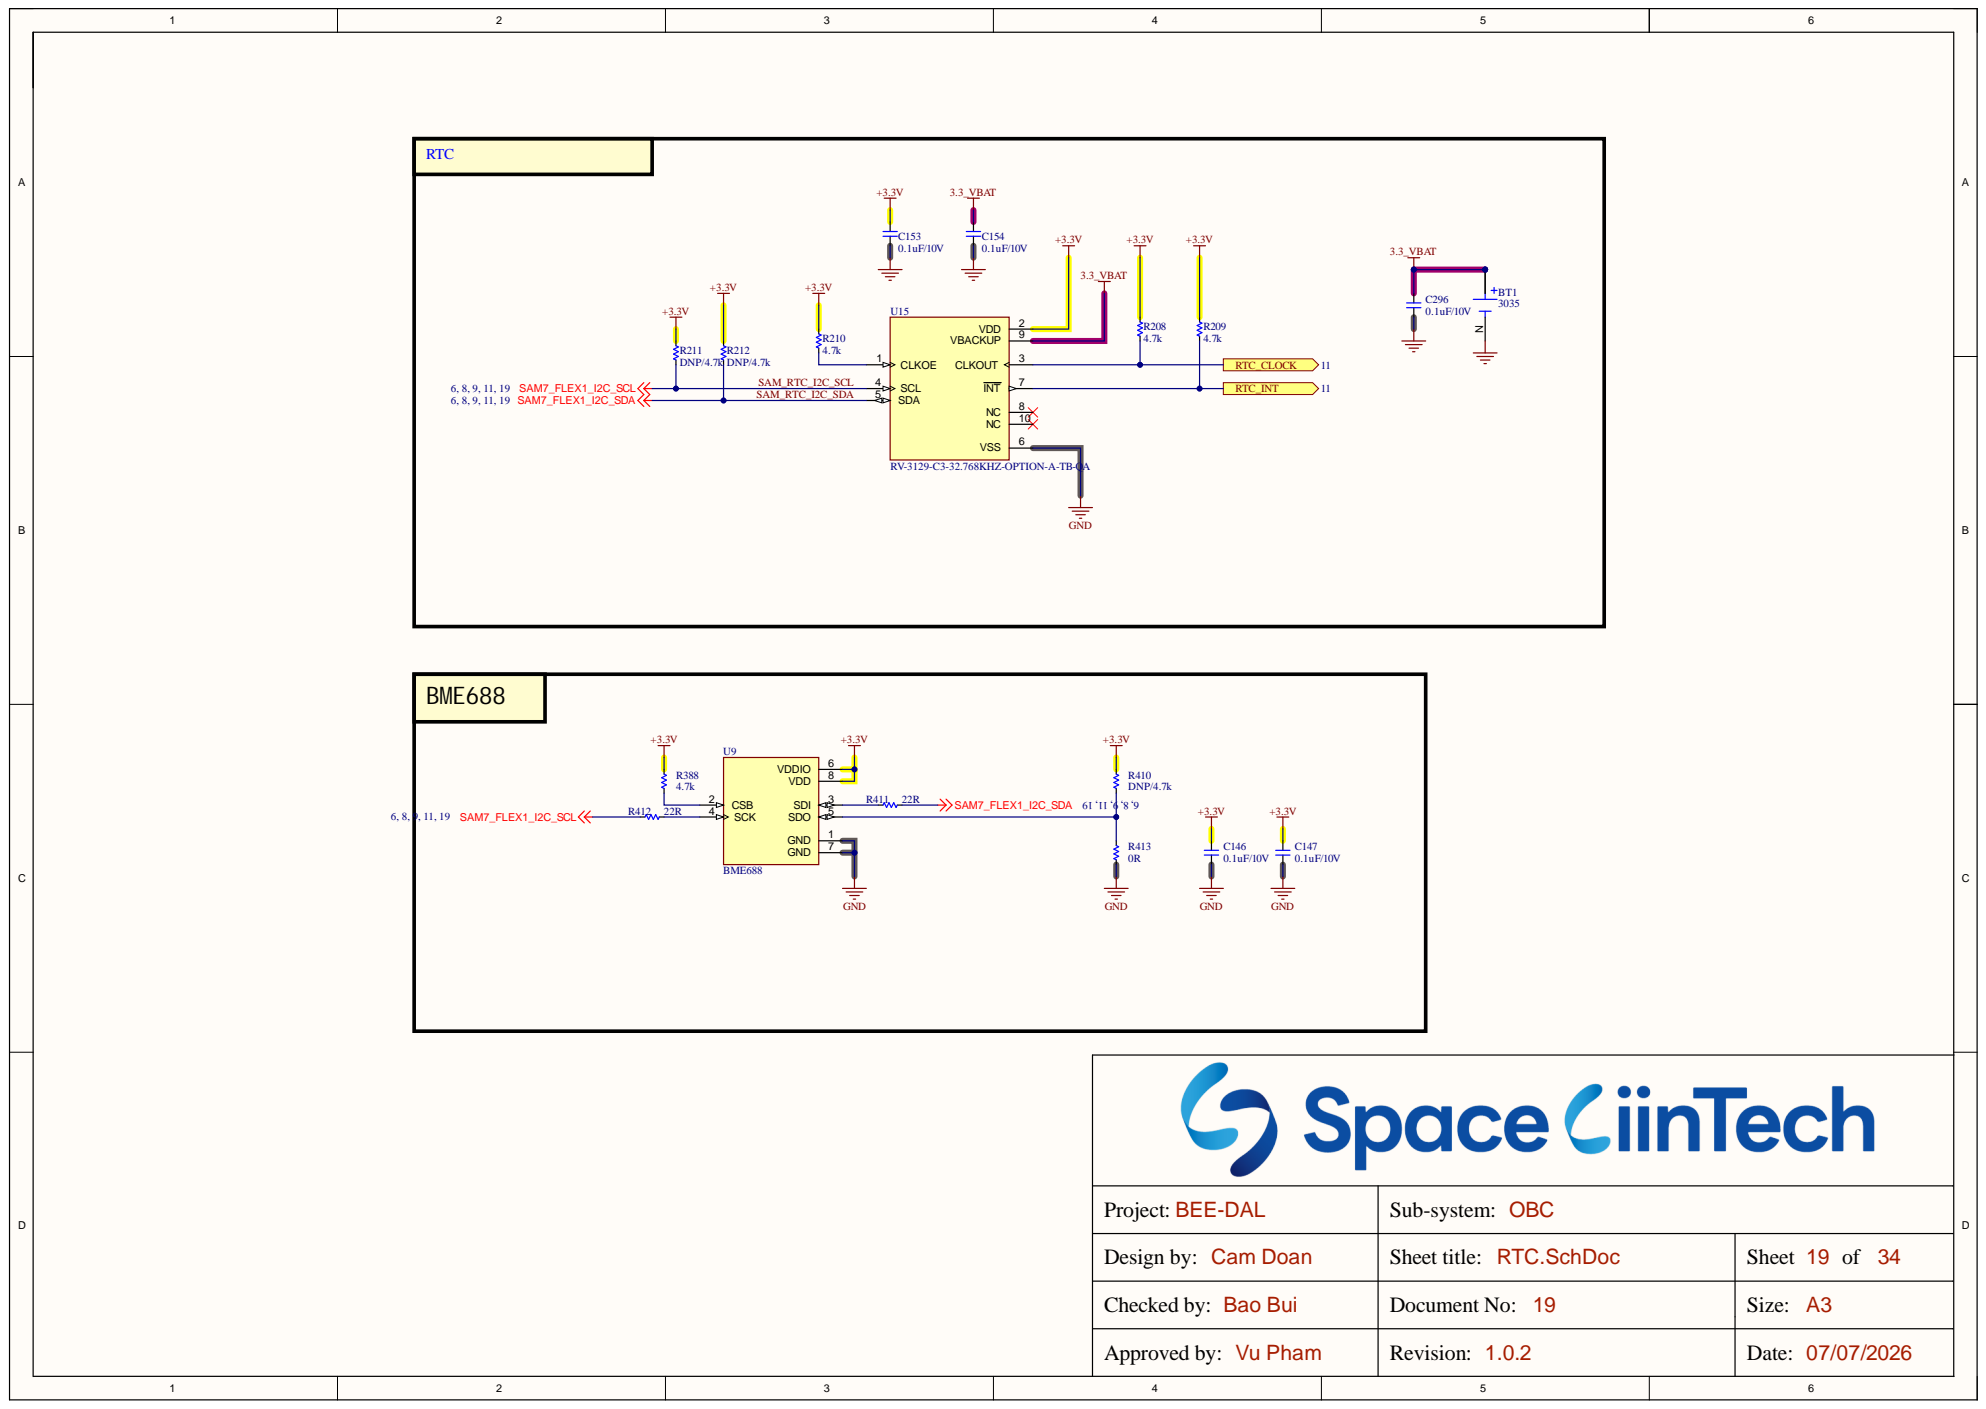
[picture p79: page 19]

RV-3129-C3-32.768KHZ-OPTION-A-TB-QA

BEE-DAL Project: | OBC Sub-system:

Design by: Cam Doan | Sheet title: RTC.SchDoc | Sheet 19 of 34

Checked by: Bao Bui | Document No: 19 | Size: A3

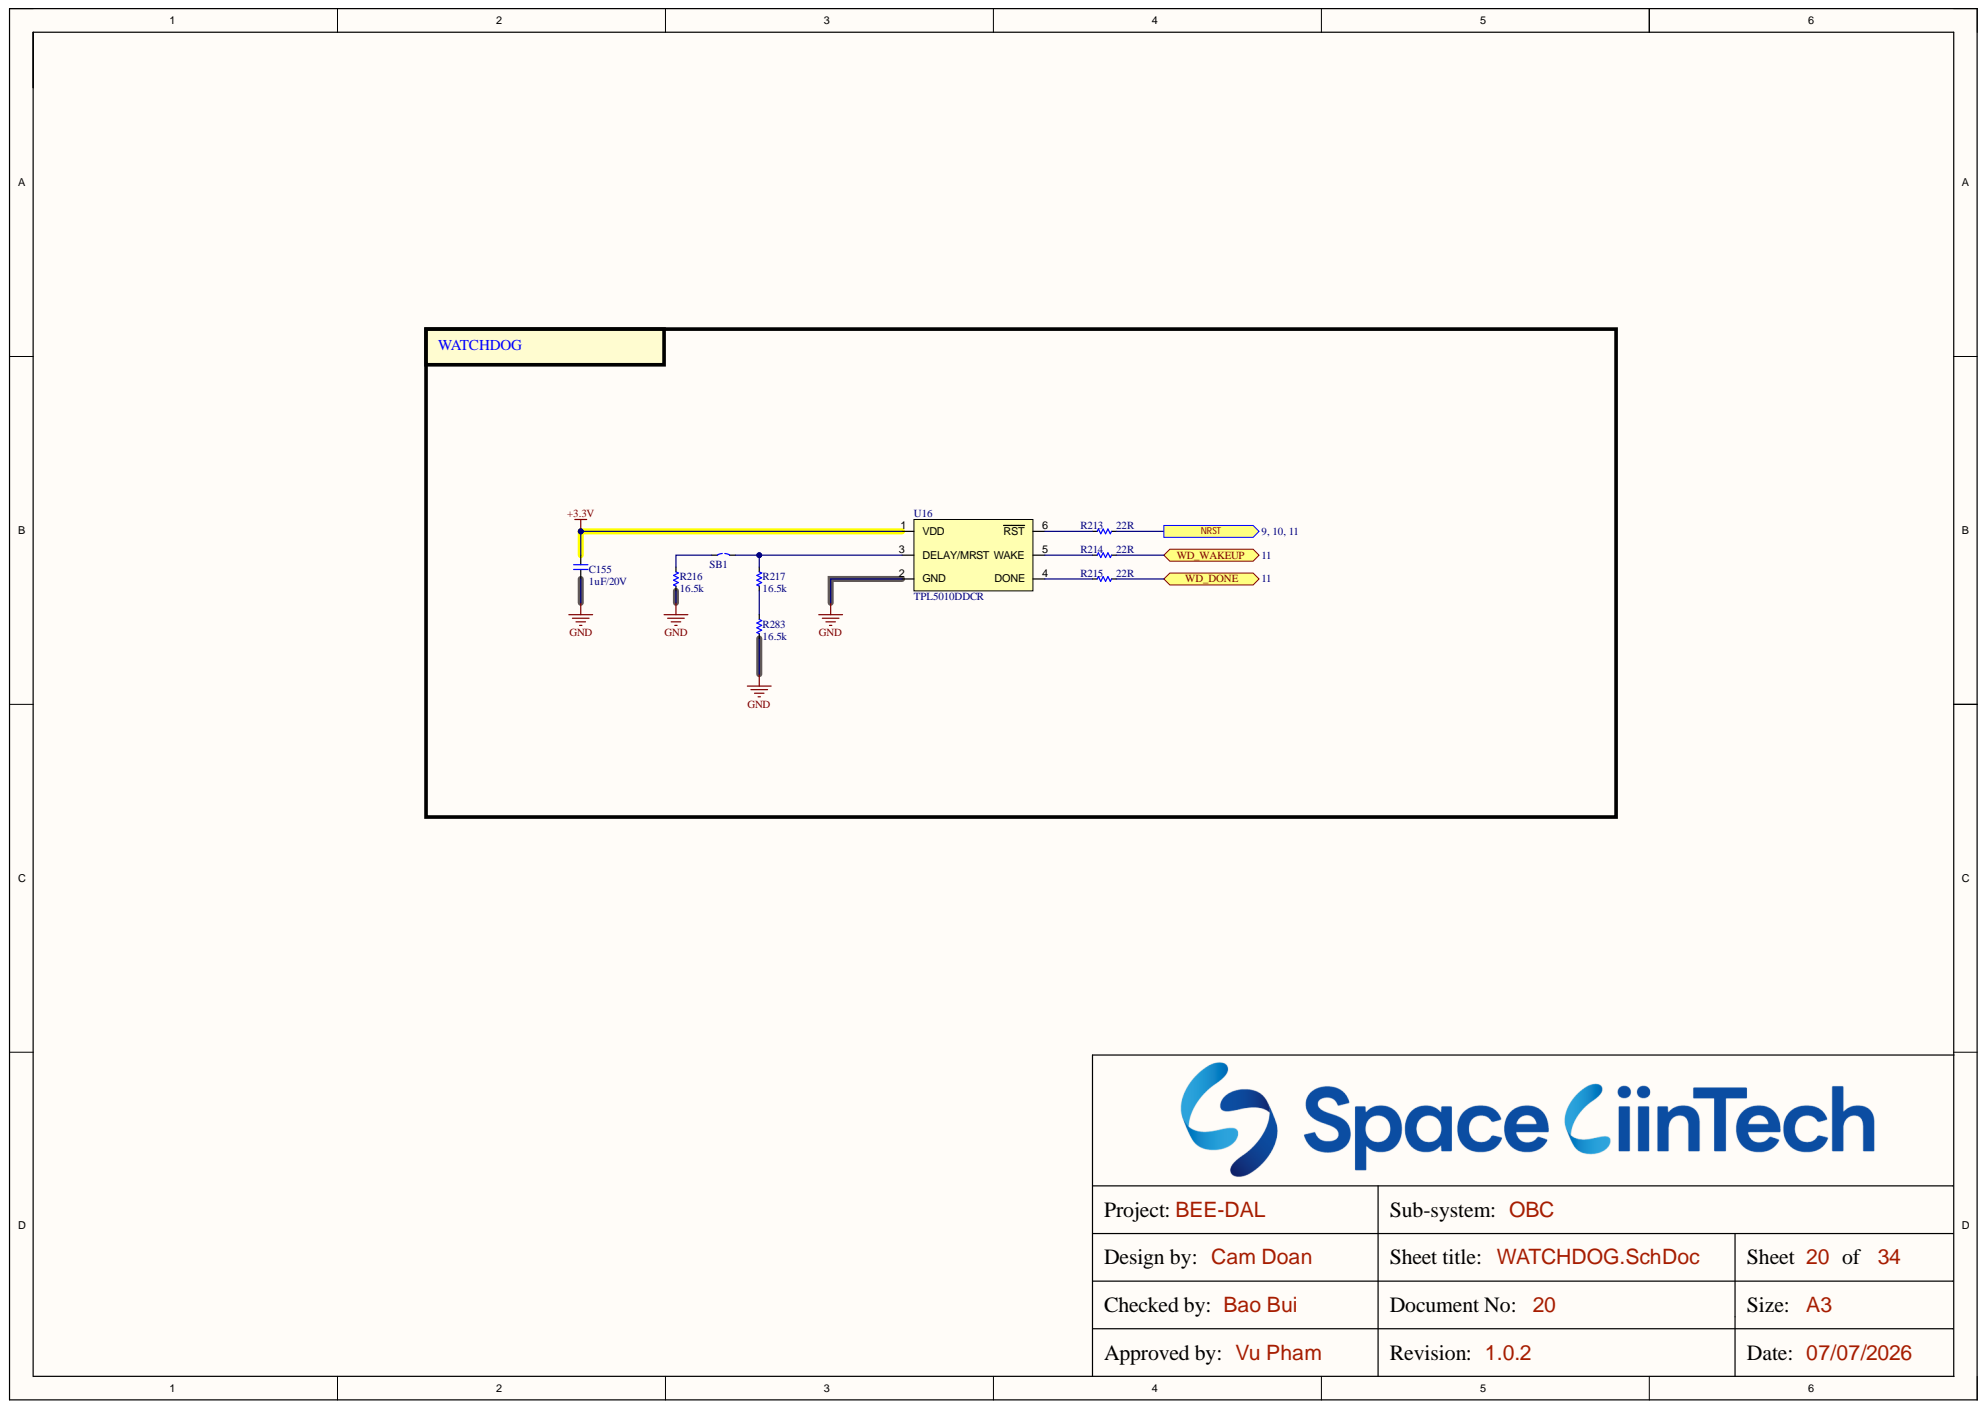
[picture p80: page 20]

BEE-DAL Projec t : | OBC Sub-syste m :

Design by: Cam Do a n | Sheet title: W ATCHDOG.Sc hDo c | Shee t 2 0 of 3 4

Checked by: Ba o Bu i | Document No: 2 0 | Size : A3

V u Ph a m | Revisio n : 1.0 . | Date : 7/0

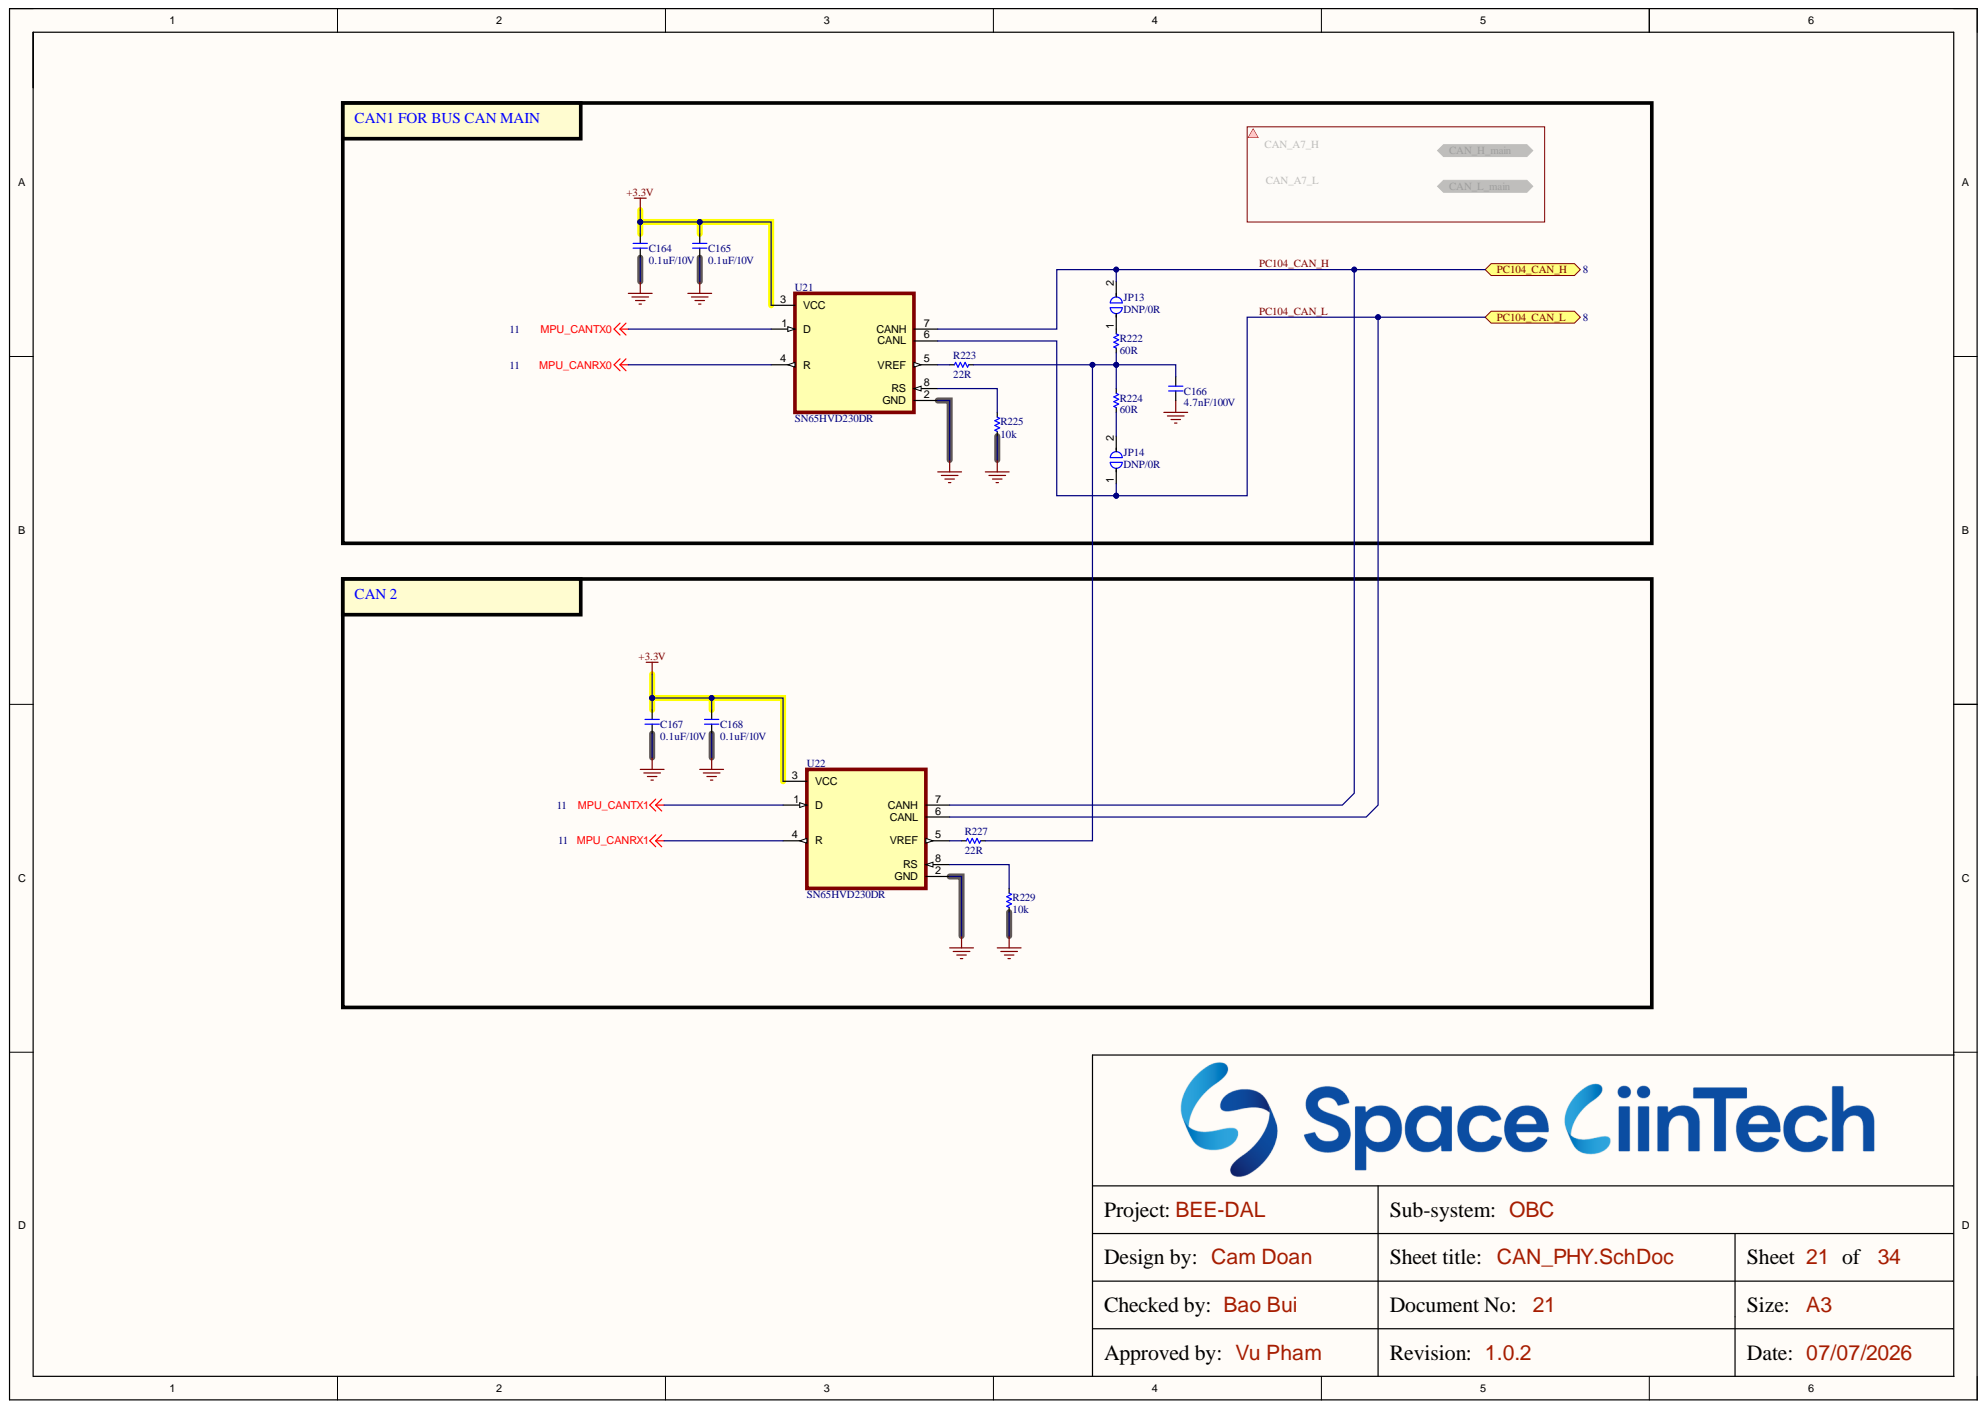
[picture p81: page 21]

CAN1 FOR BUS CAN MAIN

BEE-DAL Project: | OBC Sub-system:

Design by: Cam Doan | Sheet title: CAN_PHY.SchDoc | Sheet 21 of 34

Checked by: Bao Bui | Document No: 21 | Size: A3

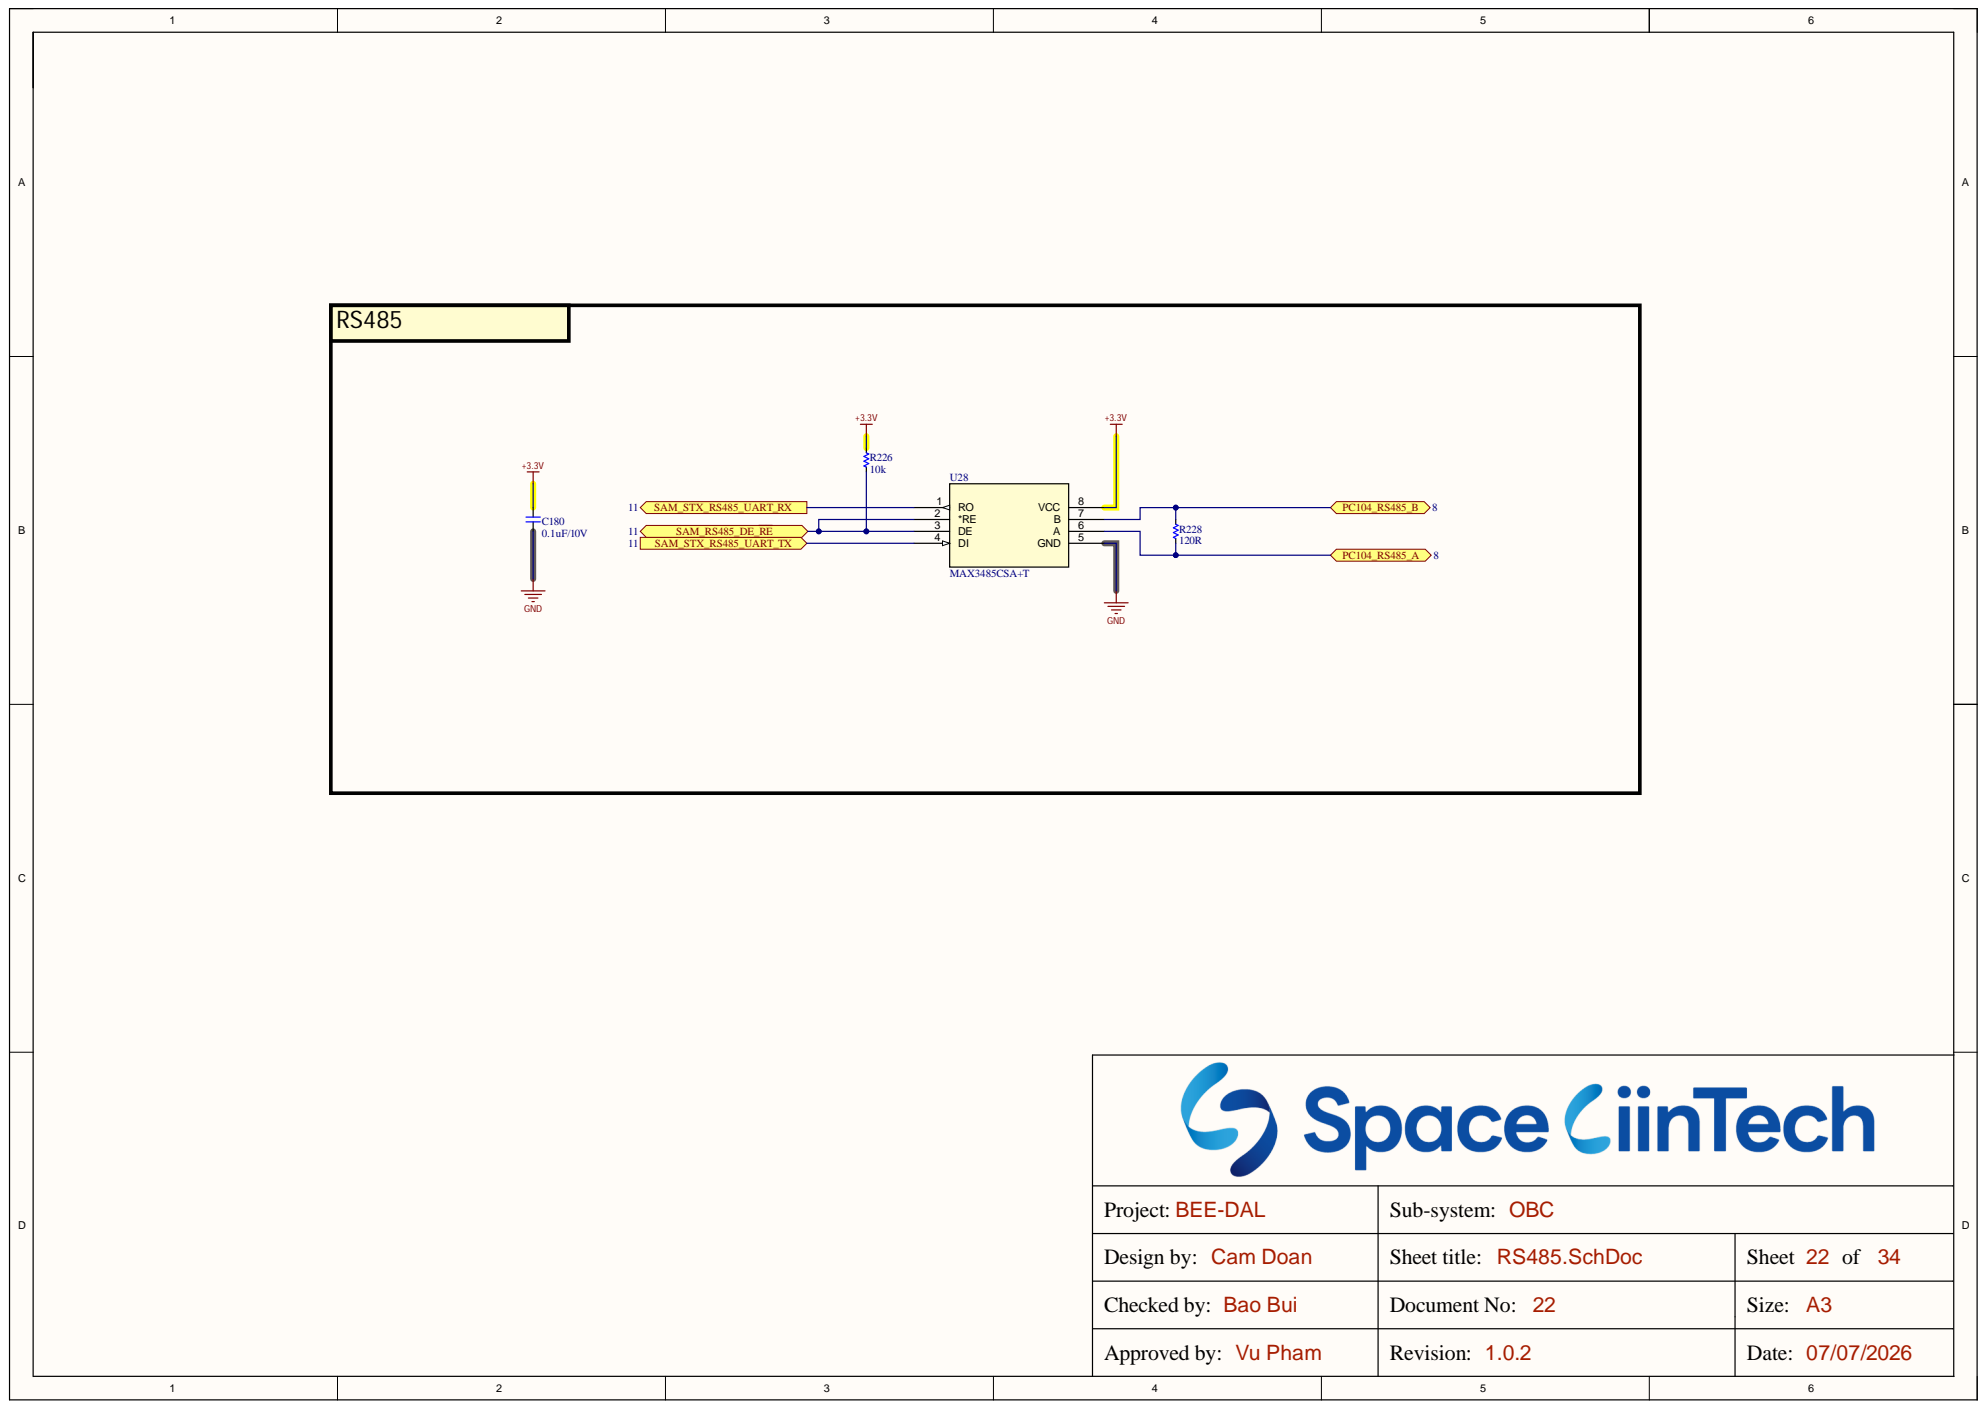
[picture p82: page 22]

BEE-DAL Projec t : | OBC Sub-syste m :

Design by: Cam Do a n | Sheet title: RS4 8 5.Sc hDo c | Shee t 2 2 of 3 4

Checked by: Ba o Bu i | Document No: 2 2 | Size : A3

V u Ph a m | Revisio n : 1.0 . | Date : 7/0

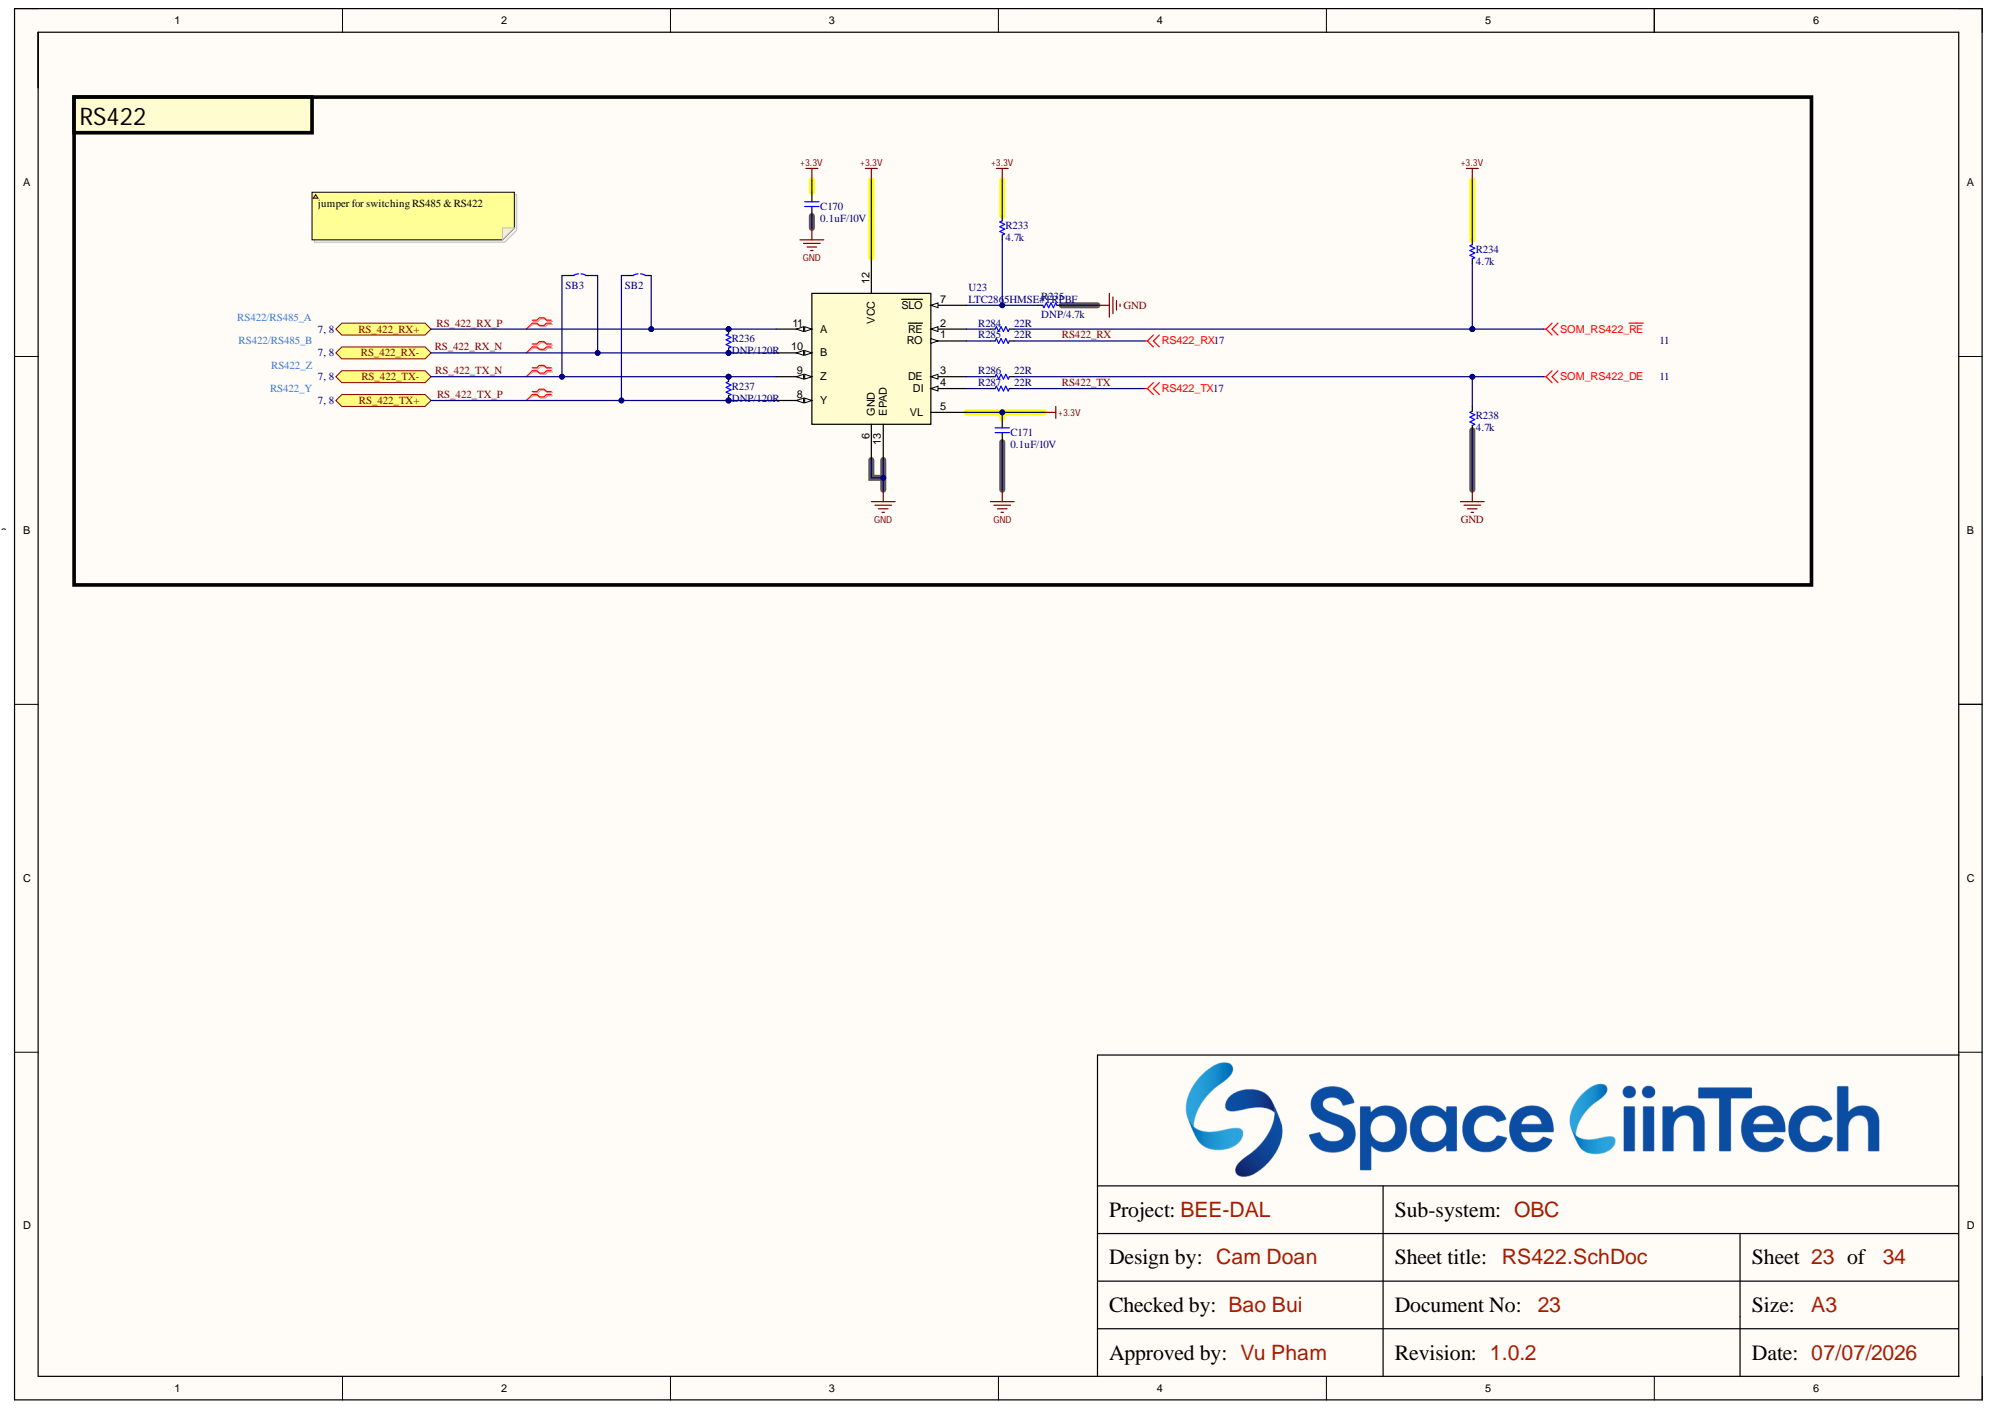
[picture p83: page 23]

BEE-DAL Projec t : | OBC Sub-syste m :

Design by: Cam Do a n | Sheet title: RS4 2 2.Sc hDo c | Shee t 2 3 of 3 4

Checked by: Ba o Bu i | Document No: 2 3 | Size : A3

V u Ph a m | Revisio n : 1.0 . | Date : 7/0

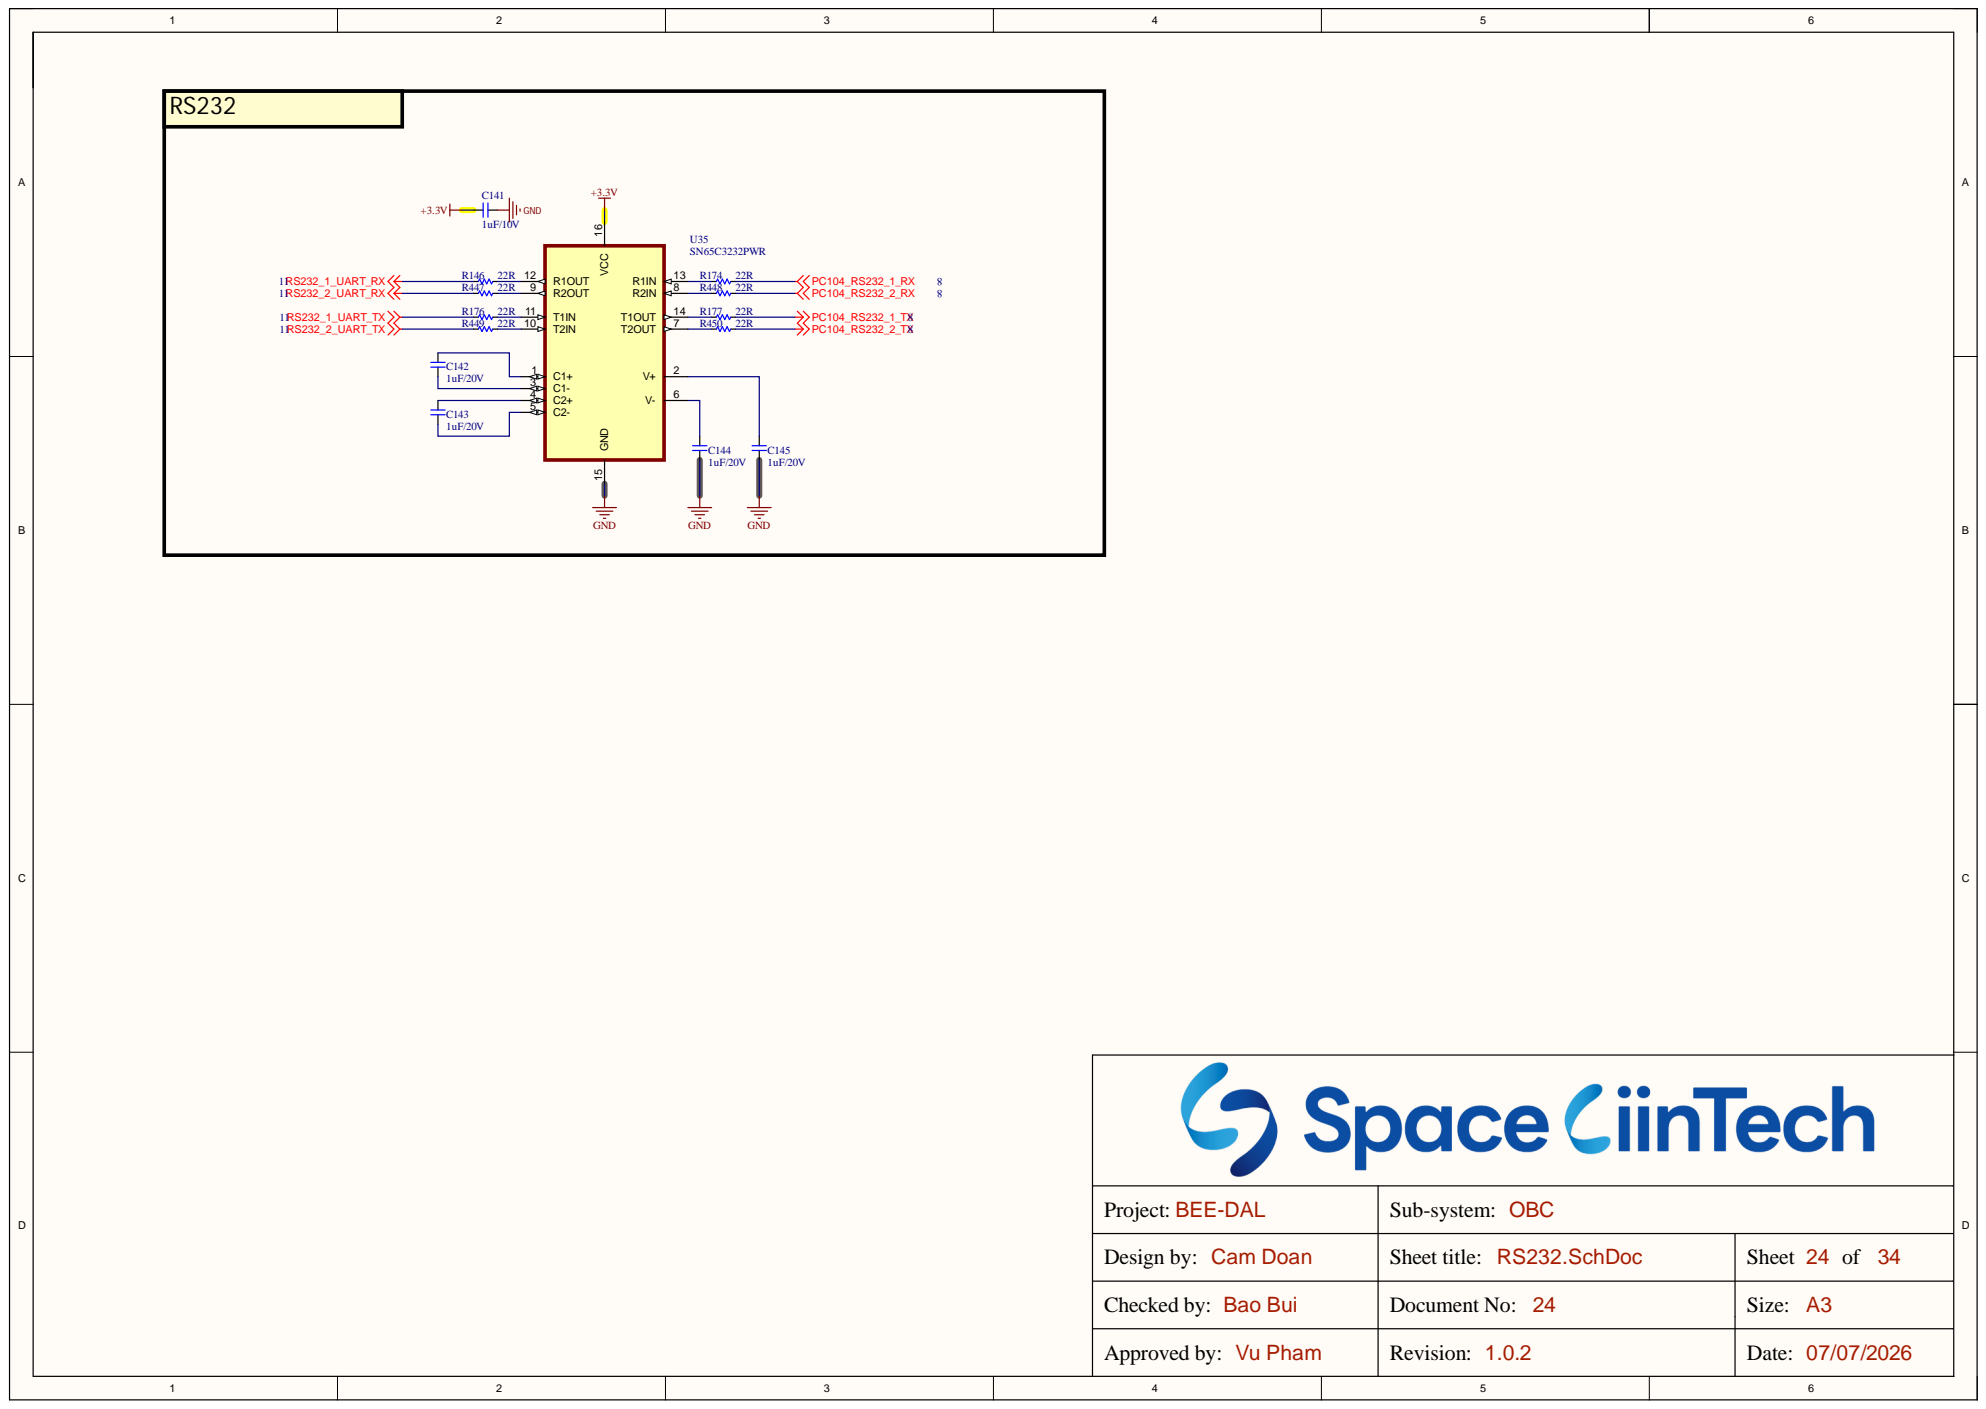
[picture p84: page 24]

BEE-DAL Project: | OBC Sub-system:

Design by: Cam Doan | Sheet title: RS232.SchDoc | Sheet 24 of 34

Checked by: Bao Bui | Document No: 24 | Size: A3

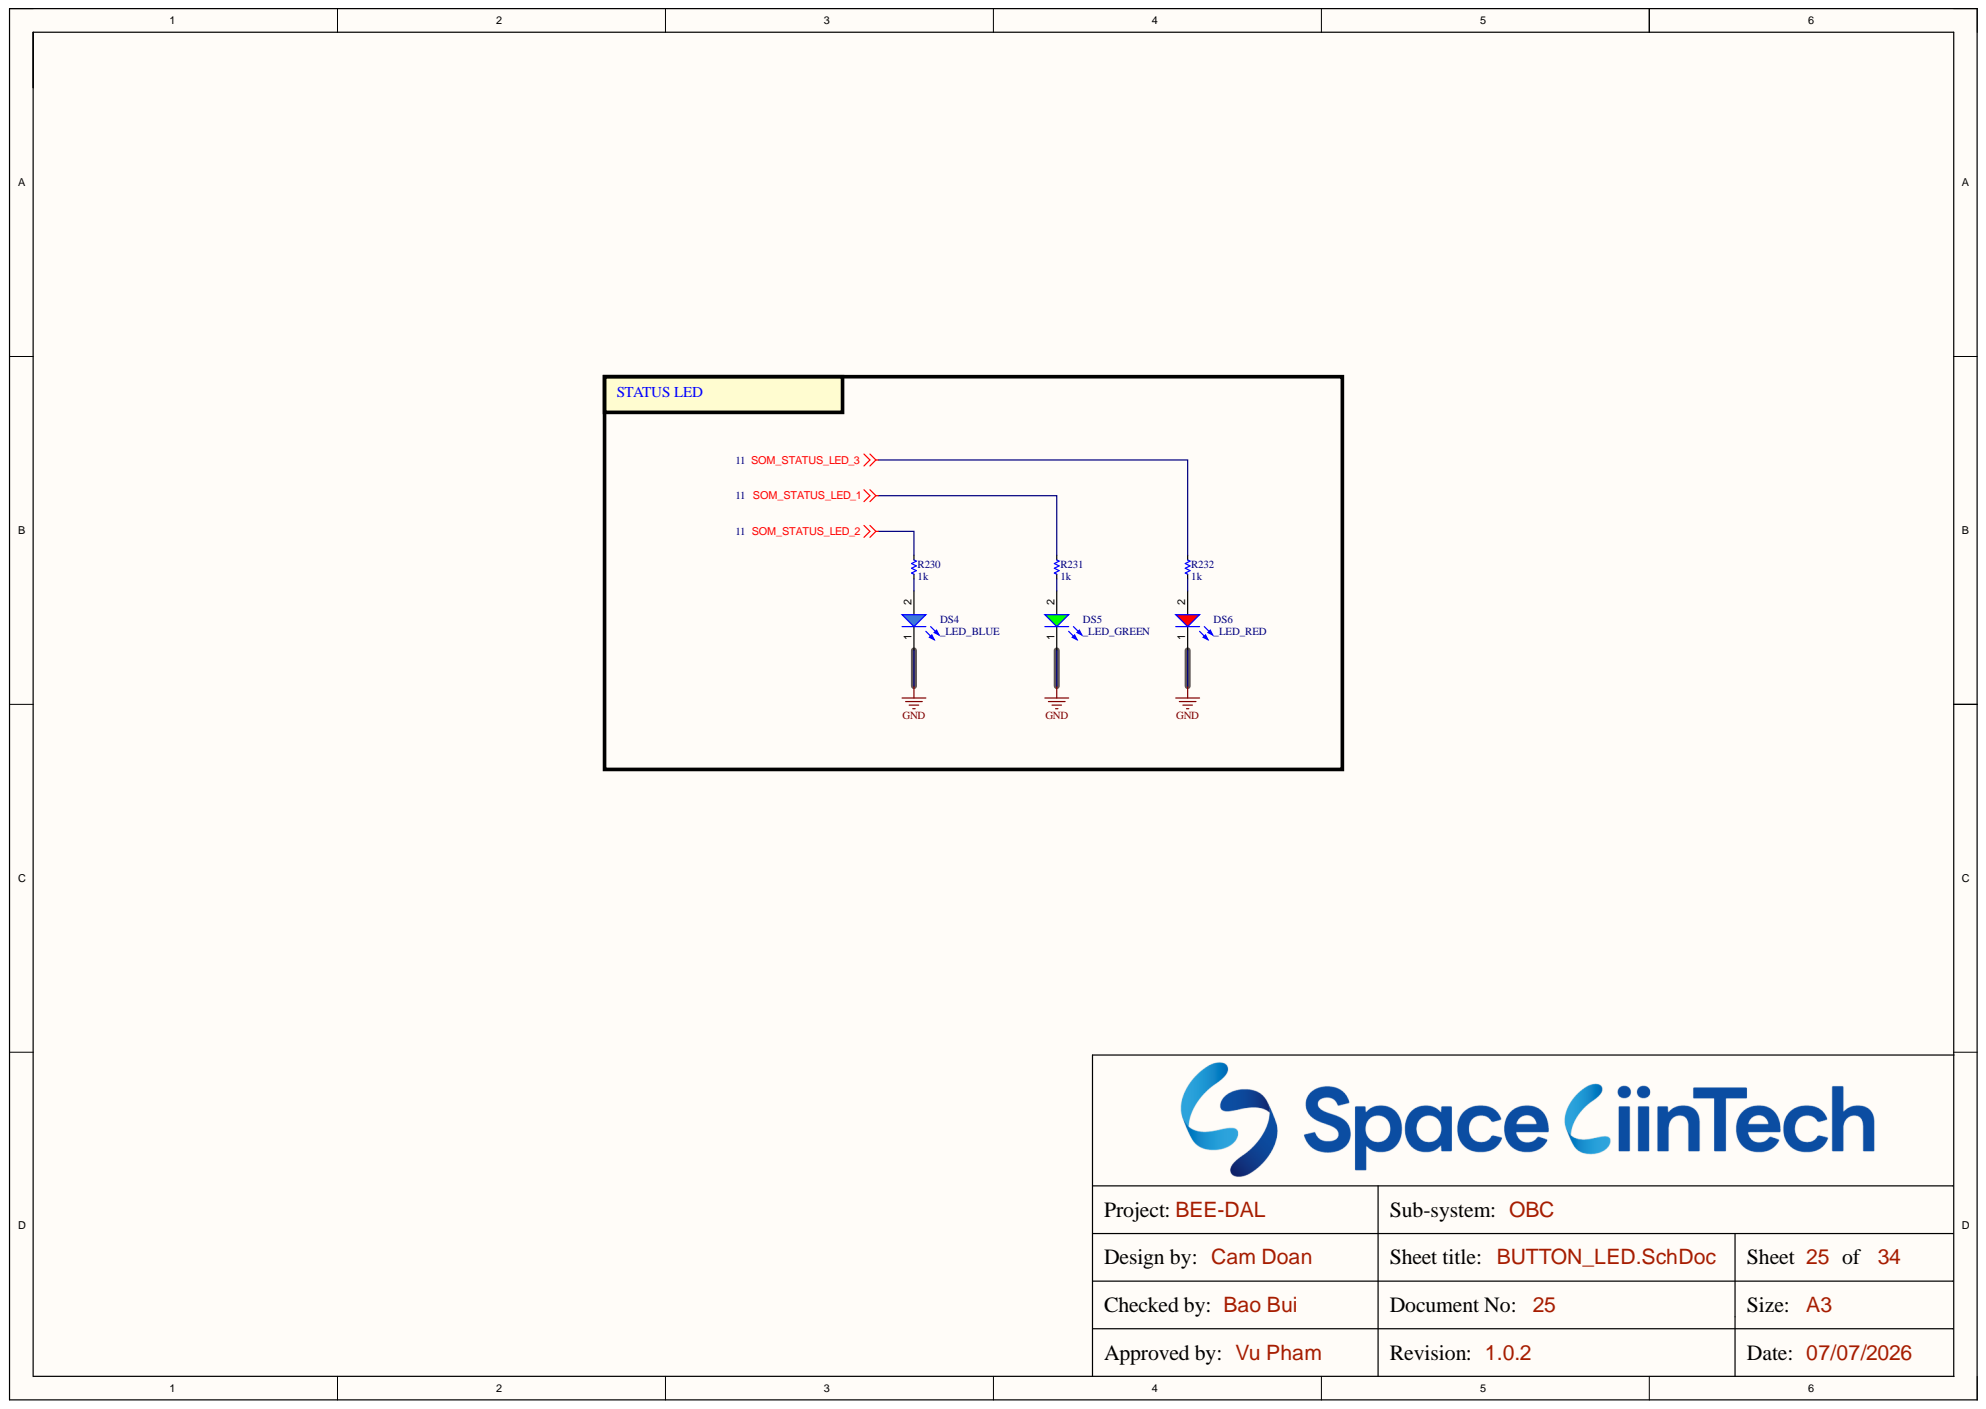
[picture p85: page 25]

BEE-DAL Projec t : | OBC Sub-syste m :

Design by: Cam Do a n | Sheet title: BUT TON_ LED.Sc hDo c | Shee t 2 5 of 3 4

Checked by: Ba o Bu i | Document No: 2 5 | Size : A3

V u Ph a m | Revisio n : 1.0 . | Date : 7/0

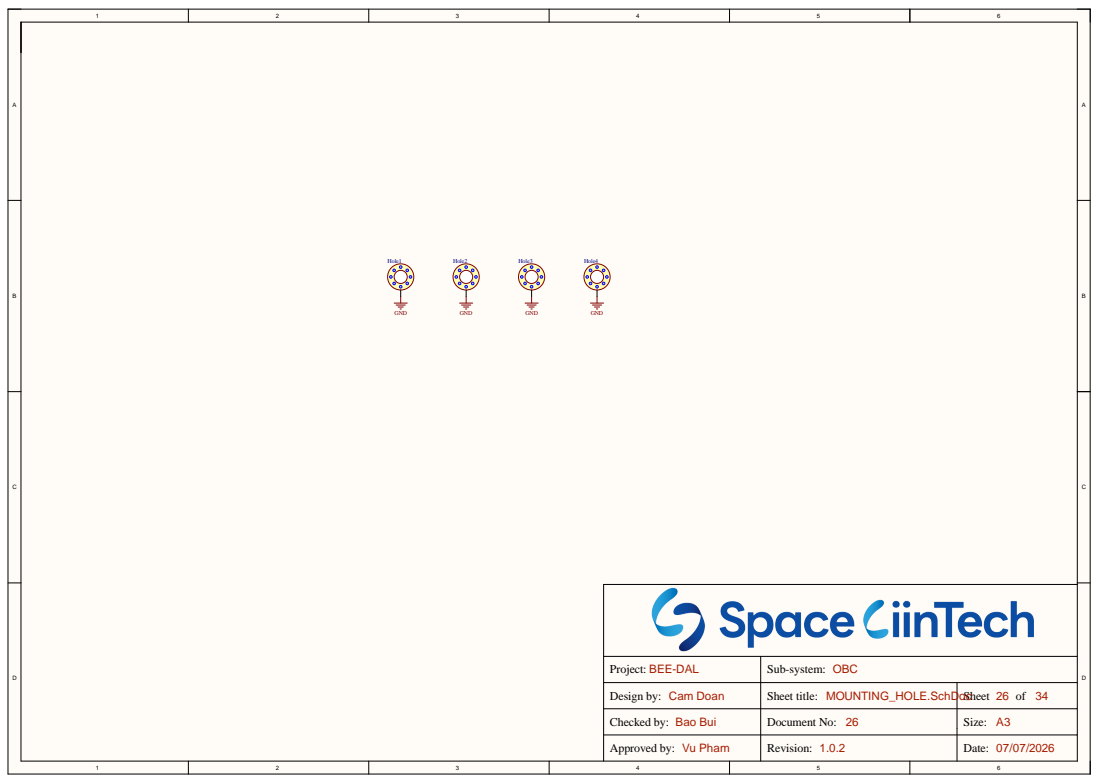
[picture p86: page 26]

BEE-DAL Project: | OBC Sub-system:

Design by: Cam Doan | Sheet title: MOUNTING_HOLE.SchDoc | Sheet 26 of 34

Checked by: Bao Bui | Document No: 26 | Size: A3

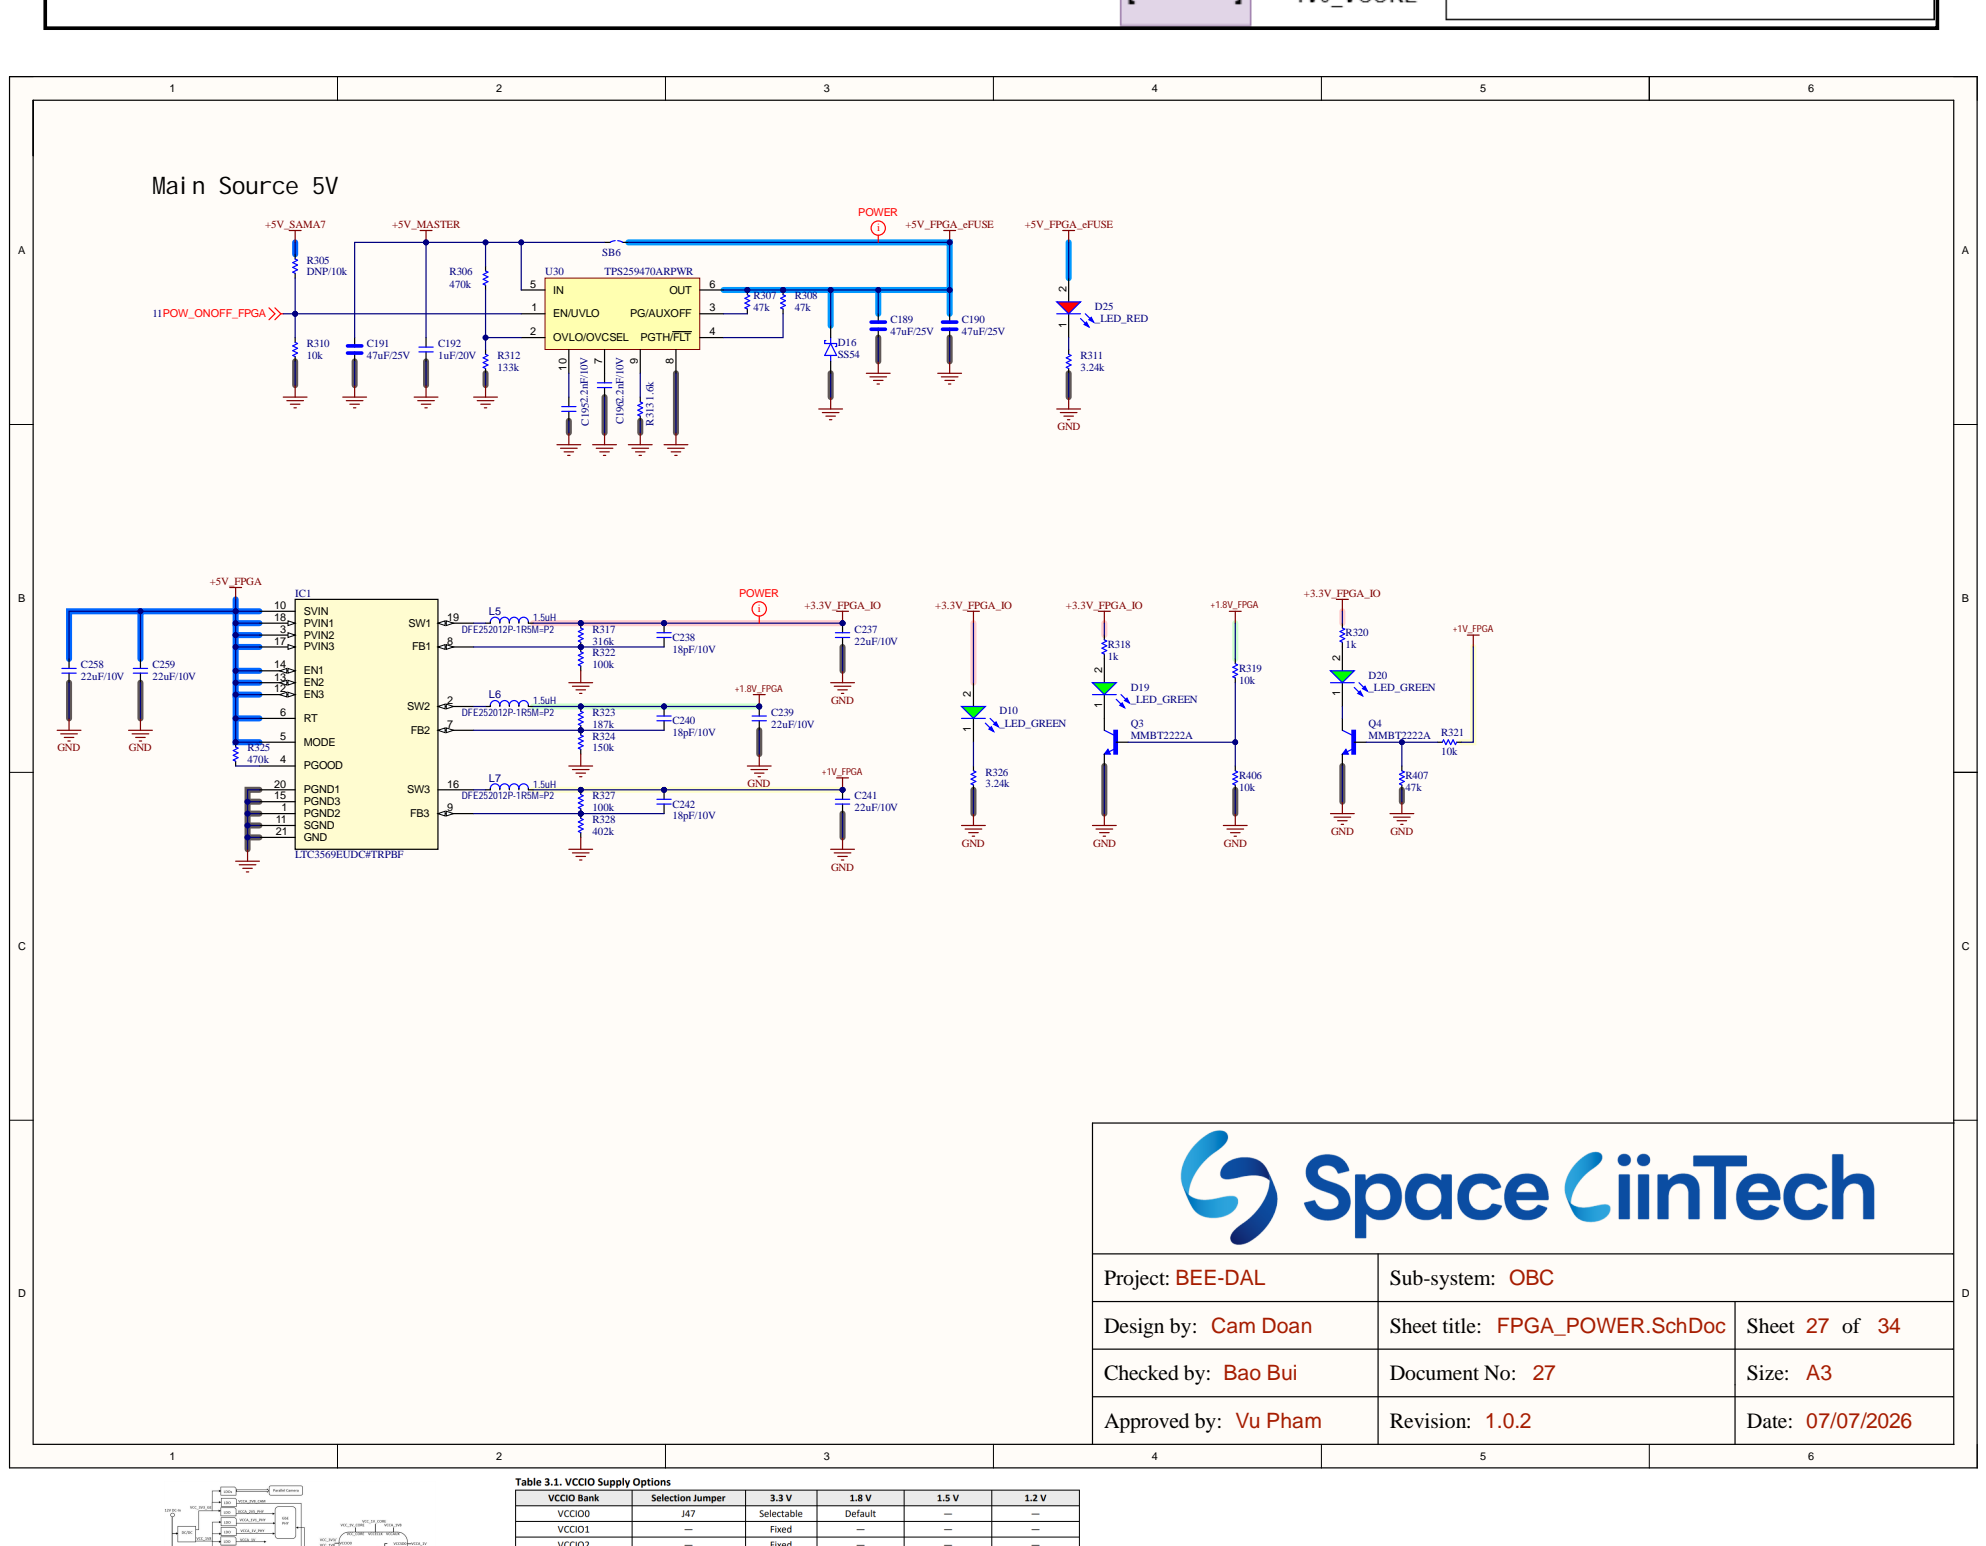
[picture p87: page 27]

BEE-DAL Projec t : | OBC Sub-syste m :

Design by: Cam Do a n | Sheet title: FPGA_POWER.Sc hDo c | Shee t 2 7 of 3 4

Checked by: Ba o Bu i | Document No: 2 7 | Size : A3

V u Ph a m | Revisio n : 1.0 . | Date : 7/0

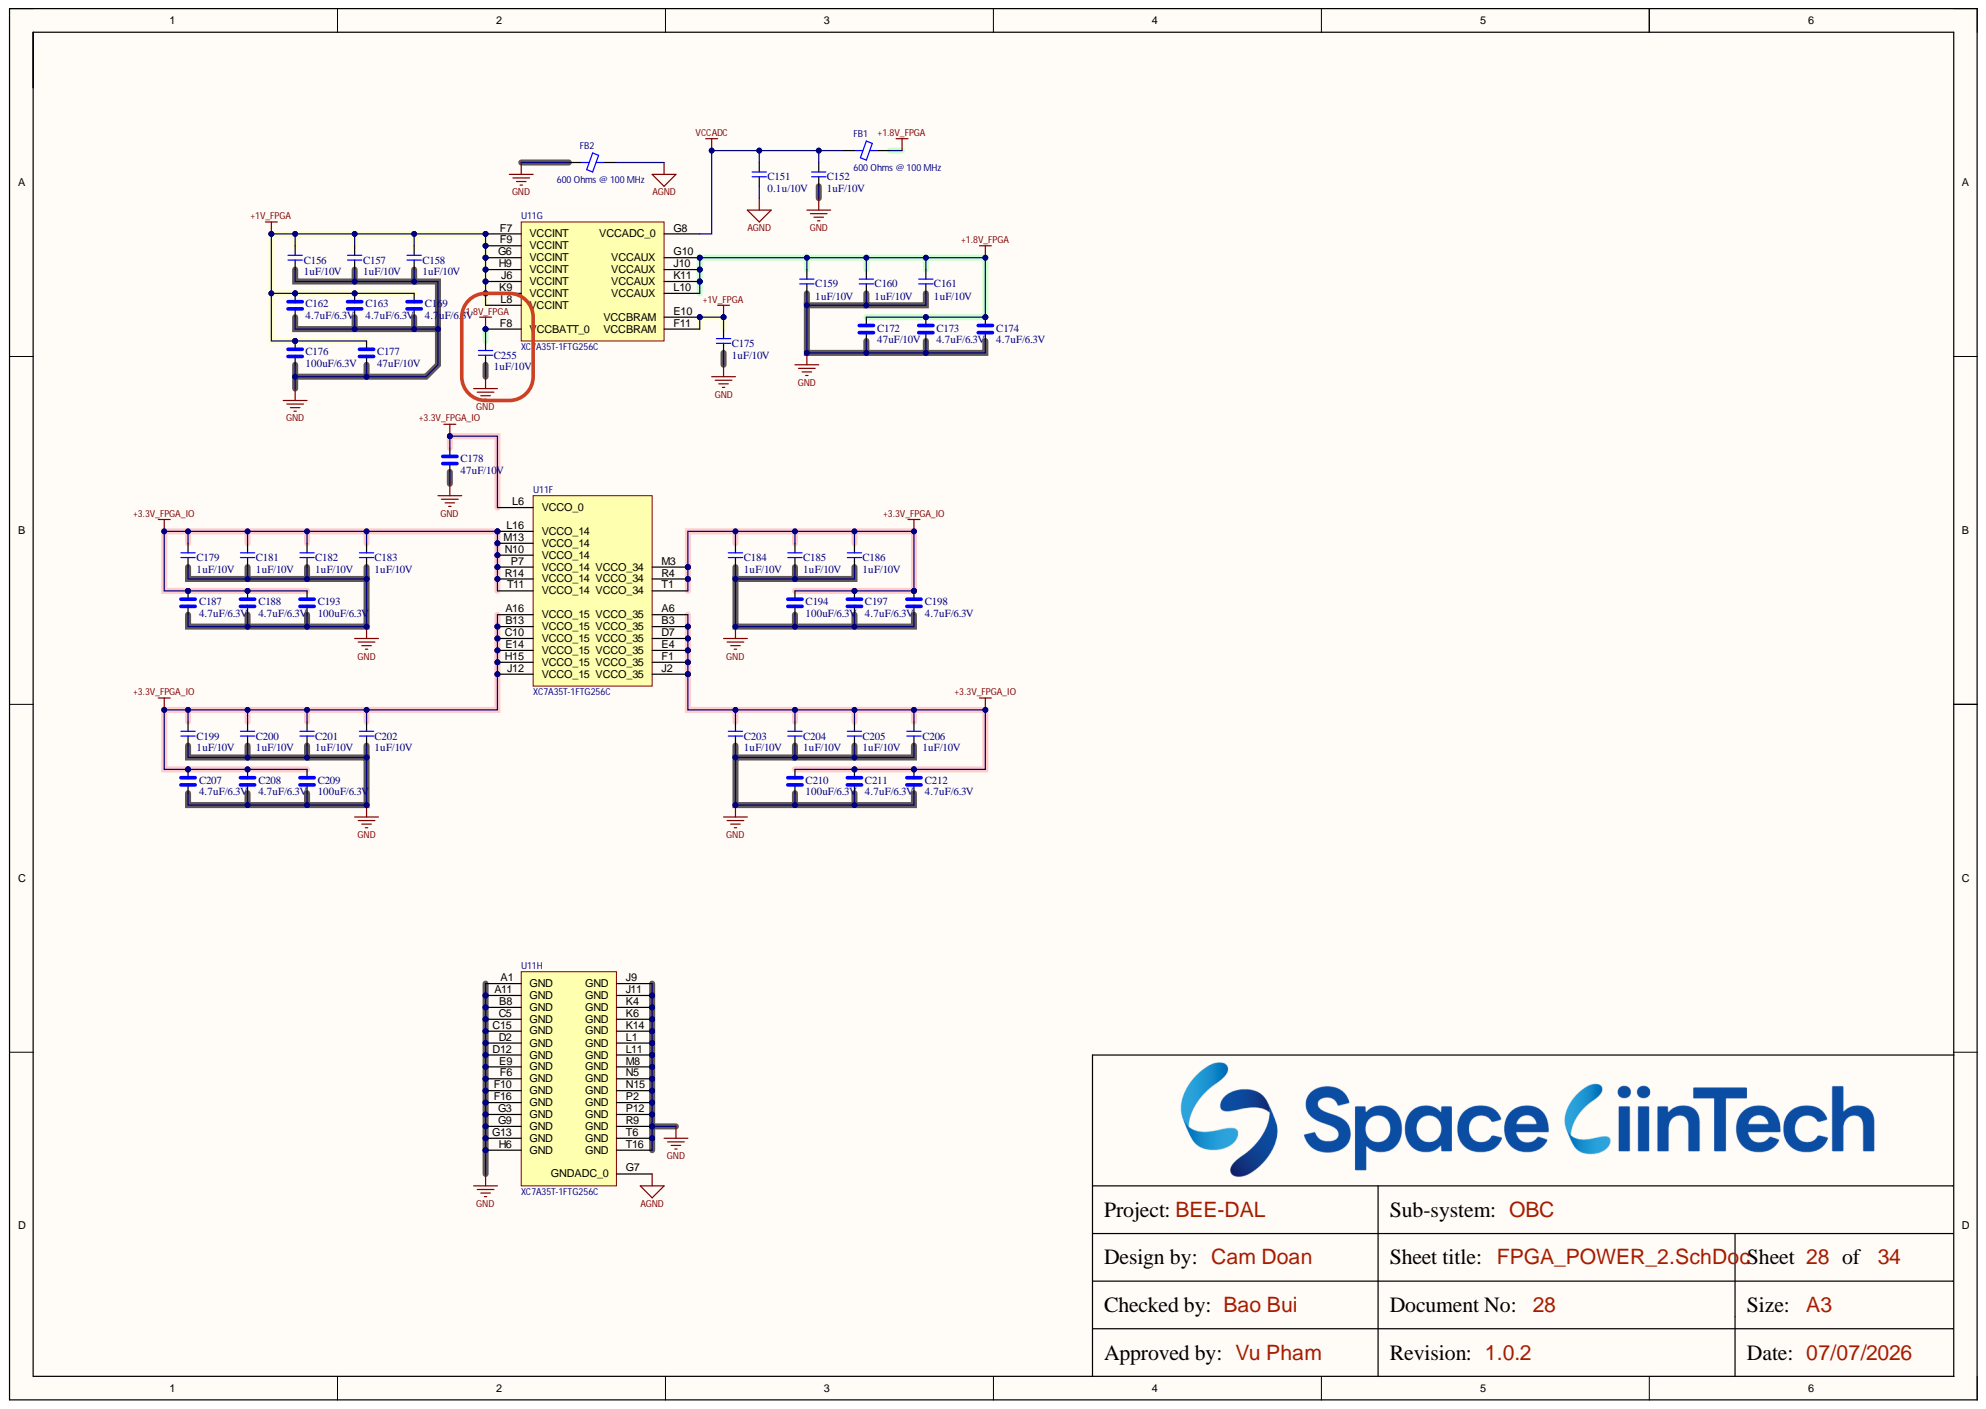
[picture p88: page 28]

Design by: Cam Doan | Sheet title: FPGA_POWER_2.SchDoc | Sheet 28 of 34

Checked by: Bao Bui | Document No: 28 | Size: A3

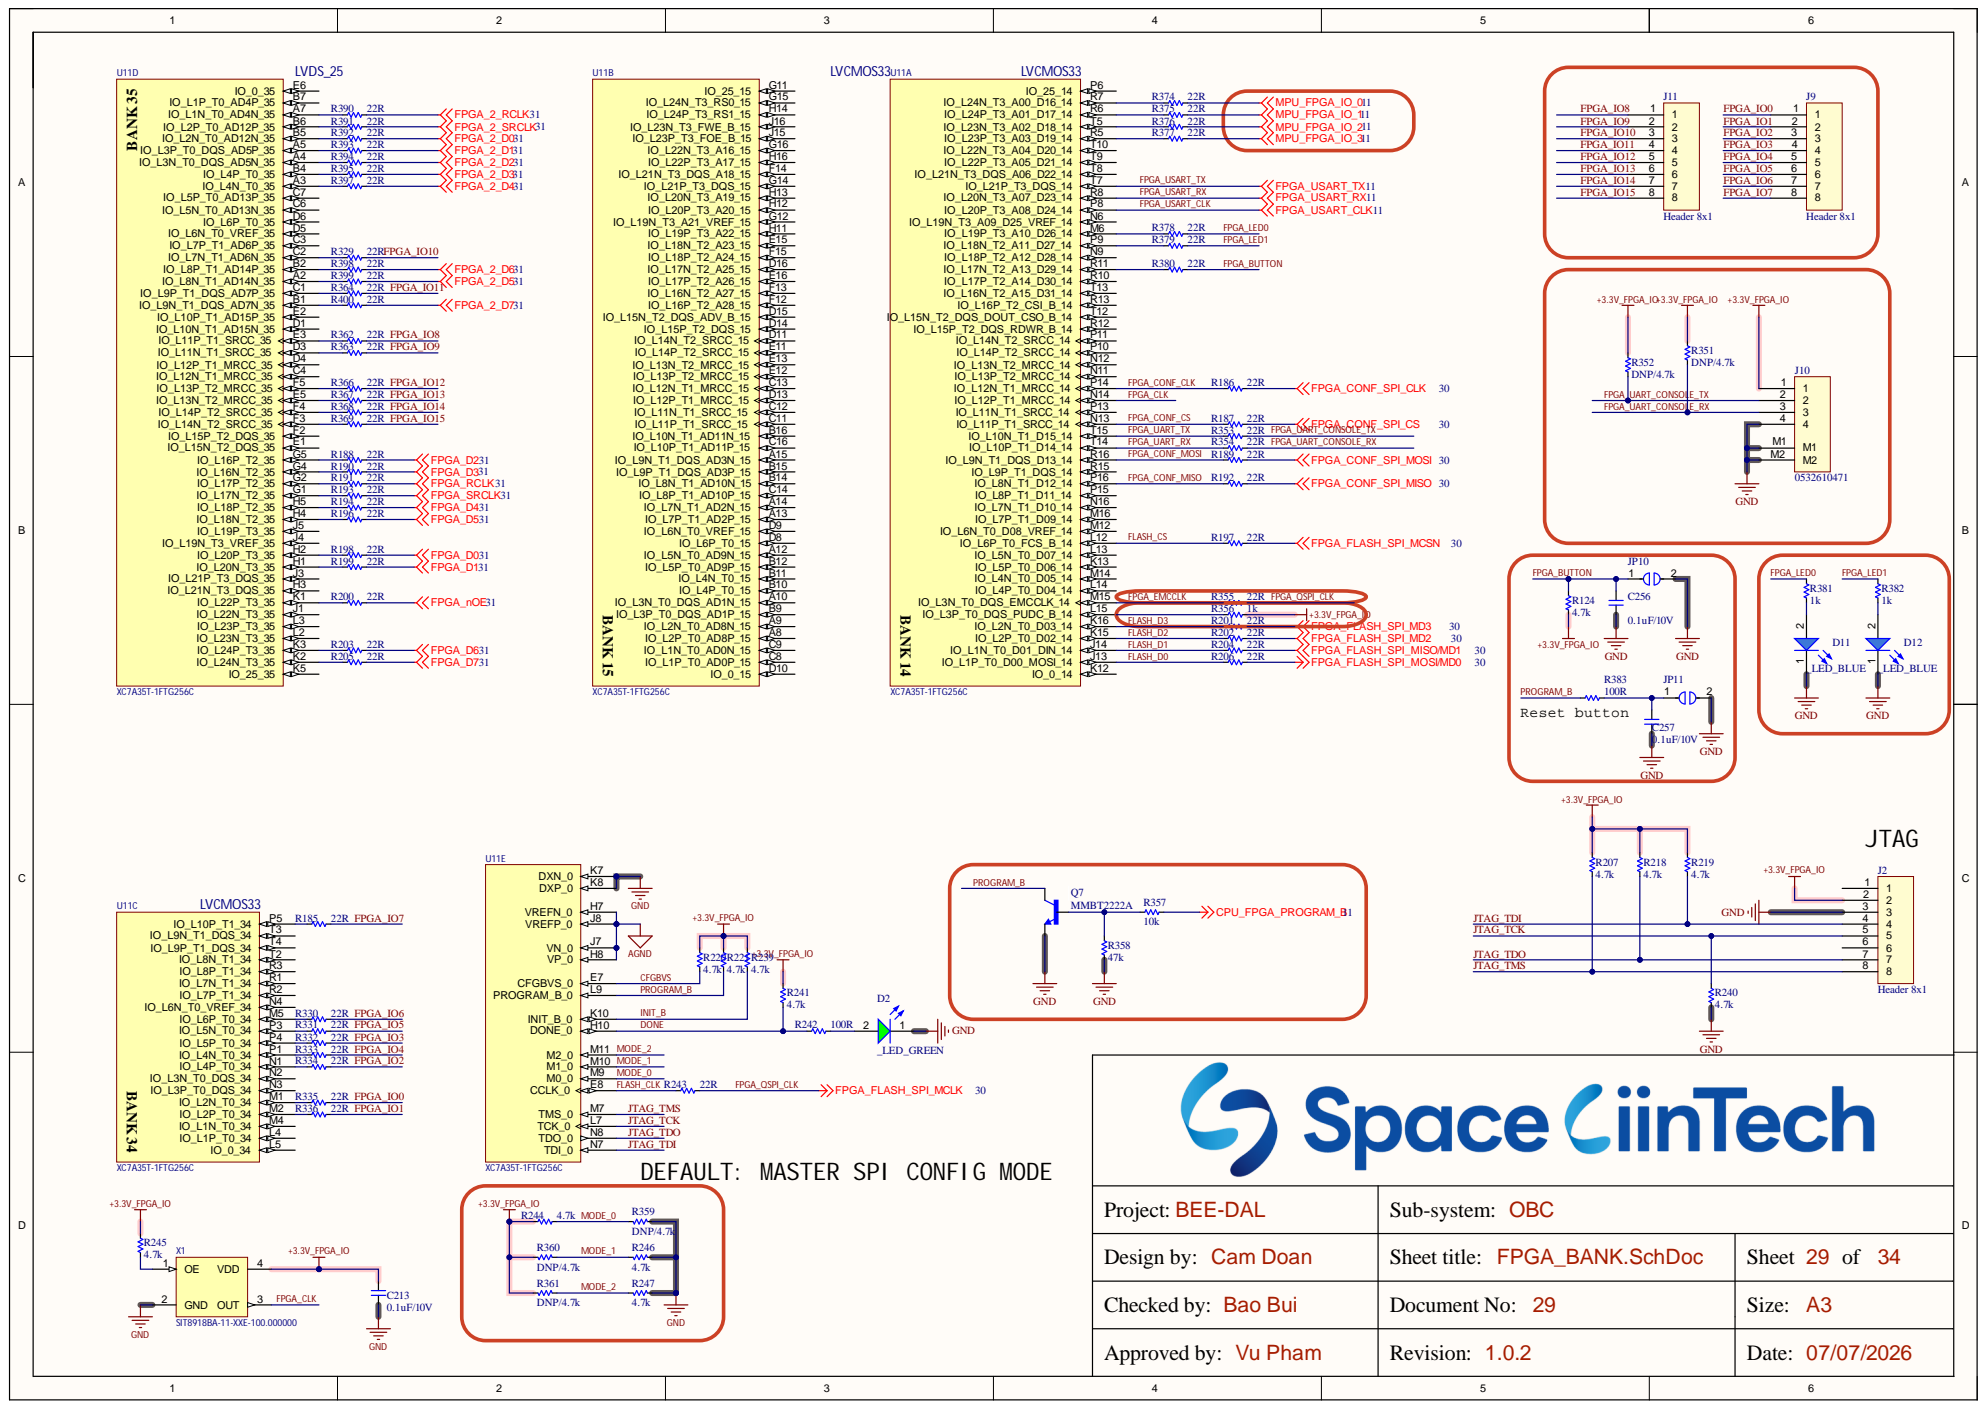
[picture p89: page 29]

BEE-DAL Project: | OBC Sub-system:

Design by: Cam Doan | Sheet title: FPGA_BANK.SchDoc | Sheet 29 of 34

Checked by: Bao Bui | Document No: 29 | Size: A3

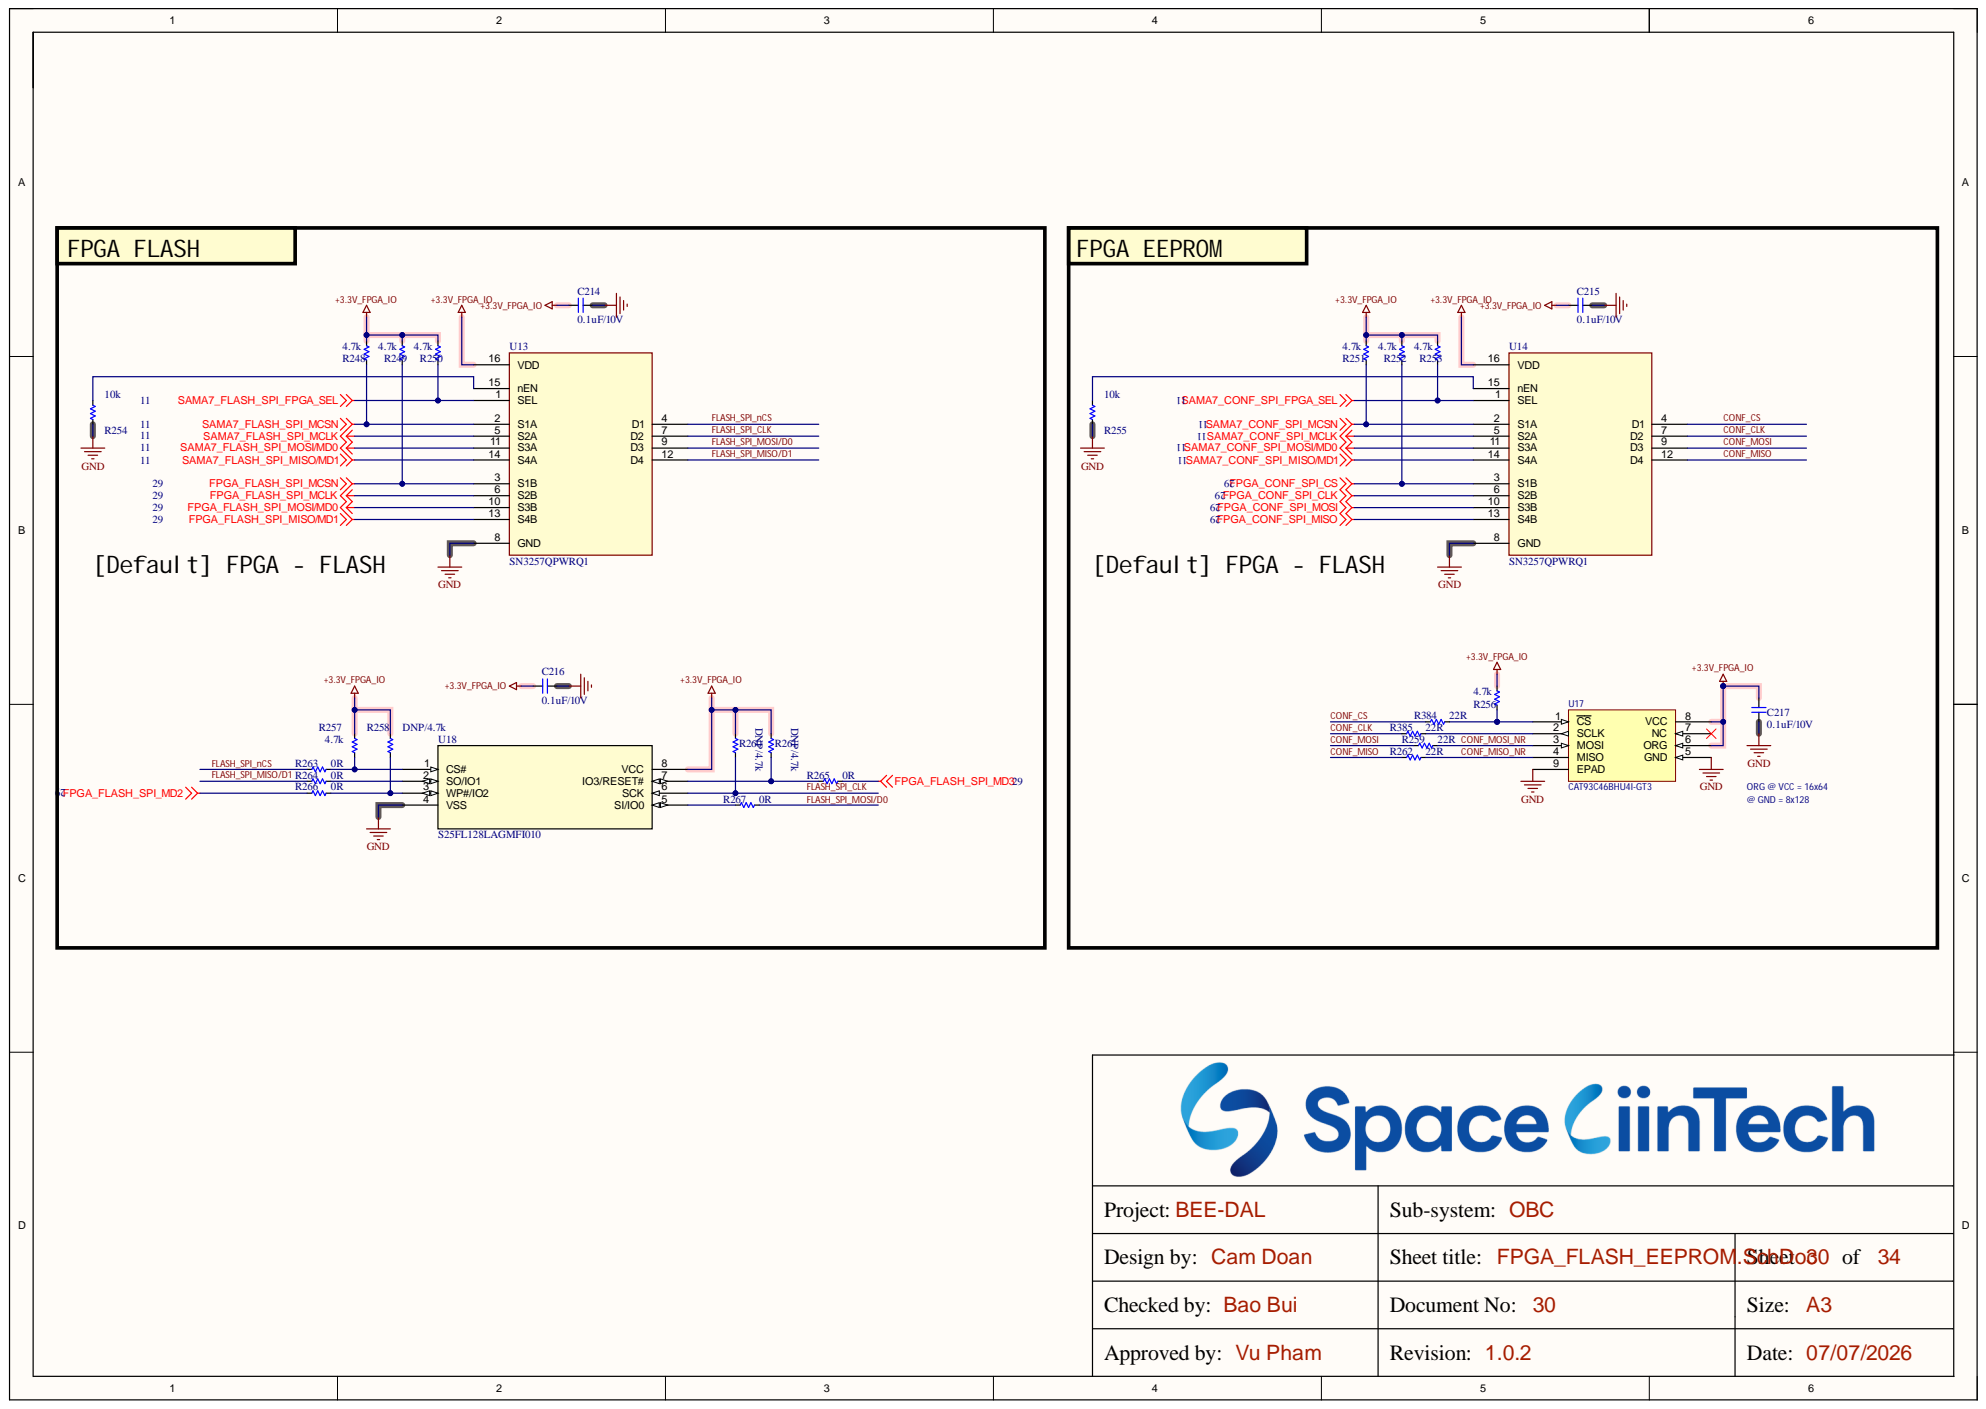
[picture p90: page 30]

BEE-DAL Project: | OBC Sub-system:

Design by: Cam Doan | Sheet title: FPGA_FLASH_EEPROM.SchDoc | Sheet 30 of 34

Checked by: Bao Bui | Document No: 30 | Size: A3

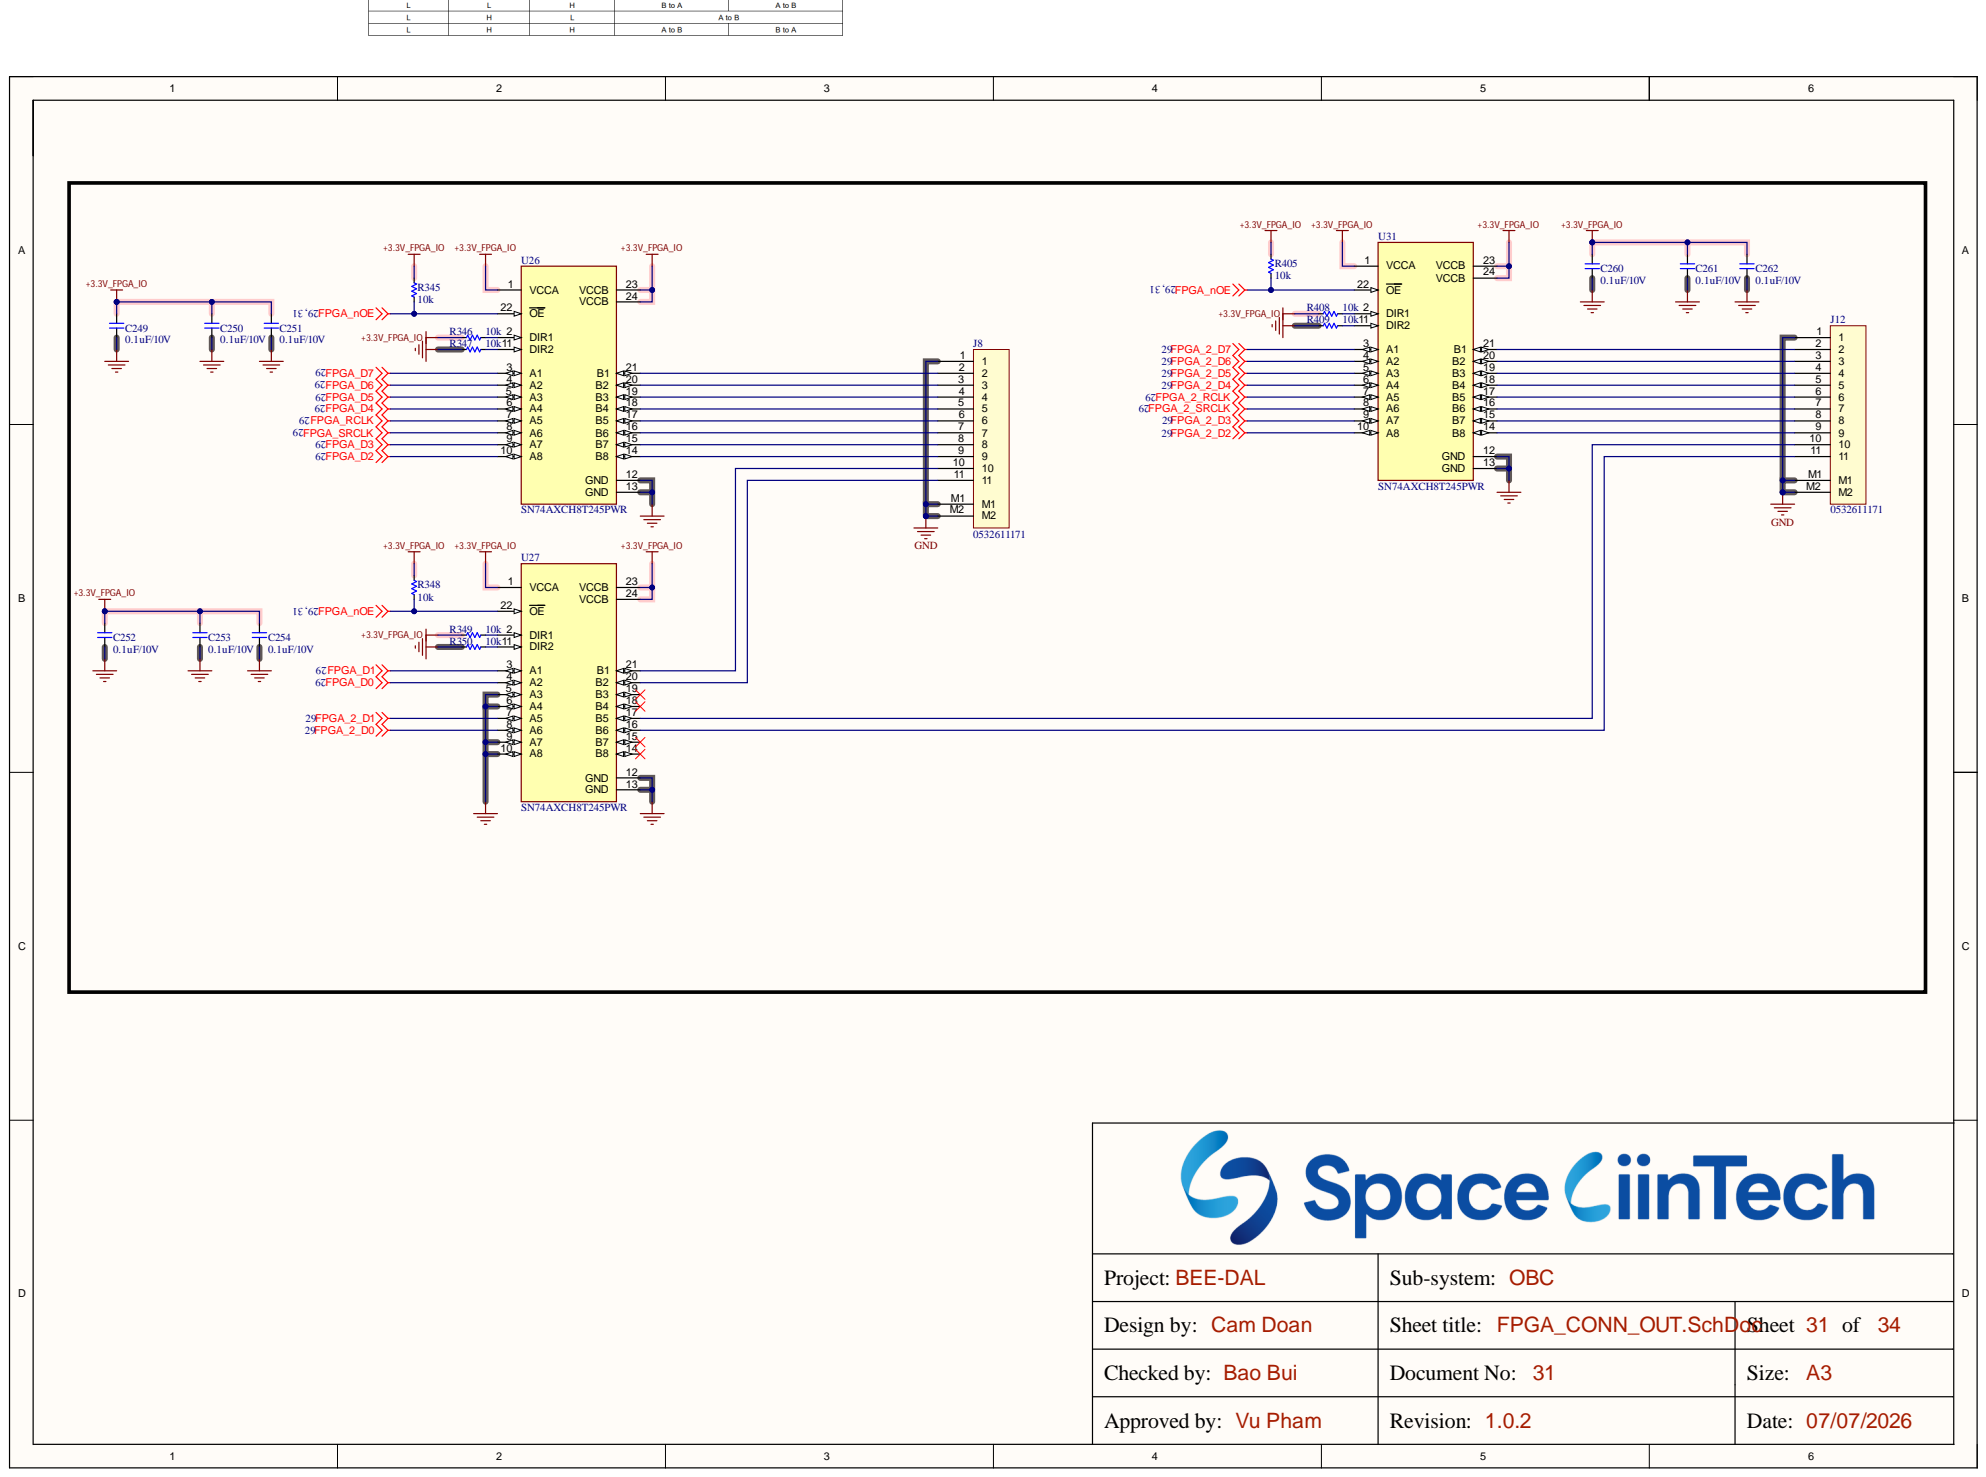
[picture p91: page 31]

GN PGA_IO | M 1 | M 2

BEE-DAL Projec t : | OBC Sub-syste m :

Design by: Cam Do a n | Sheet title: FPGA_CONN_OUT.Sc hDo | Shee c t 3 1 of 3 4

Checked by: Ba o Bu i | Document No: 3 1 | Size : A3

V u Ph a m | Revisio n : 1.0 . | Date : 7/0

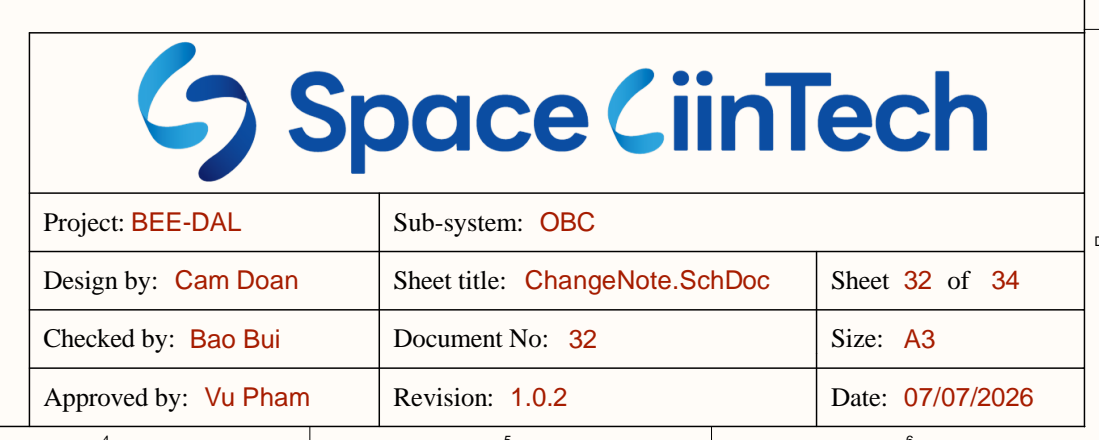
[picture p92: page 32]

BEE-DAL Project: | OBC Sub-system:

Design by: Cam Doan | Sheet title: ChangeNote.SchDoc | Sheet 32 of 34

Checked by: Bao Bui | Document No: 32 | Size: A3

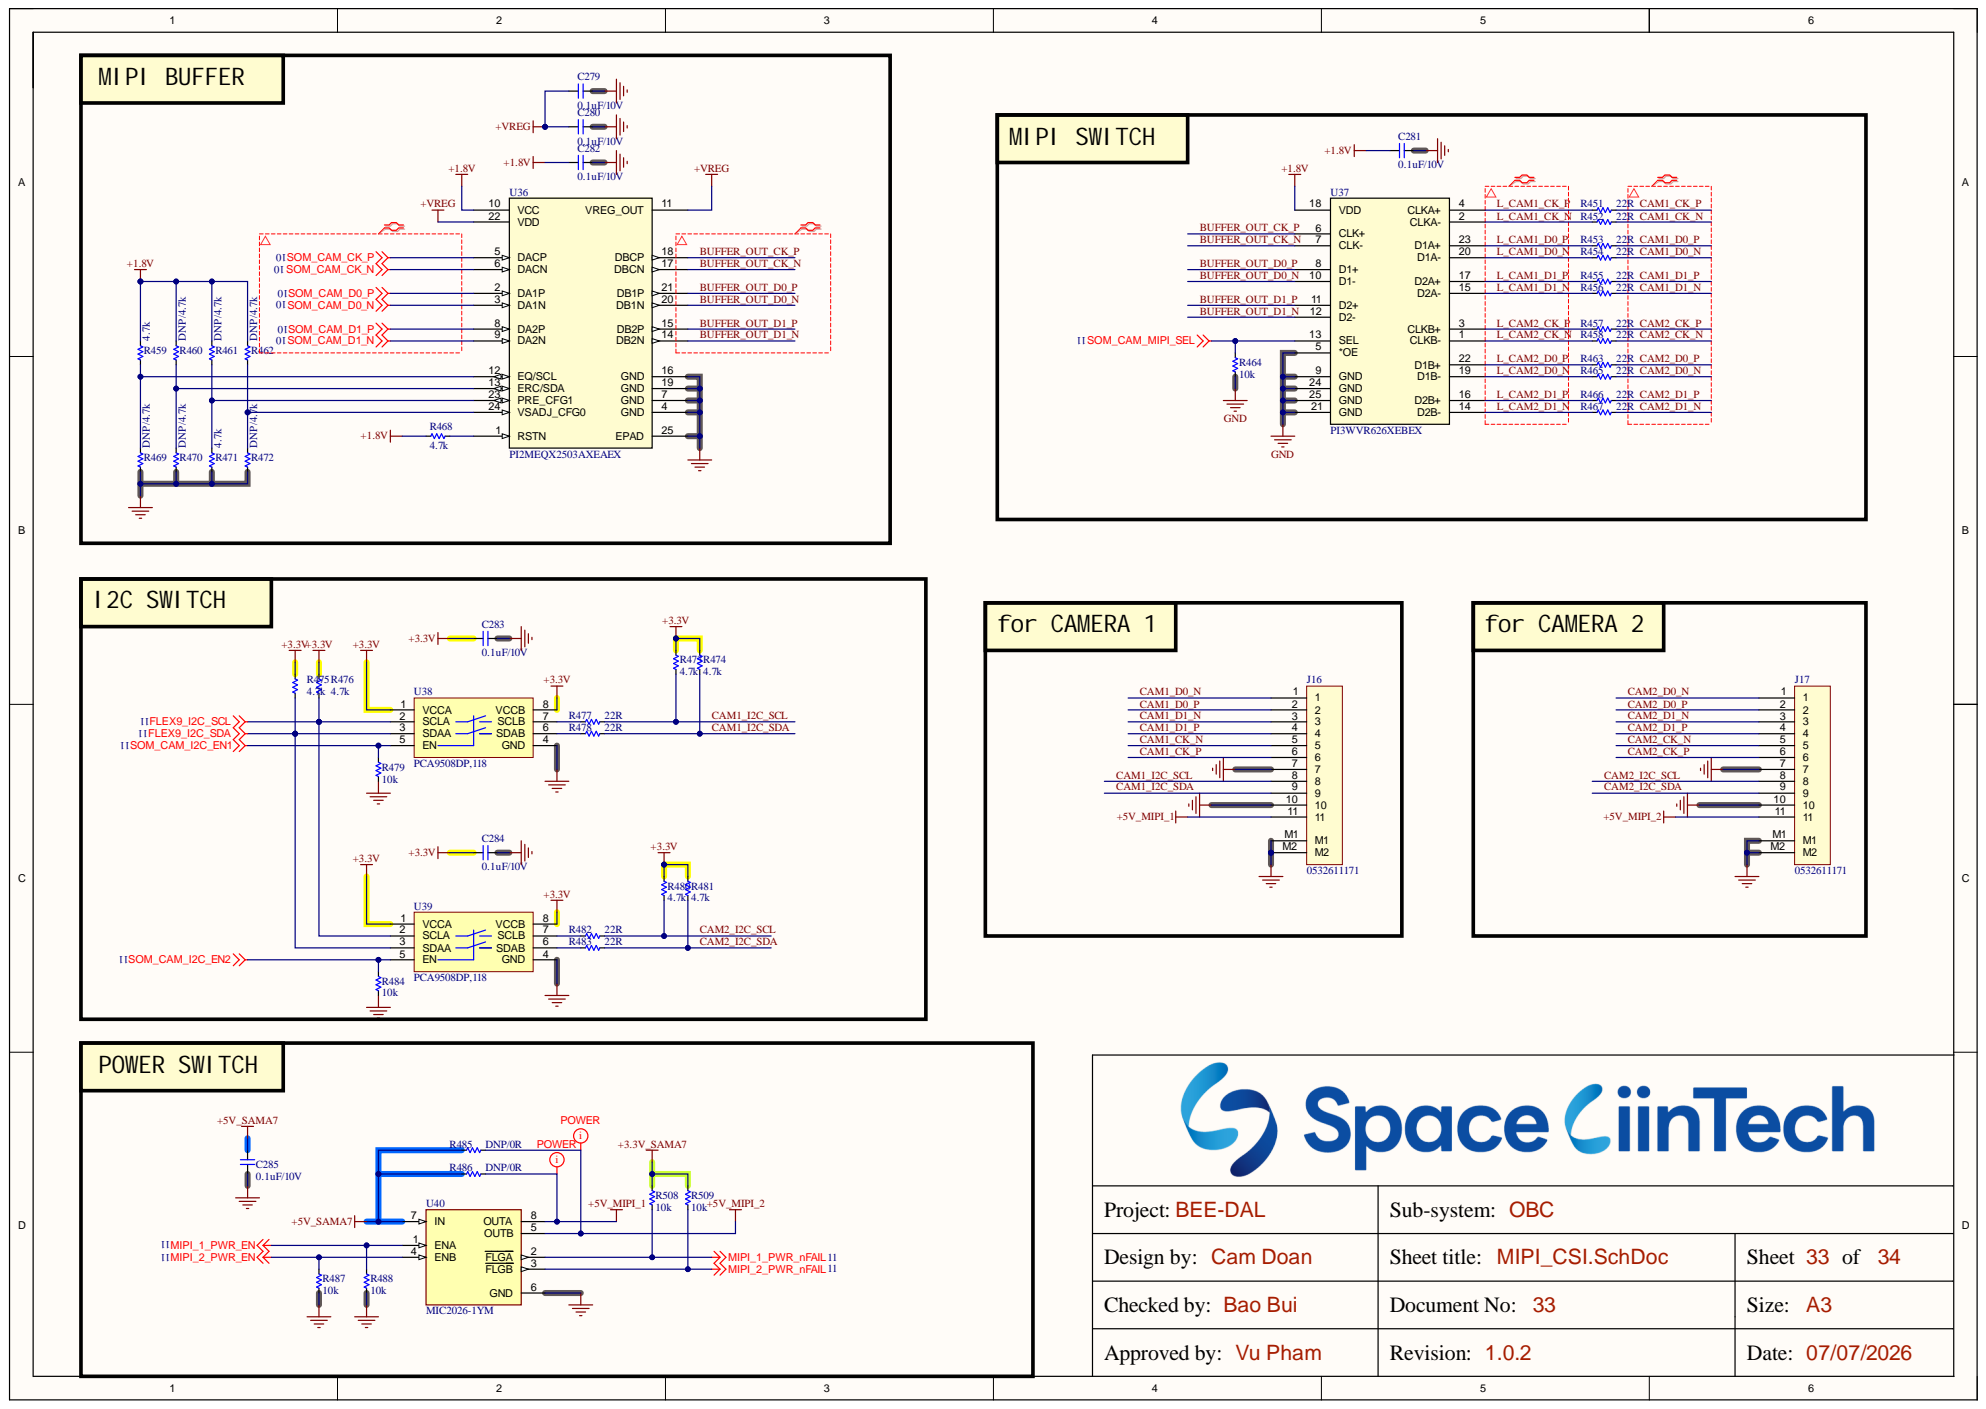
[picture p93: page 33]

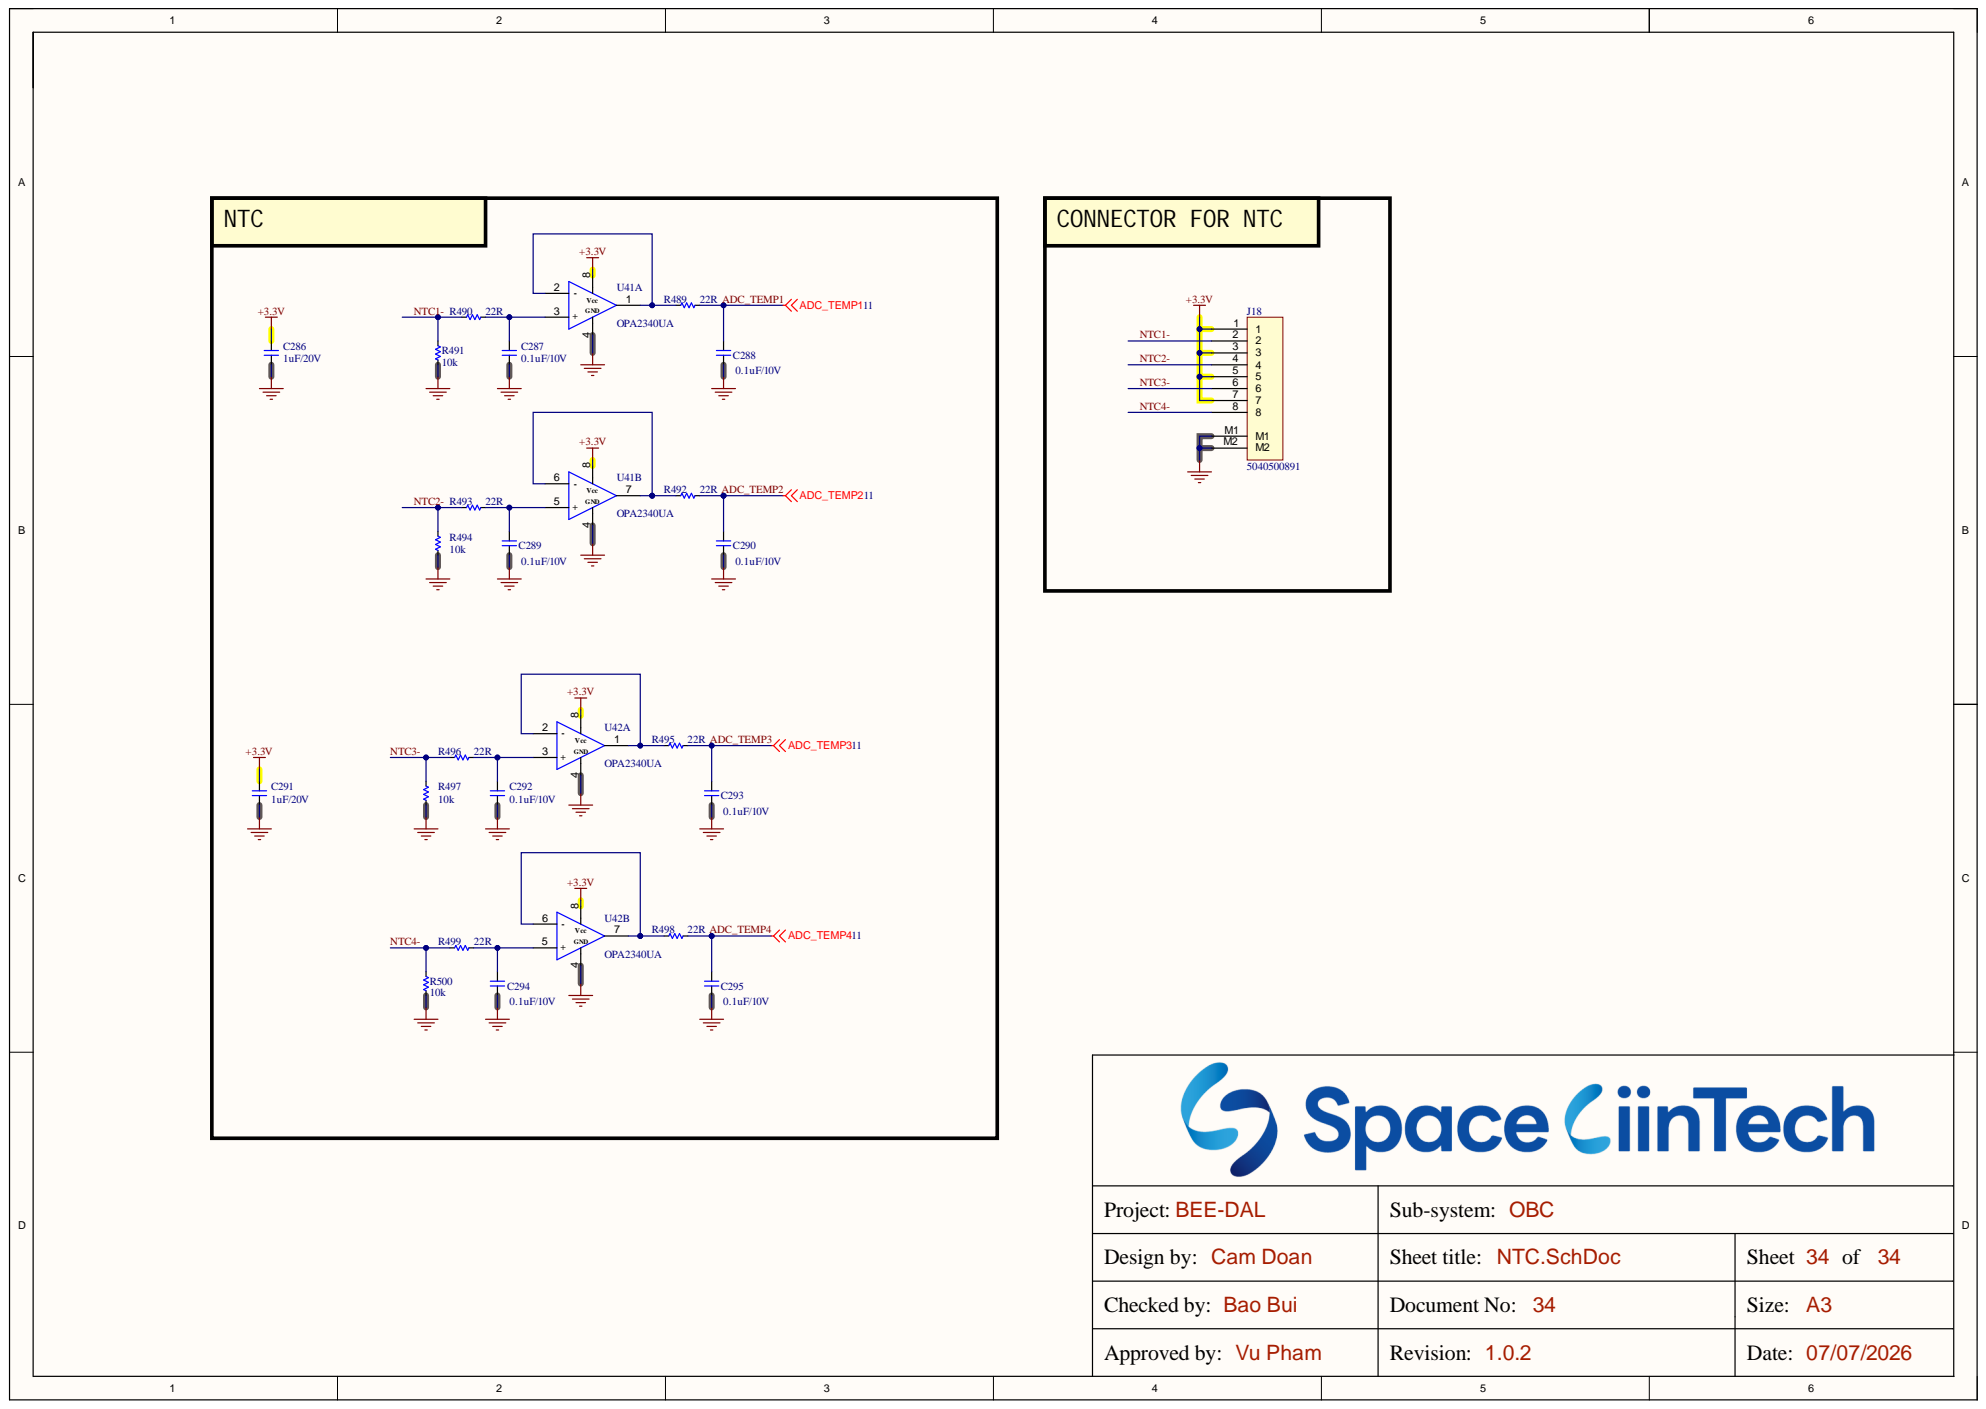
[picture p94: page 34]

BEE-DAL Project: | OBC Sub-system:

Design by: Cam Doan | Sheet title: NTC.SchDoc | Sheet 34 of 34

Checked by: Bao Bui | Document No: 34 | Size: A3
