baobuibk/SpaceLiinTech_BEE_DAL_OBC_HW/(list of files, drawings)

Other design files:
01_DESIGN/BlockDiagram.SchDoc
01_DESIGN/BUTTON_LED.SchDoc
01_DESIGN/CAN_PHY.SchDoc
01_DESIGN/ChangeNote.SchDoc
01_DESIGN/CONNECTOR_BUS.SchDoc
01_DESIGN/CONNECTOR_IN.SchDoc
01_DESIGN/CoverPage.SchDoc
01_DESIGN/DAL_OBC_V11.PrjPcb
01_DESIGN/DEBUG_CONSOLE.SchDoc
01_DESIGN/eMMC.SchDoc
01_DESIGN/FPGA_BANK.SchDoc
01_DESIGN/FPGA_CONN_OUT.SchDoc
01_DESIGN/FPGA_FLASH.SchDoc
01_DESIGN/FPGA_FLASH_EEPROM.SchDoc
01_DESIGN/FPGA_POWER.SchDoc
01_DESIGN/FPGA_POWER_2.SchDoc
01_DESIGN/IF_Outline.PcbDoc
01_DESIGN/Index.SchDoc
01_DESIGN/MIPI_CSI.SchDoc
01_DESIGN/MOUNTING_HOLE.SchDoc
01_DESIGN/NTC.SchDoc
01_DESIGN/Power.SchDoc
01_DESIGN/POWER_MANAGER.SchDoc
01_DESIGN/PowerTree.SchDoc
01_DESIGN/RS232.SchDoc
01_DESIGN/RS422.SchDoc
01_DESIGN/RS485.SchDoc
01_DESIGN/RTC.SchDoc
01_DESIGN/SAMA7G54_DDR3L.SchDoc
01_DESIGN/SAMA7G54_MPU.SchDoc
01_DESIGN/SAMA7G54_PIO.SchDoc
01_DESIGN/SAMA7G54_PMIC.SchDoc
01_DESIGN/SDCARD_MRAM.SchDoc
01_DESIGN/Sheet1.SchDoc
01_DESIGN/TEMP.SchDoc
01_DESIGN/USB_CAMERA.SchDoc
01_DESIGN/USB_CAMERA_2.SchDoc
01_DESIGN/WATCHDOG.SchDoc
09_LIB/IFBschelib_offline.SchLib
09_LIB/LABLIB.SchLib
