baobuibk/SpaceLiinTech_BEE_DAL_OBC_HW/(commit log)

2026-07-12 first push
    [AX100U.step, BEE-1012 PAY-IF V1.1.0-STACKUP.xls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]
2026-07-20 Sche v101
    [AX100U.step, BEE-1012 PAY-IF V1.1.0-STACKUP.xls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]
2026-07-27 sche v102
    [BUTTON_LED.SchDoc, BlockDiagram.SchDoc, CAN_PHY.SchDoc, CONNECTOR_BUS.SchDoc, CONNECTOR_IN.SchDoc, ChangeNote.SchDoc, CoverPage.SchDoc, DAL_OBC_V10.PrjPcb]
2026-08-14 placement 90%
    [BlockDiagram.SchDoc, DAL_OBC_V10.PrjPcb, FPGA_BANK.SchDoc, FPGA_POWER.SchDoc, MIPI_CSI.SchDoc, NTC.SchDoc, Power.SchDoc, PowerTree.SchDoc]
2026-08-14 sche v102+bom
    [BUTTON_LED.SchDoc, DAL_OBC_V10.xlsx, FPGA_BANK.SchDoc, FPGA_POWER.SchDoc, FPGA_POWER_2.SchDoc, MIPI_CSI.SchDoc, NTC.SchDoc, POWER_MANAGER.SchDoc]
2026-08-14 update step
    [DAL_OBC_V10.step]
2026-08-18 update bom
    [BEE-1012 PAY-IF V110_BOM.xlsx, CAN_PHY.SchDoc, CONNECTOR_BUS.SchDoc, DAL_OBC_V10.PrjPcb, DAL_OBC_V10.xlsx, FPGA_BANK.SchDoc, FPGA_POWER.SchDoc, MIPI_CSI.SchDoc]
2026-08-19 layout 60%
    [CONNECTOR_BUS.SchDoc, CONNECTOR_IN.SchDoc, DAL_OBC_V10.PrjPcb, FPGA_BANK.SchDoc, Power.SchDoc, RS422.SchDoc]
2026-08-20 doing power
    [SAMA7G54_PIO.SchDoc]
2026-08-20 layout 95%
    [SAMA7G54_PIO.SchDoc, SAMA7G54_PMIC.SchDoc]
2026-08-23 final_update BOM, gerber, SMT, 3D
    [CAN_PHY.SchDoc, DAL_OBC_V10.PrjPcb, DAL_OBC_V10.xls, DAL_OBC_V10.xlsx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]
2026-09-14 update 14SEP
    [CONNECTOR_IN.SchDoc, DAL_OBC_V10.PrjPcb, FPGA_BANK.SchDoc, FPGA_CONN_OUT.SchDoc, FPGA_POWER.SchDoc, FPGA_POWER_2.SchDoc, MIPI_CSI.SchDoc, Power.SchDoc]
2026-09-14 rename files
    [DAL_OBC_V11PrjPcb.PrjPcb]
2026-09-14 layout v11
    [BUTTON_LED.SchDoc, Board_STACK_DAL_OBC_V11.xls, CONNECTOR_BUS.SchDoc, DAL_OBC_V10.xls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]
2026-09-15 gerber v11 15SEP2026
    [BOARD STACK DAL_OBC_V11.xls, Board_STACK_DAL_OBC_V11.xls, DAL_OBC_V11.PrjPcb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]
2026-09-15 DAL OBC V11_23h_15SEP
    [BOARD STACK DAL_OBC_V11.xls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]
2026-09-15 DAL OBC V11
    [BOARD STACK DAL_OBC_V11.xls, DAL_OBC_V11.PrjPcb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]
2026-09-15 DAL OBC V11 23h_15SEP
    [Pick Place for DAL_OBC_V11.csv]
